janshort4all/peppa-box/plan/buchse_verdrahtung.jpg

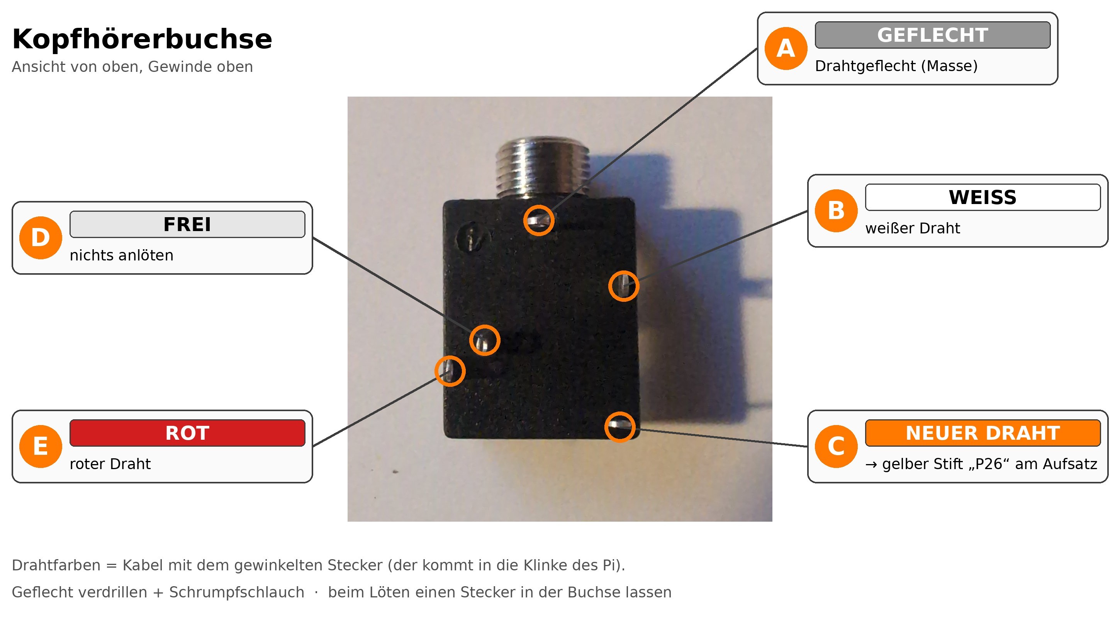
plan/buchse_verdrahtung.jpg
