janshort4all/peppa-box/v4/out/README.md

# Musikbox v4 – Druckpaket (Stand 09.11.2026)

**Noch nicht das Gehäuse drucken.** Einige Maße sind Platzhalter, bis deine Teile gemessen sind
(Liste in `PARAMETER.md`, Abschnitt „Vorläufig“). Jetzt sinnvoll: C7 (Lochbild) und die Probedruck-Coupons.

## Neu in diesem Stand: Boden = Elektronikträger

- Der Korpus ist unten offen. Nur die Lautsprecherkammer hat einen eigenen, festen Boden und bleibt dicht.
- Die Bodenplatte (`05_boden_traeger.stl`) trägt Akku-Stapel, Hebelklemmen GND A und 5 V sowie den Verstärker. Einen DAC gibt es nicht mehr: Die Kopfhörer hängen an der Klinke des Pi, ein kurzes Kabel mit gewinkeltem Stecker führt zur Buchse in der Wand.
- Du verdrahtest alles am Tisch und schiebst die Einheit dann von unten in den Korpus. Gehalten wird sie von 6 Senkschrauben.
- Ein Kragen auf der Platte zentriert sie in der Öffnung. Weil die Kammer vorne gerade ist und die Ecken hinten rund sind, passt sie nur richtig herum.
- Unter dem Deckel sitzt jetzt eine Verteiler-Brücke mit Touch-Modul und den Klemmen für 3,3 V, SCL und GND B. Die Kabel zu Touchfeldern, NFC-Leser und Taste werden dadurch kurz.
- Die Deckelauflage ist ringsum geschlossen, weil nichts mehr von oben eingesetzt werden muss.
- Die USB-C-Buchse (Soldered-Platine 333011) sitzt hinten rechts auf 60 mm Höhe (Buchsenmitte x 112). Platine mit Bauteilseite oben auf zwei Domen an der Rückwand, 2 Schrauben 3,0 mm von oben; die Wand hat eine Öffnung 13 × 7 mm für den Steckerkörper.

**Stapel einsetzen:** Überhang mit der BOOT-Taste nach links, Kante mit den gelben Stiften nach vorne (zum Lautsprecher),
Anschlusskante mit USB-C und Schalter nach hinten. Das Bild `boden_plan.png` zeigt es von oben.

## 1. Zuerst: Probedruck-Coupons

| Datei | Prüft | Was du mir zurückmeldest |
| --- | --- | --- |
| coupon_C16_gummiecke_wulst_0-4 / _0-5 / _0-6 | **Probe vor den Gummiecken (09.11.):** je eine vollständige Ecke (Form C, verschraubt) aus **TPU**, Rastwulst 0,4 / 0,5 / 0,6 mm (1 / 2 / 3 Löcher im Fuß), je ca. 4 g. Dazu eine Hülse `13_eckhuelse_PETG.stl` | Einstellungen wie die Ecken (Abschnitt „Gummiecken“). Box an die Tischkante stellen, Eckschraube vorne links heraus, Hülse von unten in den Fuß, Ecke aufdrücken: Klickt der Wulst unter die Fuge? Liegt der Schuh an der Rundung ringsum an, auch oben (kein Spalt)? Schraube 3,0 × 16 von Hand eindrehen, bis der Kopf in der Hülse anliegt: sitzt die Ecke fest, ohne dass das TPU gequetscht wird? Dasselbe an einer hinteren Ecke (V-Fuge statt Stufe). Passenden Wulst melden (`ECK_WULST`, Standard 0,5) – die passende Probe ist schon eine der vier Ecken |
| coupon_C14_gitter_ecke_beige + coupon_C14_buchstaben_P_e_p_orange | **Probe vor dem Gitter:** Ecke oben links einfarbig (Löcher, Rand, schräge Oberkante, ein Stift) mit den Sacklöchern für „P“, „e“, „p“, dazu diese drei Buchstaben, ca. 12 g | Mit den Gitter- bzw. Buchstaben-Einstellungen (Abschnitt „Gitter“). Fäden in den Löchern weg? Buchstaben-Stifte: leicht hinein, ohne zu wackeln? Buchstaben liegen plan auf? In die obere linke Ecke des Korpus drücken: Stift fest? |
| coupon_C15_karte_rastung_20grad / _30grad / _40grad | **Rastung der Karte (07.11.):** untere 60 mm der Karte mit Rille, Auszugsflanke 20° / 30° / 40° (1 / 2 / 3 Kerben oben), je ca. 8 g. Braucht das **neue** Kartenfach `04` (Nase 0,7 mm über der Karte) | Wie die Karte drucken (Rückseite unten). Einstecken: deutlicher Klick? Box kopfüber halten und schütteln: bleibt das Stück drin? Kann dein Sohn es ohne Mühe herausziehen? Den passenden Winkel Claude melden (`RAST_ALPHA`, Standard 30°), danach die Karten drucken |
| coupon_C12_deckel_oberseite_* (5 Dateien) | **Probe vor dem Deckel:** obere 2,4 mm vorne rechts (Play, Vor, Mond, Kante mit Fase), kopfüber, Symbole vertieft, ca. 15 g | Wie den Deckel einrichten: Variante A mit `_opfer_PLA`, Variante B mit `_MODIFIER_bruecke_richtung`, beide mit `_MODIFIER_haut_1wand`. Beige in den Kreisen so ruhig wie außen? Symbolböden eben bzw. Fäden parallel? |
| coupon_C7_lochbild_stapel | **Lochbild 58 × 49 mm des Akku-Stapels**, ca. 20 min | Stapel mit den vorhandenen Schrauben daraufsetzen: Fallen alle 4 Köpfe in die Mulden? Liegt die Acrylplatte innerhalb der Ecken-Marken? |
| coupon_C8_bodenecke_* (2 Teile) | Schattenfuge Boden/Korpus, Zentrierkragen, Senkschraube 3,0 × 12 in den Dom | Rutscht der Kragen leicht hinein, ohne zu wackeln? Sitzt die Schraube bündig? |
| coupon_C10_fuzzy_ecke (+ _MODIFIER) | Ecke hinten rechts mit Anschlussfeld-Kante und USB-C-Öffnung, ca. 30 min je Stück | Beide Dateien zusammen laden, Objekt Fuzzy „Deaktiviert“, Modifier „Kontur“; 3–4 Kopien mit verschiedenen Fuzzy-Werten: Welche wirkt hochwertig? Bleibt die Kante des Feldes sauber? |
| coupon_C11_korpus_oben (+ _MODIFIER) | **Probeabschnitt vor dem nächsten Korpus:** obere 36 mm mit voller Grundfläche (Riemenloch, Deckelschrauben, Kammerdecke), etwa ein Viertel der Korpus-Druckzeit | Genau wie den Korpus einrichten (Modifier, Naht aufmalen). Innen glatt? Außen keine Querlinie am Riemenloch? Naht eine gerade Linie an der aufgemalten Stelle? |
| coupon_C1_wand_rechts_drehgeber_klinke | Loch und Wandstärke für Drehgeber (M7) und Klinke | Passt das Gewinde, greift die Mutter? |
| coupon_C1_wand_hinten_usbc | Öffnung für den USB-C-Stecker, 2 Dome für die Soldered-Platine | Platine anschrauben: Buchse mittig hinter der Öffnung? Stecker rastet voll ein? |
| coupon_C2_deckelecke_* (3 Teile) | Deckelspalt 0,4 mm, Auflage, hintere Deckelschraube | Spalt gleichmäßig? Klappert es? |
| coupon_C3_taste_* (3 Teile) | Ein-Taste: Kappe, Halter, Kurzhubtaster | Klickt sie sauber, klemmt nichts? |
| coupon_C4_rahmenstifte_* | Gitter-Stift in Loch 4,0 / 4,1 / 4,2 (1–3 Kerben); der Korpus hat 4,1 | Welches Loch hält fest, lässt sich aber lösen? (C14 prüft den Stift direkt am Korpus) |
| coupon_C5_touch_platte | Touch durch 3,3 mm (links, mit Tasche) und 5,3 mm (rechts) | Später mit dem MPR121: reagieren beide? |
| coupon_C6_schraubdome | Kernloch 2,3 / 2,5 / 2,7 mm für 3-mm-Kunststoffschrauben | Welches Loch: Schraube geht fest, Dom reißt nicht? |

## 2. Druckteile (erst nach Messung und Coupons)

| Datei | Farbe | Ausrichtung / Hinweis |
| --- | --- | --- |
| 01_korpus_beige.stl | Beige | aufrecht, Boden auf der Platte; Naht hinten; Kammerdecke als 45°-Satteldach (keine Brücke) |
| 02a_deckel_kern_orange.stl | Orange | kopfüber (Oberseite auf der Platte, hinten bleibt hinten); mit 02b zusammen als ein Objekt mit zwei Teilen laden |
| 02b_deckel_haut_beige.stl | Beige | kopfüber, die 4 untersten Schichten ohne Symbole; Symbole und Ringe 0,8 mm vertieft (ertastbar) |
| 03_deckelrahmen.stl | Schwarz/Grau | Deckelseite auf der Platte |
| 04_kartenfach.stl | Schwarz/Grau | auf der Seite, Kartenschlitz senkrecht; Brim |
| 05_boden_traeger.stl | Beige | flach, Unterseite auf der Platte; trägt die ganze Elektronik; mit 05f (Fuzzy-Rand) als ein Objekt mit zwei Teilen laden |
| 06a_gitter_beige.stl | Beige | einfarbig; Vorderfläche auf der texturierten PEI, Oberkante nach hinten; Sacklöcher für die Buchstaben-Stifte |
| 06b_logo_buchstaben_orange.stl | Orange | alle 11 Logo-Teile auf einer Platte, Sichtseite auf der PEI, Stifte oben; nach dem Druck ins Gitter kleben |
| 07_drehknopf_orange.stl | Orange | Stirnfläche unten |
| 08_ein_taste_orange.stl | Orange | Kopf unten |
| 09_riemen_gegenplatte.stl | Schwarz/Grau | flach |
| 11_niederhalter_stiftleiste.stl | Schwarz/Grau | Dachoberseite mit den Schraubensenkungen auf der Platte, Säulen nach oben; Steg über der gelben Stiftleiste |
| 12_gummiecke_TPU_orange.stl | Orange, TPU 95A | eine Ecke, **4 × drucken** (alle gleich); Fußfläche auf der Platte, wie im Einbau. Einstellungen: Abschnitt „Gummiecken“ |
| 13_eckhuelse_PETG.stl | PETG (beliebig) | eine Hülse, **5 × drucken** (eine Reserve); Bund unten. Sitzt im Fuß der Gummiecke an der Eckschraube |
| 02_deckel_einfarbig.stl | eine Farbe | Prototyp, gleiche Form wie 02a + 02b; Symbole 0,8 mm vertieft |
| 10_karte_orange.stl | Orange | Rückseite unten (NFC-Tasche an der Platte), Einschubtasche oben; Cover auf Papier von oben einschieben. Rille vorne unten + Einführfase für die Rastung (seit 07.11.; ältere Karten ohne Rille neu drucken) |

Die Dateien liegen bereits in Druckausrichtung, auch der Deckel: `02a` und `02b` liegen seit 05.11. **kopfüber**
(Oberseite auf der Platte, hinten bleibt hinten). Das Tastenloch ist offen (keine Mulde, keine Opferschicht mehr).
`02a` und `02b` gemeinsam laden („als ein Objekt mit mehreren Teilen“), 02a Orange und 02b Beige zuweisen – dann macht
CANVAS genau einen Farbwechsel (Variante A: dazu PLA-Einleger `02p`, Variante B: Modifizierer `02r`), immer mit Modifizierer `02m`. Einstellungen: Abschnitt „Deckel“ unten. Die beiden `ansicht_…`-Dateien nur zum Anschauen.

Das Gitter `06a` ist einfarbig beige und liegt mit der Vorderfläche auf der Platte, die Oberkante zeigt nach hinten. Die orangen
Logo-Buchstaben `06b` sind ein eigener Druck (alle 11 Teile auf einer Platte) und werden danach aufgeklebt. Einstellungen: Abschnitt „Gitter“.

Der Boden darf auch orange sein: Dann läuft unten ein schmaler oranger Sockelstreifen um die Box.

## Einstellungen PETG auf der Centauri Carbon 2

Ausgangspunkt: Drucker „Elegoo Centauri Carbon 2 0.4 nozzle“, Filament „Elegoo PETG @ECC2“, Prozess „0.20mm Standard @Elegoo CC2 0.4 nozzle“,
Druckbetttyp „Texturierte PEI-Platte“. Im Prozess-Bereich die erweiterten Einstellungen einschalten. In Klammern: Profilwert vorher.

### Korpus (Stand 04.11.2026, Ziel höchste Außenqualität)

| Reiter → Gruppe | Einstellung | Wert |
| --- | --- | --- |
| Qualität → Schichthöhe | Schichthöhe / Höhe der ersten Schicht | 0,2 / 0,2 (bleibt) |
| Qualität → Naht | Nahtposition | Ausgerichtet (bleibt) + Naht aufmalen |
| | Schrägnaht (Beta) | Keine |
| | Naht Zwischenraum | 10 % (bleibt) |
| | Wischbewegung nach innen | an (aus) |
| Qualität → Präzision | Elefantenfußkompensation | 0,15 (0,1) |
| Qualität → Wandgenerator | Wandgenerator | Klassisch (bleibt) |
| Qualität → Wände und Oberflächen | Anordnung der Wände | Innen/Außen (bleibt) |
| Qualität → Brücken | Dicke externe Brücken | an (aus) – Lautsprecherausschnitt oben 28 mm |
| Struktur → Wände | Wandschleifen | 3 (2) |
| Struktur → Füllung | Fülldichte / Füllmuster | 15 % / Gyroid (Geradlinig) |
| Struktur → Obere/Untere Schichten | Muster der Oberfläche | **Konzentrisch** (Monotonische Linie) – die Deckelauflage innen bestand aus 3,2 m kurzer Linien: eine Schicht 158 s statt 60 s |
| Geschwindigkeit → erste Schicht | Erste Schicht | 30 mm/s (50) – Haftung |
| Geschwindigkeit → restliche Schichten | Außenwand / Innere Wand | 60 (160) / 120 (200) mm/s |
| Geschwindigkeit → Beschleunigung | Außenwand | 2000 (5000) mm/s² |
| Geschwindigkeit → Überhang-Geschwindigkeit | Verlangsamen bei Überhängen | **aus** (an) – sonst springt die Fuzzy-Außenwand zwischen 51 und 60 mm/s |
| Sonstiges → Umrandung | Randtyp / Randbreite / Lücke | Nur Innenrand / 8 mm / 0 |
| Sonstiges → Fuzzy Skin | Fuzzy Skin | Nur lackiert (Werte bleiben sichtbar; ohne Bemalung kein Fuzzy) |
| | Generierungsmodus / Rauschtyp | Verschiebung / Klassisch |
| | Punktabstand / Stärke | 0,30 / 0,20 |
| | Fuzzy Skin auf die erste Schicht anwenden | aus |
| Modifizierer `01f` → Sonstiges | Fuzzy Skin | **Kontur** |
| Filament → Kühlung | Lüftergeschwindigkeit (beide Zeilen) | 20 % / 20 % (10 / 40) – Kühlung unabhängig von der Schichtdauer |
| | Kühlung für Überhänge und Brücken erzwingen | an (bleibt) |
| | Überhänge und externe Brücken Lüftergeschwindigkeit | 50 % (90) |
| | Überhänge Kühlung Aktivierungsschwelle | **95 %** (10 % bei PETG/Rapid PETG) – sonst schaltet jeder nach außen springende Fuzzy-Punkt den Lüfter auf 50 % |
| Filament → Kühlung, Zeile „Minimale Lüftergeschwindigkeit“ | Schichtdauer | **100 s** (30) – muss über der Zeile darunter liegen; Lüfter bleibt bei 20 % |
| Filament → Kühlung, Zeile „Schwellenwert für die maximale Lüftergeschwindigkeit“ | Schichtdauer | **70 s** (12) – jede Schicht dauert mindestens 70 s, gleichmäßige Abkühlung |
| | Verlangsamen Sie den Druck für eine bessere Schichtkühlung | an (bleibt) |
| | Äußere Wände nicht verlangsamen | **an** (aus) – gebremst werden nur Innenwände und Füllung, die sichtbare Wand läuft immer mit 60 mm/s |
| Filament → Druckbett (Texturierte PEI) | Erste Schicht / Andere Schichten | 80 / 75 °C (70 / 70) – gegen Abheben |
| Drucker → Extruder | Z-Hub-Höhe | 0,4 (bleibt) |

Warum die Mindest-Schichtdauer: Sprünge in der Schichtdauer zeichnen sich bei PETG außen als Linie ab. Die harte Linie im ersten Druck
auf etwa 118 mm Druckhöhe kam von der flachen Kammerdecke (40-mm-Brücke, eine Schicht 5½ min statt 1 min). Die Decke ist jetzt ein
45°-Satteldach (innen, unsichtbar, kein Zusammenbau); die 70 s gleichen die restlichen kleinen Sprünge aus. Kostet rund 1 Stunde Druckzeit.
Bilder: `kammerdecke_satteldach.png`, `kammerdecke_schichtzeit.png`.

Naht aufmalen: ganzes Objekt markieren, Werkzeug „Naht aufmalen“, Pinselgröße 0,5 (schmaler Strich = Naht streut weniger), „Vertikal“ an; Menü Ansicht → Hinten;
senkrechten Strich auf der Rundung rechts neben den Lüftungsschlitzen (Mitte zwischen Ende des glatten Feldes und Außenkante)
von ganz unten bis ganz oben ziehen. Bild: `naht_aufmalen.png`.

Deckel, Rahmen, Kartenfach, Knopf: ohne Fuzzy Skin. Boden: Fuzzy nur am Rand, eigener Abschnitt unten. Brim für Kartenfach und die C1-Coupons. Deckel: eigener Abschnitt unten.
Rolle vorher trocknen (Elegoo: 60 °C, 8 h).

### Boden (Stand 06.11.2026, sichtbarer Rand wie der Korpus)

Der Boden steht bündig unter dem Korpus, sein Rand ist von außen sichtbar. Deshalb **alle Einstellungen wie beim Korpus** und dieselbe beige Rolle.
Am einfachsten: das Korpus-Projekt (.3mf) öffnen, „Speichern unter“ als Boden-Projekt, Korpus und `01f` löschen, dann
`05_boden_traeger.stl` und `05f_modifier_boden_FUZZY_rand.stl` zusammen hineinziehen (ein Objekt mit zwei Teilen, `05f` → Typ Modifizierer, Fuzzy Skin **Kontur**).

| Abweichung vom Korpus | Wert | Grund |
| --- | --- | --- |
| Lage | Unterseite auf der Platte, nicht drehen | Standkante (0,8-Fase) unten, V-Fuge oben |
| Sonstiges → Umrandung | **keine** | „Nur Innenrand“ würde nur die Schraublöcher zufüllen; die volle Fläche haftet ohne Rand |
| Naht | aufmalen an derselben Rundung wie am Korpus (Pinselgröße 0,5, Vertikal) | Nähte von Korpus und Boden liegen übereinander |
| Stützen | aus | Überhang nur an den Decken der M2,5-Senkungen (102 mm², kurze Brücken) |

Fuzzy liegt nur auf dem senkrechten Streifen 0,8–3,2 mm; Fase unten und Fase oben (V-Fuge) bleiben glatt, genau wie die Fase unten am Korpus.
Vorschau prüfen: Schichten 5–16 außen körnig, Schicht 1–4 und ab 17 glatt.
Nach dem Druck: Senkungen der 6 Bodenschrauben auf Grat prüfen, Kopf muss bündig liegen.

### Deckel (Stand 05.11.2026 spät, kopfüber, Symbole 0,8 mm vertieft und ertastbar, ohne Fuzzy)

Die Oberseite entsteht auf der texturierten PEI-Platte. Beige sind die 4 untersten Schichten (0,8 mm), ab Schicht 5 Orange.
Befund Druck 05.11. (Bild `deckel_ursache.png`): Fläche außerhalb der Kreise sehr gut. In den Kreisen: Der Slicer hat die
Vertiefungen in Schicht 5 überbrückt und die Brücke auf den ganzen Kreis ausgedehnt (1760 mm² Brücke für 597 mm² Vertiefung).
Hinter 0,8 mm Beige lagen dort runde Brückenfäden mit Lücken statt dichter Füllung → Orange scheint wie Fäden durch; dazu 3 Wandringe
je Loch in Schicht 2–4, Punktreihen (Überlappung 5 %), Nahtpunkte und Härchen an den Lochkanten. Die 0,8 mm Beige selbst sind nicht
zu dünn: Außerhalb der Kreise ist es dieselbe Haut, dort liegt dahinter dichte Füllung.

**Variante A (empfohlen): PLA-Opfer-Einleger.** `02p` füllt die Vertiefungen in Schicht 1–4 mit PLA. Die erste orange Schicht
wird darauf als normale dichte Füllung gedruckt – keine Brücke, keine Fäden, Böden eben und in allen Symbolen in derselben Richtung.
PETG haftet nicht an PLA: Einleger nach dem Druck mit einer Nadel heraushebeln (zusammen ca. 0,6 g). Dafür eine PLA-Rolle in
einen freien CANVAS-Platz (am besten Orange, dann fallen Reste nicht auf).

**Variante B (ohne PLA): Fäden als Stilmittel, alle in eine Richtung.** `02r` ist ein Modifizierer nur für Schicht 5 über den
Vertiefungen (+0,4 mm). Dort „Externe Brücken Füllrichtung“ fest; die Brücke bleibt auf die Symbole begrenzt, dahinter dichte Füllung.

Ausgangspunkt sind die Korpus-Einstellungen (Profil „… - Peppa“); als eigenen Prozess speichern. In Klammern: Wert beim Korpus.

| Reiter → Gruppe | Einstellung | Wert |
| --- | --- | --- |
| Objektliste | Teile laden („ein Objekt mit mehreren Teilen“) | A: `02a`, `02b`, `02p`, `02m` · B: `02a`, `02b`, `02r`, `02m` |
| | Filamente | 02a → Orange, 02b → Beige, 02p → PLA (Rechtsklick → Filament wechseln); 02m und 02r → Typ ändern → **Modifizierer**, danach Rechtsklick → Filament wechseln → **Standard** (sonst färbt der Modifizierer seinen Bereich mit Filament 1 ein – Probe 05.11.: Haut weiß, Wände über den Symbolen) |
| Modifizierer `02m` | Wandschleifen | **1** – in den Haut-Schichten nur eine Wand um jedes Loch (keine Ringe hinter der Sichtfläche) |
| Modifizierer `02r` (nur B) | Struktur → Erweiterte Einstellungen → Externe Brücken Füllrichtung | **45°** (0 = automatisch) – Fäden in allen Symbolen parallel zu den Linien der Oberfläche, längste Brücke 10,8 mm |
| Qualität → Brücken (nur B) | Dicke externe Brücken / Externe Brücken Dichte | **aus** (an) / **110 %** (100) – flache, dicht liegende Fäden |
| Geschwindigkeit → Überhanggeschwindigkeit → Überbrückung (nur B) | Extern | **30 mm/s** (50) – C12 05.11.: ein Faden im Play-Dreieck aus der Reihe |
| Filament Orange → Kühlung (nur B) | Überhänge und externe Brücken Lüftergeschwindigkeit | **100 %** (50) – Fäden erstarren sofort gerade; als eigenes Filamentprofil speichern und nur dem orangen Platz zuweisen |
| Qualität → Schichthöhe | Schichthöhe / erste Schicht | 0,2 / 0,2 (bleibt) |
| Qualität → Naht | Nahtposition | **Rückseite** (Ausgerichtet + aufgemalt) |
| Qualität → Präzision | Elefantenfußkompensation | 0,15 (bleibt) |
| Qualität → Wandgenerator | Wandgenerator | **Arachne** (Klassisch) – Ringe 1,1 mm und schmale Stege ohne Lückenfüllung |
| Qualität → Wände und Oberflächen | Nur eine Wand in der ersten Schicht / Vermeiden von Wandüberquerungen | an / an |
| Struktur → Obere/Untere Schichten | Untere Schalenschichten | **8** (3) |
| | Überlappung des oberen/unteren massiven Füllung/Wand | **25 %** (5 %) – gegen die Punktreihen |
| | Muster der unteren Fläche | Monotonisch (bleibt) |
| Struktur → Füllung | Fülldichte / Füllmuster | **25 %** / Gyroid (15 %) |
| Geschwindigkeit → erste Schicht | Füllung | **50 mm/s** (105) |
| Sonstiges → Umrandung | Randtyp | **Keine Umrandung** (Nur Innenrand) |
| Sonstiges → Fuzzy Skin | Fuzzy Skin | Deaktiviert |
| Multimaterial → Reinigungsturm | Aktivieren | an |
| Reinigungsvolumen | Multiplikator | **1,5** (1) |
| Drucker/Platte (nur A) | Betttemperaturtyp | **Nach der höchsten Temperatur** – Bett bleibt bei den PETG-Werten 80/75 °C |
| Filament PLA (nur A) | Düse | 230 °C; Einstellungen → Steuerung → Slicen: „Entfernen der Einschränkung für gemischte Temperaturen“ an (sonst lässt der Slicer PLA und PETG nicht zusammen zu) |
| Filament Beige/Orange | | wie beim Korpus (250 °C, Bett 80/75 °C, Lüfter 20 %, Schichtdauer 70/100) |

Vorher: Platte mit Spülmittel waschen, nicht mehr anfassen. Variante A: Haube oben offen lassen (PLA mag die warme Kammer nicht,
der flache Deckel verzieht sich nicht). Nach dem Druck auf der Platte abkühlen lassen, PLA-Einleger heraushebeln (bleiben sie auf
der Platte, dort abnehmen). Vorschau: Schicht 1–4 Beige + Einleger (A); Schicht 5 über den Symbolen keine „Überbrückung“ (A)
bzw. nur über den Symbolen, alle Linien parallel (B). Zuerst `coupon_C12_deckel_oberseite_*` mit derselben Variante.
`08_ein_taste_orange.stl` (Kopf unten, keine Umrandung) bekommt dieselbe Oberfläche, wenn der Kopf auf der texturierten PEI liegt –
am besten zusammen mit dem Drehknopf `07` drucken (beide Orange): Auf der Deckel-Platte müsste CANVAS in Schicht 1–4 jedes Mal
zwischen Beige und Orange wechseln. Bild: `deckel_draufsicht.png`.

### Gitter (Stand 06.11.2026: einfarbig, Buchstaben erhaben und aufgeklebt, ohne Fuzzy)

Befund C13 (06.11., eingelegtes Logo, zweifarbig): sehr viele Fäden in den Löchern, Fehler im Orange nach den Farbwechseln,
ein verbrannter dunkler Fleck hinten. Deshalb ohne Farbwechsel: **Gitter einfarbig beige**, die **Buchstaben als eigene orange
Teile**, 1,2 mm dick, aufgeklebt – sie stehen 1,0 mm vor der Korpusfront (3D-Effekt). Beide Sichtflächen entstehen auf der
texturierten PEI-Platte (matt wie der Deckel). Jeder Buchstabe hat hinten 2 Stifte Ø 2,0 (die drei Strahlen je einen Stift in
ihrer Form) und passt nur in seine Sacklöcher im Gitter. Bild: `gitter_ansicht.png` (`v4/gitter/render_gitter.py`).

`06a_gitter_beige.stl`: 115,4 × 115,7 mm, 3,6 mm dick (über dem Lautsprecher 2,4 mm, dahinter 2,5 mm Luft), 6 Stifte Ø 3,9, ca. 36 g.
`06b_logo_buchstaben_orange.stl`: 11 Teile in Logo-Reihenfolge auseinandergezogen (mindestens 4 mm Abstand), Sichtseite unten, ca. 4 g.

**Gegen die Fäden (Befund C13):** Rolle trocknen (Elegoo: 60 °C, 8 h) – wichtigste Maßnahme. Düse heiß reinigen, Silikonwischer
hinten von PETG-Resten befreien (sonst nimmt die Düse sie wieder auf und sie verbrennen). Platte mit Spülmittel waschen, nicht anfassen.
Für das Gitter einen eigenen Prozess und ein eigenes Filamentprofil anlegen und alle Werte aus der Tabelle unten eintragen.

**Gitter `06a` – alle Abweichungen von den Elegoo-Standardprofilen** (Drucker „Elegoo Centauri Carbon 2 0.4 nozzle“, Prozess
„0.20mm Standard @Elegoo CC2 0.4 nozzle“, Filament „Elegoo PETG @ECC2“, Druckbetttyp „Texturierte PEI-Platte“; erweiterte
Einstellungen einschalten). In Klammern der Profilwert, wo er bekannt ist. Prozess und Filament unter eigenem Namen speichern.

| Reiter | Einstellung | Wert |
| --- | --- | --- |
| Prozess → Qualität | Nahtposition | **Rückseite** (Ausgerichtet) |
| | Schrägnaht (Beta) | **Keine** |
| | Wischbewegung nach innen | **an** (aus) |
| Prozess → Qualität → Breite der Linie | Erste Schicht | **0,45** (0,5) – seit 07.11.: sonst sind die Stege in Schicht 1 für „Wandüberquerungen vermeiden“ zu schmal |
| Prozess → Qualität | Elefantenfußkompensation | **0** (0,1) – seit 07.11. (vorher 0,15): die Kompensation weitet die Löcher in Schicht 1, dann fährt der Slicer dort wieder quer durch |
| | Wandgenerator | **Arachne** (Klassisch) |
| | Nur eine Wand in der ersten Schicht | **aus** (Profilwert) – seit 07.11.: bei an füllt der Slicer den Streifen zwischen den Lochringen (Steg 1,4) mit vielen kurzen Bodenlinien, also noch mehr Anfänge und Rückzüge in Schicht 1 |
| | Vermeiden von Wandüberquerungen | **an** |
| | Vermeide das Überqueren der Wand – Maximale Umleitungslänge | **0** (keine Grenze) |
| Prozess → Struktur | Wandschleifen | **3** (2) |
| | Untere Schalenschichten | **8** (3) |
| | Überlappung des oberen/unteren massiven Füllung/Wand | **25 %** (5 %) |
| | Muster der Oberfläche | **Konzentrisch** (Monotonische Linie) |
| | Fülldichte / Füllmuster | **25 % / Gyroid** (15 % / Geradlinig) |
| Prozess → Geschwindigkeit | Erste Schicht / Füllung der ersten Schicht | **30 / 50 mm/s** (50 / 105) |
| | Außenwand / Innere Wand | **40 / 120 mm/s** (160 / 200) |
| | Beschleunigung Außenwand | **2000 mm/s²** (5000) |
| | Verlangsamen bei Überhängen | **aus** (an) |
| Prozess → Sonstiges | Randtyp | **Keine Umrandung** |
| | Fuzzy Skin | **Deaktiviert** |
| Filament | Düsentemperatur erste Schicht / andere Schichten | **235 / 230 °C** (250 / 250) – seit 07.11. (vorher 245 / 240): Rapid PETG ab 230 °C, weniger Nachtropfen in den Löchern |
| | Druckbett Texturierte PEI erste / andere Schichten | **80 / 75 °C** (70 / 70) |
| Filament → Kühlung | Lüftergeschwindigkeit (beide Zeilen) | **35 % / 35 %** (10 / 40) |
| | Zeile „Minimale Lüftergeschwindigkeit“ → Schichtdauer | **100 s** (30) |
| | Zeile „Schwellenwert für die maximale Lüftergeschwindigkeit“ → Schichtdauer | **70 s** (12) |
| | Äußere Wände nicht verlangsamen | **an** (aus) |
| | Keine Kühlung für die erste | **3** Schichten |
| | Überhänge und externe Brücken Lüftergeschwindigkeit | **50 %** (90) |
| | Überhänge Kühlung Aktivierungsschwelle | **95 %** (10 %) |
| Filament → Überschreiben der Einstellungen (Häkchen je Zeile setzen) | Länge (Rückzug) | **1,0 mm** |
| | Rückzugsgeschwindigkeit / Wiedereinzugsgeschwindigkeit | **40 / 30 mm/s** |
| | Zurückziehen beim Schichtwechsel | **an** |
| | Während des Rückzugs wischen / Wischabstand | **an / 2 mm** |
| | Rückzugsmenge vor der Reinigung | **70 %** |
| | Schwellenwert für die Fahrstrecke | **0,5 mm** |
| | Z-Hub-Höhe | **0** (0,4) – seit 07.11. (vorher 0,2 Normal): Anheben zieht bei PETG Fäden; die Fahrten laufen über gedrucktem Material (Wandüberquerungen vermeiden) |

Platte: `06a` allein, mittig, nicht drehen (Vorderfläche unten, Oberkante hinten), nur Filament Beige, keine Modifizierer.

**Buchstaben `06b` – alle Abweichungen von den Elegoo-Standardprofilen** (gleiche Ausgangsprofile wie beim Gitter; Filament: die
orange Rolle). Schichthöhe bleibt 0,2: Die Buchstaben sind genau 6 Schichten dick, die Stifte 5 Schichten, und weniger Schichten
heißen weniger Fahrten zwischen den 11 Teilen (Fäden an den Buchstabenkanten).

| Reiter | Einstellung | Wert |
| --- | --- | --- |
| Prozess → Qualität | Schichthöhe / erste Schicht | 0,2 / 0,2 (Profilwert, bleibt) |
| | Nahtposition | **Rückseite** (Ausgerichtet) – die im Einbau untere Kante jedes Buchstabens liegt hinten |
| | Schrägnaht (Beta) | **Keine** |
| | Wischbewegung nach innen | **an** (aus) |
| | Elefantenfußkompensation | **0,15** (0,1) – scharfe Kante an der Sichtseite |
| | Wandgenerator | **Arachne** (Klassisch) – schmale Stellen (e-Schlitz, Strahlen) sauber |
| | Nur eine Wand in der ersten Schicht | **an** – Sichtseite wie Deckel und Gitter |
| | Vermeiden von Wandüberquerungen / Maximale Umleitungslänge | **an / 0** |
| Prozess → Struktur | Wandschleifen | **3** (2) |
| | Untere Schalenschichten | **8** (3) – Buchstabe durchgehend massiv |
| | Überlappung des oberen/unteren massiven Füllung/Wand | **25 %** (5 %) |
| | Muster der unteren Fläche | Monotonisch (Profilwert, bleibt) – gleiche Linien wie auf dem Gitter |
| | Fülldichte | **100 %** (15 %) – dünne Teile ganz massiv |
| Prozess → Geschwindigkeit | Erste Schicht / Füllung der ersten Schicht | **30 / 50 mm/s** (50 / 105) |
| | Außenwand / Innere Wand | **40 / 120 mm/s** (160 / 200) |
| | Beschleunigung Außenwand | **2000 mm/s²** (5000) |
| | Verlangsamen bei Überhängen | **aus** (an) |
| Prozess → Sonstiges | Randtyp | **Keine Umrandung** – ein Rand säße an der Sichtkante |
| | Fuzzy Skin | **Deaktiviert** |
| Filament | Düsentemperatur erste / andere Schichten | **245 / 240 °C** (250 / 250) |
| | Druckbett Texturierte PEI erste / andere Schichten | **80 / 75 °C** (70 / 70) |
| Filament → Kühlung | Lüftergeschwindigkeit (beide Zeilen) | **35 % / 35 %** (10 / 40) |
| | Zeile „Minimale Lüftergeschwindigkeit“ → Schichtdauer | **100 s** (30) |
| | Zeile „Schwellenwert für die maximale Lüftergeschwindigkeit“ → Schichtdauer | **70 s** (12) |
| | Äußere Wände nicht verlangsamen | **an** (aus) |
| | Keine Kühlung für die erste | **3** Schichten |
| | Überhänge Kühlung Aktivierungsschwelle | **95 %** (10 %) |
| Filament → Überschreiben der Einstellungen (Häkchen je Zeile) | Länge (Rückzug) | **1,0 mm** |
| | Rückzugsgeschwindigkeit / Wiedereinzugsgeschwindigkeit | **40 / 30 mm/s** |
| | Zurückziehen beim Schichtwechsel | **an** |
| | Während des Rückzugs wischen / Wischabstand | **an / 2 mm** |
| | Rückzugsmenge vor der Reinigung | **70 %** |
| | Schwellenwert für die Fahrstrecke | **0,5 mm** |
| | Z-Hub-Höhe / Z-Hub Typ | **0,2 mm / Normal** (0,4) |

Platte: `06b` allein, mittig, nicht drehen (Sichtseite unten, Stifte oben, „BOX“ hinten), nur Orange, keine Modifizierer.
Vorher Düse heiß reinigen, Wischer prüfen, Platte waschen. Die orange Rolle ist neu – frisch aus der Verpackung meist trocken genug;
lag sie offen, auch trocknen.

**Einkleben:** Zuerst trocken probieren: Jeder Buchstabe muss mit leichtem Druck plan aufliegen. Geht ein Stift zu stramm, das
Loch mit einem 2,5-mm-Bohrer von Hand nachdrehen; ist er locker, füllt der Kleber das Spiel. Dann je einen kleinen Tropfen
**nur in die Sacklöcher** (nicht auf die Fläche), Buchstaben eindrücken, Gitter mit der Vorderseite nach oben aushärten lassen.
Am besten 5-Minuten-Epoxid (Zeit zum Ausrichten, kein Schleier); Sekundenkleber hält auch, kann aber um die Fuge einen weißen
Schleier bilden. Reihenfolge: wie auf der Druckplatte, oben „peppa“ und die Strahlen, unten „BOX“.
Einsetzen ins Gehäuse: 6 Stifte in die Löcher, gleichmäßig eindrücken. Herausnehmen: Schraubendreher unten in die Kerbe.

### Drehknopf (Stand 05.11.2026, volle Achse, ohne Fuzzy)

`07_drehknopf_orange.stl`: Ø 34 × 22,8 mm, ca. 24 g. Die Drehgeberachse wird **nicht** gekürzt. Stirnfläche unten auf der
texturierten PEI-Platte → dieselbe matte Oberfläche wie die Tasten im Deckel; dieselbe orange Rolle wie beim Deckel.
Innen: Führung Ø 6,3 im ungeschlitzten Teil der Achse, Klemmsitz Ø 6,1 nur im geschlitzten Teil (federt), Steg 8 mm im Schlitz.
Bild: `drehknopf_schnitt.png`. Die Ein-Taste `08` passt mit auf die Platte (gleiche Einstellungen).

| Reiter | Einstellung | Wert |
| --- | --- | --- |
| Qualität | Schichthöhe | **0,12 mm** (erste Schicht 0,2) – feinere Schichtlinien auf dem Mantel |
| Qualität | Nahtposition | Ausgerichtet + **Naht aufmalen** in eine Rille **links (−X)**, gegenüber der Markierung (liegt beim Laden rechts, +X); Schrägnaht keine |
| Festigkeit | Wandschleifen / Füllung | 3 / 25 % Gyroid |
| Sonstiges | Fuzzy Skin | **Keine** – Griff geben die 24 Rillen; Fuzzy würde ihre Kanten verwischen |
| Sonstiges | Randtyp | Keine Umrandung |
| Filament | | wie beim Deckel; die Mindest-Schichtdauer bremst bei dem kleinen Teil Innenwände und Füllung – gewollt, die Rillenkanten kühlen besser |

Aufstecken: Steg in den Achsschlitz ausrichten, Knopf gerade **bis Anschlag** aufschieben (Achsende liegt am Knopfboden) –
dann bleibt 1 mm Luft zur Wand. Die Markierung ist nur Zierde: Der Drehgeber dreht endlos, sie zeigt keine Lautstärke an.

### Gummiecken mit Füßen (Stand 09.11.2026: vier einzelne Ecken, verschraubt, Form C 20/8 mm)

Vier gleiche Ecken aus orangem TPU (`12_gummiecke_TPU_orange.stl`, 4 ×) und vier Hülsen aus PETG (`13_eckhuelse_PETG.stl`, 5 ×, eine Reserve).
Jede Ecke hängt an der Eckschraube des Bodens: Statt der Senkschraube 3,0 × 12 kommt eine **3,0 × 16** durch die Hülse. Die Schraube drückt
nur auf Hartes (Kopf → Hülse → Boden → Dom), der Boden sitzt so fest wie bisher; das TPU sitzt auf dem 45°-Kegel der Hülse, ist also
gefangen, aber nicht gepresst. Der Rastwulst hakt unter die Fuge Boden/Korpus (vorne Stufe, sonst V-Fuge) und hält die Schenkelenden an
der Box. Hülse und Schraubenkopf enden 0,5 mm über der Standfläche – die Box steht nur auf Gummi. Bilder: `gummiecken_ansicht.png`,
`gummiecken_schnitt.png`, `gummiecken_varianten.png`. Zuerst Coupon C16.

**Drucker (TPU):** nicht über den normalen CANVAS-Weg laden. Elegoo: Adapter für flexibles Filament einsetzen (Datei und Anleitung auf dem
USB-Stick bzw. bei Nexprint „Flexible Filament Printing Adapter for Centauri Carbon 2 Combo“) und vor dem Druck das CANVAS-Kabel abziehen.
Rolle vorher trocknen, TINMORRY: 70 °C, 8 h (TPU zieht Wasser; feuchtes TPU zieht Fäden und blüht auf).

Ausgangspunkt Ecken: Drucker „Elegoo Centauri Carbon 2 0.4 nozzle“, Filament „Elegoo TPU 95A @ECC2“, Prozess „0.20mm Standard @Elegoo CC2 0.4 nozzle“,
Druckbetttyp „Texturierte PEI-Platte“. In Klammern: Profilwert vorher.

| Reiter → Gruppe | Einstellung | Wert |
| --- | --- | --- |
| Platte | Datei laden, nicht drehen, **4 Kopien** (Rechtsklick → Anzahl festlegen) | Fußfläche auf der Platte, Schuh oben offen; keine Stützen nötig (Wulst und Hülsenkegel 45°, Rundungen weichen zurück) |
| Qualität → Schichthöhe | Schichthöhe / Höhe der ersten Schicht | 0,2 / 0,2 (bleibt) |
| Qualität → Naht | Nahtposition | Ausgerichtet (bleibt) + **Naht aufmalen** (Pinselgröße 0,5, Vertikal) auf der **Innenseite** des Schuhs (Fläche zur Box), Mitte der Rundung – dort unsichtbar; gilt für alle Kopien |
| | Schrägnaht | Keine (bleibt) |
| Qualität → Präzision | Elefantenfußkompensation | 0,15 (0,1) – Fase unten bleibt sauber |
| Qualität → Wandgenerator | Wandgenerator | **Arachne** (Klassisch) – die 2,4-mm-Wand wird ganz aus Wandlinien gedruckt, ohne Lücken |
| Qualität → Wände und Oberflächen | Vermeiden von Wandüberquerungen | an (aus) – weniger Fahrten über die Sichtfläche, weniger Fäden |
| Struktur → Wände | Wandschleifen | 3 (2) |
| Struktur → Obere/Untere Schichten | Obere / untere Schalenschichten | 3 (5) / 3 (bleibt) – Füße innen weich |
| Struktur → Füllung | Fülldichte / Füllmuster | 15 % (bleibt) / **Gyroid** (Geradlinig) – die Füße federn in alle Richtungen |
| Geschwindigkeit → erste Schicht | Erste Schicht / Füllung erste Schicht | 15 (50) / 15 (105) mm/s |
| Geschwindigkeit → restliche Schichten | Außenwand / Innere Wand | 25 (160) / 35 (200) mm/s; alles andere begrenzt der maximale Volumenstrom des Filamentprofils (3,2 mm³/s ≈ 38 mm/s) |
| Unterstützung | Stützen | aus (bleibt) |
| Sonstiges → Umrandung | Randtyp | **Keine Umrandung** (Automatisch) – die Füße haften flächig |
| Sonstiges → Fuzzy Skin | Fuzzy Skin | Keine (bleibt) – glattes Orange neben dem körnigen Beige |
| Filament (Elegoo TPU 95A @ECC2) | Düse / Druckbett / Lüfter / Rückzug | 225 °C / 35 °C / 100 % ab Schicht 2 / 0,4 mm (alles Profilwerte, bleiben). Liegt innerhalb der Herstellerangabe deiner Rolle (TINMORRY TPU 95A: Düse 210–240 °C, Druckbett 30–50 °C, unter 60 mm/s) |
| Drucker → Extruder | Z-Hub-Höhe | 0,4 (bleibt) |

Je Ecke ca. 4 g TPU, Druckmaß 28 × 28 × 23 mm. Nach dem Druck abkühlen lassen und die Platte biegen; TPU haftet fest.

**Hülsen (PETG, 5 ×):** Drucker „Elegoo Centauri Carbon 2 0.4 nozzle“, Filament „Elegoo Rapid PETG @ECC2“ (bzw. das Standardprofil deiner Rolle,
**nicht** das „- Peppa“-Profil: dessen Mindest-Schichtdauer 70 s würde die winzigen Teile auf Kriechtempo bremsen), Prozess „0.20mm Standard @Elegoo CC2 0.4 nozzle“,
texturierte PEI-Platte. Abweichungen: **5 Kopien** auf einer Platte (Abstand ≥ 10 mm), Wandschleifen **4** (2), Fülldichte **100 %** (15 %), Elefantenfußkompensation 0,15 (0,1),
Randtyp **Keine Umrandung** (Automatisch), Stützen aus (bleibt). Lage wie geladen: breiter Bund unten (Kopfseite), die Senkung ist dann ein 45°-Überhang.
Farbe egal (man sieht nur die Unterseite im Fuß), am besten Orange. Ca. 0,2 g je Hülse.

**Montage, je Ecke (Box steht, Ecke ragt über die Tischkante):** (1) Eckschraube 3,0 × 12 herausdrehen – die anderen 5 Schrauben halten den
Boden. (2) Hülse von unten in den Fuß der Ecke stecken, Bund nach unten. (3) Ecke von unten auf die Box drücken, bis der Wulst einrastet.
(4) Senkschraube **3,0 × 16** von Hand durch die Hülse eindrehen, bis der Kopf in der Senkung der Hülse anliegt, dann nur noch leicht
anziehen (das alte Gewinde im Dom wird weiterverwendet; 9,5 mm Einschraubtiefe statt 8). Zum Öffnen des Bodens die Schrauben wie bisher
herausdrehen; die Ecken kommen dabei mit ab.

### Fuzzy Skin nur außen (Modifier „Außenhaut“, seit 04.11.2026)

Warum: Jedes Loch durch die Wand (Klinke, Drehgeber, USB-C, Schlitze, Riemen, Deckelschrauben, Lautsprecher) schneidet den
Wandring in diesen Schichten auf. Der Slicer zählt dann die ganze Innenseite zur „Kontur“ und verfuzzt sie mit. Der neue Modifier
ist eine 1 mm dünne Haut nur an den Außenflächen – Fuzzy entsteht ausschließlich dort.

1. `01_korpus_beige.stl` und `01f_modifier_korpus_FUZZY_aussenhaut.stl` **zusammen** markieren und in den Slicer ziehen.
2. Die Frage „als ein Objekt mit mehreren Teilen laden?“ mit **Ja** beantworten – beide Teile behalten dann ihre exakte Lage.
3. In der Objektliste den Teil `01f_…` rechts anklicken → **Typ ändern → Modifizierer**.
4. Prozess (global): Fuzzy Skin = **Nur lackiert**, Stärke 0,20, Punktabstand 0,30, Klassisch. Modifizierer in der Objektliste anklicken → Reiter Sonstiges → Fuzzy Skin = **Kontur**.
5. Vorschau prüfen (Linientyp-Ansicht, Schieberegler durch die Höhe): innen überall glatt, auch auf Höhe der Löcher;
   außen körnig; Anschlussfeld, Gitter-Sitz, Loch-Flächen und die beiden Fasen (unten, oben) glatt.
6. Der alte Modifier `01m_…OHNE_fuzzy` ist entfernt und darf nicht mehr verwendet werden.

## Module befestigen

Alle Module und Klemmen liegen in Mulden mit 2,5 mm Rand. Ein Streifen doppelseitiges Montageband oder ein Tropfen Heißkleber reicht.
Unter dem Deckel hängen sie kopfüber; dort am besten Montageband nehmen.

## Kartenfach und Karte: Rastung (Stand 07.11.2026)

Die Federzunge vorne im Kartenfach hat eine Nase, die 0,7 mm über die Kartenvorderseite ragt. Die Karte hat vorne unten eine passende Rille
(0,9 mm tief) und unten eine Einführfase. Beim Einstecken schiebt die Fase die Nase weg, die Nase gleitet über die Karte und springt in die
Rille (Klick). Steht die Karte auf dem Fachboden, liegt die Nase **entspannt** in der Rille (die Zunge kriecht nicht). Zum Herausziehen muss
die Nase die Auszugsflanke der Rille hinauf; deren Winkel bestimmt die Kraft (Schätzung 30°: ca. 3–4,5 N, ein Vielfaches des Kartengewichts,
für ein Kind leicht). Schnittbild: `rastung_schnitt.png`. Vorher hatte die Nase genau 0 mm Überdeckung, die Karte hielt nur durch Reibung.

Warum das Kartenfach hochkant (88,5 mm hoch, Seitenteil auf der Platte) liegt: Der Kartenschacht wird ein senkrechter Schlitz ohne
Stützen (flach liegend wäre seine Decke 71 × 42 mm frei in der Luft), die Schienen für den RC522 drucken ohne Stütze, und die Federzunge
liegt in der Schichtebene. Sie biegt sich entlang der Bahnen statt quer zu den Schichten und bricht so nicht an einer Schichtgrenze.
Die Nase hat 45°-Enden (kein waagerechter Überhang).

**Ohne Stützen, Brücken nur kurz und beidseitig gehalten:** Schachtende 4,8 mm, Schlitz über der Zunge 20 mm, Zungen-Unterseite ca. 17 mm.
Die Zungen-Unterseite hing bis 07.11. frei (nur an der Wurzel gehalten; ElegooSlicer meldete „schwebende Überhänge“). Jetzt trägt ein
**Steg unter der Zungenspitze** (1,4 mm, im unteren Schlitz). **Nach dem Druck den Steg mit dem Cutter durchtrennen** (Klinge von außen in
den 0,8-mm-Schlitz unter der Zungenspitze), dann muss die Zunge frei federn. Die Bögen der waagerecht liegenden Schraubenbohrungen
drucken wie normale Löcher.

**Schrauben (07.11.):** Die beiden Bohrungen Ø 6,8 gehen jetzt bis ganz unten durch (vorher blieb unten ein Stück des Seitenteils
im Weg). Der Schraubendreher kommt gerade von unten an den Kopf, der Weg ist etwa 43 mm lang: Schaft mindestens ca. 5 cm frei und
dünner als 6 mm, die meisten Bithalter sind zu dick. Erst Kartenfach verschrauben, dann den RC522 einschieben.

### Kartenfach + C15 auf einer Platte (Stand 07.11.2026)

Alles aus **derselben Rolle** (die Farbe der Teststücke ist egal). Unterschiedliche Rollen auf einer Platte bedeuten einen Filamentwechsel
in jeder Schicht der unteren 4 mm (20 Wechsel mit Spülmenge). Kartenfach in die Mitte, die drei C15-Stücke daneben, mindestens 10 mm Abstand.

Ausgangspunkt: Drucker „Elegoo Centauri Carbon 2 0.4 nozzle“, Prozess „0.20mm Standard @Elegoo CC2 0.4 nozzle“, Druckbetttyp
„Texturierte PEI-Platte“, Filament: das **System**profil der eingelegten Rolle (bei Jan „Elegoo Rapid PETG …“), nicht die für den Korpus
geänderte Kopie. In Klammern: Profilwert vorher. Alles andere bleibt auf dem Profilwert.

| Reiter → Gruppe | Einstellung | Wert |
| --- | --- | --- |
| Qualität → Schichthöhe | Schichthöhe / erste Schicht | 0,2 / 0,2 (bleibt) – die Karten später ebenfalls mit 0,2 drucken, sonst ist die Rille anders gestuft als im Test |
| Qualität → Präzision | Elefantenfußkompensation | 0,15 (0,1) |
| Struktur → Wände | Wandschleifen | 3 (2) – die Zunge (1,4 mm) besteht dann ganz aus Wandbahnen |
| Struktur → Füllung | Fülldichte / Füllmuster | 15 % / Gyroid (Geradlinig) |
| Geschwindigkeit → erste Schicht | Erste Schicht | 30 mm/s (50) – Haftung des hohen, schmalen Kartenfachs |
| Stützen | Stützen aktivieren | aus (bleibt) |
| Sonstiges → Fuzzy Skin | Fuzzy Skin | Keine (bleibt) |
| Sonstiges → Bügeln | Bügeln | aus (bleibt) – die Teststücke brauchen keine glatte Vorderseite |
| Sonstiges → Umrandung (Prozess) | Randtyp / Randbreite / Lücke | Nur Außenrand / 5 mm / 0,1 mm – gilt für das Kartenfach |
| je C15-Stück (Rechtsklick in der Objektliste → Einstellungen hinzufügen → Sonstiges) | Randtyp | Keine Umrandung – ein Rand an der Kartenkante würde die Breite im Schacht verfälschen |
| Filament → Druckbett (Texturierte PEI) | Erste Schicht / Andere Schichten | 80 / 75 °C (70 / 70) – gegen Abheben |
| Filament → Kühlung | alle Werte | Profilwerte. **Nicht** die Korpus-Kühlung (Schichtdauer 100 s / 70 s): Dann dauert jede der 442 Schichten mindestens 70 s, der Slicer bremst die Wände auf unter 1 mm/s – 07.11.: 5 h 57 min, davon 4 h Wände. Die 70 s waren nur gegen Querlinien auf der sichtbaren Fuzzy-Außenhaut des Korpus |

Rolle vorher trocknen (Elegoo: 60 °C, 8 h), feuchtes PETG macht Fäden in den Schlitzen um die Zunge.
Nach dem Druck: Steg unter der Zungenspitze durchtrennen; die Zunge muss frei federn (Schlitze rundum offen, Fäden mit dem Cutter heraus),
die beiden Bohrungen sind von unten durchgängig. Danach C15 testen (Tabelle oben). Für die endgültigen Karten Bügeln nur „Oberste Oberfläche“, damit die Rille wie im Test bleibt.

### Niederhalter für die Steckkabel (`11_niederhalter_stiftleiste.stl`, Stand 07.11.2026)

Steg über der gelben 40er-Stiftleiste des Klemmen-Aufsatzes: Dach 65 × 20 × 4 mm, zwei Säulen Ø 6 auf den beiden freien Löchern
(Abstand 58), M2,5 von oben (Jans vorhandene Pi-Schraube, ca. 19,2 inkl. Kopf), Kopf tief versenkt: Senkungsboden 12,9 über der Platine,
Säule dort als Kragen Ø 7,2. Das Dach liegt 2 mm über den Steckern (12 mm) und drückt über die zur Seite geknickten Kabel
auf die Stecker. Bild: `niederhalter.png`. **Vor dem Druck:** Höhe des geknickten Kabels messen (`NH_KABEL`, vorläufig 2,0).

Inneres Teil, nicht sichtbar. Ausgangspunkt: Drucker „Elegoo Centauri Carbon 2 0.4 nozzle“, Filament „Elegoo PETG @ECC2“,
Prozess „0.20mm Standard @Elegoo CC2 0.4 nozzle“, Druckbetttyp „Texturierte PEI-Platte“. In Klammern: Profilwert vorher.
Alles andere bleibt auf dem Profilwert.

| Reiter → Gruppe | Einstellung | Wert |
| --- | --- | --- |
| Lage | – | wie in der STL: Dachoberseite mit den beiden Senkungen auf der Platte, Säulen nach oben. Nicht drehen, keine Stützen nötig |
| Qualität → Präzision | Elefantenfußkompensation | 0,15 (0,1) – sonst werden die Senkungen unten enger |
| Struktur → Wände | Wandschleifen | 4 (2) – die Säulen (Ø 6, Loch 2,9) werden ganz aus Wandbahnen gedruckt, das Dach wird steifer |
| Struktur → Füllung | Fülldichte / Füllmuster | 40 % / Gyroid (15 % / Geradlinig) – steifes Dach |
| Stützen | Stützen aktivieren | aus (bleibt) |
| Sonstiges → Fuzzy Skin | Fuzzy Skin | Keine (bleibt) |
| Sonstiges → Umrandung | Randtyp | Keine Umrandung – 1300 mm² Auflage haften ohne Rand |
| Filament → Druckbett (Texturierte PEI) | Erste Schicht / Andere Schichten | 80 / 75 °C (70 / 70) – gegen Abheben, wie bei allen Teilen |
| Filament → Kühlung | alle Werte | Profilwerte |

Einzige Überhänge: die Böden der beiden Senkungen (Ring Ø 5,6 um das Loch, 5,1 mm über der Platte) – kurze Brücken, unkritisch, der
Schraubenkopf liegt darauf. Rolle vorher trocknen (Elegoo: 60 °C, 8 h). Nach dem Druck: M2,5 muss durch die Säulen gehen; klemmt sie,
mit einem 2,9-mm-Bohrer von Hand nachdrehen.

**Montage:** Alle Steckkabel ganz auf die Stifte drücken. Kabel direkt über dem Stecker zur Seite knicken: äußere Reihe (Platinenkante)
nach vorne, innere Reihe nach hinten. Steg aufsetzen, Säulen auf die beiden freien Löcher, vorhandene Pi-Schraube (Flachkopf, ca. 19,2 inkl. Kopf) von oben
(Schraubendreher durch die 5,6-mm-Senkung), unter der Platine Mutter aus demselben Set oder, falls dort ein Abstandsbolzen zum Pi sitzt,
in den Bolzen schrauben. Die Schraube reicht ca. 2,7–3,2 mm unter die Platine. Nur so fest anziehen, bis der Steg aufliegt.

## Schrauben (Stand 06.11.2026)

Alle Dome, Kernlöcher und Senkungen sind auf die vorhandenen Kunststoffschrauben **3,0 × 12** ausgelegt (`SCREW_L`).

| Teil | Menge | Wofür |
| --- | --- | --- |
| Kunststoffschraube 3,0 × 12, Senkkopf | 14 (mit Gummiecken 10) | Boden in den Korpus (6, mit Gummiecken nur die 2 an der Kammerwand), Deckel hinten durch die Rückwand (2), Deckelrahmen an den Deckel (6, Kopf versenkt im Dom) |
| Kunststoffschraube 3,0 × 16, Senkkopf | 4 | Gummiecken: durch die PETG-Hülse in die 4 Eckdome des Bodens (statt 3,0 × 12) – **noch kaufen** |
| Kunststoffschraube 3,0 × 12, Flachkopf | 8 | Lautsprecher (4, mit M3-Scheiben), Kartenfach (2), USB-C-Buchse (2) |
| Schraube M2,5, ca. 5 mm länger als die jetzigen unter der Acrylplatte | 4 | Stapel von unten durch den Boden (Länge folgt nach deiner Messung) |
| vorhandene Pi-Schraube M2,5, Flachkopf, ca. 19,2 inkl. Kopf (Kopf Ø ≤ 5,2) + Mutter M2,5 aus demselben Set | je 2 | Niederhalter auf der gelben Stiftleiste (Länge unabhängig vom Kabelknick) |

## Was für die Montage noch fehlt (nicht bestellt)

| Teil | Menge | Wofür |
| --- | --- | --- |
| Doppelseitiges Montageband | 1 Rolle | Module in den Mulden |
| Buchschraube (Schaft Ø 7,5) + Lederriemen | 1 | Riemen links |
| Polyesterwatte, eine Handvoll | – | Lautsprecherkammer |

## Dateien

- `model.py` – das parametrische Modell, alle Maße oben als benannte Werte
- `check.py` – Kollisionen, Einbau (Deckel von oben, Boden von unten mit Hubweg), Druckbarkeit
- `PARAMETER.md`, `PRUEFBERICHT.md` – Werte mit Status und Prüfergebnis
- `boden_plan.png` – Boden von oben und Höhen von der Seite
- `gitter_ansicht.png` – Frontgitter: Ansichten, Schnitt durch Buchstabe, Stift und Luftraum, Lage auf den Druckplatten
- `gummiecken_ansicht.png`, `gummiecken_schnitt.png`, `gummiecken_varianten.png` – Gummiecken mit Füßen, verschraubt (`ecken_bild.py`)
