janshort4all/peppa-box/v4/out/PRUEFBERICHT.md

# Prüfbericht Musikbox v4 (Stand 09.11.2026)

Automatisch gerechnet mit den Werten aus `model.py`. Bauteile, deren Maße noch fehlen, stecken als Platzhalter (Hüllquader) im Modell.

## Kollisionen

Keine Überschneidung zwischen Druckteilen und Bauteilen.

## Einbau

**Deckel von oben:** Deckelrahmen mit Verteiler-Brücke, Kartenfach, Taster und die Module unter der Brücke passen an der ringsum geschlossenen Deckelauflage vorbei.

**Boden von unten:** Der Boden mit Stapel, Klemmen, Verstärker und allen Kabel-Freiräumen lässt sich senkrecht hochschieben, ohne an Drehgeber, Klinke, USB-Buchse, Lautsprecher, Domen oder Deckelteilen hängen zu bleiben (Hubweg geprüft, nicht nur die Endlage).

## Wichtige Abstände

| Prüfung | Wert (mm) |
| --- | --- |
| Oberkante Klemmen (z) | 77,5 |
| Unterkante Kartenfach (z) | 81,8 |
| Unterkante Klemmen im Deckel (z) | 117,4 |
| Abstand Pi + Klemmen-Aufsatz ↔ Kartenfach | 4,8 |
| Abstand Pi + Klemmen-Aufsatz ↔ RC522 | 7,8 |
| Abstand Klinkenstecker am Pi (Zone) ↔ Korpus | 5,5 |
| Abstand Pi + Klemmen-Aufsatz ↔ WAGO GND B | 39,9 |
| Abstand Pi + Klemmen-Aufsatz ↔ Touch-Modul MPR121 | 40,0 |
| Abstand Akku-Board mit Zellen ↔ Korpus | 4,1 |
| Abstand Kabel Klemmreihe links (Zone) ↔ Korpus | 4,5 |
| Abstand Kabel Klemmreihe rechts (Zone) ↔ Drehgeber | 12,0 |
| Abstand Kabel Klemmreihe hinten (Zone) ↔ USB-C-Platine mit Buchse und Kabeln | 7,0 |
| Abstand USB-C-Stecker am Akku-Board (Zone) ↔ Korpus | 4,5 |
| Abstand WAGO GND A ↔ Korpus | 2,4 |
| Abstand Verstärker ↔ Korpus | 5,0 |
| Abstand Boden ↔ Korpus | 0,0 |
| Abstand Lautsprecher ↔ Korpus | 0,0 |
| Abstand Lautsprecher ↔ gitter_beige | 1,3 |
| Abstand Kurzhubtaster ↔ Kartenfach | 4,2 |
| Abstand niederhalter ↔ Kartenfach | 35,2 |
| Abstand niederhalter ↔ Deckelrahmen | 40,0 |
| Abstand niederhalter ↔ Korpus | 3,0 |
| Abstand niederhalter ↔ RC522-Stecker (Zone) | 40,0 |
| Abstand niederhalter ↔ Touch-Modul MPR121 | 40,0 |
| Abstand niederhalter ↔ WAGO GND B | 38,0 |
| Abstand RC522 ↔ Deckelrahmen | 2,0 |
| Abstand RC522-Stecker (Zone) ↔ Korpus | 5,0 |
| Abstand RC522-Stecker (Zone) ↔ Deckelrahmen | 0,8 |
| Abstand RC522-Stecker (Zone) ↔ Kartenfach | 1,7 |
| Abstand Touch-Modul MPR121 ↔ Kartenfach | 13,5 |
| Abstand RC522-Stecker (Zone) ↔ Schraubblock Deckelrahmen hinten | 3,7 |

0,0 heißt: Teile liegen bewusst aneinander an (Lautsprecher auf der Mulde, Korpus auf dem Boden).
„Zone“ = Freiraum, den Kabel oder Stecker brauchen, kein Bauteil.

## Druckbarkeit (Centauri Carbon 2, Bauraum 256 × 256 × 256 mm)

| Datei | Größe in Druckausrichtung (mm) | Bewusste Brücken |
| --- | --- | --- |
| 01_korpus_beige.stl | 140 × 140 × 136 | Lautsprecherausschnitt oben 28 mm, Kernlöcher der Dome, Schlitze 2 mm (Kammerdecke seit 04.11. als 45°-Satteldach, keine Brücke mehr) |
| 02a_deckel_kern_orange.stl | 133 × 133 × 5 | Böden der Symbol-Vertiefungen (bis 10,8 mm; Variante A: auf PLA-Einleger statt Brücke) |
| 02b_deckel_haut_beige.stl | 133 × 133 × 1 | – |
| 03_deckelrahmen.stl | 128 × 128 × 17 | Boden Tasterhalter 12 mm |
| 04_kartenfach.stl | 14 × 52 × 88 | Seitenwand über dem Kartenschlitz 5 mm |
| 05_boden_traeger.stl | 140 × 140 × 8 | Decke der Senkbohrungen M2,5 (Ring 1,8 mm) |
| 06a_gitter_beige.stl | 115 × 116 × 6 | Böden der Sacklöcher für die Buchstaben-Stifte (Ø 2,4, unsichtbar) |
| 06b_logo_buchstaben_orange.stl | 100 × 57 × 2 | keine |
| 07_drehknopf_orange.stl | 34 × 34 × 23 | – |
| 08_ein_taste_orange.stl | 17 × 17 × 13 | – |
| 09_riemen_gegenplatte.stl | 18 × 24 × 4 | – |
| 11_niederhalter_stiftleiste.stl | 65 × 20 × 18 | – |
| 12_gummiecke_TPU_orange.stl | 145 × 145 × 23 | – |
| 13_eckhuelse_PETG.stl | 133 × 133 × 2 | – |

Alle anderen Flächen sind steiler als 45° oder liegen auf der Platte. Kein Teil braucht Stützmaterial.

## Gitter und Logo-Buchstaben (Schichtanalyse in Druckausrichtung)

- Gitter einfarbig: 297 Löcher Ø 3,3 im Wabenraster 4,7 (Steg 1,4 mm: breit genug, dass der Slicer jedes Loch umfährt).
- Offen direkt vor der Lautsprecheröffnung: 9 %; über den Luftraum (2,5 mm) erreichbar: 29 % der Öffnung.
- Gitter Schicht 1 (Sichtfläche): 10548 mm², schmaler als 1 Linie (0,4 mm): 0,00 mm².
- Gitter hinten (Luftraum): Rand läuft durch die Lochmitten, schmaler als 0,4 mm höchstens 1,01 mm² je Schicht (Ecken am Lochrand).
- Buchstaben: 11 Teile auf einer Platte (119 × 66 mm), mindestens 4,2 mm Abstand; Schicht 1 (Sichtseite) 2529 mm², schmaler als 0,4 mm: 0,63 mm² (Spitze im e-Schlitz, Ecken).
- 19 Stifte in Sacklöchern (Spiel 0,2 je Seite, Loch 0,3 tiefer), Überschneidung mit dem Gitter 0,000 mm³.
- STL geschlossen, keine doppelten Ecken (Löcher als gedrehte 32-Ecke, Versätze vereinfacht).
