janshort4all/peppa-box/STECKBRIEF.md

# Peppa Box – Projekt-Steckbrief (Stand 09.11.2026)

Eigenbau einer Toniebox-Alternative für Kinder. Eine NFC-Karte mit aufgeklebtem Cover-Bild startet eine Spotify-Playlist.
Gehäuse: gedruckter Würfel 140 × 140 × 140 mm in Beige mit orangen Akzenten, Elegoo Centauri Carbon 2 mit CANVAS (4 Rollen), PETG.

Diese Datei fasst alle Entscheidungen bis hierher zusammen. Sie gehört in das Projektwissen und ist die Grundlage für jeden neuen Chat.

## Regeln für die Zusammenarbeit

- Nur in der EU bestellen, am liebsten bei Shops in Deutschland oder den Niederlanden.
- Von sich aus auf Sparmöglichkeiten hinweisen.
- Möglichst wenig löten (erste Lötarbeiten).
- Keine Gewindeeinsätze. Schrauben gehen direkt in den Kunststoff, Dome 9 mm, damit Einsätze später möglich bleiben.
- Listen mit anklickbaren Links.
- **Anschlüsse am Klemmen-Aufsatz immer mit dessen Aufdruck benennen** (gelbe Stifte: P26, P18, GND, 3V3 …; Federklemmen: Buchstabe A–P bzw. Zahl 1–8 und Aufdruck), nie mit Pi-Pinnummern wie „Pin 37“. Ausdrücklicher Wunsch Jan (05.11.).
- Vor jedem Kauf prüfen, ob das Teil exakt passt.
- Kein Maß einfach annehmen. Ist etwas nicht belegt, das sagen oder nachfragen.
- Vor jeder Anschlussanleitung die Produktseite bzw. das Datenblatt des Bauteils prüfen (Jumper, Lötbrücken, Spannung, Pinbelegung) und die Quelle nennen. Nicht geprüfte Aussagen ausdrücklich als Vermutung kennzeichnen.
- Bei der Fehlersuche zuerst den Aufbau der beteiligten Platinen prüfen, dann Kabel und Lötstellen.
- Slicer ist ElegooSlicer (nicht SatelLite, das ist für Harz).
- **Kein Umbau mehr an der Box, egal an welchem Teil** (Grundbedingung Jan, 09.11.). Änderungen nur noch an Teilen, die nicht zur Box gehören (Karten); deren Steckteil bleibt maßgleich.

## Aktueller Stand

| Bereich | Stand |
| --- | --- |
| Bestellungen | BerryBase, Amazon (RC522, MAX98357A) geliefert. Reichelt: mehrere Artikel nicht lieferbar, wird gerade geklärt |
| Pi | Raspberry Pi OS Lite 64-bit (Debian 13 Trixie, 06.10.2026) auf SanDisk Ultra 128 GB A1; Ton über die Pi-Klinke getestet, gut |
| Stapel | Akku-Board + Pi + Klemmen-Aufsatz verschraubt, auf dem gedruckten Boden (Version mit DAC-Stiften) montiert, passt |
| Druck | **Korpus 04./05.11. gedruckt – perfekt, abgenommen.** Deckel 05.11. (Symbole vertieft) nicht abgenommen; Symbole bleiben vertieft (ertastbar), Variante B (gerichtete Brücken) mit C12 bestätigt; als Nächstes ganzer Deckel, G-Code vorher prüfen (Nachtrag 05.11. (5)) |
| Verdrahtung | **Komplett verdrahtet, exakt nach Verdrahtungsplan 08.11.** (Jan, 08.11. abends) |
| Software | **09.11. (6): Stabilität** – Kopfhörer wechseln ohne Raspotify-Neustart (Tonausgabe `ausgabe.py`), Phantom-Berührungen gefiltert, Selbstreparatur mit wachsendem Abstand, Protokoll übersteht Neustarts, Diagnose auf der Eltern-Seite. **Am Pi: Update über die Seite, dann einmal `dienst_einrichten.sh` + Neustart** (Nachtrag 09.11. (6)) |
| Gummiecken | **09.11.:** vier einzelne Gummiecken aus orangem TPU, **verschraubt** über die Eckschrauben des Bodens (3,0 × 16 durch PETG-Hülse), Form **C** (20/8 mm), ohne Änderung am Gehäuse (Nachträge 09.11.). Im Modell, geprüft. TPU gekauft (TINMORRY 95A Orange, 09.11.). Als Nächstes: Schrauben 3,0 × 16 kaufen, C16 + Hülsen drucken |

## Hardware (endgültig)

- Raspberry Pi 3A+
- Waveshare UPS HAT (D) mit 2 × BAK N21700CG50; Acrylplatte 85 × 55 mm, Messingbolzen, Lochbild 58 × 49 mm
- BerryBase GPIO-Breakout-HAT mit Federklemmen (Reihen 1–8, A–H, I–P); gelbe Stifte gehen durch
- MAX98357A-Klon (Lautsprecher, I2S an den gelben Stiften P18 BCLK, P19 LRC, P21 DIN; SD/stumm an P16)
- Visaton FRS 8, 4 Ω, in eigener geschlossener Kammer vorne
- Kopfhörer: **direkt aus der Klinke des Pi** (DAC entfällt, 25.10.). Kabel Goobay 67782 (ein Stecker 90°) halbiert zur Lumberg 1503-09 in der rechten Wand. Steckererkennung: Öffner L (Fahne C) an gelbem Stift P26. Beim Ein-/Ausstecken stellt das Programm den Spotify-Ausgang um (3–5 s Pause), Lautsprecher stumm, Lautstärke begrenzt
- RC522 (SPI, Klemmen B–E, RST an I = 3,3 V), MPR121 (I2C 0x5A, SDA Klemme 2, SCL über WAGO an Klemme 3, INT an P05, 4 Kupfer-Touchfelder im Deckel), STEC11B03 Drehgeber (A P17, B P27, C GND A), Kurzhubtaster 12 × 12 × 7,3 (BerryBase KHT1212PV73) hinter gedruckter Ein-Taste (an SCL zum Wecken)
- WAGO: auf dem Boden 5 V (3-fach) und GND A (5-fach); unter dem Deckel 3,3 V, SCL (je 3-fach) und GND B (5-fach)
- Elko 1000 µF / 10 V an 5 V / GND A

`config.txt`: `dtparam=spi=on`, `dtparam=i2c_arm=on`, `dtparam=audio=on`, `dtoverlay=hifiberry-dac` (I2S für den MAX98357A).

## Gehäuse (Modell v4, parametrisch in `v4/model.py`)

- **Korpus** unten offen, Lautsprecherkammer mit eigenem Boden (2,4 mm), Kammerdecke als 45°-Satteldach (seit 04.11., vorher 40-mm-Brücke). Deckelauflage ringsum geschlossen.
- **Boden = Elektronikträger**, 4 mm, außen 0,4 mm kleiner (Schattenfuge), Zentrierkragen hinten. Wird von unten eingesetzt, 6 Senkschrauben 3,0 × 14 in Dome (4 Ecken, 2 an der Kammerwand). Einbau inkl. Hubweg geprüft.
- **Stapel auf dem Boden:** Überhang mit BOOT-Taste links, gelbe Stifte vorne, Anschlusskante (USB-C, Schalter, Pi-Klinke) hinten. 4 Auflagen mit Mulde; Befestigung später mit M2,5-Schrauben von unten (alte Länge + ca. 5 mm, Linsen-/Flachkopf). **Offen:** Länge der vorhandenen Schrauben.
- **Hinten auf dem Boden:** Mulden für WAGO GND A, WAGO 5 V, Verstärker. Rechter Teil frei (Kabelreserve, Elko).
- **Deckel:** zweifarbig (oranger Kern, beige Haut 0,7 mm), 4 Touchfelder mit Symbolen, Kartenschlitz, Ein-Taste hinten rechts in Mulde. **Deckelrahmen** mit Verteiler-Brücke (MPR121 + 3 WAGO hängend), Tasterhalter, Zungen vorne, 2 Schrauben hinten durch die Rückwand.
- **Kartenfach:** Karte 70 × 112 × 4 mm, 42 mm tief, 8° geneigt, Federzunge mit Rastnase (Karte hat vorne eine Rille, seit 07.11.), RC522 in Schienen dahinter.
- **Rechts:** Drehknopf (y 84, z 60) und Klinke (y 84, z 24). **Links:** Riemen (z 118). **Hinten:** USB-C-Einbaubuchse x 114, z 60, innen höchstens 20 mm tief (Produkt offen; Stecker am Akku-Board gewinkelt oder ≤ 20 mm), Lüftungsschlitze.
- **Front:** gedrucktes Gitter statt Stoff, **einfarbig beige**; Logo groß in der Mitte als **eigene orange Buchstaben, 1,2 mm erhaben, aufgeklebt** (Stifte in Sacklöchern), beiges Feld um das Logo ohne lose Löcher (`GR_HALO`): `06a` Gitter, `06b` alle Buchstaben, Bilder `out/gitter_ansicht.png`, `out/gitter_vorne_nah.png` (Nachträge 05.11. (6), 06.11. (1), (2), (4)).
- Höhen: Klemmen 77,5 mm, Kartenfach ab 86,8 mm, Deckel-Module ab 117,4 mm.
- **Gummiecken (TPU, seit 09.11.):** 4 × `12_gummiecke_TPU_orange.stl` + 4 × `13_eckhuelse_PETG.stl`, Füße 3 mm, Form C (20/8). Jede Ecke an der Eckschraube des Bodens (Senkschraube **3,0 × 16** durch die Hülse; die 2 Schrauben an der Kammerwand bleiben 3,0 × 12), dazu Rastwulst unter der Fuge Boden/Korpus. Parameter `ECK_*` in `v4/model.py`.

Druck (Stand 04.11.): Düse 0,4, 0,2 mm, 3 Wandschleifen, 15 % Gyroid, keine Stützen. Fuzzy Skin 0,20 / 0,30 Classic **nur über den Modifier `01f_…FUZZY_aussenhaut`** (Prozess „Nur lackiert“, Modifier „Kontur“; alle Korpus-Einstellungen in `v4/out/README.md`); der alte Modifier `01m_…` ist ungültig (siehe Nachtrag 04.11.).

## Software (Stand 08.11.2026, Einzelheiten in den Nachträgen)

- Raspotify/librespot als Spotify-Lautsprecher, Player `software/peppa_player.py` (Dienst `peppa-player`): Karte (Link steht auf der Karte), Touchfelder, Drehknopf, Ein-Taste, Kopfhörer-Umschaltung, Akku-Wache, Ansagen, Automatik (Timer, Ruhezeit, Auto-Aus), Spotify-Steuerung mit Selbstreparatur.
- Eltern-Seite `software/peppa_web.py` (Dienst `peppa-web`, `http://peppabox.local`): Zustand, Lautstärke, Zeiten, Bedienung live prüfen und einstellen, Ansagen anhören, Update/Rückweg.
- Lautstärke lokal (softvol bzw. Regler der Klinke), Spotify fest auf 100 %.
- Watchdogs: systemd-Watchdog für den Player, Hardware-Wächter des Pi (15 s), alle Fäden überwacht.
- Noch offen: Schreibschutz-Overlay (ganz zum Schluss), WLAN wechseln unterwegs (Konzept 02.11., später), Tailscale, Android-Apps.

## Offene Punkte

0. **Software am Pi einrichten und alle Bedienelemente testen** (Nachtrag 08.11.2026 (3)).
1. Reichelt-Bestellung klären; DAC und Cinch-Kabel stornieren, ebenso die 32-GB-SD-Karte.
2. Bestellen (gesammelt): Klinkenkabel Goobay 67782, Kunststoffschrauben 3,0 mm (Sortiment), 4 × M2,5 (Länge folgt), USB-C-Verlängerung (Produkt offen), Montageband.
3. Länge der M2,5-Schrauben unter der Acrylplatte messen → Auflagenhöhe anpassen.
4. Nach Lieferung von Reichelt messen: Lautsprecher-Lochabstand, Gewindelängen Drehgeber und Klinke, Tasterhöhe; RC522- und MAX-Maße; NFC-Aufkleber-Dicke.
5. Coupons drucken und auswerten: C2, C4, C6, C7, C8.
6. Korpus-Prototyp: Boden einsetzen, Schrauben. Kammerdecke ist seit 04.11. ein Satteldach im Korpus (einteilig, Entscheidung Jan) – nach dem Druck außen auf ca. 95–125 mm Druckhöhe auf Linien ansehen.
7. Gitter mit Logo: im Modell (Stand 06.11.: Variante A, Logo groß in der Mitte, aufgeklebte Buchstaben, geglättetes Feld). Offen: G-Code C13 auswerten (Fäden), Einstellungen festlegen, C14 drucken, dann Gitter und Buchstaben (G-Code vorher prüfen lassen); vor dem Kleben Probe hören.
8. Optional: Lichtleiter für die Lade-LED, Ideen zur optischen Individualisierung (Seitenteile, Deckeleinlage, Magnete).
9. **Sprachausgaben überarbeiten (Wunsch Jan 08.11.):** Alle Ansagen außer „bereit“ (Sprachausgabe pico2wave) klingen schrecklich. Ziel: alle Ansagen als eigene Aufnahmen in einheitlicher Stimme (wie „bereit“: ElevenLabs, Stimme „Helmut“), gleiche Lautheit. Texte in `software/ansagen/TEXTE.md`. Details folgen von Jan.
10. Spotify-Anmeldung über die Eltern-Seite statt im Terminal (für künftiges Neuaufsetzen).
11. **Gummiecken:** TPU gekauft (TINMORRY 95A Orange, Nachtrag 09.11. (4)); 4 × Senkschraube 3,0 × 16 kaufen; TPU trocknen (70 °C, 8 h); Coupon C16 (Wulst 0,4 / 0,5 / 0,6, je eine vollständige Ecke) und 5 Hülsen drucken, an einer vorderen und einer hinteren Ecke probieren, `ECK_WULST` festlegen, dann die restlichen Ecken drucken (Nachtrag 09.11. (2)).

## Links (Artefakte, bleiben dauerhaft erhalten)

- Konzeptprüfung (Dokument mit Kapitel 1–13): https://claude.ai/artifact/6e3WZJZKozFgtdKq3825og
- Einkaufsliste: https://claude.ai/artifact/YbnQM68dkUknMvpfWoy1yh
- Verdrahtungsplan: https://claude.ai/artifact/SBLr57seH7cgAwgjYAD57C

## Quellcode (Datei `peppabox_quellcode.zip`)

In einem neuen Chat die Zip anhängen und sagen: „Entpacke nach /home/claude/musikbox“. Dann laufen die Skripte wie bisher.

| Datei | Zweck |
| --- | --- |
| `v4/model.py` | parametrisches Modell, alle Maße oben mit Status (belegt / gemessen / festgelegt / vorläufig / Probedruck) |
| `v4/check.py` | Kollisionen, Einbau (Deckel von oben, Boden von unten mit Hubweg), Überhänge |
| `v4/build_all.py` | STL-Export in Druckausrichtung, Ansichten (braucht `v3/concept3.py`) |
| `v4/coupons.py` | Probedruck-Coupons C1–C8 |
| `v4/docs.py` | README, PARAMETER, PRÜFBERICHT, Druckpaket-Zip |
| `v4/boden_plan.py` | Draufsicht und Höhen des Bodens |
| `v4/usbc_schnitt.py` | Schnitte durch den Halter der USB-C-Platine, Ansicht der Öffnung (`out/usbc_schnitt.png`) |
| `v4/modifier.py` | Modifier-Körper „ohne Fuzzy Skin“ |
| `v4/ecken_bild.py` | Bilder Gummiecken: Ansicht, Schnitt durch Fuge und Wulst, Formvarianten (`out/gummiecken_*.png`) |
| `v4/gitter/` | Logo-Vorlage (`peppa_box_logo.png`), Vektorisierung (`logo.py`), Bild zum Gitter (`render_gitter.py` → `out/gitter_ansicht.png`) |
| `plan/gen_plan5.py` | erzeugt `verdrahtungsplan.html` (nach Baugruppen, Aufdrucke des Aufsatzes) |
| `plan/einkaufsliste.html` | Einkaufsliste (Daten stehen im Skriptteil) |
| `software/` | Player, Eltern-Seite, Einrichtung, Tests (`cd software && python3 -m unittest`) |
| `v4/out/` | aktuelle STL-Dateien, Bilder, PARAMETER.md, PRUEFBERICHT.md |

Python-Pakete: manifold3d, trimesh, numpy, pillow, matplotlib, opencv-python.

## Nachtrag 25.10.2026 – Prototyp-Korpus ausgewertet, Fuge Boden/Korpus

- Prototyp (0,28 mm, 2 Wände, 10 %) gedruckt: Maße und Einbau des Bodens mit Stapel passen. Sichtbar: Schichtlinien, Naht hinten, raue 45°-Schrägen oben an Rahmen-Vertiefung und Lautsprecher-Mulde, „X“-Kratzspur auf der Kammerdecke (fehlender Z-Hop), Reste der Umrandung an der Unterkante.
- Entscheidung: Boden bleibt unter dem Korpus (kein eingelassener Boden).
- Boden jetzt **exakt bündig** mit dem Korpus (vorher 0,4 mm kleiner). Fuge außen als **V-Fuge**: je 0,8 mm Fase an Korpus-Unterkante und Boden-Oberkante; Standkante des Bodens 0,8 mm gefast. Zentrierkragen mit 0,2 mm Spiel (vorher 0,3), per Coupon C8 prüfen. Eckdome dafür 0,4 mm nach innen gerückt.
- Für den endgültigen Druck: keine Umrandung am Korpus, Elefantenfuß-Kompensation ca. 0,15 mm, Z-Hop 0,4 mm, Scarf Seam.
- Skripte nutzen jetzt relative Pfade; das Repository läuft an beliebigem Ort.

## Nachtrag 25.10.2026 – RC522 gemessen, Stiftleiste gewinkelt

- RC522 gemessen: 60 × 40 mm, Antennenmitte 20 mm vom Antennenende (40 mm bis zum Lötlochende), Quarz 5 mm hoch (Modell vorher 3 mm). Prüfung ok, Abstand zum Deckelrahmen 2,0 mm.
- Stiftleiste **gewinkelt (90°)**, Kunststoffleiste auf der Bauteilseite, Stifte flach in Platinenebene zur rechten Seitenwand, Überstand 6 mm. Neue Zone „RC522-Stecker“ im Modell (Stiftleiste + Steckkabel-Buchsen + Kabelbogen).
- Platz von der Platinenkante bis zur Innenwand: ca. 27 mm. Gesteckte Kabel enden 14 mm hinter der Platinenkante (gemessen), es bleiben ca. 13 mm für den Kabelbogen. Prüfung ok.
- MAX98357A: SD an Pin 36 (GPIO 16) hat beim Start den internen Pull-down des Pi → Verstärker stumm. Programm muss GPIO 16 als Eingang **ohne** Pull setzen (`pinctrl set 16 ip pn`). Noch nicht im Verdrahtungsplan.
- Klemmen-Aufsatz (BerryBase) hat GPIO 25 nicht auf einer Klemme. Entscheidung: **RC522 RST an 3,3 V** (Klemme I), Reset per Software (Soft-Reset). GPIO 25 / Pin 22 wird frei. Belegung RC522 am Aufsatz: SDA→E (CE0), SCK→D (SCLK), MOSI→B, MISO→C, GND→G, RST→I (3,3 V), 3.3V→A, IRQ frei. Verdrahtungsplan noch nachziehen.
- **Korrektur `config.txt`:** Auf dem Pi waren `dtparam=spi=on` und `dtparam=i2c_arm=on` noch auskommentiert, `dtoverlay=hifiberry-dac` fehlt. SPI und I2C am 25.10. eingeschaltet. hifiberry-dac wird ergänzt, wenn der Lautsprecher getestet wird.
- Pi holt das Repository jetzt selbst: Klon unter `~/peppa-box`, Lesezugang per Deploy Key (nur lesen). Aktualisieren mit `cd ~/peppa-box && git pull`. Testprogramm RC522: `software/rc522_test.py`.
- **Klemmen-Aufsatz verstanden:** Je Zeile zwei gelbe Stifte. Die Reihe zur Pi-Seite ist mit dem Pi verbunden, die andere mit der Federklemme. Verbindung erst durch einen **Jumper** (24 Stück im Lieferumfang). Ohne Jumper sind die Klemmen tot – das war die Ursache der Fehlersuche am 25.10. Für RC522 Jumper in A, B, C, D, E, G.
- Pi am 25.10. neu aufgesetzt (SD-Karte nach Absturz beim Umstecken unter Spannung und hartem Ausschalten defekt). Regel: Kabel nur bei ausgeschaltetem Pi umstecken, vorher `sudo poweroff`.
- RC522-Test am 25.10. erfolgreich über die Federklemmen (Jumper A, B, C, D, E, G, I; RST an Klemme I = 3,3 V).
- Offen: Verdrahtungsplan um Jumper-Belegung des Aufsatzes ergänzen; übrige Module (MAX98357A, MPR121, UPS HAT D) gegen Produktseiten/Datenblätter prüfen.
- RC522-Diagnose 25.10.: SPI ok (Version 0x92 stabil), Antenne an (TxControl 0x83), Befehle werden gesendet. Ohne RxNoErr meldete der Empfänger nach jeder Abfrage Störempfang (0 Byte); mit RxNoErr sauberes Timeout. Karten aus dem Set werden nicht erkannt. Programm entspricht der Init-/Befehlsfolge der gängigen Bibliotheken. Verdacht: Hardware (bekanntes Problem billiger RC522: verstimmte Antenne / schwache Spulen L1, L2). Nächste Schritte: Karte mit Handy-NFC prüfen, zweites RC522-Modul testen.
- Gegenprobe mit unveränderter Bibliothek pimylifeup/MFRC522-python (`software/rc522_ref_test.py`): ebenfalls keine Karte. Karte per Handy-NFC geprüft: MIFARE Classic 1K, UID 19:81:15:20, in Ordnung. **Ergebnis: RC522-Modul defekt (Empfangsteil).** Offen: Modul reklamieren, Ersatz bestellen (3er-Pack, 60 × 40 mm, gewinkelte Stiftleiste wieder selbst einlöten).
- Zweites RC522-Modul eingebaut: liest Karten (`software/rc522_test.py`, z. B. UID 7B:6E:CD:55). Noch prüfen: Lesen durch ca. 5 mm Kunststoff/Pappe, stabile Erkennung bei ruhig liegender Karte.
- **Korrektur RC522:** Mit sicher steckenden Kabeln liest das zweite Modul fehlerfrei (z. B. 47:82:C6:2E bei ruhiger Karte jede Abfrage). Die Aussetzer kamen von einem Draht, der halb aus einer Federklemme gerutscht war. Das erste Modul ist daher vermutlich **nicht** defekt; vor einer Reklamation mit sicherer Verkabelung erneut testen (`--stat`). Regel: Drähte verzinnen, bis Anschlag einstecken, Zugtest; beim Einbau Zugentlastung.
- **RC522 abgeschlossen:** Karte 19:81:15:20 (per Handy-NFC geprüft) bei 3 cm Abstand durch 2–3 mm Plexiglas bei jeder Abfrage fehlerfrei gelesen. Reichweite für das Kartenfach ausreichend.

## Nachtrag 25.10.2026 – Spotify-Grundfunktion (Test)

- Recherche: Raspotify 0.48.4 (22.10.2026) unterstützt Debian 13 Trixie/arm64; Anmeldung nur noch über Zeroconf (Spotify-App im selben WLAN) oder OAuth, kein Passwort. Spotify-Entwickler-App: Inhaber braucht seit Feb. 2026 Premium; Redirect-URI `http://127.0.0.1:8888/callback` (localhost verboten); Entwicklungsmodus max. 5 Testnutzer.
- Raspotify-Einstellungen: `LIBRESPOT_NAME="Peppa Box"`, Zugangsdaten-Cache **an** (Zeile `LIBRESPOT_DISABLE_CREDENTIAL_CACHE=` auskommentieren), damit die Box nach Neustart ohne App in der Geräteliste der Web API erscheint. Ausgabe vorerst Pi-Klinke.
- Neue Programme in `software/`: `rc522.py` (Lesemodul), `spotify.py` (PKCE-Anmeldung, Web API, nur Standardbibliothek), `spotify_login.py`, `karte_zuordnen.py`, `peppa_player.py` (Karte auf = spielen, weg = Pause, gleiche Karte = weiter).
- Zugangsdaten und Kartenliste liegen nur auf dem Pi unter `~/.config/peppa-box/` (config.json, spotify_token.json, karten.json), nicht im Repository.
- Raspotify eingerichtet und geprüft: Gerät „Peppa Box“, Ausgabe `LIBRESPOT_DEVICE="plughw:CARD=Headphones,DEV=0"` (Pi-Klinke, Karte per Name statt Nummer). Zugangsdaten-Cache aktiv (`/var/lib/raspotify/credentials.json`), Box erscheint nach Neustart von Raspotify ohne App in der Web-API-Geräteliste. Spotify-Anmeldung (PKCE) erfolgreich. Hinweis: `/etc/raspotify/conf` nur mit sudo lesbar.
- **Meilenstein 25.10.2026: Grundfunktion läuft.** Karte auflegen startet die zugeordnete Playlist auf der Peppa Box (Pi-Klinke), Karte weg = Pause, gleiche Karte = weiter. Offen: Player als Dienst beim Start, Lautsprecher/MAX98357A, MPR121, Drehgeber, Ein-Taste, Kopfhörer-Umschaltung, Karten bequemer anlernen.
- Player als Dienst `peppa-player` (systemd, Neustart nach Fehlern, wartet auf das Spotify-Gerät). Einrichten: `sh ~/peppa-box/software/dienst_einrichten.sh` (Benutzername wird beim Einrichten eingesetzt, steht nicht im Repository). Protokoll: `journalctl -u peppa-player -f`.
- Einstellungsseite fürs Handy im Player (`software/webui.py`, Port 8080, nur Standardbibliothek): aufgelegte Karte live, Spotify-Link + Name speichern, umbenennen, löschen. Nach dem Speichern startet die aufgelegte Karte sofort. Kein Passwort (jeder im Heim-WLAN kann Karten ändern) – später ggf. PIN.
- **Umstellung 25.10.: Link steht auf der Karte** (keine Zuordnungsliste mehr). Bespielen mit dem Handy, z. B. NFC Tools: Schreiben → URL → Spotify-Link. Box liest NDEF-URI von NTAG/Ultralight (Typ 2) und MIFARE Classic (NDEF-Sektoren mit öffentlichem Schlüssel D3F7D3F7D3F7). `karten.py`/`karte_zuordnen.py` entfernt, Webseite zeigt nur noch Status (Karte, Link) und die Anleitung. Test: `python3 ~/peppa-box/software/rc522.py`. Noch am Gerät zu prüfen; Typ der endgültigen NFC-Aufkleber offen (NTAG213/215 empfohlen).
- Rauschen an der Pi-Klinke (Kopfhörer): DAC bleibt draußen (Entscheidung Jan). Maßnahmen: Leser fragt nur noch 1× pro Sekunde ab, Funkfeld zwischen den Abfragen aus, „Karte weg“ erst nach zwei verpassten Abfragen. Raspotify: `LIBRESPOT_VOLUME_CTRL=fixed`, `LIBRESPOT_INITIAL_VOLUME=100` (Spotify fest 100 %), Lautstärke über ALSA-Regler `PCM` der Karte `Headphones`, gespeichert mit `alsactl store`.
- **Spotify-Konto der Box:** Eigenes Mitgliedskonto im Familien-Abo angelegt, Raspotify damit aber „error audio key 0 1“ (Titel springen im Sekundentakt, kein Ton). Bekanntes offenes librespot-Problem bei manchen (v. a. neuen) Premium-Konten: librespot-org/librespot #1735, #1649. Vorerst wieder Jans Konto. **Offen:** nach Raspotify-Updates (`sudo apt update && sudo apt upgrade`) erneut mit dem Box-Konto testen; dann Konto in der Entwickler-App unter User Management eintragen und `spotify_login.py` mit dem Box-Konto wiederholen.
- Einfarbiger Deckel für den Prototyp: `v4/out/02_deckel_einfarbig.stl` (Vereinigung von 02a + 02b, volumengleich geprüft). Wird nicht von `build_all.py` erzeugt; nach Deckeländerungen neu vereinigen.

## Nachtrag 26.10.2026 – Eltern-Seite (Stufe 1)

- Neuer Dienst **`peppa-web`** (`software/peppa_web.py`, Seite in `software/web/`), getrennt vom Player, damit Updates und Neustarts die Seite nicht mitreißen. Adresse: `http://<rechnername>.local` (Port 80) oder `:8080`. Nur Standardbibliothek. **Kein Passwort** (Entscheidung Jan); Schutz nur gegen untergeschobene Klicks fremder Webseiten (eigener Kopfeintrag `X-Peppa-Box`).
- Funktionen: Karte und Link live; Zustand (Akku, Musik bereit, WLAN, Temperatur, Speicher, Unterspannung über `vcgencmd get_throttled`, Laufzeit); **Nach Updates suchen / Jetzt aktualisieren / Zurück zur vorherigen Version** (git fetch, `merge --ff-only`, Rückweg per `reset --hard` auf die gespeicherte Version in `~/.config/peppa-box/vorherige_version.txt`; Update bricht ab, wenn auf dem Pi Dateien im Repository geändert wurden); Musik neu starten (Raspotify + Player); Box neu starten; Ausschalten; letzte Meldungen aus dem Protokoll.
- Player hat keine eigene Webseite mehr (`webui.py` entfernt). Er schreibt seinen Zustand jede Sekunde nach `/dev/shm/peppa-box-status.json` (Arbeitsspeicher, schont die SD-Karte).
- `dienst_einrichten.sh` richtet jetzt beide Dienste ein, dazu `/etc/sudoers.d/peppa-box` (nur `systemctl poweroff`, `reboot`, `restart peppa-player`, `restart raspotify`, geprüft mit `visudo`) und die Gruppen `i2c`, `adm`, `video`. **Einmal am Pi ausführen:** `cd ~/peppa-box && git pull && sh software/dienst_einrichten.sh`. Danach kommen Updates über die Seite.
- Akku: `software/akku.py` liest den INA219 des UPS HAT (D) an I2C 0x43 (laut Waveshare-Wiki), nur lesend. Spannung aus Register 0x02, Laderichtung aus dem Vorzeichen der Shunt-Spannung. **Offen:** Vorzeichen am Gerät prüfen (mit Netzteil = „wird geladen“?), Prozent ist eine grobe Kennlinie (Waveshare nennt nur 4,2 V = voll). Test: `python3 ~/peppa-box/software/akku.py`.
- Ausprobiert im Probelauf (`PEPPA_WEB_TROCKEN=1`, sudo-Befehle werden nur angezeigt): Update, Abbruch bei geänderten Dateien, Rückweg, alle Box-Aktionen, Seite hell/dunkel auf Handygröße. **Am Pi noch zu prüfen:** sudo-Freigabe, Port 80, Akkuanzeige, WLAN-Name (nmcli).
- Handy: Seite ist als Web-App vorbereitet (Manifest, Symbol). Über `http://` im Heimnetz legt Chrome nur eine Verknüpfung an (öffnet mit Adressleiste); als echte App ohne Adressleiste erst mit HTTPS.
- Plan unterwegs/Urlaub: **Tailscale** (Personal-Tarif kostenlos, privates Netz zwischen Box und Handys, ohne Portfreigabe im Router). `tailscale serve` liefert dabei HTTPS mit gültigem Zertifikat → echte Web-App. Noch nicht eingerichtet. Ebenfalls später: WLAN der Box umschalten (z. B. Urlaubs-WLAN, Handy-Hotspot); Systempakete (apt) über die Seite aktualisieren; Stufe 2 (Lautstärkegrenzen, Schlummer-Timer, Abendmodus, Auto-Aus).

## Nachtrag 26.10.2026 – Deckelrahmen war seitenverkehrt (Fehler behoben)

- Befund am Druck: Unter der Ein-Taste liegt der Rahmen statt des Tasterhalters, die vier Schrauben vorne/hinten passen nicht, nur die beiden seitlichen in der Rahmenmitte.
- Ursache: Fehler in der Druckausrichtung, nicht im Modell. `check.py/orient()` hat den Deckelrahmen für den Druck mit `mirror([0, 0, 1])` umgedreht. Eine Spiegelung ist keine Drehung → das STL `03_deckelrahmen.stl` war spiegelbildlich. Die seitlichen Schrauben (y 68 / 70) liegen fast auf der Mitte und passten deshalb trotzdem.
- Behoben: Deckelrahmen, Ein-Taste und die Coupons C2 (Rahmenecke) und C3 (Halter, Kappe) werden jetzt mit `rotate([180, 0, 0])` gedreht. Neue Prüfung in `check.py`: „Druckausrichtung ohne Spiegelung“ für alle Teile (Prüfkörper, Gegenprobe mit Spiegelung schlägt an). Neues STL gegen die Einbaulage geprüft: deckungsgleich.
- Deckel, Boden, Korpus, Kartenfach waren nicht betroffen. Ein-Taste ist rund und war nur formal betroffen; der alte Druck ist brauchbar.
- **Zu tun:** `03_deckelrahmen.stl` neu drucken. Coupons C2/C3, falls schon gedruckt, ebenfalls neu.

## Nachtrag 27.10.2026 – Eltern-Seite Stufe 2 (Lautstärke, Timer, Ruhezeit, Auto-Aus)

- **Aufteilung:** Die Seite (`peppa-web`) ändert nur Einstellungen und Dateien, ausgeführt wird im **Player** (`software/automatik.py`, ein Aufruf pro Sekunde). Dadurch überstehen Timer ein Update der Seite. Neue Module: `einstellungen.py` (Einstellungen prüfen/speichern, Ruhezeit-Logik), `lautstaerke.py` (amixer), `automatik.py`. `spotify.spielt()` fragt per Web API, ob die Box gerade spielt (alle 10 s).
- **Speicherorte:** Einstellungen in `~/.config/peppa-box/einstellungen.json` (nur auf dem Pi, bleibt bei Updates erhalten). Timer, „Ruhezeit ausgesetzt“, Status in `/dev/shm/peppa-box-*.json` (Arbeitsspeicher, nach Neustart der Box weg).
- **Lautstärke:** Regler auf der Seite, Höchst- und Startlautstärke je Ausgang (Kopfhörer/Klinke, Lautsprecher). Die Grenze gilt für den Regler, wird aber auch vom Player durchgesetzt (zu laut wird in höchstens 10 s heruntergesetzt, eine neue Grenze wirkt sofort). Startlautstärke einmal je Einschalten (Markierung in /dev/shm), ein Neustart des Players ändert die laufende Lautstärke nicht. Prozent = Regler wie `alsamixer` (`amixer -M`). **Lautsprecher ist noch „nicht eingerichtet“:** Der MAX98357A hat keinen Regler, dafür braucht es eine Software-Lautstärke (ALSA softvol); danach Karte und Reglername in `lautstaerke.py` (`AUSGABEN["lautsprecher"]`) eintragen. Bis dahin sind die Lautsprecher-Werte nur vorgemerkt. Die Kopfhörer-Erkennung (Öffner an Pin 37) fehlt noch; `aktive_ausgabe()` nimmt den Lautsprecher, sobald er eingerichtet ist.
- **Schlummer-Timer:** 15/30/45/60 Min. Die letzten 20 s wird leiser, dann Pause, dann ist die Lautstärke wieder wie vorher (auch wenn der Player mitten im Ausblenden neu startet). Abbrechen stellt die Lautstärke wieder her.
- **Ruhezeit (Abendmodus):** Von/Bis (darf über Mitternacht gehen), Modus „leiser“ (höchstens X %) oder „keine Musik“ (laufende Musik wird pausiert, Karten starten nicht). „Für heute aussetzen“ gilt bis zum Ende der Ruhezeit. Nach der Ruhezeit wird die Lautstärke nie von selbst lauter. Standard aus. **Die Ruhezeit richtet sich nach der Uhr der Box**, die Seite zeigt sie an; Zeitzone am Pi prüfen: `timedatectl`, ggf. `sudo timedatectl set-timezone Europe/Berlin`.
- **Auto-Aus:** Box fährt herunter (`systemctl poweroff`, dieselbe sudo-Freigabe), wenn die eingestellte Zeit nichts gespielt wurde. Als Aktivität zählt: Musik spielt auf der Box, **die Eltern-Seite ist geöffnet** (sonst würde sie mitten in einem Update ausgehen). Nach dem Einschalten bleibt die Box mindestens so lange an. Standard **aus**, 30 Min.
- **Geprüft ohne Hardware:** `software/test_automatik.py` (31 Tests, simulierte Uhr: Ausblenden, Ruhezeit über Mitternacht, Aussetzen, Auto-Aus, Neustart mitten im Timer, ungültige Eingaben; 13 eingebaute Fehler werden alle erkannt). Aufruf: `cd software && python3 -m unittest -v test_automatik`. Player mit simuliertem Leser (Karte in Ruhezeit startet nicht), Seite im Browser mit simuliertem `amixer` bedient (Regler, Timer, Schalter, Ruhezeit, Fehlermeldungen, hell/dunkel).
- **Am Pi noch zu prüfen:** (1) `amixer -M -c Headphones sget PCM` liefert Prozent, und der Regler klingt sinnvoll (Zuordnung Prozent zu Lautstärke am Gerät hören; Standardwerte 60 % max, 30 % Start sind Schätzwerte). (2) Gruppe `audio` für den Benutzer (setzt `dienst_einrichten.sh`, danach Dienste neu gestartet). (3) Zeitzone der Box. (4) Auto-Aus einmal mit kurzer Frist ausprobieren (10 Min, Seite schließen, nichts spielen).
- **Einrichtung:** Einmal `cd ~/peppa-box && git pull && sh software/dienst_einrichten.sh` (neue Gruppe `audio`); alternativ Update über die Seite, danach die Hinweiszeile beachten, die auf `dienst_einrichten.sh` verweist.
- **Offen / später:** Tailscale (HTTPS, unterwegs, echte Web-App), WLAN umschalten, apt-Update über die Seite, Touchfelder/Drehgeber/Ein-Taste (setzen dieselbe Lautstärke und denselben Timer, die Logik liegt jetzt in `lautstaerke.py`/`automatik.py`), Schreibschutz-Overlay (Einstellungen und Laufzeitdateien liegen dann außerhalb bzw. im RAM; `~/.config/peppa-box` muss beschreibbar bleiben).

## Nachtrag 27.10.2026 – Fehlerbehebung Eltern-Seite: Höchstlautstärke 100 % wurde nicht übernommen

- **Fehler:** Beim Öffnen von „Grenzen und Startlautstärke“ (und von „Ruhezeit einstellen“) lud die Seite die gespeicherten Werte nach und überschrieb das Formular. War die Box langsam (Pi unter Last), kam die Antwort, nachdem der Regler schon auf 100 % gezogen war; gespeichert wurden dann wieder die alten Werte, die Lautstärke blieb begrenzt. Auf einem schnellen Rechner kaum zu sehen, deshalb war es im Probelauf am 27.10. nicht aufgefallen.
- **Behebung (`software/web/index.html`):** Das Formular wird nur noch gefüllt, solange nichts darin verändert wurde (`geaendert`); es wird nicht mehr neu aufgebaut. Antworten, die vor einem Speichern angefragt wurden, werden verworfen (`stand`). Bei einem Fehler beim Speichern bleiben die Eingaben stehen. Dieselbe Absicherung für Lautstärke-Regler und Schalter: Hat jemand seit der Anfrage etwas bedient, werden die veralteten Werte nicht angezeigt.
- **Nachgestellt und geprüft** mit künstlich verzögerter Antwort (0,1 / 0,6 / 2 s): Ziehen während des Nachladens, anderes Formular öffnen bei ungespeicherten Änderungen, verspätete Antwort nach dem Speichern, echtes Ziehen mit der Maus bis 100 % mit Neuladen. Gesamte Bedienung (Regler, Timer, Schalter, Ruhezeit, Fehlermeldungen) ohne Konsolenfehler.
- **Regel für die Seite:** Werte, die der Benutzer gerade bearbeitet, nie durch nachladende Daten ersetzen; langsame Antworten sind am Pi der Normalfall.
- Hinweis zur Anzeige: Ist die Ruhezeit mit „leiser“ gerade aktiv, begrenzt sie den Regler unabhängig von der Höchstlautstärke; die Seite zeigt dann „höchstens X % (Ruhezeit)“.

## Nachtrag 27.10.2026 – Reichelt-Ersatz
- Reichelt liefert nicht. Touch-Modul jetzt **Adafruit 1982 (MPR121) bei Conrad, Bestell-Nr. 1516630**, 11,99 €. Produktbild zeigt die ältere Ausführung ohne STEMMA QT; welche geliefert wird, ist offen. Nach Lieferung Maße messen (Adafruit nennt 30 × 22 × 3 mm für die STEMMA-Ausführung) und Verteiler-Brücke (24 mm breit) anpassen.
- Klinke: Ersatz für Lumberg 1503-09 noch offen (Conrad: Einbaubuchse 3,5 mm stereo, Tafelmontage, mit Schaltkontakt). SpeaKa SP-1300376 (2 m, gerader Stecker) passt nicht: nur 20 mm hinter der Pi-Klinke. Kabel bleibt Goobay 67782 (90°) oder gleichwertig.
- Elko-Ersatz: BerryBase 1000 µF / 16 V, Ø 10 × 16 mm, RM 5 mm, 0,29 € (Conrad 445386 nicht lieferbar; Alternative Conrad 792067). 16 V statt 10 V gleichwertig. Beinlänge auf der Produktseite nicht eindeutig; für die Hebelklemmen werden ca. 11 mm gebraucht.
- Warenkörbe 27.10. (Stand Jan, noch nicht bestellt): **Conrad** STEC11B03 (700697), Adafruit 1982 (1516630), Lumberg 1503 09 (738813), Visaton FRS 8 4 Ω (300293). **BerryBase** Goobay 67782, 3 × Elko 1000 µF/16 V, 3 × WAGO 221-413, 2 × WAGO 221-415, Soldered USB-C Breakout (SOL-333011), 4 × 5,1 kΩ (CC1/CC2 nach GND). Fehlen noch: 2 × Kurzhubtaster 12 × 12 × 7,3 (BerryBase KHT1212PV73), Schrumpfschlauch, Kunststoffschrauben 3,0 mm, Montageband.
- **USB-C (Entscheidung 27.10.):** Statt Einbau-Verlängerung Jans vorhandenes USB-C-Kabel mit 90°-Stecker (passt hinter dem Akku-Board) halbieren, rote/schwarze Ader an Soldered-Breakout (22 × 22 mm, 2 Befestigungslöcher) in der Rückwand, 2 × 5,1 kΩ an CC. Akku-Board lädt nur mit 5 V (Waveshare-Wiki), daher reichen VBUS/GND. Modell: rundes Einbauloch durch Schlitz + Halter mit 2 Domen ersetzen, Maße nach Lieferung.
- **WAGO 221-413/-415** statt 221-423/-425: andere Bauform, Mulden nach Messen anpassen.

## Nachtrag 27.10.2026 – Deckel-Probedruck ausgewertet (Symbole, RC522-Halter)

- **Befund Deckel (einfarbig, 0,28 mm Extra Draft):** Bei vor/zurück lagen die Dreiecke auf der Ringnut (Ecken 0,06 mm von der Nut entfernt) und wurden angeschnitten. Mond unscharf, unruhige Oberfläche, Pickel an den Ringen, eine Kratzspur vom Kartenschlitz nach vorne (Fahrweg ohne Z-Hop).
- **Symbole neu (`pad_symbols`):** Jedes Symbol wird auf mindestens `SYM_GAP` = 1,8 mm Abstand zur Nut verkleinert (`_fit`), vor/zurück als zwei um 30 % überlappende Dreiecke (eine Fläche, kein dünner Steg), alles schmaler als `SYM_MIN` = 0,9 mm wird abgerundet (Mondspitzen, Ecken). Abstände jetzt: vor/zurück 2,2 mm, Play 3,2 mm, Mond 2,1 mm. Neue Prüfung in `check.py`.
- **`SKIN` 0,7 → 0,8 mm:** liegt jetzt auf dem Schichtraster (4 × 0,2 oder 5 × 0,16); Symbole sind 0,8 mm tief. Kunststoff über dem Kupfer: 4 mm, unter den Symbolen 3,2 mm.
- **Einfarbiger Deckel** `02_deckel_einfarbig.stl` wird jetzt von `build_all.py` erzeugt (`deckel(einfarbig=True)`, ein Körper statt Vereinigung). Dabei gefunden: `offset` erzeugte doppelte Punkte im Mond → nicht dichtes STL; behoben mit `simplify`. Alle STL geprüft: dicht.
- **RC522-Halter, Befund:** Die Steckkabel stießen an den hinteren Schraubblock des Deckelrahmens (x 116, Modell: 0,9 mm). Der Quarz liegt an der deckelseitigen Platinenkante nahe der Stiftleiste und lief gegen die Lippe der Schiene.
- **Behebung:** RC522 sitzt `RC_DROP` = 5 mm tiefer (weg vom Deckel). Nicht seitlich verschoben: Der Block liegt über den Steckern, seitlich bräuchte es über 20 mm und die Antenne käme weit vom NFC-Aufkleber weg. Antennenmitte liegt jetzt ca. 5 mm unter der Aufklebermitte → **Lesetest nach dem Druck**. Schraubblöcke hinten am Deckelrahmen enden 2 mm höher (`LS_BLOCK_Z0` 119, 3,2 mm Wand unter dem Kernloch). Deckelseitige Schiene: Lippe auf den letzten `RC_XTAL_FREE` = 18 mm vor dem Stiftleisten-Ende entfernt (Quarz laut Foto ca. 12 mm lang).
- Abstand Stecker ↔ Schraubblock: 3,7 mm (nur neues Kartenfach mit altem Rahmen: 2,1 mm). Kartenfach-Unterkante 81,8 mm, 4,8 mm über den Klemmen (vorher 9,8). Zum Tasterhalter bleiben seitlich 0,8 mm wie bisher (oberster Stecker).
- Die rechte Kartenfach-Schraube liegt direkt am Platinenende: erst Kartenfach verschrauben, dann RC522 einschieben.
- **Offen (messen):** Lage der Stiftleiste auf der RC522-Platine (deckelseitige Kante bis Mitte SDA-Stift; Modell nimmt mittig an, `RC_HDR_OFF`) und Länge des Quarzes ab Stiftleisten-Kante.
- **Druck Deckel (Empfehlung):** 0,2 mm (oder 0,16), mindestens 5 obere Schichten, „Nur eine Wand auf oberen Flächen“, Bügeln nur oberste Fläche, Z-Hop 0,4 mm, „Wände nicht kreuzen“, Oberflächen langsamer. Deckel mit 100 % Füllung (massiv ca. 125 g PETG): kein Durchzeichnen über den Taschen, gleichmäßigere Touchfelder. Für den endgültigen zweifarbigen Deckel als Option: kopfüber drucken mit bündig eingelegten Symbolen (glatteste Oberfläche) – noch nicht entschieden.
- **Touchfelder (Foto Unterseite):** Lage passt zum Modell. Die Taschendecken sind gebrückt und etwas rau; Kupferband trotzdem fest andrücken. Kupferband (BerryBase, 5 mm) steht in der Einkaufsliste, fehlt aber im BerryBase-Warenkorb vom 27.10. MPR121-Mulde (25,6 × 20,6 mm innen) passt nicht, falls die STEMMA-Ausführung (30 × 22 mm) kommt → nach Lieferung messen.
- **Zu drucken:** `04_kartenfach.stl` (zuerst, mit vorhandenem Rahmen testen), `02_deckel_einfarbig.stl` mit den Einstellungen oben; `03_deckelrahmen.stl` erst beim endgültigen Druck nötig.

## Nachtrag 27.10.2026 – Deckel kopfüber, Karte mit Einschub-Cover

- **Entscheidung:** Symbole bleiben ertastbar (0,8 mm vertieft). Für eine glatte Oberseite wird der Deckel **kopfüber** gedruckt (Oberseite auf dem texturierten PEI der Wendeplatte, nicht auf der glatten PLA-Seite). Die Böden der Symbolvertiefungen werden dabei als kurze Brücken gedruckt. Vorher Probe mit Coupon C9.
- **Modell Deckel:** 0,5-mm-Fase an der Oberkante (`LID_EDGE_CH`, gegen Elefantenfuß), Einführfase 0,6 mm am Kartenschlitz (`SLOT_CH`), Mulde der Ein-Taste mit 45°-Wand (Boden Ø 17 statt 20), Tastenloch endet unter einer **Opferschicht 0,2 mm** am Muldenboden (`BTN_MEMBRANE`) → nach dem Druck mit dem Cutter ausschneiden. Taschen für das Kupferband sind kopfüber oben offen (flacher Boden statt Brücke). Hilfsfunktion `deckel_kopfueber()` (Drehung, keine Spiegelung).
- **Coupon C9** (einfarbig, schon kopfüber ausgerichtet): `coupon_C9_deckel_kopfueber_felder.stl` (Ecke vorne rechts: Play, Vor, Kante, Kupfertaschen) und `coupon_C9_deckel_kopfueber_taste_schlitz.stl` (Ein-Taste mit Opferschicht, Ende des Kartenschlitzes, Kante). Slicer: Elefantenfuß-Kompensation ca. 0,15 mm, erste Schicht sauber, Platte vorher mit Spülmittel waschen. Die Deckel-STL liegen weiter mit der Oberseite nach oben; nach erfolgreichem C9 auf kopfüber umstellen.
- **Karte mit Einschubtasche** (`10_karte_orange.stl`, `karte_print()`): Cover auf Papier statt Aufkleber, wird von oben eingeschoben. Rahmen links, rechts, unten mit Lippen, deren Unterseite 45° geneigt ist (Schwalbenschwanz) → Druck **Rückseite unten** ohne Stützen, Vorderseite oben (bügeln). Einleger **67 × 68 mm**, sichtbares Fenster 64,6 × 67 mm. Spalt an der Außenwand `INS_GAP` 0,6 mm (Probedruck), Taschenboden 1,3 mm dick. Griffmulde R 7 oben Mitte in der Rückwand (Cover von vorn und hinten greifbar). NFC-Tasche jetzt an der Plattenseite (Decke Ø 25,6 als Brücke). Obere Ecken R 1,5 (Tasche muss gerade bis zur Kante laufen); die schräge Ecke oben rechts entfällt, die Richtung zeigt jetzt das Cover. Kartenstärke und Steckteil unverändert, Kollisionsprüfung jetzt mit der echten Karte.
- Empfehlung Cover: Farbdruck auf normalem Papier, laminieren (stabiler, abwischbar, ca. 0,25–0,35 mm), danach auf 67 × 68 mm schneiden.
- **Am Probedruck prüfen:** Spiel des Covers (fällt es heraus, wenn die Karte kopfüber gehalten wird?), Steifigkeit der Karte oben (1,3 mm hinter dem Cover), Lesen durch die neue Kartenrückseite.
- **Idee für später:** Druckvorlage für Cover auf der Eltern-Seite (Cover-Bild per Spotify Web API zur Karte holen, A4 mit Schnittmarken in Einlegergröße).

## Nachtrag 31.10.2026 – Lautsprecher (MAX98357A) eingerichtet

- Verstärker angeschlossen, `dtoverlay=hifiberry-dac` von Jan in `config.txt` ergänzt, `speaker-test` über die hifiberry-Karte erfolgreich.
- **Neu `software/lautsprecher_einrichten.sh`** (wird von `dienst_einrichten.sh` aufgerufen, wiederholbar): ergänzt in `config.txt` `dtoverlay=hifiberry-dac` und `gpio=16=ip,pn` (SD/stumm als Eingang ohne Pull, sonst zieht der Pi den Pin nach unten), nur wenn `config.txt` mit `[all]` endet; sucht die Karte in `/proc/asound/cards` (Name mit „hifiberry“, nicht angenommen); legt in `/etc/asound.conf` einen eigenen Block (Markierungen `# >>> / <<< peppa-box lautsprecher`) mit softvol `lautsprecher`, Regler `Lautsprecher` an; stellt Raspotify auf `LIBRESPOT_DEVICE="lautsprecher"` um; legt den Regler beim ersten Mal an (1 s Stille) und stellt ihn auf 30 %, `alsactl store`.
- **`lautstaerke.py`:** Ausgang `lautsprecher` = gesuchte hifiberry-Karte + Regler `Lautsprecher`. Gilt als eingerichtet, sobald Karte und Regler da sind (sonst alle 30 s neu geprüft). Damit gelten Eltern-Seite, Höchst-/Startlautstärke (Standard 70/40 %), Timer und Ruhezeit für den Lautsprecher.
- **Folge bis zur Kopfhörer-Erkennung (Pin 37):** Die Pi-Klinke ist stumm, alles läuft über den Lautsprecher. Zurück auf die Klinke: in `/etc/raspotify/conf` `LIBRESPOT_DEVICE="plughw:CARD=Headphones,DEV=0"`.
- Update-Hinweis der Eltern-Seite erscheint jetzt auch bei Änderungen an `lautsprecher_einrichten.sh`.
- Geprüft ohne Hardware: `software/test_lautsprecher.py` (11 Tests: Kartensuche, Regler fehlt, spätere Einrichtung, Skript mit nachgebauten Systemdateien, zweiter Lauf ändert nichts, Abbruch ohne `[all]`, Raspotify ohne Device-Zeile); `test_automatik` weiter grün.
- **Am Pi einmal ausführen:** Update über die Eltern-Seite, dann per SSH `sh ~/peppa-box/software/dienst_einrichten.sh`. Root-Änderungen (config.txt, asound.conf, Raspotify) gehen bewusst nicht über die Seite, weil sie ohne Passwort erreichbar ist.
- **Am Pi noch zu prüfen:** Karte auflegen → Ton aus dem Lautsprecher; Regler der Eltern-Seite wirkt; nach Neustart nicht stumm (GPIO 16); Prozentwerte klingen sinnvoll.
- **Erster Lauf am Pi (31.10.):** Karte `sndrpihifiberry` gefunden, softvol und Regler angelegt, `gpio=16=ip,pn` ergänzt. Raspotify wurde **nicht** umgestellt: Das Skript prüfte `/etc/raspotify/conf` ohne sudo (Datei nur mit sudo lesbar) und hielt sie für nicht vorhanden. Behoben mit `sudo test -f`. Regel: Dateien unter `/etc/raspotify/` immer mit sudo prüfen und lesen.

## Nachtrag 02.11.2026 – Lautsprecher läuft sauber (Fehlersuche Kratzen)

- **Befund:** Mit Verstärker an 5 V/GND direkt auf den gelben Stiften (Pin 2/6, Steckkabel 35 cm), ohne Elko: kein Ton oder starkes Kratzen, Ton nur beim Berühren eines Kontakts (Daumen, Messspitze) oder Zusammendrücken des Kabelbündels. Zweiter, neu gelöteter MAX98357A zeigte dasselbe → Verstärker und Lötstellen nicht die Ursache. Gemessen in Ordnung: 5,2 V am Aufsatz und am Verstärker, BCLK/LRC ≈ 1,6 V, SD > 0,2 V, Lautsprecher 4 Ω.
- **Behebung:** **Elko 1000 µF / 16 V** wie geplant in die WAGO 5 V / GND A, Rot (VIN) und Braun (GND) dafür ca. 10 cm vor dem Verstärker getrennt und über die WAGO geführt. Danach Musik sauber. Signalleitungen BCLK/LRC/DIN/SD unverändert (35 cm, direkt auf den gelben Stiften P18/P19/P21/P16) – Länge ist also kein Hindernis; für den Einbau trotzdem kürzer (≤ 15 cm).
- **Zwischenfehler:** Dünne, unverzinnte Steckkabel-Litze hatte in der WAGO keinen Kontakt (Litze an der Feder vorbei). **Regel:** Steckkabel-Litze für WAGO (min. 0,14–0,2 mm² laut Hersteller) 11 mm abisolieren, doppelt falten, verdrillen, verzinnen, bei offenem Hebel bis Anschlag, Zugtest, Durchgang prüfen.
- **Hinweise:** Die 5,1-kΩ-Widerstände aus der BerryBase-Bestellung sind für USB-C (CC), nicht für Signalleitungen. Lautsprecheranschlüsse des MAX98357A nie mit GND verbinden (Brückenausgang). Mehrzeilige Befehle per SSH einzeln einfügen (sonst werden Zeilen von der sudo-Passwortabfrage verschluckt).
- **Noch offen:** Lautsprecher-Regler der Eltern-Seite und Höchstlautstärke (70 %) am Gerät hören; Raspotify startet nach dem Einschalten vor dem WLAN (Fehlstart ca. 20 s, Neustart durch systemd) → auf `network-online` warten lassen.
- **Lauter (02.11.):** MAX98357A **GAIN an GND** (WAGO GND A bzw. freier GND-Stift) → 12 dB statt 9 dB (+3 dB), Jan gefällt es so. 15 dB (100 kΩ nach GND) bewusst nicht: bei 5 V übersteuert der Verstärker schon mit 12 dB an lauten Stellen; bei Verzerrung Höchstlautstärke auf der Eltern-Seite auf ca. 85–90 % senken. Belastbarkeit des Visaton FRS 8 noch prüfen (MAX liefert an 4 Ω/5 V max. ca. 3 W). Verdrahtungsplan nachgeführt (GAIN-Verbindung, WAGO GND A).
- **Raspotify wartet auf das Netz (02.11.):** `dienst_einrichten.sh` legt `/etc/systemd/system/raspotify.service.d/peppa-netz.conf` an (`Wants=`/`After=network-online.target`, `RestartSec=3`) und aktiviert `NetworkManager-wait-online`, falls vorhanden. Grund: Raspotify startete vor dem WLAN („could not initialize spirc: Service unavailable“), Neustart erst ca. 23 s später. Wirkt ab dem nächsten Einschalten. **Am Pi prüfen:** nach `sudo reboot` `journalctl -b -u raspotify --no-pager | head` (kein Fehler mehr) und `systemd-analyze blame | head` (wie lange `NetworkManager-wait-online` braucht).

## Nachtrag 02.11.2026 – Signaltöne
- **Startton** (zwei aufsteigende Töne E5–A5): neuer Dienst `peppa-startton` (oneshot, nach `sound.target`/`alsa-restore`, vor dem WLAN). Setzt vorher die Startlautstärke (gleiche Logik wie der Player, einmal je Einschalten), wenn der Lautsprecher-Regler schon da ist; sonst macht es später der Player.
- **Bereit-Ton** (drei helle Töne C6–E6–G6): spielt der Player, sobald Spotify die Box kennt – nicht schon beim WLAN, weil erst dann eine Karte Musik starten kann. Einmal je Einschalten (Markierung in `/dev/shm`), also nicht nach Updates oder „Musik neu starten“.
- Beide Töne: `software/toene.py`, nur Standardbibliothek, WAV im Arbeitsspeicher erzeugt, Pegel 35 % der Vollaussteuerung, über den aktiven Ausgang. In der Ruhezeit mit Modus „keine Musik“ still. Fehler beim Abspielen werden protokolliert und halten nichts auf. Von Hand: `python3 ~/peppa-box/software/toene.py start` bzw. `bereit`.
- Geprüft ohne Hardware: `test_toene.py` (8 Tests). **Am Pi prüfen:** beide Töne nach dem Einschalten hörbar; Zeitpunkte mit `journalctl -b -u peppa-startton -u peppa-player --no-pager -o short-monotonic | head -30`.
- Offen/Idee: Fehlerton, wenn nach ca. 60 s kein WLAN/Spotify.
- **Änderung (02.11., ersetzt die Signaltöne oben):** Keine Pieptöne mehr. Stattdessen die Ansage **„Peppa Box bereit – viel Spaß“** (Stimme „Helmut“, von Jan mit ElevenLabs erzeugt), sobald eine Karte Musik starten kann – also wenn Spotify die Box kennt, einmal je Einschalten, über den aktiven Ausgang in der Startlautstärke. Datei `software/ansagen/peppa_box_bereit.wav` (aus Jans MP3: Ende ab 2,62 s abgeschnitten, 80 ms ausgeblendet, Spitze −3 dBFS, 150 ms Stille vorne gegen Verschlucken beim Aufwachen des Verstärkers, 44,1 kHz mono). Startton-Dienst entfernt; `dienst_einrichten.sh` räumt einen schon eingerichteten `peppa-startton` wieder ab. Test von Hand: `python3 ~/peppa-box/software/toene.py bereit`. Tests: `test_toene.py` (6).

## Nachtrag 02.11.2026 – Kurzhubtaster KHT1212PV73 geprüft

- Geliefert: BerryBase KHT1212PV73, 12 × 12 mm, H 7,30 mm (Etikett), Stößel 3,8 × 3,8 mm (Shopangabe). Hub steht nirgends, bei 12 × 12 üblich 0,25–0,3 mm (nicht belegt).
- Modell v4 ist schon seit 25.10. auf genau diesen Taster ausgelegt (`SW` 12, `SW_H` 7,3; jetzt Status „belegt“ statt „vorläufig“). Die alte Angabe „DTS-24R“ in der Hardwareliste ist ersetzt.
- Kette in Ruhe: Kragen der Kappe liegt unter dem Deckel an, Stößel Ø 5 endet 0,05 mm über dem Taster. Beim Drücken bleiben bis zum Anschlag am Trichter 0,52 mm, also ca. 0,2 mm Reserve über dem Schaltweg. Die Taschenwand fängt kräftiges Drücken nicht ab, der 3-mm-Halterboden trägt.
- Einbau: Beinchen nach links/rechts (Schlitz 14 × 7 mm läuft in x). Um 90° gedreht passen die Beinchen nicht durch. Anschluss diagonal (zwei gegenüberliegende Ecken), dann ist die Belegung egal.
- Toleranz: Ist der Taster 0,2 mm niedriger als 7,3, schaltet er knapp oder gar nicht. Ausgleich nur über die Kappe (`PLUNGER_L`), Rahmen bleibt. Höhe mit dem Messschieber nachmessen; Coupon C3 (Halter, Kappe, Deckelstück) zeigt es am Druck.

- **Nachtrag 02.11. (2):** Jan misst über die Beinchen ca. 13 mm (`SW_LEGS`, gemessen). Die Tasche war nur 12,4 mm breit, der Taster ging mit Beinchen nicht von oben hinein. Neu: Beinchen-Kanal 14 × 7 mm (`SW_LEG_CLR` 0,5 je Seite) über die ganze Taschenhöhe bis unten durch den Halterboden. Die Tasche bleibt sonst 12,4 × 12,4 und führt den Taster an den Ecken. Seitenwand des Halters jetzt 2,3 mm. Lage und Höhe des Tasters unverändert → Kappe (`08_ein_taste_orange.stl`) bleibt gleich. Neu gebaut: `03_deckelrahmen.stl`, `coupon_C3_taste_halter.stl`; Prüfungen ohne Kollision.

## Nachtrag 02.11.2026 – Box nach einer Weile nicht mehr erreichbar
- Befund Jan: Musik läuft, aber `peppabox.local` (Eltern-Seite, SSH) nach einiger Zeit nicht mehr erreichbar. Vermutete Ursache: Stromsparmodus des WLAN-Chips (brcmfmac) – eingehende Anfragen bleiben liegen, ausgehende Verbindungen (Spotify) laufen weiter. Noch am Pi bestätigen: `iw dev wlan0 get power_save` (vorher „on“).
- `dienst_einrichten.sh` legt `/etc/NetworkManager/conf.d/peppa-wlan-stromsparen-aus.conf` an (`wifi.powersave = 2`, dauerhaft ab dem nächsten Einschalten) und schaltet es sofort mit `iw dev wlan0 set power_save off` ab (ohne die Verbindung neu aufzubauen). Etwas mehr Stromverbrauch im Leerlauf; Akkulaufzeit beobachten.

## Nachtrag 02.11.2026 – Knacken beim Abspielbeginn
- Befund: Lautes Knacken bei jedem Abspielbeginn (Karte, Ansage). Ursache: In Pausen stoppt der Pi den I2S-Takt, der MAX98357A schaltet ab und springt beim nächsten Ton hart wieder an.
- **Lösung (in `lautsprecher_einrichten.sh`):** Mischer `peppa_dmix` (44,1 kHz, S16_LE, `ipc_perm 0666`) → `peppa_plug` → softvol `lautsprecher` (Regler wie bisher). Neuer Dienst **`peppa-stille`** spielt dauerhaft Stille in den Mischer; Spotify und Ansage werden dazugemischt, der Takt reißt nie ab.
- **Gegen das Knacken beim Ein-/Ausschalten:** `config.txt` jetzt `gpio=16=op,dl` (SD beim Start low = stumm; ersetzt `ip,pn`). `peppa-stille`: vor dem Start SD low, Stille starten, 0,5 s später SD frei (Eingang ohne Pull); beim Stoppen erst SD low, dann Stille aus. Raspotify bekommt `PrivateIPC=no` (Zusatzdatei `peppa-ipc.conf`), damit es den Mischer mitbenutzen kann. Skript macht am Ende eine Probe (zweites Programm spielt neben der Stille).
- Nebenwirkung: Verstärker dauerhaft an (laut Hersteller wenige mA Ruhestrom), etwas CPU für die Stille. Akkulaufzeit beobachten.
- Geprüft ohne Hardware: ALSA liest die Konfiguration fehlerfrei (`aplay -L`), `test_lautsprecher.py` angepasst (12 Tests). **Am Pi prüfen:** kein Knacken bei Karte/Ansage, beim Einschalten, beim Ausschalten; `systemctl status peppa-stille`.

## Nachtrag 02.11.2026 – Startzeit
- Messung (`systemd-analyze`, Neustart 21:50): Kernel 4,2 s + Userspace 47,0 s; Ansage „bereit“ bei ca. 57 s. Kritischer Pfad: cloud-init (main 3,55 s + local 0,76 s + network 0,27 s) → NetworkManager 14,8 s → NetworkManager-wait-online 19,1 s → network-online bei ca. 50 s → Raspotify → Player (fragte nur alle 5 s).
- Umgesetzt: `dienst_einrichten.sh` schaltet **cloud-init** ab (`/etc/cloud/cloud-init.disabled`, nur für den ersten Start mit dem Imager nötig; rückgängig durch Löschen der Datei). Player fragt Spotify in der ersten Minute **jede Sekunde** statt alle 5 s.
- **Offen, größter Posten:** WLAN-Aufbau (NetworkManager + wait-online ≈ 34 s). Nächster Schritt: `journalctl -b -u NetworkManager -o short-monotonic` ansehen (Suche, Anmeldung, DHCP, IPv6?).
- **Fehler durch cloud-init-Abschalten (02.11., 22:00):** Nach dem Neustart kam die Ansage (WLAN/Spotify ok), aber weder `peppabox.local` noch `raspberrypi.local` waren erreichbar. Vermutete Ursache: cloud-init setzte den Rechnernamen bei jedem Start; ohne cloud-init fehlt er (Bestätigung mit `hostnamectl` am Pi steht aus). Zugang über IP aus dem Router (Pi-MAC beginnt mit B8:27:EB), dann `sudo hostnamectl set-hostname peppabox`, `127.0.1.1 peppabox` in `/etc/hosts`, `avahi-daemon` neu starten.
- `dienst_einrichten.sh` schreibt den Namen jetzt **vor** dem Abschalten fest (`hostnamectl`, `/etc/hosts`; „localhost“/„raspberrypi“/leer → „peppabox“) und läuft auch bei schon abgeschaltetem cloud-init. **Regel:** Systemdienste, die beim Start etwas setzen, erst abschalten, wenn geprüft ist, was sie setzen.
- **Korrektur, eigentliche Ursache (02.11., 22:06):** Name war nie weg (`hostnamectl`: peppabox; Speedport zeigt „peppabox“, 192.168.2.223). Avahi-Protokoll: „Host name conflict, retrying with peppabox-2“ nach Neuaufbau der WLAN-Adressen (v. a. IPv6) → Box hieß **peppabox-2.local**. Bekannter Avahi-Selbstkonflikt auf dem Pi; vermutlich auch die Ursache der früheren „nach einer Weile nicht erreichbar“-Fälle (WLAN-Stromsparen-aus bleibt trotzdem drin).
- `dienst_einrichten.sh` setzt in `/etc/avahi/avahi-daemon.conf` `use-ipv6=no` und `allow-interfaces=wlan0` und startet Avahi neu. Sofortmaßnahme bei Auftreten: `sudo systemctl restart avahi-daemon`. Notzugang immer über IP (Speedport → Heimnetz). Tipp: im Speedport feste IP für die Box einstellen.
- **WLAN-Aufbau analysiert (02.11., 22:16):** Anmeldung am Speedport dauert 0,4 s, DHCP 3 s – das WLAN ist nicht das Problem. Die Zeit geht **vorher** verloren: NetworkManager ruft beim Start viermal `netplan generate` auf (je ca. 3,4 s, 13,5 → 27,5 s). Netplan stammt vom Imager/cloud-init (`/etc/netplan/90-NM-*.yaml`, Verbindung `netplan-wlan0-…`; außerdem eine überflüssige `netplan-eth0`, der Pi 3A+ hat kein LAN).
- **Neu `software/wlan_beschleunigen.sh`** (bewusst von Hand, nicht über `dienst_einrichten.sh`): übernimmt SSID und Passwort der laufenden Netplan-Verbindung auf dem Pi in `/etc/NetworkManager/system-connections/peppa-wlan.nmconnection` (0600, Passwort wird nie angezeigt, nicht im Repository), verschiebt `/etc/netplan/*.yaml` nach `/etc/netplan.peppa-sicherung`, richtet `peppa-wlan-rueckfall` ein (`wlan_rueckfall.sh`: ohne WLAN nach 120 s → Netplan-Zustand zurück, NetworkManager neu starten). Rückweg: `sh wlan_beschleunigen.sh --zurueck` + Neustart. Tests: `test_wlan.py` (5). **Am Pi:** ausführen, `sudo reboot`, Startzeit erneut messen.

## Nachtrag 02.11.2026 – USB-C-Breakout
- Soldered-Breakout geliefert (mit beiliegender 8er-Stiftleiste). **Stiftleiste wird nicht eingelötet:** Kabeladern direkt in die Lötaugen (weniger Lötstellen, kein Steckkontakt im Ladestrom, flacher in der Rückwand).
- Messung Jan (Multimeter Ω, CC1–GND): **O.L** → keine CC-Widerstände auf der Platine. Die 2 × 5,1 kΩ (CC1 → GND, CC2 → GND) werden eingelötet. Belegung: VBUS = rote Ader, GND = schwarze Ader, D+/D−/SBU1/SBU2 frei.
- **Offen:** CC2–GND ebenfalls messen; nach dem Löten Lochabstand der 2 Befestigungslöcher und Buchsenhöhe über der Platine messen → Halter in der Rückwand.
- **Ergebnis am Pi (02.11., 22:30):** `wlan_beschleunigen.sh` läuft, Box im WLAN. NetworkManager 4,9 s (vorher 14,8 s), Ansage „bereit“ bei **40,6 s** (vorher ca. 57 s). `peppa-wlan-rueckfall` 20,6 s ist nur seine Warteschleife bis zur WLAN-Verbindung (läuft parallel, bremst den Player nicht). Verbleibend: NetworkManager-wait-online 19,3 s – noch unklar, ob WLAN-Chip/Treiber oder Suche; nächster Blick: NetworkManager-Protokoll dieses Starts.
- **Eltern-Seite nicht erreichbar, SSH schon (02.11., 22:55):** Avahi in Ordnung (`use-ipv6=no`, `allow-interfaces=wlan0`, kein Umbenennen), WLAN-Stromsparen aus. Vermutete Ursache: Die Seite lauschte nur auf IPv4 (`0.0.0.0`), der Windows-PC spricht die Box per IPv6 an (Anmeldung „from 2003:…“), und mit der neuen WLAN-Verbindung hat sich die IPv6-Adresse geändert. **`peppa_web.py` lauscht jetzt auf IPv6 und IPv4** (`::`, `IPV6_V6ONLY=0`; ohne IPv6 Rückfall auf IPv4). In der Arbeitsumgebung nur der IPv4-Rückfall testbar (dort kein IPv6). Notzugang zur Seite: `http://<IP>` (z. B. 192.168.2.223). **Am Pi bestätigt (22:57): Seite wieder erreichbar.**

## Offener Punkt (02.11.2026): WLAN wechseln unterwegs – Konzept, Umsetzung später (Entscheidung Jan)
- **Problem:** Am Urlaubsort kennt die Box kein WLAN → offline → Eltern-Seite nicht erreichbar.
- **Baustein 1 – WLAN-Verwaltung auf der Eltern-Seite:** gespeicherte WLANs anzeigen/hinzufügen/löschen, „WLANs in der Nähe suchen“, Passwort eingeben; sicherer Wechsel (klappt das neue WLAN nicht in ca. 60 s → zurück ins alte). Neue WLANs als NetworkManager-Keyfile schreiben (nicht über `nmcli connection add`, das legt wieder Netplan-Dateien an → langsamer Start). Rechte: kleines Hilfsprogramm über die bestehende sudo-Freigabe.
- **Baustein 2 – Handy-Hotspots von Jan und seiner Frau** zu Hause vorab eintragen: unterwegs Hotspot an → Box verbindet sich → Eltern-Seite übers Handy → Hotel-/Ferien-WLAN eintragen → Hotspot aus.
- **Baustein 3 – Notfall-WLAN der Box** („Peppa Box Einrichtung“, mit Passwort), wenn nach ca. 90 s kein bekanntes WLAN: Handy verbinden, Einrichtungsseite, WLAN wählen. WLAN-Chip kann AP-Modus (NetworkManager-Protokoll).
- Grenzen: WLANs mit Anmeldeseite (Hotels) gehen nur über den Handy-Hotspot.
- **Vorher reparieren:** `peppa-wlan-rueckfall` würde ohne bekanntes WLAN (Urlaub) nach 120 s die Netplan-Sicherung zurückholen und `peppa-wlan` löschen (nicht gefährlich, Heim-WLAN bleibt, aber Start wieder langsam). Soll sich nach dem ersten erfolgreichen Start abschalten.
- Empfehlung: erst Baustein 1+2, danach 3.

## Nachtrag 02.11.2026 – USB-C-Buchse und Ladeanzeige
- USB-C-Breakout (Soldered) eingebaut: an der Platine 4,95 V, GND-Durchgang zum Stecker ok, **blaue LED am Akku-Board leuchtet** (laut Waveshare-Wiki UPS HAT (D): blau an = lädt, aus = voll, blinkt = Fehler). Buchse damit sehr wahrscheinlich in Ordnung. Netzteil: Notebook-USB-C-Netzteil (5-V-Angabe noch ablesen).
- `akku.py` zeigt mit Netzteil trotzdem „akku“ (shunt −6,48 mV über die Buchse, −4,47 mV direkt; Akku 4,14–4,15 V ≈ 95 %). Waveshare: negativ = Akku gibt Strom ab (Laststrom), positiv = Ladestrom. Vermutung (nicht belegt): Bei fast vollem Akku lädt das Board nur noch wenig nach, Pi + Verstärker ziehen mehr → unterm Strich negativ. **Die Ladeanzeige der Eltern-Seite ist also bei fast vollem Akku irreführend.**
- **Offen:** Test bei ca. 60 % Akku mit Netzteil in der Buchse (`shunt_mv` positiv erwartet). Danach Anzeige überarbeiten; möglich: prüfen, ob das zweite I2C-Gerät des Boards (0x2D) einen Ladezustand liefert (nicht belegt, erst nachsehen).

## Nachtrag 02.11.2026 (3) – Ein-Taste bündig, Mulde entfällt

- Befund am Druck: Kappe und Taster passen genau, Ringspalt gut. Die Mulde um die Taste wirkt billig.
- Neu: **keine Mulde mehr**. Die Kappe endet **bündig** mit der Deckeloberfläche (`BTN_FLUSH` 0), sichtbar bleibt nur der Ringspalt 0,25 mm je Seite (`BTN_GAP`, wie gedruckt). Oberkante der Kappe mit Fase 0,3 mm (`BTN_TOP_CH`).
- Bohrung geht glatt bis zur Oberfläche. Beim Druck kopfüber liegt die Öffnung auf der Platte → keine Brücke, **Opferschicht entfällt** (`DISH_D`, `DISH_DEPTH`, `DISH_WALL`, `BTN_MEMBRANE` gelöscht). Elefantenfuß-Kompensation (ca. 0,15 mm) bleibt wichtig, sonst wird das Loch an der Oberfläche enger.
- Unter dem Deckel unverändert: Kragen, Stößel, Tasterhalter, Schaltweg. Die Kappe ist oben 1,5 mm länger. Neu gebaut: `02_deckel_einfarbig`, `02a`, `02b`, `08_ein_taste_orange`, Coupons C2 (Deckel), C3 (Deckelstück, Kappe), C9; Schnitt `ein_taste_schnitt.png`. Prüfungen ohne Kollision.
- Folge: Die Mulde schützte gegen versehentliches Drücken. Ausgleich in der Software: Ausschalten erst nach ca. 2 s Halten, kurzes Drücken nur Wecken/Anzeige.

## Nachtrag 03.11.2026 – Kein Ton trotz erkannter Karte (Fehlersuche läuft)
- Befund Jan (19:00): Karte wird erkannt, Player schickt den Startbefehl, Spotify antwortet **502 „Bad gateway“** (Spotify erreicht die Box nicht). Vorher mehrere Karten schnell hintereinander gewechselt. Auch nach „Musik neu starten“ und Neustart kein Ton. In der Spotify-App ist „Peppa Box“ auswählbar, springt aber sofort auf Pause → Raspotify/librespot spielt nicht (Verdacht: Audio-Key-Fehler, Anmeldung oder Ausgang `lautsprecher` nicht zu öffnen). Raspotify-Protokoll steht noch aus.
- Eltern-Seite: „Letzte Meldungen“ zeigt jetzt auch `raspotify` und `peppa-stille` (100 Zeilen) und springt automatisch ans Ende (neueste Meldung unten). Update über die Seite, kein SSH nötig.
- Geplant: Player fasst schnelle Kartenwechsel zusammen (nur letzter Befehl) und startet Raspotify bei 502 selbst neu.

## Nachtrag 03.11.2026 – Selbstreparatur Spotify (Player-Umbau)
- **Ziel (Jan):** Das Kind darf nie Fehler beheben müssen; alles abfangen, ohne Komforteinbußen.
- **Neu `software/steuerung.py`** (eigener Faden im Player): Kartenleser meldet nur noch den Wunsch (spielen/Pause) und wartet nie auf das Netz. Die Steuerung setzt immer nur den neuesten Wunsch um und **prüft nach jedem Start** über `GET /me/player`, ob auf dieser Box ein Titel läuft und die Position vorrückt (zwei Proben, 2 s Abstand, höchstens 4).
- **Reparatur-Leiter:** 1. kurz wiederholen bzw. sofort frisch abspielen (statt Fortsetzen), 2. Raspotify neu starten (vorher `peppa-stille` neu, falls der Mischer nicht läuft), 3. mit wachsendem Abstand weiter (2 s … 5 min), solange die Karte liegt. Raspotify-Neustart höchstens alle 120 s. 401 → Token erneuern, 429 → Retry-After, Netz weg → warten (kein Neustart). Gerät fehlt bei liegender Karte 45 s bzw. im Leerlauf 180 s → Raspotify neu.
- **Absturz-Wache:** Startzeit von Raspotify (systemd, lokal, alle 5 s). Neustart während Musik und liegender Karte → Wiedergabe an derselben Stelle übertragen, sonst frisch abspielen.
- **Schnelle Kartenwechsel:** Startbefehle mindestens 2,5 s auseinander, dazwischen nur der zuletzt gewünschte Link. Normalfall unverändert schnell (Start sofort).
- **Karte vor „bereit“ aufgelegt:** startet automatisch, sobald Spotify die Box kennt.
- **Automatik** pausiert über eine Hülle (`SpotifyFuerAutomatik`): Timer-/Ruhezeit-Pause gilt als gewollt und wird nicht „repariert“; ohne bekanntes Gerät wird nichts pausiert (traf sonst evtl. das Handy).
- **Player:** Lesefehler 5× in Folge → RC522 neu einrichten. Steuerungsfaden wird überwacht und neu gestartet. systemd-Watchdog (`WatchdogSec=30`, sd_notify ohne Zusatzpaket). `spotify.py`: `AnmeldungFehlt` statt `SystemExit` (Player läuft weiter, Klartext auf der Seite), Token-Sperre zwischen Fäden, Zeitlimit 8 s, Retry-After bei 429, neu `zustand()`, `uebertragen()`, `token_verwerfen()`.
- **Eltern-Seite:** Musik zeigt „kümmert sich“ mit Klartext, solange die Steuerung repariert.
- **Gemessen in der Simulation (Zeit bis Musik):** normal sofort; 502 ca. 14 s; „angenommen, spielt nicht“ / springende Titel / hängende Position ca. 23 s. Langsamer Start (Ton nach 5 s) löst keinen Neustart aus.
- **Geprüft ohne Hardware:** `test_steuerung.py` (24 Tests, simulierte Uhr), 13 eingebaute Fehler werden alle erkannt; Probelauf des ganzen Players mit simuliertem Leser/Spotify (502 → Neustart → spielt, READY/WATCHDOG kommen an); Seite im Browser mit Problemanzeige. Alle 78 Tests grün.
- **Am Pi einmal per SSH:** `cd ~/peppa-box && git pull && sh software/dienst_einrichten.sh` (Watchdog, „nie aufgeben“ für Player und Raspotify, sudo-Freigabe `restart peppa-stille`). Ohne diesen Schritt läuft alles andere schon nach dem Update über die Seite.
- **Am Pi prüfen:** Karte auflegen (Start wie bisher sofort), mehrere Karten schnell wechseln (am Ende spielt die letzte), `sudo systemctl restart raspotify` während Musik (geht nach einigen Sekunden an derselben Stelle weiter), Karte während des Hochfahrens auflegen.
- **Idee:** kurze Ansage „Einen Moment …“ (ElevenLabs, Stimme Helmut), wenn eine Reparatur länger als ca. 5 s dauert, damit das Kind weiß, dass die Box arbeitet.

## Nachtrag 03.11.2026 (2) – Touch-Modul geliefert, Mulde angepasst

- Geliefert: **Adafruit 1982 in der STEMMA-QT-Ausführung** (zwei 4-polige JST-SH-Buchsen, Beschriftung VIN, 3Vo, GND, SCL, SDA, INT, ADDR unten; 11 … 0 und GND oben). Gemessen: **34 × 20 mm** (L × B).
- Modell: `MPRB` 25 × 20 → 34 × 20 mm (gemessen), Mulde jetzt innen 34,6 × 20,6 mm, liegt weiter ganz rechts unter der Verteiler-Brücke (x 98,4–133,0, y 75,7–96,3). `check.py`: keine Kollision, Deckelteile von oben einsetzbar, Abstand zum Kartenfach 13,6 mm. Neu exportiert: `03_deckelrahmen.stl`, Coupons C2/C3, Ansichten.
- Höhe des Moduls (Platine + Buchsen + Lötstellen): 5 mm vorgesehen (Jan, 03.11.). Prüfung ohne Kollision, Abstand zum Kartenfach 13,5 mm.
- Die zwei weißen Buchsen sind STEMMA QT (JST SH, 4-polig, 1 mm Raster: GND, 3,3 V, SDA, SCL) zum lötfreien Anschluss von I2C. Werden nicht genutzt (Kabel gehen in die Lötaugen); Option: STEMMA-QT-Kabel statt 4 Lötstellen, dafür dünne Adern an den Klemmen.
- Beiliegende Stiftleiste ist länger als die Lötreihe und wird nicht gebraucht (Kabel direkt in die Lötaugen). Belegung Vorschlag: E0 zurück, E1 Play, E2 vor, E3 Schlaf (in der Software änderbar).
- Kupferfelder: Streifen nebeneinander in die Tasche, blanke Litze quer über alle Streifen, zweiter Streifen darüber (Kleber kann nichtleitend sein).

## Nachtrag 03.11.2026 (3) – Korpus: Löcher rechts, USB-C-Halter hinten

- **Befund Jan:** Loch für Drehgeber und Klinke sind tropfenförmig, im ausgebauten Zustand sichtbare Spitze oben. Ursache: **so im Modell** (`tear()`, Spitze nach oben, damit die Lochoberseite in der senkrechten Wand ohne Stütze druckt), kein Druckfehler.
- **Neu:** Drehgeber-, Klinken- und Riemenloch als **Tropfen mit flacher Oberseite** (`cap` = Radius): Lochhöhe = Durchmesser, oben eine kurze Brücke (2,6–3 mm), nur zwei kleine Ecken stehen 0,25–0,3 mm über den Kreis hinaus und liegen unter Mutter/Scheibe. Druckt weiterhin ohne Stütze.
- **USB-C hinten (ersetzt das runde 16,4-mm-Loch der früher geplanten Einbaubuchse):** Soldered 333011 liegt **mit der Bauteilseite oben waagerecht** an der Rückwand, Buchsenmund an der Wand (0,3 mm Spalt). In der Wand eine **Öffnung 13 × 7 mm** (Eckradius 3, Fase 0,6 außen) für den Steckerkörper; der Stecker taucht 3 mm in die Wand ein und rastet voll in der Buchse ein. Buchsenmitte x 112 (vorher 114, 2 mm mehr Abstand zur Innenecke), z 60.
- **Halter:** 2 Dome Ø 9 an die Rückwand angesetzt, unten 45°-Kegel (ohne Stütze), Kernloch 2,5 für Kunststoffschrauben 3,0 von oben durch die Platine (Länge ca. 8–10 mm, Dome 10 mm hoch, Kernloch 9 tief). Aussparung 1,5 mm oben in den Domen für die Lötfahnen der Buchse. Montage bei leerem Korpus von oben (Deckel, Boden draußen), Schraubendreher leicht schräg an der Deckelauflage vorbei.
- **Maße belegt** aus der KiCad-Datei V1.2.0 (github.com/SolderedElectronics/USB-C-female-connector-breakout-hardware-design): Platine 22 × 22 × 1,6, Löcher Ø 3,2 mit 16,0 Abstand, 3,0 von der Buchsenkante, Buchsenmund bündig mit der Platinenkante, Lötfahnen ±4,31 seitlich, 2,5 und 6,7 von der Kante. **Vorläufig:** Buchsenhöhe über der Platine 3,3 (nachmessen), Öffnung 13 × 7 (USB-C-Spezifikation: Steckerkörper höchstens 12,35 × 6,5; Stecker des Netzteilkabels nachmessen). Version der gelieferten Platine (V1.2.0?) auf der Rückseite ablesen.
- Platzhalter „USB-C-Platine mit Buchse und Kabeln" (Platine, Buchse, 12 mm Zone über der Lötreihe, Lötfahnen, Schraubenköpfe): keine Kollision, Abstand zur Kabelzone hinten am Stapel 7,0 mm. Die CC-Widerstände flach umbiegen (Zone 12 mm hoch).
- **Drehknopf noch nicht probiert.** Knopf erwartet: Achse 14 mm über der Wand-Außenseite (`ENC_OUT`, vorläufig), Schlitz 1,0 mm (`ENC_SLOT`, vorläufig; Steg im Knopf 0,8 mm), Mutter + Scheibe in einer Aussparung Ø 14 × 3 (`NUT_REC`, vorläufig). Messen: Achslänge ab Wand außen bei angezogener Mutter, Schlitzbreite und -tiefe, Mutter Schlüsselweite/Höhe.
- Neu gebaut: `01_korpus_beige.stl`, Modifier, Coupons C1 (hinten jetzt mit Domen und Fuß unten), C2/C8 (Korpus-Ausschnitte), Ansichten, Bodenplan, `usbc_schnitt.png`. Prüfungen ohne Kollision.
- **Zu tun:** Coupon `coupon_C1_wand_hinten_usbc` drucken, Platine anschrauben, Netzteilstecker einstecken (rastet voll ein? Spiel ringsum?). Danach Korpus neu drucken.

## Nachtrag 03.11.2026 (4) – Messwerte USB-C und Drehgeber, Vorbereitung finaler Korpus

- **USB-C gemessen (Jan):** Buchsenhöhe ca. 3,4 mm (Modell vorher 3,3), Lochabstand 16 mm (= KiCad). Netzteilstecker normgerecht (≤ 12,35 × 6,5) → Öffnung 13 × 7 bleibt, Status festgelegt.
- **Drehgeber gemessen (Jan, Prototyp mit 2 mm Wand):** Achse endet 23 mm über der Wand außen, Mutter 2,5 mm hoch, ca. 10 mm breit, darüber noch ca. 2 mm Gewinde frei, Schlitz ca. 1,6 mm breit und 11 mm tief, Achse Ø 6. Datenblatt STEC11B: Gewinde M7 × 0,75, 7 mm; STEC11B03 mit 25-mm-Schlitzachse und Drucktaster (0,5 mm Hub), Mutter und Scheiben liegen bei.
- **Korpus:** Wand am Drehgeber jetzt **volle 3 mm** (`ENC_WALL` 2 → 3, Senkung innen entfällt): stabiler gegen Ziehen am Knopf, Mutter weiter voll im Gewinde (ca. 1 mm Gewinde frei), Achse ragt 1 mm weniger heraus (22 mm). Prüfungen ohne Kollision.
- **Drehknopf `07_drehknopf_orange.stl` passt so nicht (NICHT drucken):** Bohrung 12 mm tief, Achse ragt 22 mm heraus; Mutterraum muss ca. 4 mm (Scheibe + Mutter + Restgewinde) statt 3 aufnehmen; Steg für den 1,6-mm-Schlitz. Entscheidung offen: (A) Knopf ca. 24 mm lang über die volle Achse, (B) Achse mit der Metallsäge auf ca. 16 mm über der Wand kürzen (Schlitz bleibt ca. 5 mm), Knopf ca. 18 mm. Drucktaster der Achse könnte eine Funktion bekommen (z. B. Pause). *(Überholt 05.11.: Achse wird nicht gekürzt, Knopf über die volle Achse – Nachtrag 05.11.2026 (5).)*
- Abgleich mit dem Prototyp-Korpus (Stand 25.10. 02:28): Gleich geblieben sind Lautsprecher-Mulde und -Dome, Stoffsitz und Rahmenstift-Löcher, Deckelauflage, Zungenschlitze, Deckelschrauben hinten, Lüftungsschlitze, Klinkenloch (Ø 6,2), Trennwand. Neu seither: V-Fuge unten, Eckdome 0,4 mm nach innen (passend zum bündigen Boden), flache Lochoberseiten, USB-C-Halter, volle Wand am Drehgeber. → Der Prototyp taugt als Probe für alles, was gleich geblieben ist. Der alte Boden (erste Version, 0,4 mm kleiner) passt nicht mehr genau zu den Eckdomen; Boden in der aktuellen Version neu drucken.

## Nachtrag 03.11.2026 (5) – Finaler Korpus: Fuzzy-Skin-Flächen, Schrauben 3,0 × 12, Knopf für gekürzte Achse

- **Rückmeldungen Jan:** Lautsprecher passt perfekt in die Mulde des Prototyps (`SPK_PITCH`, `SPK_FRAME_R` damit bestätigt). Klinke sitzt fest, Mutter Ø 8 mm (`JK_NUT`). Deckelrahmen passt. Lüftungsschlitze ok. Riemen bleibt (Buchschraube Ø 7,5, 15 mm mit Kopf; Maße noch zu klären). Schrauben: **nur 3,0 × 12** vorhanden, Senk- und Flachkopf. Kernloch 2,5 passt.
- **Entscheidungen Jan:** Rückseite **Variante B** (ein glattes Anschlussfeld); **Deckel zweifarbig**, Akzente als eigene orange Teile, Korpus einfarbig beige; **Drehgeberachse um 6 mm kürzen** (überholt 05.11.: wird nicht gekürzt); **keine Lade-LED** im Korpus – stattdessen Software: Mond-Feld ca. 5 s halten → Box sagt einmal den Akkustand an (später umsetzen).
- **Fuzzy Skin:** Alles mit Passung bekommt eine **glatte, 0,4 mm vertiefte Fläche** (`FUZZ_REC`), der Modifier „ohne Fuzzy" deckt genau diese Flächen + 0,3 mm (`FUZZ_RIM`): Anschlussfeld hinten (x 17–123, z 46,5–69,5, R 5, mittig) mit USB-C rechts und Schlitzen links (gleicher Rand), Deckelschrauben hinten Ø 10, Klinke Ø 10 (Mutter Ø 8 + 1 mm Rand), Drehgeber Ø 18 (unter dem Knopf). Gitter-Sitz vorne mit 0,6-mm-Fase, Wände und Fase glatt. Grund: Löcher in senkrechten Wänden gehören im Slicer zur Außenkontur und würden sonst mit „verfuzzt"; Muttern liegen eben.
- **Wand unter den Muttern:** Klinke weiter 2,0 mm (wie Prototyp, Gewinde knapp), innen entsprechend ausgespart; Drehgeber 2,6 mm (3,0 − 0,4), ca. 1,4 mm Gewinde über der Mutter.
- **Schrauben 3,0 × 12:** Lautsprecher-Dome 10 statt 7 mm lang, Kernloch 12,4 tief ab Muldenboden. USB-C-Dome 12 mm, Kernloch 11 tief. Deckelschrauben hinten: Senkung so, dass der Senkkopf bündig mit der glatten Fläche liegt. Boden: 4 mm Platte + 8 mm im Dom (Kernloch 12) passt. **Deckelrahmen:** Ringschrauben gingen bisher 3 mm Ring + 4,5 mm Deckel (= 7,5 mm) – mit 12 mm stießen sie oben durch den Deckel. Neu: 6 Dome Ø 9 unter dem Ring (4,7 mm), Senkkopf versenkt im Dom, Spitze endet 0,2 mm vor dem Kernlochende. Dafür in der Kammerdecke des Korpus 2 Mulden Ø 11, 1,2 tief unter den vorderen Domen (Decke bleibt 1,8 mm, Kammer dicht).
- **Drehknopf neu** (`knob_geo()`): Achse nach dem Kürzen 16 mm über der Wand, Schlitz bleibt 5 mm; Knopf 17,4 mm lang, Ø 34, 1 mm Luft zur Wand, Aussparung Ø 15 für Mutter + Scheibe mit 0,9 mm Luft für den Drucktaster (0,5 mm Hub), Bohrung Ø 6,1 (Probedruck, Klemmsitz) mit Steg 1,4 mm im 1,6-mm-Schlitz über 4,5 mm. *(Überholt 05.11.: Achse wird nicht gekürzt, Knopf über die volle Achse – Nachtrag 05.11.2026 (5).)*
- **Noch offen für den finalen Korpus:** (1) Nase am Drehgeber (Lage, Größe, Höhe) → Loch innen als Verdrehschutz. (2) Buchschraube: Schaft-Ø, Kopf-Ø, Klemmlänge; Riemen Breite/Dicke. (3) Kopfmaße der 3 × 12 (Senkkopf Ø, Flachkopf Ø/Höhe), M3-Scheiben für die Lautsprecher-Langlöcher 4,5 × 5,5. (4) optional Form des Klinkenkörpers → Tasche gegen Mitdrehen.
- Prüfungen ohne Kollision, alle Teile neu gebaut.

## Nachtrag 03.11.2026 (6) – Korpus FINAL zum Druck freigegeben

- **Maße Jan:** Drehgeber-Nase 2,5 mm neben der Gewinde-Außenkante, 2,0 breit, steht 1,5 vor. Buchschraube Schaft Ø 7,5 (Kopf liegt auf dem Riemen). Schrauben 3 × 12: Flachkopf Ø 6 / 3 hoch, Senkkopf Ø 6 / 3 hoch; M3-Scheiben vorhanden. Klinkenbuchse: Körper 11,5 breit, 6,2 hoch, mit Lötfahne 9.
- **Korpus:** Tasche innen für die Drehgeber-Nase oben über der Achse (2,6 × 1,9, 1,9 tief, Restwand 0,7 unter dem Knopf) → **Drehgeber mit der Nase nach oben (zum Deckel) einbauen**. Klinke: rechteckige Tasche innen 12,2 × 12,8 × 0,6 statt runder Senkung (Wand unter der Mutter weiter 2,0), begrenzt das Mitdrehen auf wenige Grad, egal wie die Lötfahne liegt. Riemenloch Ø 7,9 (flache Oberseite). Senkungen für Kopf Ø 6 (+0,2).
- **Modifier `01m_…` jetzt deckungsgleich mit `01_korpus_beige.stl`** (vorher 4 mm in z versetzt, weil nur der Korpus auf z = 0 geschoben wurde). Riemen: nur die Bohrung + 0,6 mm glatt (Rand liegt unter dem Riemen).
- **Klinkenbuchse Lumberg 1503 09** (Datenblatt): 3-polig, 2 Öffner, 5 Lötanschlüsse. Gebraucht: L, R, Masse und der Öffner von L (Steckererkennung Pin 37); der Öffner von R bleibt frei. Welcher Anschluss vorne liegt, steht nicht im Text des Datenblatts – vermutlich Masse; mit Durchgangsprüfer gegen den Schaft eines eingesteckten Steckers prüfen. Nichts abschneiden.
- **Achse kürzen:** ab Gehäusefläche des Drehgebers (Gewindeanfang) 25 → 19 mm (6 mm ab), dann ragt sie 16 mm über die Wand. Achse beim Sägen festhalten (nicht das Gehäuse), entgraten. *(Überholt 05.11.: Achse wird nicht gekürzt, Knopf über die volle Achse – Nachtrag 05.11.2026 (5).)*
- **Druck Korpus:** PETG beige, Düse 0,4, 0,2 mm, 3 Wandschleifen, 15 % Gyroid, keine Stützen, keine Umrandung, Elefantenfuß 0,15, Z-Hop 0,4, Scarf Seam hinten. Fuzzy Skin nur Außenkontur, Dicke 0,2–0,25, Punktabstand 0,6–0,7, erste Schicht ohne. Beide STL gleichzeitig laden → „ein Objekt mit mehreren Teilen" → `01m_…` als Modifier, Fuzzy Skin dort aus. In der Vorschau prüfen: Anschlussfeld, Gitter-Sitz und Löcher glatt.
- **Als Nächstes (nach dem Korpus):** Gitter mit Logo (noch nicht im Modell), Boden (Rand mit Fuzzy, Gummifüße), Deckel zweifarbig kopfüber (ein Farbwechsel; Deckelrand ohne Fuzzy), Gegenplatte Riemen (Klemmlänge der Buchschraube), Knopf-Probedruck, Software: Akku-Ansage über Mond 5 s.

## Nachtrag 03.11.2026 (7) – Fuzzy-Stärke per Probe festlegen

- Jan will eine hochwertige, nicht „aufgeplusterte" Oberfläche. Die bisherigen Werte (Dicke 0,2–0,25, Punktabstand 0,6–0,7) ergeben eher grobe Beulen. **Empfehlung neu: Dicke 0,15, Punktabstand 0,3, Rauschen „Classic"** (fein, wie sandgestrahlt), Modus nur Außenkontur, erste Schicht ohne.
- **Neuer Coupon C10** (`coupon_C10_fuzzy_ecke.stl` + `coupon_C10_fuzzy_ecke_MODIFIER_ohne_fuzzy.stl`, gleich verschoben): Ecke hinten rechts mit Ende des Anschlussfelds, USB-C-Öffnung, Eckradius R 16 und rechter Wand, 42 × 30 × 32 mm, ca. 9 g. Beide zusammen laden, Modifier ohne Fuzzy, 4 Kopien mit Einstellungen pro Objekt: A 0,10/0,25 · B 0,15/0,30 · C 0,20/0,40 · D 0,25/0,65 (alter Wert zum Vergleich); optional E wie B mit Rauschen „Perlin". Bewerten bei Tageslicht und im Streiflicht: Schichtlinien verdeckt? Kante des glatten Feldes sauber? Fühlt es sich gut an?
- Korpus erst nach dieser Probe drucken; gewählte Werte hier eintragen.
- **Ergänzung (22:30):** Jan will **Grip** beim Anfassen, aber hochwertig. Empfehlung daher **Dicke 0,20, Punktabstand 0,30** (Classic): Grip kommt über die Dicke, das feine Korn über den kleinen Punktabstand; aufgeplustert wirkt es erst bei großem Punktabstand. C10-Reihe neu: A 0,15/0,30 · **B 0,20/0,30** · C 0,20/0,40 · D 0,25/0,35.
- **Entscheidung Jan (22:35):** keine Probe, Korpus direkt drucken mit **Fuzzy 0,20 / 0,30, Classic, nur Kontur**. Ablauf im ElegooSlicer: beide STL laden (als ein Objekt mit mehreren Teilen, sonst über „Modifikator hinzufügen → Laden"), `01m_…` als Modifikator mit Fuzzy „Keine", Lage prüfen (Rahmen vorne deckungsgleich mit dem Gitter-Sitz).

## Nachtrag 04.11.2026 – Korpus-Druck ausgewertet: Fuzzy innen, Querlinien, Naht, Kippeln

- **Befund Jan (7 Fotos):** Fuzzy Skin innen in waagerechten Bändern (Trennwand, Seiten- und Rückwand innen); außen Querlinien, die genau auf Höhe dieser Bänder liegen; Naht sieht aus wie eine Bruchkante; Korpus kippelt, eine Ecke unten hat sichtbar weniger Material. Druck nicht abgenommen.
- **Ursache Fuzzy innen (geklärt, Quellcode ElegooSlicer v1.5.2.2 und v1.5.3.5 gelesen):** Der Slicer entscheidet je Schicht nur nach der Form, was „Kontur“ und was „Loch“ ist. Ein Loch durch die Wand schneidet den Wandring auf; die Schicht ist dann ein „C“ mit einer einzigen Kontur, die außen herum, durch das Loch und innen an der Wand zurück läuft. „Kontur“ verfuzzt dann die ganze Innenseite. Der Modifier `01m` schützte nur die kleinen glatten Flächen. Regionen mit verschiedenem Fuzzy werden für die Wände nicht getrennt (`fuzzy_skin` fehlt in `Layer::is_perimeter_compatible`); die Außenwand-Schleife wird an den Modifier-Grenzen nur zerteilt. **Planungsfehler:** Im Nachtrag 03.11. (5) waren nur die Lochwände bedacht, nicht die ganze Innenseite.
- **Nachgerechnet** (`v4/fuzzy_check.py`, Bild `out/fuzzy_analyse.png`): Fuzzy innen im Elektronikraum bei Druckhöhe 16,8–23,2 (Klinke), 46–62 (Lüftung, USB-C, Drehgeber), 110–122,4 (Riemen, Deckelschrauben; bei 118,1 eine Schicht ohne); in der Lautsprecherkammer 29,6–103,4 (Lautsprecher-Ausschnitt) und 121–125. Bis zu ca. 560 mm zusätzliche Fuzzy-Linie je Schicht (außen ca. 400 mm). Passt zu den Fotos innen (drei Bänder an der Trennwand).
- **Querlinien außen (Vermutung, per G-Code zu prüfen):** An jeder Bandkante springt die Schichtzeit. Im Profil „Elegoo PETG @ECC2“ hängt der Bauteillüfter an der Schichtzeit (10–40 %, Rampe zwischen 30 s und 12 s), Überhänge/Brücken 90 % → Kühlung springt mit. Die stärkste Linie (Foto 7, ca. 118 mm Druckhöhe, zwischen Riemenloch-Oberkante und Deckelschraube) fällt zusammen mit dem Wechsel Riemen-/Deckelschrauben-Band **und** dem Beginn der Kammerdecke (ca. 40 mm Brücke, eine Schicht von mehreren Minuten).
- **Naht:** Nahtposition „Rückseite“ nimmt je Schicht den hintersten Punkt. Mit Fuzzy ist das auf der flachen Rückwand ein zufälliger Punkt der Zitterbewegung → die Naht springt von Schicht zu Schicht. Schrägnaht ist für glatte Wände gedacht.
- **Kippeln (Vermutung):** Erste Schicht 7719 mm², davon 6937 mm² vorne (Kammerboden), hinten nur 783 mm² (2,2-mm-Wandstreifen und Dome), ohne Umrandung → vermutlich hat sich eine hintere Ecke beim Druck abgehoben. Das Modell ist unten exakt plan (geprüft). **Offen (Jan):** welche Ecke, wie viel Spalt, Unterkante dort über eine Länge hochgebogen oder nur an der Ecke?
- **Umgesetzt:** Neuer Modifier `01f_modifier_korpus_FUZZY_aussenhaut.stl` = 1 mm dünne Haut nur an den Außenflächen (`FUZZ_SHELL`), ohne die glatten Flächen, Fasen unten (V-Fuge) und oben bleiben glatt (`FUZZ_Z`). Objekt Fuzzy „Deaktiviert“, Modifier „Kontur“ → Fuzzy nur dort, egal ob die Schicht ein Ring oder ein „C“ ist. Nachrechnung: innen 0 mm, außen wie vorher (Unterschied nur an den Fasen). `01m` gelöscht. Korpus-STL unverändert. C10 auf den neuen Modifier umgestellt; neu **C11** (`coupon_C11_korpus_oben` + Modifier): obere 36 mm des Korpus mit voller Grundfläche – Riemenloch, Deckelschrauben, Kammerdecke. `check.py` prüft jetzt je Schicht, dass innen kein Fuzzy entsteht.
- **Einstellungen Korpus neu:** Nahtposition „Ausgerichtet“ + **Naht aufmalen** (senkrechter Streifen mittig auf der hinteren linken Rundung, von unten bis oben), Schrägnaht aus. Lüfter konstant: minimale = maximale Lüftergeschwindigkeit (Vorschlag 20 %). Randtyp „Nur Innenrand“ 5 mm (unsichtbar innen; füllt die 6 Schraublöcher Ø 2,5 unten in der ersten Schicht → danach mit Nadel/Bohrer frei machen). Elefantenfuß 0,15 und Z-Hop 0,4 wie bisher.
- **Ablauf (überholt, siehe Nachtrag (2)):** (1) Jan schickt den G-Code des Drucks vom 04.11. und das Projekt (.3mf) → Schichtzeit und Lüfter je Schicht auswerten, Linienhöhen zuordnen. (2) Korpus neu einrichten, G-Code vor dem Druck prüfen lassen. (3) C11 drucken und bewerten. (4) Korpus. Bleibt an der Kammerdecke eine Linie: Kammerdecke als eigenes Teil (offener Punkt 6).

## Nachtrag 04.11.2026 (2) – USB-C-Öffnung kleiner, Kippeln bestätigt, Ablauf vor dem Druck

- **Kippeln (Jan):** von vorne gesehen die **hintere linke Ecke** (Modell x ≈ 0, y ≈ 140), steht ca. 1 mm, an der höchsten Stelle ca. 2 mm hoch. Passt zur Vermutung (hinten nur 2,2-mm-Wandstreifen auf der Platte). Maßnahme: Randtyp „Nur Innenrand“, Breite **8 mm** (statt 5), Lücke zum Objekt 0; Druckplatte vorher mit Spülmittel reinigen, Haube während des Drucks zu. Bodenschraublöcher Ø 2,5 danach frei machen. Zusatzlüfter ist im Profil „Elegoo PETG @ECC2“ nicht gesetzt (geprüft), scheidet als Ursache aus.
- **USB-C (Befund Jan, Foto):** Öffnung wirkt viel zu groß, durch die Öffnung sieht man die Platine. Steckergehäuse seines Kabels gemessen: **10 × 6 mm**.
- **Erklärung:** Die Buchse sitzt hinter der Wand (Buchsenmund an der Innenseite). Das Steckergehäuse muss ca. 2,9 mm in die Wand eintauchen und dabei mittig auf der Buchse sitzen. Die Öffnung muss deshalb gehäusegroß sein, und unter der 3,4 mm hohen Buchse liegt in der 6 mm hohen Gehäusezone zwangsläufig die Platinenkante (1,6 mm). „Dome tiefer, Öffnung höher“ ändert daran nichts, weil Öffnung und Buchse mittig zueinander bleiben müssen. Bild `out/usbc_ansicht.png` (`v4/usbc_ansicht.py`).
- **Geändert:** `USBC_PLUG` 13 × 7, R 3 → **10,8 × 7,0, R 2** (Breite +0,4 je Seite; Höhe bleibt, weil oben eine Brücke durchhängt und bisher nur 0,5 je Seite Luft waren). Lüftungsschlitze rücken dadurch 1,1 mm nach rechts (gleicher Rand links/rechts im Feld). Prüfungen ohne Kollision, Fuzzy innen 0. Korpus-STL und Coupon C1 hinten neu gebaut.
- **Offen USB-C:** (1) Jan prüft, ob sein Stecker beim jetzigen Druck ganz und gerade hineingeht (Platine auf den Domen) – auf dem Foto sitzt die Buchse eher im oberen Teil der Öffnung; liegt die Platine auf den Lötfahnen statt auf den Domen, muss die Höhe nachgezogen werden. (2) Platinenkante innen mit schwarzem Stift färben → in der geschlossenen Box nur dunkler Schlitz mit Metallbuchse. (3) Alternative für später: Buchse bis ca. 0,4 mm hinter die Außenfläche nach vorn in eine Tasche der Wand setzen, Öffnung nur noch um die Metallbuchse (ca. 9,5 × 4); Gehäuse bleibt außen. Knapp: Norm-Stecker 6,65 mm Hülse vs. 6,20 mm Buchse lässt ca. 0,45 mm. Nur mit Messung der Hülsenlänge seines Steckers und Probedruck.
- **Vor dem Korpus-Druck (Jan druckt direkt den ganzen Korpus, ohne C11):** Projekt einrichten (01_korpus + 01f als Modifizierer, Naht aufmalen, Einstellungen laut README), slicen, dann **Datei → Projekt speichern als** (.3mf) und **Exportiere G-Code** (.gcode) – beides an Claude schicken. Prüfung: Fuzzy je Schicht, Nahtlage, Lüfter und Schichtzeit je Schicht (besonders Kammerdecke bei ca. 118 mm), Innenrand.

## Nachtrag 04.11.2026 (3) – Slicer-Einstellungen Korpus festgelegt

- Jan richtet den Korpus neu ein (Modell + Modifier geladen) und will Schritt für Schritt geführt werden, Ziel höchste Qualität. Die Bildschirmfotos der Einstellungen aus einem früheren Chat liegen hier nicht vor; Namen und Profilwerte stammen aus dem ElegooSlicer-Quellcode (v1.5.3.5, deutsche Übersetzung, Profile „0.20mm Standard @Elegoo CC2 0.4 nozzle“, „Elegoo PETG @ECC2“, „Elegoo Centauri Carbon 2 0.4 nozzle“).
- **Prozess global Fuzzy „Nur lackiert“ statt „Deaktiviert“:** Bei „Deaktiviert“ blendet ElegooSlicer Stärke, Punktabstand usw. aus (`ConfigManipulation.cpp`). „Nur lackiert“ ohne Bemalung erzeugt kein Fuzzy, die Werte bleiben einstellbar und gelten für den Modifier mit.
- Vollständige Tabelle in `v4/out/README.md` (Korpus). Abweichungen vom Profil: Wandschleifen 3, Gyroid, Elefantenfuß 0,15, Wischbewegung nach innen, Dicke externe Brücken, erste Schicht 30 mm/s, Außenwand 60 / Innenwand 120 mm/s, Beschleunigung Außenwand 2000, Innenrand 8 mm/Lücke 0, Lüfter fest 20 %, Überhang-/Brückenlüfter 50 %, Druckbett 80/75 °C (texturierte PEI). Schrägnaht Keine, Nahtposition Ausgerichtet + aufgemalt („Vertikal“ im Werkzeug). Z-Hub 0,4 ist schon Profilwert.
- Danach: Vorschau prüfen, Projekt (.3mf) und G-Code an Claude.

## Nachtrag 04.11.2026 (4) – G-Code des neuen Korpus geprüft (vor dem Druck)

- Jan hat Projekt (.3mf) und G-Code geschickt: ElegooSlicer 1.5.3.5, Filament-Profil „Elegoo Rapid PETG @ECC2 - Peppa“, 680 Schichten, 13 h 33 min, 339 g. Prüfwerkzeug neu: `v4/gcode_pruefung.py` (eigener Bahnplaner für die Schichtdauer, Lage auf dem Bett wird selbst bestimmt). Schichtdauer-Bild `out/gcode_schichtzeit.png`.
- **In Ordnung:** Fuzzy nur außen (innen keine Fuzzy-Wand mehr, nur Einzelpunkte an kleinen Rundungen); Anschlussfeld, Lochflächen, Fase unten und oben glatt; Modifizierer `01f` „Kontur“, Prozess „Nur lackiert“; 3 Wände, Gyroid 15 %, Außenwand 60 mm/s bei 2000 mm/s², erste Schicht 30 mm/s, Elefantenfuß 0,15, Schrägnaht keine, Wischen nach innen, dicke Brücken, Innenrand 8 mm / Lücke 0 (liegt innen), Lüfter 20 %, erste 3 Schichten ohne Lüfter, Z-Hub 0,4, kein Reinigungsturm.
- **Fehler 1 – Lüfter flattert:** 125.440 Wechsel zwischen 20 % und 50 % (Median 378 je Schicht). Ursache: Schwelle „Überhänge Kühlung Aktivierungsschwelle“ 10 % (Basis-PETG-Profil); jeder nach außen springende Fuzzy-Punkt gilt als Überhang. → Schwelle **95 %** (nur Brücken).
- **Fehler 2 – Außenwand-Geschwindigkeit springt:** 274.554 Wechsel zwischen 51 und 60 mm/s, gleiche Ursache („Verlangsamen bei Überhängen“). → **aus**. Echte Überhänge am Korpus sind 45° und liegen innen.
- **Naht:** 640 von 680 Schichten auf der aufgemalten Rundung, aber in einem 4 mm breiten Band (Sprung von Schicht zu Schicht im Mittel 1,1 mm). Ursache im Quellcode: Bei Fuzzy wählt der Slicer im bemalten Streifen den mittleren „spitzen“ Punkt – Fuzzy macht fast jeden Punkt spitz, also streut die Naht über die Streifenbreite. → Streifen neu mit **Pinselgröße 0,5**. Jan hat die Ecke **hinten rechts** bemalt (von vorne gesehen; in der Rückansicht links). In 38 Schichten (Höhe der USB-C-Öffnung) ist die Wand in zwei Stücke geteilt; das große Stück beginnt dann vorne in der Lautsprecher-Mulde (unter dem Gitter, unsichtbar).
- **Nicht übernommen:** Druckbett 70/70 °C statt 80/75 (gegen das Abheben hinten links). Düse 235/240 °C statt Profil 250 °C – nachfragen, ob bewusst.
- **Offenes Risiko Kammerdecke:** Schichten 118,2–121,0 mm dauern 85–334 s statt ca. 66 s (Brücke 12,9 m bei 50 mm/s, innere Brücke 13 m). Genau dort lag die stärkste Linie im ersten Druck. Per Einstellung nicht zu beheben. Möglichkeiten: Kammerdecke als eigenes Teil (Entscheidung Jan) oder drucken und ansehen. Kleinere Spitzen: 1,6–2,4 mm (Kammerboden, nah an der Unterkante) und 128,8 mm (158 s).

## Nachtrag 04.11.2026 (5) – Harte Linie oben: Kammerdecke als Satteldach, Mindest-Schichtdauer

- **Frage Jan:** Lösung für die harte Linie oben (im ersten Druck ca. 118 mm Druckhöhe), weiter **einteilig, nichts zusammenbauen**; an dieser Stelle war bisher nichts geändert.
- **Ursache (G-Code geprüft, Nachtrag (4)):** Die flache Kammerdecke war eine 40-mm-Brücke. Diese Schichten dauern 85–334 s statt ca. 66 s; die Außenwand darunter kühlt in der langen Schicht ganz aus → Linie. Bei PETG zeichnet sich jeder Sprung der Schichtdauer außen ab.
- **Geändert im Modell (`ROOF`, `roof()`, `roof_unter()`):** Kammerdecke als **45°-Satteldach** innen, Wand 1,6 mm (senkrecht zur Fläche), First bei y = 25 mm. Der First **steigt von links nach rechts um ca. 5,4 mm** (0,04 mm je mm), damit sich das Dach nicht in einer Schicht schließt, sondern über ca. 27 Schichten. Beide Dachflächen wachsen von der Front- bzw. Trennwand aus, ohne Brücke und ohne Stützen. Die Zungenblöcke für den Deckelrahmen sitzen auf dem Dach. `CH_Z` bleibt Bezug für Zungenschlitze und Deckelrahmen.
- **Geprüft:** Kammer weiter dicht (Schnitte alle 0,05 mm, kein Luftweg); Lautsprecher frei (ca. 3,5 mm unter dem Dach), Einbau von vorn frei; Deckelrahmen 0,25–0,5 mm Luft wie vorher; keine Kollision; Fuzzy innen 0; Überhang des Korpus 5792 → 403 mm² (Rest wie vorher: Lautsprecherausschnitt, Dome). Volumen 312,5 → 301,2 cm³. Geschätzte Schichtdauer (Bild `out/kammerdecke_schichtzeit.png`): sanfter Anstieg auf ca. 83 s statt Spitzen bis 334 s. Schnittbild `out/kammerdecke_satteldach.png` (`v4/dach_bild.py`).
- **Zweite Spitze 128,8 mm (158 s):** Oberseite der Deckelauflage innen, 3,2 m kurze Linien (Muster „Monotonische Linie“ quer über einen 2,3-mm-Ring, jede Linie bremst bei 2000 mm/s²). → **Muster der Oberfläche: Konzentrisch** (wenige lange Runden, ca. 1 min schneller in dieser Schicht; auch die sichtbare Oberkante des Rands wird umlaufend gezogen).
- **Mindest-Schichtdauer 70 s:** Filament → Kühlung, Zeile „Schwellenwert für die maximale Lüftergeschwindigkeit“ Schichtdauer **70 s** (12), Zeile „Minimale Lüftergeschwindigkeit“ Schichtdauer **100 s** (30), „Äußere Wände nicht verlangsamen“ **an**. Lüfter bleibt bei 20 %. Gebremst werden nur Innenwände und Füllung (im Quellcode geprüft: Außenwand wird dann nicht als anpassbar markiert). Damit dauert ab ca. 40 mm jede Schicht mindestens 70 s (bisher 57–66 s, mit kleinen Sprüngen bei 125,4 und oben am Rand). Kostet rund 1 h (nachgerechnet auf dem G-Code vom 04.11.: 70 s → +0,95 h, 80 s → +2,6 h).
- `v4/gcode_pruefung.py` meldet jetzt zusätzlich Sprünge der Schichtdauer > 25 % gegenüber dem gleitenden Median (auf dem G-Code vom 04.11.: 15 Schichten, alle an Kammerdecke, 125,4, 128,8 und Oberkante).
- **Für Jan:** neues `01_korpus_beige.stl` laden (Modifier `01f` unverändert), Naht neu aufmalen (Pinselgröße 0,5), restliche Einstellungen laut README (Druckbett 80/75, Verlangsamen bei Überhängen aus, Muster der Oberfläche Konzentrisch, Schichtdauer 70/100, Äußere Wände nicht verlangsamen), slicen, G-Code und Projekt vor dem Druck an Claude.

## Nachtrag 05.11.2026 – Korpus perfekt; Deckel zweifarbig kopfüber vorbereitet

- **Jan:** Korpus-Druck (G-Code 16 h 51 min, Satteldach, Schichtdauer 70/100) **perfekt, sehr zufrieden – diese Qualität beibehalten.** Damit gelten die Korpus-Einstellungen in `v4/out/README.md` als Bezug für alle Sichtteile.
- **Wunsch Jan:** als Nächstes den Deckel wie geplant (beige mit orangen Tasten), **ohne Fuzzy**, Oberfläche so, dass man den 3D-Druck möglichst nicht sieht. Schlummertaste: ist schon im Modell – Touchfeld „schlaf“ mit Mond (Ø 18, hinter Play, MPR121 E3); Software: kurz = Schlummer-Timer, 5 s halten = Akku-Ansage (geplant). Bild `out/deckel_draufsicht.png` (`v4/deckel_bild.py`).
- **Druckaufbau:** kopfüber auf der texturierten PEI-Platte (Entscheidung 27.10.). Sichtfläche = Plattenseite: matt, ohne Schicht- und Deckschichtlinien. 4 Schichten beige (0,8 mm, `SKIN`), ab Schicht 5 orange; Symbole und Ringnuten sind Aussparungen in der Haut, ihre Böden die erste orange Schicht (Brücken, größter Innenkreis 6,5 mm bei Play-Dreieck). CANVAS, ein Farbwechsel, Reinigungsturm an (erste orange Schicht ist in den Symbolen sichtbar).
- **Geändert:** `deckel_kopfueber()` dreht jetzt um y statt um x (keine Spiegelung): hinten bleibt hinten, Nahtposition „Rückseite“ landet an der Hinterkante im Deckelspalt (vorher wäre sie vorne gelandet). Optionaler Bezugskörper hält mehrere Teile deckungsgleich. `02a_deckel_kern_orange.stl` und `02b_deckel_haut_beige.stl` werden jetzt **kopfüber** exportiert (02b z 0–0,8, 02a z 0,8–6,0, deckungsgleich, dicht). `check.py` richtet die Deckelteile ebenso aus. C9 dadurch ebenfalls um y gedreht. `02_deckel_einfarbig.stl` bleibt Oberseite oben (Prototyp).
- **Neu Coupon C12** (`coupon_C12_deckel_oberseite_kern_orange` + `_haut_beige`): obere 2,4 mm vorne rechts (Play, Vor, Mond, Vorder- und Seitenkante mit Fase), kopfüber und zweifarbig, ca. 15 g. Prüft Oberfläche, Farbwechsel, Symbolböden; Empfehlung 2 Kopien „Dicke externe Brücken“ an/aus.
- **Einstellungen Deckel (README, eigener Prozess speichern):** Randtyp **Keine Umrandung** (Innenrand vom Korpus würde Symbole und Löcher füllen), Fuzzy aus, untere Schalenschichten 8, Füllung 25 % Gyroid (kopfüber kein Durchzeichnen; massiv nur mehr Spannung/Verzug – ersetzt die Empfehlung 100 % vom 27.10., die für den Druck mit Oberseite oben galt), „Nur eine Wand in der ersten Schicht“ an, „Vermeiden von Wandüberquerungen“ an, erste Schicht Füllung 50 mm/s, Nahtposition Rückseite, Elefantenfuß 0,15, Schicht 0,2/0,2. Platte waschen und nicht anfassen (Fingerabdrücke bilden sich ab).
- `08_ein_taste_orange.stl` (Kopf unten) auf derselben Platte drucken → gleiche Oberfläche. Für den Einbau braucht der Deckel den aktuellen Deckelrahmen `03` und das Kartenfach `04`.

## Nachtrag 05.11.2026 (2) – G-Code Deckel geprüft

- Jan hat Projekt und G-Code des Deckels geschickt (ohne C12): 30 Schichten, 2 h 28 min, 77 g (16,8 g beige, 60,6 g orange), ein Filamentwechsel. Neues Prüfwerkzeug `v4/gcode_deckel_pruefung.py` (Lage auf dem Bett aus der Mitte der Außenwand; G-Code-Y liegt beim CC2 1,5 mm neben der Plattenansicht).
- **In Ordnung:** 02b Filament 2 (beige), 02a Filament 3 (orange), Teile deckungsgleich (z 0–0,8 / 0,8–6,0, keine Drehung im Slicer). Wechsel genau vor Schicht 5; in Schicht 5 zuerst Reinigungsturm in Orange (Spülen 111,8 mm Filament ≈ 269 mm³ in den Abwurf), dann der Deckel. Keine Umrandung, Schicht 1 nur eine Wand, Unterseite monotonisch 50 mm/s, Außenwand 30 mm/s. Fuzzy aus. 8 untere Schichten, Gyroid 25 %, Rückseite-Naht an der Hinterkante (x 16, y 136, alle Schichten gleich). Fahrwege über den Vertiefungen in Schicht 2–4 nur 8 je Schicht (0,8–1,1 mm über die Ringnuten), alle mit Rückzug. Symbolböden zu 98 % als Brücke (Lüfter 50 %), Rest sind Ecken unter 0,12 mm².
- **Hinweis Brücken:** Richtung wählt der Slicer selbst. Play (Dreieck und beide Balken) wird in y-Richtung überbrückt, also die Balken der Länge nach (11,5 mm statt quer 2,6 mm); „zurück“ schräg mit bis 11,7 mm (quer wären 8,8). Für PETG unkritisch, die Böden können aber leicht durchhängen. Möglich, falls C12 oder der Deckel das zeigt: dünner Modifier nur für Schicht 5 (z 0,82–0,98) mit „Brückenwinkel“ je Feld (Play/Mond 180°, zurück/vor 90°).
- Farbe beim Prüfen: Filament 2 hat im Projekt die Anzeigefarbe #F3D59A, beim Korpus war Beige #F4E2C1 – gleiche Rolle wie beim Korpus nehmen.

## Nachtrag 05.11.2026 – Klinkenbuchse 1503 09: Lötfahnen gemessen

- Bezeichnung nach Foto von oben (Gewinde oben): A oben mittig am Gewinde, B rechts Mitte, C rechts unten, D links innen, E links am Rand.
- Gemessen (Jan, Durchgang): ohne Stecker B–C und D–E verbunden, A allein. Mit Kabel: Steckerspitze → B, Ring → E.
- **Belegung:** A = Masse (Hülse), B = L (Spitze), C = Öffner L → Pin 37 (GPIO 26), E = R (Ring), D = Öffner R (frei, nicht abschneiden).
- Kabel Goobay (gewinkelter Stecker, gemessen): Spitze = weiß → B, Ring = rot → E, Hülse = Geflecht → A. Neuer Draht C → gelber Stift **P26** (GPIO 26; P26 hat keine Federklemme). Bild: `plan/buchse_verdrahtung.jpg`.
- P26 liegt nur auf den gelben Stiften (Aufdruck untere Stiftleiste, obere Beschriftungsreihe, 2. von links). Anschluss: Steckkabel mit Buchse halbieren, abgeschnittenes Ende an Fahne C löten, Buchse auf den Stift P26.

## Nachtrag 05.11.2026 – Ladeanzeige: Vorzeichen am Gerät umgekehrt

- Beobachtung Jan (Eltern-Seite): **Netzteil gesteckt** → 4,16 V, „Akkubetrieb“; **Netzteil gezogen** → 4,04 V, „wird geladen“. Zusammen mit 02.11. (mit Netzteil −6,48 / −4,47 mV) belegt: Beim UPS HAT (D) dieser Box ist das Vorzeichen **umgekehrt** zur Waveshare-Angabe. Mit Netzteil negativ = Ladestrom. Der Akku lädt also; die 0,12 V höhere Spannung mit Netzteil ist die Ladespannung.
- Die Prozentwerte springen deshalb (83 → 96 %): die Kennlinie gilt nur für die Ruhespannung.
- `akku.py`: `VORZEICHEN = -1`, Auswertung in `auswerten()` (ohne Hardware testbar, `software/test_akku.py`). Während des Ladens `prozent = None`. Neue Richtung **„voll“**: kaum Strom bei ≥ 4,10 V (ohne Netzteil zieht der Pi immer Strom, kaum Strom geht also nur mit Netzteil). Schwelle 4,10 V festgelegt, nicht gemessen.
- Eltern-Seite: beim Laden groß „lädt“, Text „Netzteil steckt, Akku wird geladen · Prozent erst ohne Netzteil“; bei „voll“: „Netzteil steckt, Akku voll“.
- **Am Pi prüfen:** Update über die Seite; Netzteil stecken → „lädt“; ziehen → „Akkubetrieb“ mit %; geladen lassen bis die blaue LED ausgeht → Anzeige „voll“? `shunt_mv` dann notieren.
- Offen: Prozent während des Ladens (z. B. letzten Wert vor dem Einstecken merken) – erst wenn die Anzeige so passt.
- 21:21: Nach dem Update zeigte die Seite „null %“, weil im Handy noch die alte Seite lief (neuer Server, alter Code). Behoben: Nach einem Update lädt die Seite sich selbst neu (`warteBisZurueck(true)` → `location.reload()`). Dieses eine Mal noch von Hand neu laden.

## Nachtrag 05.11.2026 (3) – Deckel-Druck ausgewertet, Symbole jetzt bündig eingelegt

- **Befund Jan (3 Fotos):** Fläche außerhalb der Kreise sehr gut. Innerhalb der Kreise unschön: man sieht die Bahnen (Ringe um die Symbole, Lückenfüllung), Orange scheint durch die helle Schicht wie Fäden, Symbolböden sehen wie Fäden aus, kleine Fehlstellen (Punktreihen, weiße Härchen an Lochkanten und in den Vertiefungen). Nicht abgenommen – Anspruch absolut perfekt.
- **Ursache (G-Code geprüft, Bild `v4/out/deckel_ursache.png`):** (1) Schicht 5, die erste orange Schicht, überbrückt die Vertiefungen; der Slicer dehnt die Brücke auf den ganzen Kreis aus (1760 mm² Brücke, 597 mm² Vertiefung, Felder 1722 mm²). Hinter 0,8 mm durchscheinendem Beige liegen dort runde, mit Abstand gelegte Brückenfäden statt dichter Füllung → „Orange guckt durch wie Fäden“, nur in den Kreisen. Die Symbolböden sind selbst Brückenfäden (dicke Brücken). (2) In Schicht 2–4 je Loch 3 Wände → Ringe hinter der ersten Schicht. (3) Überlappung Füllung/Wand an Ober-/Unterseite nur 5 % → Punktreihen neben Kanten. (4) Jedes Loch hat Nahtpunkte; einzelne Fäden in den Vertiefungen.
- **Gegenmaßnahme Modell:** `SYM_INLAY` = 1: Symbole und Ringe sind **bündig in Orange eingelegt** (gehören zu `02a`, ein Körper mit dem Kern); `02b` ist die Haut ohne Symbole. Die ganze Oberseite liegt auf der Platte, keine Löcher in der Haut, keine Brücke (Überhang Deckel 6 mm², nur Schlitzfase). CANVAS wechselt in Schicht 1–4 je einmal die Farbe. **Nicht mehr ertastbar** – Entscheidung 27.10. dafür aufgegeben. Neu `02m_modifier_deckel_haut_1wand.stl` (`deckel_haut_modifier()`, z 0–0,85 kopfüber): Wandschleifen 1 in den Haut-Schichten. C12 neu mit 3 Teilen (Kern+Einleger, Haut, Modifier).
- **Gegenmaßnahme Einstellungen (README Deckel):** Wandgenerator Arachne (schmale Ringe 1,1 mm und Stege ohne Lückenfüllung), Überlappung des oberen/unteren massiven Füllung/Wand 25 % (5), Reinigungsvolumen Multiplikator 1,5, Modifier 02m Wandschleifen 1; Rest wie bisher.
- `v4/gcode_deckel_pruefung.py` neu: Farbe je Schicht innerhalb/außerhalb der Symbole, Innenwände und Brücken in den Haut-Schichten, Brückenfläche über den Feldern, Fahrwege, Naht, Zahl der Farbwechsel.
- **Ablauf:** zuerst C12 (ca. 15 g) mit genau den Deckel-Einstellungen, Foto an Claude; dann Deckel, G-Code vorher prüfen lassen. Der Deckel vom 05.11. bleibt als Passprobe für Rahmen, Kartenfach, Taste und Touchfelder (kein Ausschuss).
- Möglich, falls Ertastbarkeit wichtiger wird: nur die Ringe als Rille lassen, Symbole eingelegt – bringt aber wieder Löcher in die Haut (Nahtpunkte, Wandringe an den Rillen); nicht empfohlen.

## Nachtrag 05.11.2026 (4) – Deckel: Tasten bleiben ertastbar; PLA-Opfer-Einleger oder gerichtete Brücken; Deckelspalt

- **Entscheidung Jan:** bündig eingelegte Symbole (Nachtrag (3)) **abgelehnt** – Tasten müssen ertastbar bleiben (Vertiefung). Optik des Deckels gefällt sehr gut, Qualität in den Kreisen nicht. Orange Fäden wären als Stilmittel denkbar, dann aber alle in derselben Richtung. Wunsch: trotzdem perfekte beige Fläche in den Kreisen, möglichst auch Orange ohne Fäden. `SYM_INLAY` = 0 (Code bleibt).
- **Einordnung „Beige zu dünn“:** Außerhalb der Kreise ist es dieselbe 0,8-mm-Haut und sieht sehr gut aus, weil dahinter dichte orange Füllung liegt. In den Kreisen lag dahinter die ausgedehnte Brücke (Fäden mit Lücken). Ursache ist also, was hinter der Haut liegt, nicht die Dicke. `SKIN` bleibt 0,8; falls C12 trotzdem Durchscheinen zeigt: 1,2 (ein Parameter).
- **Brainstorming (verworfen):** Druck mit Oberseite oben (Böden perfekt, aber Sichtfläche gebügelt statt Plattenstruktur); Stützen aus PETG (raue Böden, aus 0,8-mm-Vertiefungen kaum zu entfernen); dickere Haut allein (behebt die Ursache nicht, tiefere Rillen, mehr Wechsel); getrennte orange Einsätze zum Einkleben (Zusammenbau).
- **Variante A (empfohlen) – PLA-Opfer-Einleger** `02p_opfer_einleger_PLA.stl` (`deckel_opfer()`): füllt die Vertiefungen in Schicht 1–4 mit PLA (0,48 cm³, ca. 0,6 g). Schicht 5 wird auf PLA als normale dichte Füllung gedruckt: keine Brücke, Böden eben, in allen Symbolen gleiche Richtung, hinter dem Beige überall dichte Füllung, keine offenen Löcher (keine Härchen). PETG haftet nicht an PLA → nach dem Druck heraushebeln. Slicer: PLA in einen CANVAS-Platz, PLA 230 °C, Einstellungen → Steuerung → Slicen „Entfernen der Einschränkung für gemischte Temperaturen“ (Elegoo-Profile: PLA 190–240 °C, PETG 230–270 °C → sonst gesperrt), Betttemperaturtyp „Nach der höchsten Temperatur“, Haube oben offen.
- **Variante B – gerichtete Brücken** `02r_modifier_deckel_bruecke_richtung.stl` (`deckel_bruecken_modifier()`): Modifier nur Schicht 5 (z 0,82–0,98) über den Vertiefungen + 0,4 mm. Grund im Quellcode (`LayerRegion::process_external_surfaces`): Brücken werden nur innerhalb des eigenen Bereichs um Wandbreite × √2 (bei 3 Wänden ca. 2 mm) in die massive Füllung ausgedehnt → eigener Bereich begrenzt die Brücke auf die Symbole. Dort Externe Brücken Füllrichtung 45° (Bett), längste Brücke 10,8 mm (berechnet für 0–150°, 45° = parallel zu den Linien der ersten Schicht; 60° Deckel ≙ 120° Bett wäre mit 9,5 mm am kürzesten). Dicke externe Brücken aus, Externe Brücken Dichte 110 %.
- **Für beide:** Modifier `02m` (Wandschleifen 1 in Schicht 1–4), Arachne, Überlappung des oberen/unteren massiven Füllung/Wand 25 %, Reinigungsvolumen ×1,5. C12 jetzt mit 5 Dateien (Kern, Haut, 02m-, 02p-, 02r-Gegenstück). `gcode_deckel_pruefung.py` meldet zusätzlich die Brückenrichtung.
- **Deckelspalt (Jan: zu viel Spiel, „1 mm breiter und höher“):** Modell: Öffnung 134,0 mm (Innenwand senkrecht vom Rand bis zur Auflage), Deckel 133,2 mm → 0,4 mm je Seite (`GAP_LID`, Probedruck). Sichtbar wirkt es breiter: oben 0,5-mm-Fase (`LID_EDGE_CH`) und Elefantenfuß 0,15 → an der Oberkante ca. 1 mm je Seite. 1 mm größer ginge nach Modell nicht hinein (134,2 > 134,0). **Offen (Jan messen):** Deckel außen x und y, Öffnung innen x und y unter dem Rand; was mit „höher“ gemeint ist (Tiefe von vorne nach hinten oder Deckel weniger tief eingesetzt, `LID_SINK` 1,2). Vorschlag nach Messung: Spalt 0,15–0,2 je Seite, Fase 0,3. `RING_OFF` hängt an `GAP_LID` → Deckelrahmen beim Ändern prüfen.
- **Ergänzung 22:10:** Jan hat kein PLA → **Variante B** (02r, Brücken 45°, Fäden bleiben als Stilmittel). Erklärbild `v4/out/deckel_vorher_nachher.png` (`v4/deckel_vorher_nachher_bild.py <gcode>`): Schicht 3 und 5 am Play-Knopf, echter G-Code gegen erwartetes Ergebnis. Rest-Unterschied zur Fläche außen: 0,4-mm-Saum um jedes Symbol (Brückenauflage) und eine Wand um jedes Loch.
- **Ergänzung 22:30 – G-Code C12 geprüft:** Einstellungen richtig (Arachne, dicke Brücken aus, Dichte 110 %, Überlappung 25 %, 02m Wandschleifen 1, 02r Füllrichtung 45°; Brücke tatsächlich nur noch über den Symbolen, 105 mm² statt Kreis, alle 45°). **Fehler:** beide Modifizierer hatten Filament 1 (weiß) behalten → Haut-Schichten mit Filament 1 statt Beige, und in Schicht 5 ein eigener weißer Bereich über den Symbolen mit „Overhang wall“. Behebung: Modifizierer → Rechtsklick → Filament wechseln → **Standard**. README ergänzt, `gcode_deckel_pruefung.py` warnt jetzt davor (Aufruf mit `c12` für die Probe).
- **Ergänzung 22:32 – Deckelspalt:** Jan: Maße bleiben wie sie sind (`GAP_LID` 0,4, `LID_EDGE_CH` 0,5). Offener Punkt Deckelspalt erledigt, nicht weiter verfolgen. C12 wird gedruckt (Modifizierer auf Filament „Standard“).

## Nachtrag 05.11.2026 (5) – Drehknopf über die volle Achse; Fuzzy beim Knopf

- **Entscheidung Jan:** Die Drehgeberachse wird **nicht** gekürzt (ersetzt 03.11. (5)). Der Knopf geht über die volle Achse.
- **Gemessen (Jan, finaler Korpus):** Achsende bis Mutter 20,2 mm, bis Mutterauflage 22,2 mm; Schlitz 11,3 tief. Gelesen als: 22,2 ab der glatten Fläche (0,4 unter der Wand) → `ENC_OUT` 21,8 über der Wand (Modell vorher 22,0). Liegt unter der Mutter eine Scheibe, ist die Achse 0,5 länger; dann sitzt der Knopf nur weiter außen. Mutter über der Auflage 2,0 (03.11.: 2,5) – für den Knopf ohne Einfluss, die Aussparung reicht bis zum Gewindeende.
- **Knopf neu (`drehknopf()`, `knob_geo()`):** Form unverändert (Ø 34, 24 Griffrillen, 2-mm-Fase vorn, Markierungsrille), jetzt **22,8 mm lang**, steht 23,8 mm über der Wand, ca. 24 g. Innen: **Führung Ø 6,3** im ungeschlitzten Teil (`KNOB_GUIDE`, federt dort nicht), **Klemmsitz Ø 6,1** nur im geschlitzten Teil (11,2 mm), **Steg 8 mm** im Schlitz (`KNOB_RIB`, vorher 4,5). Achsende liegt am Knopfboden an (`KNOB_TIP` 0, vorher 0,4 Luft) → bis Anschlag aufschieben, dann 1 mm Luft zur Wand. Geprüft mit Drucktaster (0,5 mm): kein Kontakt zu Gewinde, Mutter, Wand (auch mit 0,2 Fuzzy-Ausschlag). Bild `v4/out/drehknopf_schnitt.png` (`v4/drehknopf_bild.py`).
- Die Markierungsrille ist nur Zierde: Der STEC11B dreht endlos, sie zeigt keine Lautstärke an.
- **Fuzzy beim Knopf (Empfehlung): nein.** Griff kommt von den Rillen; Fuzzy (0,2) würde ihre Kanten verwischen. Alle orangen Bedienteile (Tasten, Ein-Taste) bleiben glatt, der beige Korpus ist körnig – bewusster Kontrast. Glatt lässt sich der oft angefasste Knopf besser sauber halten. Druck: Stirnfläche auf der texturierten PEI-Platte (gleiche Oberfläche wie die Tasten), Schichthöhe 0,12, Naht in eine Rille gegenüber der Markierung aufmalen, 3 Wände, 25 % Gyroid, keine Umrandung, Filament wie Deckel. Details: `v4/out/README.md`, Abschnitt Drehknopf.
- **Als Nächstes:** Knopf drucken (G-Code vorher prüfen lassen), Sitz auf der Achse bewerten (zu fest → `KNOB_BORE` 6,2; zu lose → 6,0).
- **Ein-Taste geprüft (Frage Jan):** passt zum aktuellen Deckel. Bohrung, Deckelstärke und Tasten-Maße seit 02.11. (3) unverändert; Kappe ∩ Deckel 0 mm³, Kappe oben bündig (z 138,8), Ringspalt 0,25, Stößel 0,05 über dem Taster. `08` ist seit 02.11. abends unverändert (ältere Drucke mit Mulde sind 1,5 mm kürzer). Empfehlung: `08` zusammen mit dem Knopf `07` drucken statt auf der Deckel-Platte (spart die Farbwechsel in Schicht 1–4).

## Nachtrag 05.11.2026 (5) – Probe C12 (Variante B) ausgewertet: freigegeben

- **Befund Jan (2 Fotos):** „deutlich besser, eigentlich wirklich perfekt“. Beige in den Kreisen wie die übrige Fläche, Fäden in allen Symbolen parallel (45°), Ringe sauber. Einziger Punkt: im Play-Dreieck tanzt ein oranger Faden aus der Reihe (wirkt gebrochen). Jan will diese Version für den großen Druck.
- **Einordnung:** Spannweite im Dreieck nicht auffällig (G-Code der ersten C12-Fassung: Bahnen über Luft bis 7,2 mm; „vor“ mit bis 10,8 mm sauber). Typisch für PETG: ein dünner Brückenfaden, der von der Düse mitgezogen wird oder durchhängt, solange er noch weich ist. Den zuletzt gedruckten G-Code (nach „Standard“) hat Claude nicht gesehen.
- **Maßnahme für den Deckel:** Brücke extern 30 mm/s (50), Lüfter für Überhänge und externe Brücken im orangen Filament 100 % (50; eigenes Filamentprofil nur für den orangen Platz, damit das Korpus-Profil bleibt). Dichte 110 % und 45° bleiben. README ergänzt.
- **Ablauf:** ganzer Deckel mit `02a`, `02b`, `02m`, `02r` (Modifizierer auf Filament „Standard“), G-Code und Projekt vor dem Druck an Claude.
- **Ergänzung 23:25 – G-Code Deckel geprüft (2 h 35 min):** Teile, Filamente, Brücke 30 mm/s, Brückenlüfter 100 % (Profil „… Peppa Deckel Orange“), Arachne, Dichte 110 %, Überlappung 25 % stimmen; Modifizierer auf „Standard“. **Aber:** in beiden Modifizierern fehlen die Einstellungen (02m ohne Wandschleifen, 02r ohne Füllrichtung) → wieder 3 Wände in der Haut, Brücke über 1403 mm² (ganzer Kreis), Richtungen gemischt. Nicht drucken; Einstellungen nachtragen, neu slicen. Prüfskript warnt jetzt bei genau diesen Fällen.
- **Ergänzung 23:32 – G-Code Deckel freigegeben (2 h 33 min, 76,9 g):** 02m Wandschleifen 1 und 02r Füllrichtung 45° jetzt drin. Haut Schicht 1–4 nur Beige, keine Innenwände; Schicht 5 Brücke nur über den Symbolen (755 mm² statt Kreis), alle 45°, 30 mm/s, Lüfter 100 %; keine Wände über den Vertiefungen; keine Umrandung, Naht hinten, ein Farbwechsel. Prüfskript ohne Warnung.

## Nachtrag 05.11.2026 (6) – Frontgitter mit neuem Logo im Modell (Druckdateien)

- **Neues Logo (Jan, 23:13):** `v4/gitter/peppa_box_logo.png` ersetzt die alte Vorlage; „exakt dieses Logo in Orange“. Vektorisierung `logo.py`: Rot minus Blau, Schwelle 113, 4-fach hochgerechnet; Übereinstimmung mit dem Bild 99,7 % (Abweichung < 0,1 mm), 11 Teile mit allen Innenformen. Bei 100 mm Breite sind die Lücken zwischen den Buchstaben an der engsten Stelle 0,6–0,9 mm („P|e“, „p|p“, „p|a“), die Innenformen zu klein für Löcher.
- **Entscheidungen Jan:** Gitter **beige**, Logo **orange** (wie das Bild; ein oranges Gitter hätte die Buchstaben verschmelzen lassen). Löcher außerhalb des Lautsprechers bleiben, Hell-dunkel-Unterschied wird **nicht** angemalt („So lassen“). Gitter darf nach vorn überstehen – derzeit nicht nötig, Reserve für den Klang (2 mm vor → 4,5 statt 2,5 mm Luft).
- **Gemessen (Jan):** Lautsprecherrahmen ca. 1,3 mm hinter der Gitterauflage (= Modell), Schraubenköpfe liegen dahinter. Sicke nicht gemessen.
- **Klang:** Das Logo deckt ⅔ der Lautsprecheröffnung; direkt davor nur 13 % offen (ohne Logo 57 %; Faustregel: unter ca. 30 % hörbar dumpfer). Lösung ohne sichtbare Änderung: Gitter über der Mulde hinten 1,2 mm dünner (`GR_PLENUM`) → **2,5 mm Luftraum**, der Schall erreicht alle Löcher vor der Mulde = 40 % der Öffnung. Ob das reicht, zeigt nur ein Hörtest.
- **Modell (`gitter()`, ersetzt `stoffrahmen()` in `build()`):** 3,6 mm dick, Vorderfläche 0,2 hinter der Front, liegt auf der Sitzfläche; Umriss folgt dem Sitz (schräge Oberkante, 0,3 Spiel, oben senkrecht zur Schräge), Fase 0,4 vorn. 400 Löcher Ø 3,3 im Wabenraster 4,2 (Steg 0,9 = 2 Linien), mittig, ganze Löcher entfallen am Rand (4,5), an der schrägen Oberkante hinten (1,2), um das Logo (1,2 beiger Rand) und an den Stiften. Logo 100 mm breit, Mitte (70, 76), **0,8 mm bündig eingelegt** (`06b`, nur Schicht 1–4, keine Vertiefung → keine Brücke, keine Fäden wie beim ersten Deckel), dahinter dichtes Beige. 6 Stifte Ø 3,9 × 2,4 mit Fase (Löcher im Korpus 4,1; Probedruck). Gewicht ca. 34 g beige + 2,6 g orange.
- **Druckbarkeit geprüft (`check.py`, `gitter_pruefung()`):** keine Kollision mit dem gedruckten Korpus, Überhang 0 mm², keine Stützen, Ausrichtung ohne Spiegelung (Vorderfläche auf der texturierten PEI, Oberkante nach hinten → Naht „Rückseite“ oben in jedem Loch). Schichtanalyse: Orange in genau 4 Schichten; schmaler als 1 Linie nur Spitzen/Ecken (< 1 mm² je Schicht). Der erste Luftraum-Rand ließ hinten Sicheln zwischen Rand und Löchern stehen → Rand läuft jetzt durch die Lochmitten (Dreiecke des Lochrasters), Löcher als um eine halbe Teilung gedrehte 32-Ecke → STL geschlossen, keine doppelten Ecken.
- **Neu bzw. geändert:** `06a_gitter_beige.stl`, `06b_gitter_logo_orange.stl`, `06_gitter_einfarbig_HOERPROBE.stl`, Coupon **C13** (`coupon_C13_gitter_ecke_beige` + `_logo_orange`, Ecke oben links mit P/e/p, engsten Lücken, Stift, ca. 10 g), Bild `out/gitter_ansicht.png`. `06_stoffrahmen.stl` und Stoff in der Einkaufsliste entfallen. Einstellungen „Gitter“ in `v4/out/README.md` (Basis Deckel: Arachne, eine Wand in Schicht 1, Wandüberquerungen vermeiden, 8 untere Schichten, Überlappung 25 %, keine Umrandung, Fuzzy aus, Reinigungsturm, Spülen ×1,5).
- **Neu gegenüber dem Deckel und noch nicht erprobt:** zwei Farben **in** den sichtbaren Schichten 1–4 (CANVAS wechselt in jeder davon). Darum zuerst C13.
- **Ablauf:** (1) C13 mit den Gitter-Einstellungen, Foto an Claude (Grenze Orange/Beige, Lücken, Härchen, Stift in der Korpus-Ecke). (2) Optional Hörprobe: `06_gitter_einfarbig_HOERPROBE` schnell einfarbig, einsetzen, Klang mit/ohne Gitter vergleichen. (3) Gitter `06a` + `06b`, G-Code vorher prüfen lassen.

## Nachtrag 06.11.2026 – Deckelrahmen geprüft, Schraubentabelle korrigiert

- **Frage Jan:** Ist der Deckelrahmen auf die Schrauben 3,0 × 12 angepasst? Ja, seit 03.11. (5) (Ring-Dome mit versenktem Senkkopf, Blöcke hinten). `03_deckelrahmen.stl` neu gebaut = identisch mit dem Repository; `check.py` ohne Kollision mit aktuellem Deckel und Satteldach-Korpus. Druck als Entwurf (0.28mm Extra Draft, 3 Wände, 15 % Gyroid, ohne Stützen/Fuzzy/Rand, Reste-PETG).
- **README:** Schraubentabelle war veraltet (3,0 × 14 / 3,0 × 8). Jetzt: 14 × 3,0 × 12 Senkkopf (Boden 6, Deckel hinten 2, Deckelrahmen 6), 8 × 3,0 × 12 Flachkopf (Lautsprecher 4 mit M3-Scheiben, Kartenfach 2, USB-C 2); Buchschraube Schaft Ø 7,5. Text C8 auf 3,0 × 12.

## Nachtrag 06.11.2026 (2) – Boden: Fuzzy-Rand wie am Korpus, Druck vorbereitet

- **Wunsch Jan:** Boden als Nächstes drucken, perfekt wie der Korpus und bündig zum Korpus (sichtbarer Rand).
- **Entscheidungen Jan:** Rand **mit Fuzzy** wie der Korpus; **keine Gummifüße**; **keine Ring-Probe** vorab, direkt den Boden drucken (Risiko bewusst: Kragen-Spiel `LIP_CLR` 0,2 ist ungeprüft, C8 nie ausgewertet).
- **Neu:** `05f_modifier_boden_FUZZY_rand.stl` (`modifier.py/boden_aussenhaut()`): 1 mm Haut nur auf dem senkrechten Streifen z 0,8–3,2 (zwischen Standkante-Fase und V-Fuge), beide Fasen glatt. Boden-STL unverändert (Volumen 80,2 cm³, ca. 100 g).
- **Geprüft:** Boden ↔ Korpus ohne Überschneidung, Einbau von unten mit Hubweg frei, Druckausrichtung ohne Spiegelung, Überhang 102 mm² (Decken der M2,5-Senkungen).
- **Einstellungen:** wie Korpus (README), dieselbe beige Rolle; Abweichungen: keine Umrandung, Naht an derselben Rundung wie der Korpus, keine Stützen. README-Abschnitt „Boden“.

## Nachtrag 06.11.2026 (3) – G-Code Boden geprüft

- Jan hat Projekt und G-Code geschickt: 37 Schichten, 1 h 46 min, 54,3 g, Profil „Elegoo Rapid PETG @ECC2 - Peppa“, Prozess „… - Peppa“. Prüfwerkzeug neu: `v4/gcode_boden_pruefung.py`.
- **In Ordnung:** Modifier 05f deckungsgleich (z 0,8–3,2), Fuzzy „Kontur“ nur in Schicht 5–16 (±0,2 um die Linienmitte, 0,2/0,3 klassisch wie Korpus), Fasen unten (Schicht 1–4) und oben (17–20) glatt und maßhaltig; Elefantenfuß 0,15; 3 Wände, Gyroid 15 %, oben konzentrisch; Lüfter an der Außenkontur durchgehend 20 %, erste 3 Schichten aus; Bett 80/75 °C; keine Umrandung, keine Stützen, kein Reinigungsturm; Schichtdauer im Fuzzy-Streifen gleichmäßig ca. 69 s.
- **Naht:** aufgemalt, liegt an der Rundung **hinten links** (von vorn gesehen; Modell x ≈ 8, y ≈ 137,5), alle Schichten gleich. Laut Nachtrag 04.11. (4) hatte Jan beim Korpus **hinten rechts** bemalt; welche Ecke der finale Korpus hat, ist hier nicht belegt → Jan fragen.
- **Düse 250 °C** (Profil). Beim Korpus 04.11. waren 235/240 °C eingestellt (Nachtrag 04.11. (4), Rückfrage offen) → gleiche Temperatur wie der finale Korpus nehmen (Glanz/Farbton an der Fuge).
- Hinweis: Schicht 16 (erste massive Schicht über der Füllung, interne Brücke) dauert ca. 9,5 min; die Außenwand danach ist schon die glatte obere Fase (Kante der V-Fuge) → unkritisch.

## Nachtrag 06.11.2026 – C13 ausgewertet: Logo als eigene, erhabene Buchstaben, Gitter einfarbig

- **Befund Jan (3 Fotos, 17:55):** sehr viele Fäden in den Löchern (wie Spinnweben, von vorn sichtbar), Fehler im Orange (unten am „p“), hinten ein dunkler Fleck (kein schwarzes Filament vorhanden) → nicht hochwertig, nicht abgenommen. Gut: Stege zwischen den Löchern, scharfe Buchstabenkanten, schmale beige Lücken zwischen den Buchstaben.
- **Einordnung:** (1) Fäden = Fahrten über die 400 Löcher in 18 Schichten, unabhängig von der Druckrichtung (Ursache offen: Feuchte, 250 °C, Rückzug/Z-Hub; G-Code folgt). PETG nicht getrocknet, seit 3 Tagen offen. (2) Orange-Fehler = Start nach dem Farbwechsel mitten in der Sichtfläche (das Risiko, für das C13 da war). (3) Fleck = sehr wahrscheinlich verbranntes PETG von der Düse, gesammelt bei den Wechseln.
- **Vorschlag Jan:** andersherum drucken, Fuzzy auf der Fläche, Schriftzug erhaben (3D-Effekt). Bewertet: Fuzzy wirkt nur auf Wände, nicht auf eine Deckfläche; mit der Rückseite auf der Platte stehen die 6 Stifte nach unten und der Luftraum (80 mm breit) wäre nur mit Stützen druckbar; Fäden blieben. Der 3D-Effekt selbst ist gut.
- **Entscheidung Jan (18:09):** Buchstaben kleben. Gitter als ein Modell (einfarbig beige), alle Buchstaben als ein Modell (gleichzeitig drucken).
- **Modell (`gitter()`, `gitter_buchstaben_cs()`, `gitter_stifte()`, `buchstaben_druck()`):** Einleger `GR_INLAY` entfällt. Buchstaben 1,2 mm dick (`GR_LETTER_T`), liegen plan auf der glatten Gitterfläche, stehen 1,0 mm vor der Korpusfront. Je Buchstabe 2 runde Stifte Ø 2,0 × 1,0 mit Fase, möglichst weit auseinander (verdrehsicher), dort, wo der Buchstabe am breitesten ist; die 3 Strahlen je 1 Stift in ihrer eigenen Form (0,7 kleiner). Sacklöcher im Gitter: Spiel 0,2 je Seite, 0,3 tiefer, mindestens 0,4 unter dem Buchstabenrand verdeckt (`GR_PEG`, Probedruck). Jedes Teil passt nur in seine Löcher (auch die beiden „p“ unterscheiden sich). Buchstaben-Druck: alle 11 Teile in Logo-Reihenfolge auseinandergezogen (mindestens 4 mm Abstand), Sichtseite auf der PEI, Unterkante hinten (Naht „Rückseite“ unten am Buchstaben).
- **Geprüft:** keine Kollision, Stifte ∩ Gitter 0, Ausrichtung ohne Spiegelung, alle STL geschlossen (Versätze mit `simplify`, sonst doppelte Ecken). Gitter Schicht 1 ohne Stege unter 0,4 mm; Buchstaben Schicht 1 nur Spitzen/Ecken (0,63 mm²). Überhang Gitter 114 mm² = Böden der Sacklöcher (Ø 2,4, unsichtbar). Klang unverändert (13 % direkt, 40 % über den Luftraum).
- **Dateien:** `06a_gitter_beige.stl` (ca. 36 g), `06b_logo_buchstaben_orange.stl` (ca. 4 g), Coupon **C14** (`coupon_C14_gitter_ecke_beige` + `coupon_C14_buchstaben_P_e_p_orange`, ca. 12 g) ersetzt C13; `06_gitter_einfarbig_HOERPROBE` entfällt (das Gitter ist jetzt selbst einfarbig; Hörtest mit dem Gitter vor dem Kleben). README Abschnitt „Gitter“ neu (Einkleben: trocken probieren, Kleber nur in die Sacklöcher, am besten 5-Minuten-Epoxid).
- **Sparen:** kein Reinigungsturm, kein Spülmaterial, keine Farbwechsel-Zeit mehr.
- **Als Nächstes:** G-Code und Projekt von C13 auswerten (Rückzug, Fahrwege über Löchern, Z-Hub, Temperatur) → Einstellungen gegen Fäden; Rollen trocknen; dann C14.

## Nachtrag 06.11.2026 (2) – Variante A bleibt, keine losen Löcher im Logo-Feld

- **Frage Jan:** Löcher überall und die Buchstaben darauf kleben? Verglichen (Bild nur im Chat): B = 680 Löcher, direkt offen 29 % statt 13 %, aber 70 % mehr Fahrten über Löcher (Fäden), Buchstaben auf dunklem Lochfeld, angeschnittene Löcher an den Kanten. **Entscheidung Jan: A** (beiges Feld um die Buchstaben).
- **Wunsch Jan:** die losen Einzellöcher im beigen Feld weg (über dem P, zwischen e|p und p|a oben, zwischen a und X, im Dreieck des O, unter B|O).
- **Geändert (`GR_HALO` 16):** Das beige Feld ist die Logo-Kontur, mit R 16 geglättet (füllt Kerben, Lücken und Innenformen), plus 1,2 mm Rand; danach entfallen am Feldrand alle Löcher mit höchstens 2 Nachbarn (wiederholt). 400 → 377 Löcher; offen direkt 11 % (vorher 13 %), über den Luftraum 37 % (vorher 40 %). Bild `out/gitter_vorne_nah.png`.
- Neu gebaut: `06a_gitter_beige.stl`, `coupon_C14_gitter_ecke_beige.stl`; Buchstaben unverändert. Prüfungen ohne Kollision, STL geschlossen.

## Nachtrag 06.11.2026 (3) – Klangoptimiertes Gitter, Logo über und unter dem Lochfeld

- **Auftrag Jan (18:44):** zum Schluss ein Gitter, das optimal für den Klang ist, optisch ansprechend und mit seinem Drucker perfekt druckbar; Größe und Anordnung des Logos bewusst frei.
- **Grundsatz:** Schall kommt nur dort heraus, wo hinter dem Gitter der Lautsprecher sitzt; außerhalb liegt die Sitzfläche (Löcher dort sind wirkungslos und wirkten heller als die vor dem Lautsprecher). Darum: **Lochfeld nur und ganz vor dem Lautsprecher, Logo außerhalb.**
- **Lochfeld (`gitter_holes()`, `GR_FIELD_R` 37,5, `GR_RINGS` 4,2):** rund, deckt den Ausschnitt Ø 73 ab (Membran-Ø nicht gemessen → nicht kleiner). Verglichen: Waben 253 Löcher/52 % offen (eckiger Umriss), Sonnenblumen-Spirale 40 %, Waben mit Außenring (unruhiger Übergang), **konzentrische Ringe 222 Löcher/46 %** mit Mittelloch, jeder Ring zum inneren versetzt – runder, ruhiger Umriss, Unterschied zu Waben < 1 dB. Gewählt: Ringe. Steg überall ≥ 0,9 mm. Lochgröße 3,3 bleibt (Kinderfinger/Stifte).
- **Logo (`gitter_layout()`, `GR_LAYOUT`):** „peppa“ über, „BOX“ unter dem Lochfeld, gleicher Maßstab, so groß wie möglich (Abstand 2,5 zum Feld, 3,5 zum Gitterrand): **Maßstab 0,644** (peppa ca. 57 × 17 mm, BOX ca. 41 × 16 mm). Strahlen in Größe und Richtung wie im Logo, nur so wenig wie nötig verschoben (7,0 mm rechts, 6,4 mm tiefer), damit sie neben dem „a“ im Feld bleiben. Buchstaben je 2 Stifte Ø 2,0; die Strahlen (Breite ca. 2 mm) ohne Stift in einer flachen Tasche (1 Schicht, `GR_POCKET`), 0,2 dicker, gleiche Sichthöhe.
- **Klang (Abschätzung, Lochplatte als Luftmasse, `daempfung()` in check.py):** offen direkt vor dem Lautsprecher 45 % (vorher 11 %); Dämpfung 2 kHz 0,3 dB, 5 kHz 1,5 dB, 10 kHz 4,3 dB (vorher 2,4 / 7,6 / 13,0 dB). Kein Luftraum mehr nötig: Gitter überall 3,6 mm, dadurch steif; 1,3 mm Luft bis zum Lautsprecherrahmen (gemessen).
- **Druck:** weniger Löcher (222 statt 377) = weniger Fahrten über Löcher (Fäden), keine Farbwechsel. Gitter ca. 51 g, Buchstaben ca. 2 g (Platte 94 × 46 mm, „BOX“ dicht unter „peppa“). Prüfungen: keine Kollision, Überhang Gitter 72 mm² (nur Böden der Sacklöcher), Sichtfläche ohne Stege unter 0,4 mm, alle STL geschlossen. Kleinste Details der Buchstaben: e-Schlitz an der engsten Stelle unter 0,9 mm (in C15 enthalten).
- **Coupon C15** (`coupon_C15_gitter_oben_beige` + `coupon_C15_buchstaben_peppa_orange`, ca. 26 g): obere Gitterhälfte mit halbem Lochfeld, „peppa“ und Strahlen, 2 Stifte. Ersetzt C14. Bilder `out/gitter_ansicht.png`, `out/gitter_vorne_nah.png`.
- **Als Nächstes:** G-Code C13 auswerten → Einstellungen gegen Fäden; Rollen trocknen; C15; dann Gitter und Buchstaben (G-Code vorher prüfen lassen); vor dem Kleben Probe hören.

## Nachtrag 06.11.2026 (4) – Entscheidung: Variante A bleibt (klangoptimierter Entwurf zurückgenommen)

- Das klangoptimierte Gitter aus Nachtrag (3) gefiel Jan optisch nicht. Vier weitere Entwürfe nur als Bild (nicht im Modell): 1 „Bildschirm“ (großes Logo schwebt 2,5 mm vor dunklem Lochfeld), 2 „Scheibe“ (Logo quer über runder Lautsprecherscheibe, schwebend), 3 „Radio“ (runder Lautsprecher mit orangem Ring, Schriftzug einzeilig darunter), 4 „Emblem“ (Schrift im Bogen). Skript `scratch` nicht im Repository.
- **Entscheidung Jan (19:11): keiner davon – es bleibt Variante A mit geglättetem Logo-Feld** (Stand Nachtrag (2), Commit 8a9efd7): Logo groß in der Mitte, beiges Feld (`GR_HALO` 16), 377 Löcher, Luftraum 2,5 mm, Buchstaben 1,2 mm erhaben mit Stiften aufgeklebt.
- Modell, Prüfungen, STL-Dateien und Bilder per `git revert` auf diesen Stand zurückgesetzt (C15 entfällt, C14 gilt wieder). Klang nach Abschätzung: direkt 11 % offen, über den Luftraum ca. 37 %; Hörtest mit dem Gitter vor dem Kleben bleibt wichtig. Reserve, falls es dumpf klingt: Gitter 2 mm vorstehen lassen (Luftraum 4,5 statt 2,5 mm).

## Nachtrag 06.11.2026 (5) – Druckeinstellungen Gitter gegen Fäden (ohne G-Code C13)

- **Jan (19:34/19:40):** an der Düse hängen Fäden; Frage nach Reinigungsfunktion; will jetzt die optimalen Einstellungen für `06a`, ohne auf die G-Code-Auswertung zu warten. PETG nicht getrocknet (3 Tage offen).
- **Reinigung:** CC2 hat hinten einen Silikon-Düsenwischer (Startablauf), Ersatzwischer und Reinigungsnadeln im Werkzeugset; eigene Menüfunktion nicht belegt. Vorgehen: auf 250 °C heizen, Fäden mit Pinzette/Messingbürste ab, PETG-Reste am Wischer und an der Silikonhülle entfernen (vermutete Quelle des verbrannten Flecks auf C13), Wischer bei platten Borsten tauschen.
- **Einstellungen (README Abschnitt „Gitter“, Namen aus ElegooSlicer de.po):** Basis Deckel-Prozess; Vermeiden von Wandüberquerungen an, Maximale Umleitungslänge 0; Außenwand 40 mm/s; eigenes Filamentprofil „… Peppa Gitter“: Düse 245/240 °C, Lüfter 35 % fest, erste 3 Schichten ohne; Überschreiben: Rückzug 1,0 mm, 40/30 mm/s, beim Schichtwechsel an, Wischen an 2 mm / 70 %, Schwellenwert Fahrstrecke 0,5 mm, Z-Hub 0,2 Normal. Rolle trocknen ist die wichtigste Maßnahme. Werte sind begründete Startwerte, nicht am C13-G-Code geprüft → G-Code vor dem Druck an Claude, ideal zuerst C14.

## Nachtrag 07.11.2026 – Gitter gedruckt: Härchen überall; Buchstaben-Test mit neuer oranger Rolle

- **Befund Jan (11:56):** Gitter `06a` mit den Einstellungen aus Nachtrag 06.11. (5) gedruckt: sehr viele feine Härchen überall, Druck unsauber, trotz gereinigter Düse. Jan vermutet zu feuchtes beiges Filament (nicht getrocknet). Passt zum Bild (Härchen überall, nicht nur an einzelnen Stellen). Nicht abgenommen.
- **Als Nächstes Gitter:** beige Rolle trocknen, dann erneut (Fotos und G-Code an Claude; C13- und Gitter-G-Code auswerten, falls es bleibt).
- **Buchstaben-Test** mit neuer oranger Rolle: vollständige Einstellungsliste in `v4/out/README.md` (Abschnitt „Gitter“ → Buchstaben). Schichthöhe 0,2 (Buchstaben = 6 Schichten, Stifte 5; weniger Fahrten zwischen den 11 Teilen), Fülldichte 100 %, sonst wie Gitter (245/240 °C, Lüfter 35 %, Rückzug 1,0 mm 40/30, Wischen 2 mm/70 %, Z-Hub 0,2).

## Nachtrag 07.11.2026 (2) – Kartenfach: Schrauben geprüft, Rastung der Karte neu

- **Frage Jan:** Ist das Kartenfach auf die Schrauben 3,0 × 12 ausgelegt? Ja (seit Anfang so modelliert): Flachkopf von unten, 8 mm Flansch (`POCKET_GRIP`), 4 mm im Deckel, Spitze 0,5 mm vor dem Ende des Kernlochs (4,5 tief), darüber 2 mm Deckel. Senkung Ø 6,8 für Kopf Ø 6.
- **Befund Jan:** Die Karte hält kaum, lässt sich sehr leicht herausziehen; vermutlich fehlt ein Gegenstück in der Karte. Bestätigt im Modell: Die Nase der Federzunge stand genau 0,8 mm hoch = Luft zwischen Kartenfläche und Vorderwand → **0 mm Überdeckung**, die Zunge berührte die Karte nur, und die Karte hatte keine Vertiefung.
- **Neu (Modell, Parameter `RAST_*`, `RILLE_*`, `KARTE_FASE`):**
  - Nase 1,5 mm hoch, also **0,7 mm über der Kartenfläche** (`RAST_UEB`). Flanke zur Öffnung 30° (leichtes Einstecken), flache Spitze 0,8, Flanke zum Boden 45°. Endet 0,2 mm vor dem freien Zungenende.
  - Karte: **Rille vorne** quer, 20 mm lang, 0,9 mm tief (`RILLE_T`), mittig über der Nase; Auszugsflanke `RAST_ALPHA` (Standard 30°, Probedruck). Steht die Karte auf dem Fachboden, liegt die Nase entspannt in der Rille (0,3 mm Spiel zur Flanke, 0,2 mm zum Rillengrund) → kein Kriechen der Zunge. Steht die Karte etwas hoch, drückt die Flanke sie auf den Boden.
  - Karte: **Einführfase 30°** vorne an der Unterkante (0,8 mm), schiebt die Nase beim Einstecken weg.
  - Rechnung (Zunge 1,4 × 20,4 mm, Hebel ca. 17 mm, E 1500–2200 MPa geschätzt, Reibung 0,3): Auszug ca. 2–3 N (20°), 3–4,5 N (30°), 4,5–6,5 N (40°); Einstecken ca. 3–4,5 N; Biegespannung ca. 11 MPa nur beim Durchrasten. Karte wiegt ca. 0,2 N.
  - Restwand der Karte zwischen Rille und NFC-Tasche 2,3 mm.
  - Gesteckte Karte im Modell steht jetzt auf dem Fachboden (`CARD_FLOOR` = 42,5) statt 0,5 mm darüber; Fenster der Covertasche beginnt damit 1,0 mm über dem Deckel.
- **Geprüft:** `check.py` ohne Kollision (auch Karte ↔ Kartenfach), Abstände unverändert; Profil Nase/Rille nachgerechnet (Federweg 0,7 mm, Steigung = tan α). Neu gebaut: `04_kartenfach.stl`, `10_karte_orange.stl`; alle anderen STL unverändert. Schnittbild `v4/out/rastung_schnitt.png` (`v4/rastung_schnitt.py`).
- **Neu Coupon C15** (`coupon_C15_karte_rastung_20grad/_30grad/_40grad`): untere 60 mm der Karte, 1/2/3 Kerben oben, je ca. 8 g. Mit dem neuen Kartenfach testen: Klick, kopfüber schütteln, Herausziehen durch das Kind. Ergebnis → `RAST_ALPHA`, dann Karten drucken.
- **Folge:** Bereits gedruckte Karten haben keine Rille. Im neuen Kartenfach drückt die Nase dauerhaft 0,7 mm auf sie (hält durch Reibung, Zunge bleibt gespannt) → neu drucken, sobald der Winkel feststeht.
- **Ablauf:** 1. `04_kartenfach.stl` drucken (Einstellungen wie bisher, auf der Seite, Brim). 2. C15 (drei Stücke) drucken und testen. 3. Winkel melden, Karten drucken.

## Nachtrag 07.11.2026 (3) – Gitter: Schlitze der drei Strahlen enger

- **Befund Jan (Druck Gitter + Buchstaben):** Runde Stifte der Buchstaben sitzen sehr gut in ihren Sacklöchern; die drei Strahlen über dem „a“ sitzen in ihren Schlitzen spürbar locker.
- **Modell geprüft:** Die Schlitze liegen vollständig unter den Strahlen (Abstand zum Rand 0,5 mm, nichts ragt heraus). Ursache ist das Spiel: Strahl ca. 3,0 mm breit, geformter Stift bis 1,6 mm breit (Strahl 0,7 kleiner), Schlitz bis 2,0 mm → 0,2 mm je Seite wie bei den runden Stiften. Bei einem dünnen, spitz zulaufenden Stift ist das relativ viel; runde Löcher drucken zudem eher etwas enger als gerade Schlitzwände.
- **Neu:** Parameter `GR_FORM_SPIEL` = 0,1 (Probedruck) nur für die geformten Stifte; Schlitz = Strahl 0,6 kleiner (Fläche je Schlitz ca. 11,4 / 13,0 / 12,6 statt 13,0 / 14,8 / 14,3 mm²). Runde Stifte bleiben bei 0,2.
- **Unverändert:** `06b_logo_buchstaben_orange.stl` (die gedruckten orangen Teile passen). Neu gebaut: `06a_gitter_beige.stl`. `check.py` ohne Befund, STL dicht.
- **Vor dem Neudruck:** beiges PETG trocknen (Härchen/Lücken im letzten Druck). Sitzen die Strahlen dann zu stramm: Stift kurz mit Schleifpapier anfasen, nicht den Schlitz aufbohren.

## Nachtrag 07.11.2026 (4) – Kartenfach: Schrauben von unten frei, Nase mit 45°-Enden, Druck zusammen mit C15

- **Befund Jan (Slicer-Ansicht):** Die Schrauböffnung unten ist mit dem Schraubendreher kaum erreichbar. Ursache: Die Senkung Ø 6,8 ging nur 40 mm nach unten und endete ca. 8 mm über der Unterkante des Kartenfachs (z 89,8, Unterkante 81,8). Das untere Stück des Seitenteils (Verlängerung des Fachbodens) lag in der Säule unter dem Kopf.
- **Behebung:** Senkung bis ganz unten durch (`kartentasche()`, beide Schrauben). Säule Ø 6 von unten bis zum Kopf frei (geprüft: 0 mm³ im Weg). Weg ca. 43 mm: Schraubendreher mit mind. ca. 5 cm freiem Schaft, dünner als 6 mm (Bithalter meist zu dick). Kein großer Eckausschnitt: Das Seitenteil liegt beim Druck auf der Platte, ohne es hinge die Kartenschacht-Wand ca. 7 mm in der Luft. Am Austritt bleiben kleine dünne Reste (Schichtanalyse: +43 mm² schmaler als 2 Linien, über alle Schichten zusammen).
- **Rastnase:** Enden 45° angeschrägt (im Druck steht u senkrecht, vorher 1,5 mm waagerechter Überhang am unteren Ende). Kraftrechnung unverändert.
- **Frage Jan: Warum liegt die STL „nicht richtig gedreht“?** Absicht: hochkant auf dem Seitenteil (88,5 mm hoch). Schacht als senkrechter Schlitz ohne Stützen, RC522-Schienen ohne Stütze, Federzunge in der Schichtebene (biegt entlang der Bahnen).
- **Druck zusammen mit C15:** ja, alle vier Teile auf einer Platte aus derselben Rolle (sonst Filamentwechsel in jeder Schicht der unteren 4 mm). Vollständige Einstellungen in `v4/out/README.md` (Abschnitt „Kartenfach + C15 auf einer Platte“): Profil 0.20mm Standard, Elefantenfuß 0,15, 3 Wände, 15 % Gyroid, erste Schicht 30 mm/s, Rand nur Außenrand 5 mm / 0,1 (C15 je Objekt ohne Rand), Bett 80/75 °C, Kühlung Profilwerte (nicht die 70-s-Korpus-Kühlung), Rolle trocknen. Karten später auch mit 0,2 mm und Bügeln nur „Oberste Oberfläche“.
- **Geprüft:** `check.py` ohne Kollision; neu gebaut nur `04_kartenfach.stl` (+ Ansichten).

## Nachtrag 07.11.2026 (5) – Niederhalter für die Steckkabel auf der gelben Stiftleiste

- **Wunsch Jan:** Steckkabel auf den gelben Stiften (P26 usw.) gegen Abrutschen sichern. Sekundenkleber verworfen (kriecht in die Buchse). Entscheidung Jan: gedruckter Steg (Niederhalter), Vorgaben Jan: Säulen ca. Ø 6 auf den beiden freien Löchern, Dach ca. 20 mm breit über die ganze Platinenlänge 65 mm, Dach kräftig.
- **Maße Jan:** Lochabstand **58** (Lochmitte zu Lochmitte; zuerst 53 genannt), Loch ca. 2,7–2,9, Platine bis Oberkante Steckergehäuse **12** (ohne Kabel), Gehäuse 2,5 × 2,5, Lochmitte bis erster Stift ca. 4,5 (längs), Lochlinie bis Leiste ca. 5,3 (quer), symmetrisch. Die beiden freien Löcher sind die HAT-Löcher an der Vorderkante (Pi-Leiste liegt auf der Lochlinie); Lage im Modell aus `stack_holes()`.
- **Modell (`niederhalter()`, Parameter `NH_*`):** Dach 65 × 20 × 4 (1,5 mm über die Platinenvorderkante, damit vor der Senkung 2 mm Wand bleiben), Unterseite 12 + 2,0 über der Platine. Kabel direkt über dem Stecker zur Seite knicken (äußere Reihe nach vorne, innere nach hinten); das Dach drückt über den Knick. Säulen Ø 6, Loch 2,9, Senkung oben Ø 5,6 × 2 für M2,5 Linsen-/Flachkopf. Hintere Dachecken auf 17 mm Länge nur 15 mm tief (Klemmblöcke der Schmalseiten, Lage aus Foto geschätzt). Druck: Dachoberseite auf der Platte, keine Stützen, 6,5 g.
- **Geprüft:** keine Kollision (Platinenhöhe im ungünstigsten Fall), Boden-Einbau von unten frei, Abstand zum Korpus 3,0, zum Kartenfach 35. Bild `out/niederhalter.png` (`v4/niederhalter_bild.py`). Druckeinstellungen vollständig in `v4/out/README.md`. STL `11_niederhalter_stiftleiste.stl`.
- **Offen (Jan):** (1) Höhe Platine bis Oberkante des zur Seite geknickten Kabels messen → `NH_KABEL` (vorläufig 2,0). (2) Unter den freien Löchern Abstandsbolzen oder Platz für eine Mutter? (3) Schrauben: 2 × M2,5 × 20 Linsen-/Flachkopf + 2 Muttern, mit den 4 × M2,5 für den Stapel zusammen bestellen.

## Nachtrag 07.11.2026 (6) – Kartenfach: Slicer-Warnung „schwebende Überhänge“, Druckzeit 6 h

- **Befund Jan (Screenshot ElegooSlicer, Platte Kartenfach + 3 × C15, Filament „Elegoo Rapid PETG“):** Warnung „schwebende Überhänge“ bei `04_kartenfach.stl`; Druckzeit 5 h 57 min, davon innere Wand 2 h 58 min und Außenwand 1 h 1 min bei nur 4,6 m bzw. 3,2 m Filament. Frage: Ist der Druck ohne Brücken/Stützen richtig, ist das nicht unnötig lang?
- **Schwebend war die Unterseite der Federzunge:** Im Druck liegt die Zunge waagerecht (u senkrecht), 1,4 × 19 mm, nur an der Wurzel gehalten, 0,8 mm über dem Schlitzboden. Schichtanalyse (je 0,2-mm-Schicht, nicht gestützte Fläche): sonst nur kurze, beidseitig gehaltene Brücken (Schachtende 4,8 mm, Schlitz über der Zunge 20 mm), Bögen der waagerechten Schraubenbohrungen und ein 1-mm-Absatz am RC522-Anschlag.
- **Behebung:** Steg unter der Zungenspitze (`ZUNGE_STEG` 1,4 mm lang, 1,4 dick, im unteren Schlitz). Die Unterseite ist jetzt eine Brücke von ca. 17 mm mit Auflage an beiden Enden (geprüft). **Nach dem Druck Steg mit dem Cutter durchtrennen.** Stützen bleiben aus.
- **Druckzeit:** Ursache ist die Korpus-Kühlung im Filamentprofil (Schichtdauer 100 s / 70 s → jede der 442 Schichten mind. 70 s, Wände unter 1 mm/s). Für das Kartenfach das Systemprofil der Rolle mit Werkswerten nehmen. 0,2 mm bleibt (Schlitze 0,8 mm = 4 Schichten; C15 muss wie die späteren Karten gestuft sein).
- **Geprüft:** `check.py` ohne Kollision; neu gebaut nur `04_kartenfach.stl` (+ Ansichten). README-Abschnitt „Kartenfach + C15“ ergänzt.

## Nachtrag 07.11.2026 (7) – Niederhalter: passt für die vorhandene Pi-Schraube

- Jan hat vom Pi noch M2,5-Schrauben, Flachkopf, ca. 19,2 inkl. Kopf (→ ca. 17,2–17,7 unter dem Kopf). Mit der Senkung 2 mm hätten sie nicht einmal die Platinenunterseite erreicht (nötig 17,6 bis dort). Geändert: Senkungsboden tief auf **12,9 über der Platine** (`NH_SENK` = Ø 5,6 / 12,9), Säule ab dort als Kragen **Ø 7,2** (`NH_KRAGEN`, Wand 0,8; darunter Ø 6). Schraube reicht 2,7–3,2 unter die Platine → Mutter (2,0) oder Abstandsbolzen. Länge jetzt unabhängig von `NH_KABEL`. Kein Schraubenkauf nötig. Kragen 0,9 über der Steckeroberkante, Abstand zum Kabel des ersten Steckers ca. 0,1–0,5. Prüfungen ohne Kollision. **Offen:** Kopf-Ø ≤ 5,2? Passende Muttern im Pi-Set?

## Nachtrag 07.11.2026 (4) – Gitter: Fäden trotz getrocknetem Filament

- **Befund Jan:** Mit getrocknetem beigem Rapid PETG etwas besser, aber weiter Fäden an den Löchern.
- **Schichtanalyse `06a` (Druckausrichtung):** Schichten 1–12 je ca. 380–400 Lochkonturen, Schichten 13–18 je 172, zusammen ca. 5.700 Konturen = so viele Rückzüge/Fahrten. Danach 12 Schichten (2,4 mm) nur die 6 Stifte Ø 3,9 → lange Fahrten quer über die Rückseite, Fäden liegen über den Lochöffnungen.
- **Slicer (README Gitter angepasst):** Düse 235 / 230 °C statt 245 / 240, Z-Hub 0 statt 0,2. Beim Abgleich der Screenshots außerdem noch falsch eingestellt: Nahtposition (Ausgerichtet → Rückseite), Füllung erste Schicht (105 → 50 mm/s), Verlangsamen bei Überhängen (an → aus).
- **Offen (Vorschlag, nicht umgesetzt):** Stifte vom Gitter trennen, separat mitdrucken und in 1,2 mm tiefe Löcher der Gitterrückseite kleben → keine reinen Fahrschichten mehr, Gitter nur 3,6 mm hoch. Entscheidung Jan nach dem nächsten Druck.
- **Düse prüfen:** Strang bei 240 °C von Hand fördern (gerade = gut, seitlich/stockend = teilverstopft, würde auch Lücken erklären); PETG-Kruste außen entfernen. Härchen am fertigen Teil: kurz mit Heißluft darüber.

## Nachtrag 07.11.2026 (5) – Gitter-G-Code ausgewertet: Stege 1,4 statt 0,9 (Variante B)

- **G-Code Jan** (`06a`, ElegooSlicer 1.5.3.5, 2 h 53 min) ausgewertet: Einstellungen wie README (235/230 °C, Z-Hub 0, Naht hinten usw.), nur „Nur eine Wand in der ersten Schicht“ stand aus.
- **Ursache der Fäden:** Jede Leerfahrt gegen den Schichtquerschnitt geprüft → ca. **62.000 Fahrten quer durch Löcher** (ca. 4.000 je Schicht), dazu 41 gerade Fahrten durch ganze Lochreihen (bis 100 mm, v. a. oberste Reihe). Quellcode OrcaSlicer (`AvoidCrossingPerimeters.cpp`, `get_boundary`): Die Sperrfläche ist jedes Loch + 1,5 × Linienabstand (ca. 0,61 mm je Seite, Schicht 1 mit Linienbreite 0,5 ca. 0,69 + Elefantenfuß). Bei Steg 0,9 verschmelzen die Löcher → nur 19 von 393 Löchern wurden umfahren, im Lochfeld fährt der Slicer geradeaus.
- **Entscheidung (Empfehlung, Jan „Variante egal“):** Variante **B**: Löcher Ø 3,3 wie bisher, Teilung **4,7** statt 4,2 → Steg 1,4, **297 Löcher** (vorher 377). Variante A (Ø 2,8 / 4,2) verworfen: kleinere Löcher, mehr Rückzüge, loses Lochgrüppchen am „p“. Offene Fläche vor dem Lautsprecher 9 % (vorher 11 %), über die ganze Mulde 29 % (vorher 37 %).
- **Slicer neu (README):** Linienbreite erste Schicht 0,45 (0,5), Elefantenfußkompensation 0 (0,15) – sonst sind die Stege in Schicht 1 wieder zu schmal.
- **Geprüft:** Nachbildung der Slicer-Sperrfläche auf der neuen STL: Schicht 1–18 alle Löcher einzeln umfahrbar (Schicht 1 nur mit 0,45 / EF 0). `check.py` ohne Befund, STL dicht. Neu: `06a_gitter_beige.stl`, `coupon_C14_gitter_ecke_beige.stl`, `gitter_ansicht.png`. Buchstaben `06b` unverändert (Sacklöcher unverändert).
- **Offen:** Stifte abtrennen und einkleben (12 Schichten nur Fahrten zwischen 6 Stiften, ca. 4 m quer über die Rückseite) – Entscheidung Jan.

## Nachtrag 07.11.2026 (6) – Erste Schicht des Gitters: Lücken in den Stegen

- **Befund Jan:** In bisherigen Drucken in der ersten Schicht große Fehler, Lücken in den Stegen, Fehler im Lochmuster.
- **G-Code Schicht 1 ausgewertet:** Der Slicer hat die Fläche vollständig geplant (nur 0,7 % unbelegt, winzige Zwickel an den Stegkreuzungen). Jeder Steg (0,9) bestand aber aus genau **zwei Linien à 0,5 mm, je eine vom Ring des Nachbarlochs** (Mitten ±0,22 mm), dazu 1.092 einzelne Pfade (Mittel 19 mm) mit je Rückzug, Wischen und Wiederanfahren. Setzt ein Ring am Anfang nicht sauber ein oder haftet nicht, bleibt im Steg eine Linie oder eine Lücke. Dazu fuhr der Slicer ca. 4.500-mal quer durch Löcher.
- **Neues Gitter (Steg 1,4, 297 Löcher):** drei Linien je Steg, ein Fünftel weniger Ringe, Fahrten bleiben auf Material.
- **Korrektur Einstellung:** „Nur eine Wand in der ersten Schicht“ für das Gitter **aus** lassen (Empfehlung von vorhin zurückgenommen), sonst viele kurze Bodenlinien zwischen den Ringen.
- **Ohne Modellbezug:** Haftung auf der texturierten PEI (Platte mit Spülmittel, nicht anfassen), Z-Versatz der ersten Schicht, trockenes Filament. Test: C14 drucken und nach 2 Schichten abbrechen.

## Nachtrag 07.11.2026 (7) – G-Code des neuen Gitters (Steg 1,4) geprüft: druckfertig

- **Einstellungen** (Datei Jan, 3 h 18 min): alle wie README, auch erste Schicht 0,45, Elefantenfuß 0, „Nur eine Wand in der ersten Schicht“ aus, Z-Hub 0, 235/230 °C.
- **Fahrten durch Löcher:** 203 statt ca. 62.000, alle mit Rückzug. Schichten 1–11 und 13–17: keine. Rest nur dort, wo der Slicer obere Flächen nicht überfährt: Schicht 12 (letzte Schicht vor dem Luftraum, 85 kurze) und Schicht 18 (hinterste Schicht, 9 lange Diagonalen quer über den Luftraum); dazu wie bisher 12 Schichten nur Stifte. Diese Fäden liegen hinten im offenen Luftraum und lassen sich vor dem Einbau abziehen oder kurz mit Heißluft entfernen.
- **Schicht 1:** Fläche zu 99,8 % belegt (vorher 99,3 %), Stege mit breiteren Linien.
- **Nebeneffekt:** ca. 2.100 statt 1.150 Rückzüge je Schicht. Ursache: Arachne setzt in jeden Zwickel zwischen drei Löchern einen kurzen Mittelstrich (Median 0,3 mm). Die liegen auf Material, nicht über Löchern; Druckzeit +25 min. Nicht geändert (ungeprüft wäre „Minimale Wandlänge“ höher; gilt nicht für Schicht 1).

## Nachtrag 08.11.2026 – Montagereihenfolge (Endmontage)

- **Grundsatz:** drei Baugruppen (Korpus mit Wandteilen, Boden mit Stapel, Deckel-Einheit). Alle Trennstellen liegen am Boden: Federklemmen und gelbe Stifte am Aufsatz, WAGO auf dem Boden, Lautsprecherklemme am MAX, Stecker (Pi-Klinke, USB-C am Akku-Board). Kein Kabel wird zwischen zwei Baugruppen gelötet.
- **Geprüft im Modell:** Stapel beginnt bei y 55,5, Trennwand der Kammer bei y 48 → der ganze Aufsatz liegt hinter der Kammer und ist bei abgenommenem Deckel von oben erreichbar. Die Säulen der beiden Kartenfach-Schrauben sind vom Deckelrahmen frei (0 mm³) → Rahmen kann vor dem Kartenfach montiert werden.
- **Reihenfolge:** (1) Korpus leer: USB-C-Platine, Drehgeber und Klinke (vorher löten, auch die beiden Drucktaster-Beinchen des Drehgebers als Reserve), Riemen-Gegenplatte, Watte + Lautsprecher von vorn, Lautsprecherkabel durch die Trennwand. (2) Deckel-Einheit auf dem Tisch: Kupferband, Kappe Ein-Taste (vor dem Rahmen, Kragen liegt unter dem Deckel), Deckelrahmen (6), Kartenfach (2 von unten), RC522 einschieben, MPR121, Taster, 3 WAGO; Kabelstrang zum Boden gebündelt, Enden beschriftet. (3) Boden auf dem Tisch: Stapel, Jumper, WAGO + Elko, MAX, Steckkabel, Niederhalter; Test. (4) Korpus kopfüber, USB-C und Klinke einstecken, Boden einsetzen, 6 Schrauben. (5) Von oben: Lautsprecher, Drehgeber, Klinken-Öffner anklemmen; Deckel-Strang anklemmen, Zugentlastung; Test mit danebenliegendem Deckel. (6) Deckel einsetzen, 2 Schrauben hinten. (7) Hörprobe, dann Gitter, Buchstaben, Knopf.
- **Wartung:** Deckel ab (2 Schrauben) reicht für alles außer Akku, SD-Karte und Stapel. Kabel der Deckel-Einheit so lang, dass der Deckel umgedreht neben der Box liegen kann (vorher mit Schnur abmessen); Reserve rechts hinten auf dem Boden ablegen, nicht über der Mitte (zwischen Klemmen und Kartenfach nur 4,8 mm).
- **Noch offen vor dem Schließen:** 4 × M2,5 für den Stapel (Länge), Muttern Niederhalter, Montageband, Watte. Verdrahtungsplan erledigt (Nachtrag 08.11. (2)).

## Nachtrag 08.11.2026 (2) – Verdrahtungsplan neu (Baugruppen, Aufdrucke)

- **Aufdrucke des Aufsatzes** (BerryBase RPI-BKFHAT, abgelesen am Produktfoto): Gruppe 1–8: 1 3.3V, 2 SDA1, 3 SCL1, 4 GND, 5 GND, 6 RX0, 7 TX0, 8 +5V. Gruppe A–H: A 3.3V, B MOSI, C MISO, D SCLK, E CE0, F CE1, G GND, H +5V. Gruppe I–P: I 3.3V, J PWM0, K PWM1, L PCMfs, M PCMi, N PCMo, O GND, P +5V. 40er-Leiste: Aufdruck wie Pi-Header mit P-Nummern (P04 … P27, SDA1, SCL1, TX0, RX0, MOSI …). Allgemeine GPIOs (P05, P17, P26, P27 …) gibt es nur auf der gelben Leiste.
- Im Boden ist der Aufsatz gegenüber dem Produktfoto um 180° gedreht (Leiste vorne); passt zur Angabe „P26: obere Beschriftungsreihe, 2. von links“.
- **Belegung (verbindlich):** Deckel-Strang D1 WAGO 3,3 V ← A · D2 WAGO GND B ← G · D3 WAGO SCL ← 3 · D4 RC522 SDA → E · D5 SCK → D · D6 MOSI → B · D7 MISO → C · D8 RST → I · D9 MPR121 SDA → 2 · D10 MPR121 INT → P05. Boden: B1 WAGO 5 V ← 8 · B2 WAGO GND A ← 4 · B3–B6 MAX BCLK/LRC/DIN/SD → P18/P19/P21/P16. Korpus: K1/K2 Drehgeber A/B → P17/P27 · K3 Drehgeber C → WAGO GND A · K4 Lautsprecher → MAX · K5 Klinke C → P26 · K6 Goobay → Pi-Klinke · K7 USB-C → Akku-Board. Jumper: 2, 3, 4, 8, A, B, C, D, E, G, I.
- Ein-Taste: Beinchen unten rechts + unten links (Jan gemessen 08.11.: Durchgang nur gedrückt). Drehgeber-Taster als Reserve angelötet; später z. B. Klemme 5 (GND) + P06.
- Plan: `plan/gen_plan5.py` → `plan/verdrahtungsplan.html`, veröffentlicht unter dem bisherigen Link (Artefakt Verdrahtungsplan). `gen_plan4.py` entfernt.

## Nachtrag 08.11.2026 (3) – Software für alle Bedienelemente

**Stand Jan:** Box komplett verdrahtet, exakt nach Verdrahtungsplan 08.11. (2). Auftrag: alle noch offene Software, quer geprüft, komfortabel, fehlerfrei, Box fängt sich bei Fehlern selbst; bestehende Funktionen bleiben.

**Geprüft vor dem Schreiben (Quellen):**
- STEC11B03: 15 Impulse / 30 Rasten (Alps-Tabelle, Bürklin, Rapid) → Raste = halber Takt → Kernel-Overlay `rotary-encoder` mit `steps-per-period=2`; Overlay schaltet die Pull-ups ein (softsolder.com, Overlay-README). Richtung des Kernel-Treibers aus dem Quellcode `rotary_encoder.c` (`rotary_encoder_half_period_irq`); die Rückfall-Abtastung zählt gleich.
- Adafruit 1982: INT mit Pull-up auf 3,3 V auf der Platine, ADDR 100 kΩ nach GND → 0x5A (Adafruit-Tutorial). MPR121-Einstellungen nach Adafruit-Bibliothek/AN3944 (Auto-Konfiguration 3,3 V: USL 200, TL 180, LSL 130), Prüfwert CDT 0x24 nach Reset.
- Pi-Klinke: hinter dem Trennkondensator Widerstand nach Masse (Raspberry-Pi-Audioschaltung, Hackaday „Behind the pin“) → P26 mit Pull-up liest ohne Stecker **tief** (Öffner verbindet mit L), mit Stecker **hoch**. Für den Pi 3A+ nicht am Gerät belegt → Seite zeigt den Pegel live, Richtung umstellbar.
- GPIO 3 nach Masse weckt den angehaltenen Pi (mehrere Quellen); I2C bleibt nutzbar. bcm2835-Watchdog: höchstens 15 s. librespot schließt das Audiogerät bei Pause und beendet sich bei Gerätefehlern. pico2wave (libttspico-utils) in Debian 13 non-free, arm64.

**Bedienung (Felder E0–E3 wie Verdrahtungsplan, in der Seite änderbar):**

| Element | Funktion |
| --- | --- |
| E0 zurück | antippen: vorheriger Titel; halten (ab 0,7 s): 15 s zurückspulen alle 0,8 s |
| E1 Play | antippen: Pause / weiter, die Karte bleibt liegen (Karte weg nach Tasten-Pause ändert nichts; wieder auflegen = weiter) |
| E2 vor | antippen: nächster Titel; halten: vorspulen |
| E3 Mond | antippen: Schlummer-Timer 15 → 30 → 45 → 60 Min → aus, je mit Ansage; 5 s halten: Akkustand ansagen |
| Klick | zurück, Play, vor: leiser Klick (Jans Klickton), sobald die Berührung zählt (70 ms), einmal je Berührung; **nicht** Mond, **nicht** Ein-Taste (Nachtrag 09.11. (13)) |
| Drehknopf | Lautstärke 2 % je Raste (einstellbar), nie über die Höchstlautstärke, nie unter 5 % |
| Ein-Taste | aus: einschalten (Pi selbst); kurz: Akkustand ansagen; 2 s halten: Musik pausiert, **beim Loslassen** „Tschüss“ und **Sparzustand** (seit 10.11., sonst weckte die noch gedrückte Taste sofort wieder; „Tschüss“ erst beim Loslassen seit 10.11. (5)); 10 s halten: „ganz aus“, beim Loslassen ganz aus |
| Kopfhörer | einstecken: Lautsprecher sofort stumm (SD), Spotify auf Kopfhörer, Startlautstärke Kopfhörer (30 %, jedes Mal); ausstecken: Kopfhörer sofort still, zurück auf Lautsprecher in der alten Lautstärke. Musik läuft an derselben Stelle weiter (Pause ca. 3–5 s) |

Schutz gegen Fehlbedienung: mehrere Felder gleichzeitig (Hand auf dem Deckel) lösen nichts aus; Feld meldet über 60 s Berührung → neu kalibriert; Ein-Taste beim Start gedrückt → erst nach Loslassen beachtet; über 15 s gedrückt (klemmt) → nie ausschalten; Kopfhörer entprellt (0,4 s), höchstens alle 3 s umschalten.

**Ansagen** (`toene.py`, Texte in `software/ansagen/TEXTE.md`): bereit, Tschüss, Akku 10–100 %, lädt, voll, schwach, leer, unbekannt, Timer 15/30/45/60/aus, Karte leer, Karte auflegen, Ruhezeit, „Einen Moment, die Musik kommt gleich“ (Karte wartet 8 s), kein Internet / Spotify-Anmeldung (25 s). Quelle: eigene WAV in `software/ansagen/` → sonst Sprachausgabe pico2wave (einmal erzeugt, auf −3 dBFS angehoben, gespeichert) → sonst Töne. **Bisher nur „bereit“ als Aufnahme**; die übrigen spricht vorerst der Pi. Eigene Aufnahmen (ElevenLabs, Helmut) einfach als MP3 an Claude schicken.

**Akku-Wache:** alle 15 s; ≤ 15 % einmal „fast leer“; ≤ 3,30 V bei 3 Messungen in Folge: Ansage und sauber ausschalten (schützt die SD-Karte vor hartem Abschalten). Schwellen festgelegt, nicht gemessen. Eltern-Seite zeigt beim Laden den letzten Prozentwert ohne Netzteil (offener Punkt 05.11. erledigt).

**Selbstheilung:** Kartenleser fehlt beim Start → Rest läuft, neuer Versuch alle 10 s (vorher stoppte der ganze Player). Touch-Chip fällt aus / Überstrom / misst nicht mehr → neu einrichten mit wachsendem Abstand, hängender I2C-Bus wird freigetaktet (9 Takte + STOP, SCL nie aktiv hoch). INT hängt → nur noch Abfrage alle 0,25 s. Ein-Taste an SCL: Pegel direkt aus dem GPIO-Register, nur gelesen wenn gerade keine eigene I2C-Übertragung läuft, 3 gleiche Proben; Akku wird nicht gelesen, solange die Taste gedrückt ist. Drehknopf ohne Kernel-Gerät → selbst abtasten. Kopfhörer-Helfer fehlt → Lautsprecher bleibt, neuer Versuch jede Minute. Jeder Faden überwacht und neu gestartet; hängt einer über 30 s → Player beendet sich, systemd startet neu; Hardware-Wächter des Pi bei Systemhänger. Beim Ausschalten Touch-Chip (Stopp) und RC522 (Power-Down) schlafen gelegt.

**Neue/geänderte Dateien:** `gpio.py`, `i2c.py`, `mpr121.py`, `drehgeber.py`, `bedienung.py`, `ausgang.py`, `peppa_ausgang.sh` (Root-Helfer → `/usr/local/sbin/peppa-ausgang`), `bedienung_einrichten.sh` (config.txt), `bedienung_test.py` (Konsole), `ansagen/TEXTE.md`; erweitert: `peppa_player.py`, `steuerung.py` (Pause/Weiter, vor/zurück, spulen, Ausgangswechsel), `spotify.py`, `toene.py`, `akku.py`, `automatik.py`, `lautstaerke.py`, `einstellungen.py` (Bereich `bedienung`), `rc522.py`, `peppa_web.py`, `web/index.html` (Bereich „Bedienung“), `lautsprecher_einrichten.sh` (Mischer `kopfhoerer`), `dienst_einrichten.sh` (Gruppen gpio/spi/input, sudo-Freigabe Helfer, Watchdog, pico2wave, TimeoutStopSec), `wlan_rueckfall.sh` (schaltet sich nach dem ersten erfolgreichen Start ab – offener Punkt 02.11. erledigt).

**Geprüft ohne Hardware:** 210 Tests (vorher 82), simulierte Uhr; 38 von 38 eingebauten Fehlern erkannt (2 weitere als gleichwertig erkannt: ändern kein Verhalten). ALSA-Konfiguration mit echtem `aplay -L` gelesen (alle 5 Geräte). Eltern-Seite in Chrome auf Handygröße hell/dunkel bedient (Live-Anzeige, Speichern, Ablehnung doppelter Elektrode, Ansagen), keine Konsolenfehler.

**Einrichten am Pi (einmal, per SSH):**
1. `cd ~/peppa-box && git pull && sh software/dienst_einrichten.sh` (fragt nach dem sudo-Passwort; installiert pico2wave, braucht Internet).
2. `sudo reboot` (config.txt: Drehgeber-Overlay, Pull-ups P05/P26; Gruppen, Watchdog).

**Testen (Eltern-Seite → Bedienung → „Prüfen und einstellen“, oder `python3 ~/peppa-box/software/bedienung_test.py`):**
1. Drehknopf: Zähler ändert sich, „Kernel-Treiber“ (grün). Rechts herum muss lauter werden, sonst „Drehrichtung umkehren“.
2. Touch: jedes Feld leuchtet beim Berühren, nur das richtige. Balken: ohne Berührung deutlich unter dem roten Strich, mit Berührung deutlich darüber; sonst Touch-Schwelle anpassen. Vertauscht → Felder-Zuordnung.
3. Ein-Taste: „gedrückt“ beim Drücken; kurz drücken → Akkustand wird angesagt.
4. Kopfhörer: „P26 gerade“ ohne Stecker **tief**, mit Stecker **hoch** (sonst Pegel-Richtung umstellen). Mit Musik einstecken → Lautsprecher still, nach ca. 3–5 s weiter im Kopfhörer, leise; ausstecken → zurück.
5. Mit Karte: Play (Pause/weiter), vor/zurück, vor halten (spulen), Mond 1× (Ansage 15 Min), 5 s Mond (Akku).
6. Ein-Taste 2 s halten → „Tschüss“, loslassen → Box geht aus; kurz drücken → startet wieder.
7. Ansagen anhören (Seite) – Klang der Sprachausgabe beurteilen.
8. Protokoll bei Auffälligkeiten: Seite → „Letzte Meldungen“ oder `journalctl -u peppa-player -n 100`.

**Noch offen / am Gerät zu bestätigen:** Polung P26; Touch-Schwelle durch 4 mm PETG (Standard 8/4 ist Startwert); Drehrichtung; Klang/Lautstärke der Sprachausgabe; Akku-Schwellen; ob der L-Kanal beim Ausstecken während Kopfhörer-Musik den Eingang P26 stört (Kopfhörer werden deshalb sofort auf 0 gestellt).
## Nachtrag 08.11.2026 (4) – Kein Ton nach der Montage: Masse des Verstärkers, danach kein WLAN
- **Befund Jan (21:40):** Karte wird erkannt, aber kein Ton und keine Ansage, nur leises Rauschen. Gemessen bei laufender Box: VIN–GND am MAX 4,7 V, VIN–Klemme 4 5,2 V, **GND am MAX gegen Klemme 4 0,5 V**; WAGO GND A gegen Klemme 4 ebenfalls 0,5 V → Übergangswiderstand im Kabel B2 (Klemme 4 → WAGO GND A). Ohm-Messung bei ausgeschalteter Box unbrauchbar (Wert läuft hoch, weil Elko und Platinenkondensatoren geladen werden) → bei Masseproblemen **Spannung bei eingeschalteter Box messen** (soll: GND am MAX gegen Klemme 4 0,00 V).
- Nach Neuklemmen von B2: 0,00 V bzw. 5,2 V, Ansage und Musik kommen, aber stark knisternd („Lagerfeuer“) wie am 02.11. ohne Elko. Verdacht: Elko-Verlängerung (Kontakt/Länge) oder Signalkabel P18/P19/P21; noch nicht geklärt. Nächster Schritt: Elko ohne Verlängerung direkt in die WAGO, Wackeltest mit `speaker-test -D lautsprecher -c 2 -t sine -f 440`.
- **Danach (22:43): Box nicht mehr im WLAN** (auch nicht in der Geräteliste des Routers), Pi startet normal (rote LED dauerhaft, grüne flackert und geht aus). Ursache offen. Nächste Schritte: Box offen nah am Router neu starten, 3 min warten (Rückfall-Dienst); sonst HDMI (normale große Buchse) + USB-Tastatur.
- Zeitlich nach dem Software-Stand 08.11. (3) (22:29). Noch zu klären: ob Jan `dienst_einrichten.sh` + Neustart schon ausgeführt hat; ob der Pi nach dem Start gar nicht hängt, sondern **ausgeschaltet** ist (rote LED an, grüne aus sieht genauso aus) – z. B. durch Akku-Wache oder Ein-Taste an SCL. Test: Ein-Taste kurz drücken; flackert die grüne LED wieder wie beim Start, war der Pi aus.

## Nachtrag 08.11.2026 (5) – SD-Karte neu: Komplett-Einrichtung mit einem Befehl
- Jan hat die SD-Karte neu bespielt (Update 08.11. (3) war noch nicht eingespielt, scheidet als Ursache für den WLAN-Ausfall aus). Wunsch Jan: nichts mehr von Hand einrichten.
- **Neu `software/einrichten.sh`:** Pakete (git, curl, alsa-utils, python3-spidev), Repository aus `peppa-box.bundle` (Boot-Partition) oder GitHub, optional GitHub-Lese-Token (`github-token.txt`, wird nach dem Einlesen von der Boot-Partition gelöscht, liegt dann nur in `~/.git-credentials`), Raspotify installieren und einstellen (Name, `fixed`, 100 %, Zugangsdaten-Cache an), `wlan_beschleunigen.sh`, `dienst_einrichten.sh` (Lautsprecher, Bedienung, Dienste), Spotify-Anmeldung (`spotify_login.py`, Client-ID optional aus `spotify-client-id.txt`), wartet bis zu 5 min auf die Auswahl „Peppa Box“ in der Spotify-App, dann Neustart. Wiederholbar.
- Ablauf: Ordner `peppa` (Skript + Bundle) aufs Laufwerk `bootfs` kopieren → Pi starten → `sh /boot/firmware/peppa/einrichten.sh`.
- Karten müssen nicht neu angelernt werden (Link steht auf der Karte). Offen: Spotify-Anmeldung über die Eltern-Seite statt im Terminal; Sicherung/Wiederherstellung der Einstellungen über die Seite.
- **Korrektur 23:20:** Beim ersten Lauf erkannte Schritt 7 die Auswahl in Spotify nicht – Raspotify lief nach dem Ändern von `/etc/raspotify/conf` noch mit der alten Einstellung (Zugangsdaten-Cache aus). `einrichten.sh` startet Raspotify jetzt nach dem Einstellen und vor Schritt 7 neu.
- **Korrektur 23:30 (Befund nach dem ersten Lauf):** Eltern-Seite zeigte „Touch-Chip: /dev/i2c-1 fehlt“ und „Kopfhörer: Umschalten nicht eingerichtet“, kein Ton. Ursachen: (1) Auf einem frischen System ohne raspi-config wird das Kernel-Modul `i2c-dev` nicht geladen → `bedienung_einrichten.sh` legt jetzt `/etc/modules-load.d/peppa-i2c.conf` an (Test ergänzt). (2) Die hifiberry-Karte erscheint erst nach dem Neustart; `lautsprecher_einrichten.sh` bricht beim ersten Lauf ohne Karte ab (Mischer, Regler, Raspotify-Ausgang fehlen). `einrichten.sh` legt dafür einen Einmal-Dienst `peppa-einrichten-2` an: nach dem Neustart `dienst_einrichten.sh` (Protokoll `~/einrichtung-2.log`), Dienst entfernt sich, noch ein Neustart. Am Pi heute von Hand: `i2c-dev` eintragen, `dienst_einrichten.sh`, `sudo reboot`.
- **Ansage „Leg eine Karte auf“ abgeschaltet (23:30, Wunsch Jan: kam ständig, nervt).** Play-Feld ohne Karte → nur Protokollzeile. Dass sie ständig kam, heißt: Das **Play-Feld (E1) meldet Fehlberührungen** (Deckel offen, Kabel/Kupfer in der Nähe oder Schwelle zu niedrig). Prüfen unter Eltern-Seite → Bedienung → „Prüfen und einstellen“ (Balken ohne Berührung deutlich unter dem roten Strich), sonst Touch-Schwelle erhöhen. Sonst pausiert eine Fehlberührung laufende Musik.

## Nachtrag 08.11.2026 (6) – Knistern gelöst: SD des Verstärkers fest auf 3,3 V
- **Eingrenzung (Jan, 23:30–23:43):** Sinuston (`speaker-test -D lautsprecher`) sauber; Knistern bei Spotify und Ansage, **unabhängig von der Lautstärke** (bei 10 % kaum Musik, Knistern gleich laut); kein Knistern durch WLAN-Last (Download) oder Kartenleser (Karte bei gestopptem Raspotify). Ansage direkt auf `plughw:CARD=sndrpihifiberry` (ohne Mischer/softvol) knisterte auch → nicht die Software-Kette. **SD am MAX gegen GND: 0 V** bei „Eingang ohne Pull“ (02.11.: > 0,2 V) – das liegt an der Abschaltschwelle des MAX98357A (ca. 0,16 V, aus dem Gedächtnis, Datenblatt nicht nachgelesen). Mit `pinctrl set 16 op dh` (SD 3,3 V): **Ton sauber.** Passt auch zu „Musik geht irgendwann ganz aus“.
- **Änderung:** SD im Betrieb **Ausgang hoch** statt offen (`ausgang.verstaerker()`, `peppa-stille` ExecStartPost `op dh`); beim Start (`config.txt gpio=16=op,dl`) und beim Stoppen weiter tief = stumm. SD hoch = Verstärker spielt nur den **linken** Kanal → neu in `/etc/asound.conf`: `peppa_mono` (route, L+R je 0,5 auf beide Kanäle) + `peppa_mono_plug` zwischen softvol `lautsprecher` und `peppa_plug`. Geprüft mit echtem `aplay` (alsa-utils 1.2.9): Konfiguration wird gelesen, Mono-44,1-kHz-WAV und Stereo-48-kHz laufen durch die Kette (Ende auf `null` umgelenkt). 211 Tests grün.
- **Am Pi:** `cd ~/peppa-box && git pull && sh software/dienst_einrichten.sh`, dann `sudo reboot`.

## Nachtrag 08.11.2026 (7) – Album startet immer wieder von vorn: Prüfung mit lokalem Beleg
- **Befund Jan (23:50):** Karte aufgelegt, Musik hörbar, aber alle 30–60 s „Prüfung: Box spielt nicht (Befehl angenommen, aber keine Musik)“ → neuer Startbefehl → Album von vorn. Abfrage `spotify.zustand()` bei **hörbarer** Musik: viermal `spielt: False`, Position fest 17994 ms, richtiges Gerät und Titel → **die Web-API meldet den Zustand falsch**. Kein CPU-Engpass (top: 89 % frei; librespot 7,7 % beim Spielen), `get_throttled=0x0`. Einmal „underrun“ von librespot beim Start (Begleiterscheinung). Jan hatte am Anfang mehrfach am Drehknopf gedreht – Zusammenhang nicht belegt.
- **Änderung:** Neu `steuerung.LibrespotLast`: misst die Rechenzeit des Prozesses `librespot` aus `/proc/<pid>/stat` (utime+stime); ≥ 2 % eines Kerns zwischen zwei Messungen = dekodiert Musik. Die Prüfung nach dem Start gilt als bestanden, wenn zwei Proben in Folge denselben Titel auf dem richtigen Gerät zeigen und **entweder** Spotify „spielt“ mit vorrückender Position meldet (wie bisher) **oder** librespot lokal nachweislich arbeitet. Zombie (librespot tut nichts) und springende Titel (Audio-Key-Fehler) werden weiter erkannt. Protokollzeile, wenn nur der lokale Beleg zählte. Tests `test_lokal.py` (8), gesamt 219 grün; Messfühler am echten `/proc` geprüft (rechnend True, schlafend False).
- **Am Pi prüfen:** Update über die Eltern-Seite (nur Python, kein Einrichtungsskript nötig). Karte auflegen: Album läuft durch; im Protokoll höchstens „Spotify meldet keine Wiedergabe, Raspotify spielt aber nachweislich – läuft.“ Schwelle 2 % ist aus einer Messung abgeleitet; bei Fehlalarm Wert in `LOKAL_MIN_PROZENT` anpassen.
- **Offen (Jan, 23:59):** Musik wird unterbrochen; die Box „kommt durcheinander“ bei Akku-Ansage während der Musik und bei mehrmals „vor“ hintereinander. Noch kein Protokoll dazu. Unklar, ob das Update (7) schon eingespielt war. Nächster Schritt: nach jedem Vorfall „Letzte Meldungen“ als Screenshot.
- **00:00:** Protokoll nach Update (7): lokaler Beleg greift („Raspotify spielt aber nachweislich – läuft“), „Nächster Titel“ ok. Danach „Play-Feld: Pause“ ohne Berührung (Karte lag die ganze Zeit) = **Phantom-Berührung am Play-Feld**. Die Folgezeile „Karte weg, Pause“ war nur irreführend formuliert (allgemeine Pause-Meldung, auch bei Tasten-Pause) → jetzt „Pause (Spotify …)“. Offen: Touch-Schwelle mit den Balken der Eltern-Seite einstellen (Standard 8/4), Deckel-Kabel weg von Verstärker/Lautsprecherkabel.
- **00:05:** Stopp über Play-Feld → Pause ok; Play → Weiter ok, nach einigen Sekunden Abbruch, dann Ansage „Einen Moment, die Musik kommt gleich“ (kommt, wenn ein Spielen-Wunsch 8 s unbestätigt ist). Tasten haben richtig reagiert; vermutlich scheiterte die **Prüfung nach dem Weiter** → Fehlschlag → frischer Start. Verdacht (unbelegt): librespot braucht im gleichmäßigen Spielen weniger als die Schwelle 2 % (7,7 % war evtl. die Startlast). Protokoll fehlt (Box aus). **Nächster Schritt:** librespot-CPU beim gleichmäßigen Spielen und in Pause messen (`top -bn3 -d2 -p $(pgrep -x librespot)`), dann Schwelle festlegen; Alternative robuster: Ereignis-Hook von librespot (`LIBRESPOT_ONEVENT`, meldet playing/paused direkt) statt Web-API/CPU.

## Nachtrag 09.11.2026 – Gummiecken mit Füßen (TPU orange), ohne Neudruck des Gehäuses

- **Wunsch Jan:** Die Box soll doch Füße bzw. einen Gummischutz bekommen (ersetzt „keine Gummifüße“ vom 06.11.): orange Gummiecken, die die Ecken schützen, stylisch aussehen und beim Stehen Vibrationen dämpfen. Anklipsen, **Gehäuse nicht neu drucken**.
- **Befestigung (Lösung):** Am fertigen Gehäuse gibt es außen genau einen Hinterschnitt: die Fuge Boden/Korpus 4 mm über der Standfläche. Einzelne Ecken halten trotzdem nicht: Eine 90°-Ecke lässt sich nicht umklammern, sie fiele schräg nach außen ab. Deshalb **ein Teil**: vier Eckschuhe, unter dem Boden durch einen Ring verbunden. Halt: (1) Rastwulst im Schuh hakt unter die Fuge (nicht nach unten abziehbar), (2) Fuß unter dem Boden (nicht nach oben), (3) Ring zieht die Ecken nach innen (`ECK_VOR` 0,25 je Seite kleiner gebaut, dazu drücken die Fuzzy-Spitzen ±0,2 ins TPU). Ohne Werkzeug, ohne Kleber, ohne Schrauben.
- **Befund gedruckter Korpus (STL 04.11. ausgewertet, `01_korpus_beige.stl`):** Die V-Fuge ist nur an den Seiten, hinten und an den hinteren Teilen der vorderen Rundungen vollständig. **Vorne (x ≈ 9–131) hat der Korpus unten keine Fase**: die Frontplatte (`plate_front`) füllt sie, dort ist die Fuge eine Stufe (Fase nur am Boden, Korpus-Unterkante waagerecht). Der Wulst ist deshalb ein **Sägezahn**: untere Flanke 45° parallel zur Bodenfase (0,14 Luft), Oberseite waagerecht 0,1 unter der Korpus-Unterkante. Passt in beide Formen, hakt vorne sogar fester. Mit den gedruckten STL von Korpus und Boden geprüft: 0,000 mm³ Überschneidung.
- **Modell (`gummiecken()`, Parameter `ECK_*`):** Wand 2,4, oben außen gerundet R 1,2, Fuß 3 mm (Box steht nur auf den Ecken), Fuß reicht 20 mm unter den Boden (deckt die Eckschrauben), Schenkel 10 mm über die Rundung R 16 hinaus, Enden gerundet. Höhe an der Ecke 16, an den Schenkelenden 8 mm (cos²-Übergang, Variante B); vorne begrenzt die Fase des Gittersitzes (Abstand 2,8 mm, Prüfung ≥ 1). Ring 7,5 × 1,2 mm, 12 mm hinter der Kante, liegt auf der Platte (druckt ohne Stütze), 1,8 mm Luft zum Boden, trägt nicht; von der Seite erst unter ca. 9° zu sehen. Rahmen ringsum gleich (Richtung beim Aufsetzen egal). Ca. 20 g, Druckmaß 144 × 144 × 19 mm, Überhang 0.
- **Prüfungen (`check.py`, neuer Abschnitt):** 1 Teil, keine Überschneidung mit Korpus/Boden, Abstand Gittersitz 2,8 mm, Wulst vorhanden, keine Kollision mit anderen Teilen; alle übrigen Prüfungen unverändert, alle anderen STL bytegleich.
- **Netz:** Die Wand jedes Eckschuhs wird als Querschnitt (außen Fase/Rundung, innen genau die Box mit Wulst) entlang der Kontur direkt als Netz gezogen, die vier Ecken gespiegelt statt gedreht, die Stationen der Rundung um eine halbe Teilung gegen die 5°-Teilung der Kontur versetzt, Innenseite 0,02 nach außen (Sehnenfehler). Ergebnis: Rahmen und C16 dicht (trimesh), keine entarteten Dreiecke. Eine Vereinigung vieler Hüllen hatte Splitter erzeugt.
- **Dateien:** `12_gummiecken_TPU_orange.stl` (mit Vorspannung, Druckausrichtung), Coupons `coupon_C16_gummiecke_wulst_0-4/0-5/0-6.stl` (eine Ecke ohne Ring, ohne Vorspannung, 1/2/3 Löcher im Fuß), Bilder `gummiecken_ansicht.png`, `gummiecken_schnitt.png`, `gummiecken_varianten.png` (A flach 10/10, B 16/8, C 20/8). README-Abschnitt „Gummiecken“ mit allen Einstellungen (Elegoo TPU 95A @ECC2; Arachne, 3 Wände, Gyroid 15 %, oben 3 Schichten, Außenwand 25 mm/s, keine Umrandung, Naht innen aufmalen).
- **Drucker:** TPU laut Elegoo nicht über den normalen CANVAS-Weg: Adapter für flexibles Filament (Datei auf dem USB-Stick / Nexprint) und CANVAS-Kabel abziehen. TPU vorher trocknen.
- **Filament (orange TPU 95A, Elegoo hat kein Orange):** Kingroon TPU95A Orange 1 kg (3DJake, günstig) oder colorFabb TPU 95A Orange 700 g (niederländischer Hersteller, ca. doppelter Preis). Farbton gegen das vorhandene Orange nicht geprüft. Bedarf ca. 20 g + Coupons ca. 12 g.
- **Dämpfung (ehrlich):** TPU 95A ist recht hart. Die Füße verhindern Klappern und Rutschen und dämpfen etwas; die Gyroid-Füllung in den Füßen macht sie weicher. Echte Entkopplung wie bei Lautsprecher-Absorbern ist das nicht.
- **Offen:** C16 drucken und an einer vorderen und einer hinteren Ecke prüfen (Klick, Sitz, kein Spalt oben), `ECK_WULST` festlegen; Form wählen; **Außenmaß der Box messen** (Messschieber links–rechts und vorne–hinten, ca. 8 mm über der Standfläche; Modell 140,0 + Fuzzy-Spitzen), danach `ECK_VOR` bestätigen; Rahmen drucken.

## Nachtrag 09.11.2026 (2) – Gummiecken verschraubt, vier einzelne Ecken, Form C

- **Frage Jan:** Die Ecken über die bestehenden Eckschrauben am Boden anschrauben – stabiler? **Antwort:** Ja, aber nicht direkt durch das TPU: Unter dem Schraubenkopf würde das TPU dauerhaft nachgeben, die Schraube verlöre Spannung, und sie hält den Boden mit der ganzen Elektronik (lockerer Boden, Klappern). Lösung: **PETG-Hülse im Fuß**. Die Schraube drückt nur auf Hartes (Kopf → Hülse → Boden → Dom), das TPU sitzt auf dem 45°-Kegel der Hülse (gefangen, nicht gepresst). **Entscheidung Jan:** verschraubt, **Form C** (`ECK_H` 20/8).
- **Folge:** Ring unter dem Boden und Vorspannung entfallen (`ECK_RING`, `ECK_VOR` gelöscht). Vier gleiche, einzeln druck- und ersetzbare Ecken; ohne Werkzeug nicht abziehbar. Rastwulst bleibt (hält die Schenkelenden an der Box).
- **Hülse (`eckhuelse()`, `ECK_HUELSE`):** Bund Ø 9,8 bis z −1,5, Kegel 45° bis Ø 8,2 bei z −0,7, Hals Ø 8,2 bis z 0 (liegt am Boden an), Unterseite z −2,5 = 0,5 über der Standfläche (Kopf und Hülse berühren den Tisch nicht). Senkung für den Kopf wie im Boden (`CSK` 6,2 / 3,4), Kopf bündig. Ø begrenzt, weil die Eckschraube nur 5,53 mm hinter der Außenrundung liegt: unten bleiben 1,58 mm TPU, Hülsenwand am Kopf 1,8 mm. Aussparung im TPU radial 0,25 größer (0,18 mm Luft). Druck: Bund unten, Senkung = 45°-Überhang, ohne Stützen.
- **Schraube (`ECK_SCHRAUBE`):** Senkschraube **3,0 × 16** statt 3,0 × 12: Hülse 2,5 + Boden 4 + **9,5 mm im Dom** (bisher 8), Kernloch noch 2,5 mm tiefer. Vorschlag: SPAX Universalschraube 3,0 × 16, Senkkopf T10 (Kopf Ø 6,0, passt zur Senkung 6,2) als 25er-Packung im Baumarkt (toom 1630650) – kein Versand. Gewinde im Dom wird weiterverwendet; von Hand eindrehen, bis der Kopf anliegt.
- **Montage je Ecke** (Ecke ragt über die Tischkante): Eckschraube heraus (die anderen 5 halten den Boden), Hülse von unten in den Fuß, Ecke aufdrücken bis der Wulst einrastet, Schraube 3,0 × 16 eindrehen.
- **Prüfungen:** keine Überschneidung Ecken ↔ gedruckter Korpus/Boden, Hülse liegt am Boden an (0,00) und berührt das TPU nicht, Abstand Gittersitz 1,59 mm (Form C, Grenze 1), Überhang 0, keine Kollision; Ecke, Hülse und C16 dicht, ohne entartete Dreiecke. Je Ecke 3,9 g TPU, Druckmaß 28,4 × 28,4 × 23 mm; Hülse 0,15 g PETG.
- **Dateien:** `12_gummiecke_TPU_orange.stl` (eine Ecke, 4 × drucken; ersetzt `12_gummiecken_TPU_orange.stl`), `13_eckhuelse_PETG.stl` (5 ×, eine Reserve), C16 neu als drei vollständige Ecken (Form C, verschraubt; die passende ist schon eine der vier), Bilder neu (Schnitt jetzt auch durch die Schraube), README-Abschnitt „Gummiecken“ mit Einstellungen für TPU-Ecken und PETG-Hülsen und Montage; Schraubentabelle ergänzt.

## Nachtrag 09.11.2026 (3) – TPU-Empfehlung für die Gummiecken

- **Empfehlung:** colorFabb TPU 95A Orange, 1,75 mm / 700 g, direkt beim Hersteller (NL, colorfabb.com): deckendes Orange (eSUN und GEEETECH gibt es nur transluzent), 95A wie im Modell und im Profil „Elegoo TPU 95A @ECC2“ (Hersteller: 220–230 °C, Trocknen 70 °C 6–9 h). Regulär 37,68 €, am 09.11. mit 30 % Rabatt 26,38 € angezeigt; Versandkosten nach DE nicht geprüft. Bei 3DJake.de derselbe Artikel 37,99 € (Versand frei ab 52,90 €).
- **Alternative (Sparen, wenn der Versand bei colorFabb teuer ist):** 3DJAKE TPU A95 Orange 750 g (Made in EU, RAL 2008, sehr gut bewertet; laut einer Bewertung etwas härter als Polymaker PolyFlex). Kingroon (vorher in der Einkaufsliste) nicht mehr empfohlen: kein Hersteller in der EU, Qualität unbekannt.
- Nicht geeignet: Extrudr TPU medium Neon Orange (98A, Neonfarbe), Recreus Filaflex (82A, zu weich für Wulst und Hülse).
- Farbton gegen das vorhandene orange PETG nicht geprüft. Einkaufsliste angepasst.

## Nachtrag 09.11.2026 (4) – Farbton und gekauftes TPU

- **Frage Jan:** Welcher RAL-Ton ist das Elegoo-Orange? **Antwort:** Elegoo nennt keinen RAL-Ton. Hex-Wert laut einer Farbliste der Elegoo-Töne auf MakerWorld #fd7c18 (gilt für PLA, PLA+ und Rapid PETG). Farbabstand ΔE2000 (eigene Rechnung, Näherung über Bildschirmwerte): RAL 2003 Pastellorange 2,0 (praktisch gleich), RAL 2011 Tieforange 3,0, RAL 2000 Gelborange 3,2, RAL 2008 Hellrotorange 10,0 (sichtbar röter), RAL 2004 Reinorange 13,8. Kein TPU 95A in RAL 2003/2011/2000 bei Shops in DE/NL gefunden; 3DJAKE TPU A95 (RAL 2008) ist röter, Extrudr Neon (RAL 2005, 98A) scheidet aus.
- **Gekauft (Jan, 09.11.):** TINMORRY TPU 95A Orange („Brandschutz Orange“), 1,75 mm / 1 kg, Amazon.de, 15,98 €. Kein RAL-/Hex-Wert angegeben; der Name lässt eher ein rötliches Sicherheitsorange erwarten (nicht geprüft).
- **Herstellerangaben (Amazon-Angebot):** Düse 210–240 °C, Druckbett 30–50 °C, unter 60 mm/s, trocknen 70 °C / 8 h, Spule zufällig aus Karton oder Kunststoff. Das Profil „Elegoo TPU 95A @ECC2“ (225 °C / 35 °C) und die Geschwindigkeiten aus dem README (Volumenstrom 3,2 mm³/s ≈ 38 mm/s) liegen darin, also keine Änderung an den Einstellungen.
- **Vorgehen:** zuerst C16 drucken und bei Tageslicht an die Box halten, dann erst die restlichen Ecken. Einkaufsliste (TPU als bestellt) und README angepasst.

## Nachtrag 09.11.2026 (5) – Etiketten für die Karten (Konzept, noch nicht entschieden)

- **Wunsch Jan:** möglichst wenig Aufwand. Beim Bespielen einer Karte holt die Box das Cover und druckt das Etikett lokal, im selben Schritt. Etikett aus Papier, möglichst ohne Zuschneiden, in die Karte **einklicken** wie in einen Bilderrahmen. Standardformat erwünscht. **Abgelehnt:** Karte oben breiter (Querformat).
- **Befund Papier:** Den jetzigen Einleger 67 × 68 mm gibt es nirgends fertig getrennt. Das einzige verbreitete Standardformat, das in 70 mm Kartenbreite passt, ist Visitenkarte/Kreditkarte hochkant: Avery Zweckform C32010-25 (85 × 54, mikroperforiert, A4) und Canon Selphy KC-36IP (54 × 86, braucht Kassette PCC-CP400). Folge: Die Karte ragt ca. 89 statt 70 mm über den Deckel, Steckteil unverändert. Sigel 85 × 55 ist 1 mm breiter (nicht vorgesehen). Selphy Square QX10 (68 × 68) bei Canon nicht mehr erhältlich, Papier 72 × 85 breiter als die Karte. A8 nur als lose Karten.
- **Einklicken (Prinzip Preisschiene):** Lippen links und rechts mit 45°-Unterseite wie bisher, unten Lippe, oben geschlossene Kante mit Griffkerbe. Etikett leicht wölben, einlegen, loslassen → liegt flach unter den Lippen, fällt kopfüber nicht heraus. Druck Rückseite unten ohne Stützen. Mit Coupon und echtem Papier prüfen (Papierdicke messen, `INS_GAP` 0,6 ist Probedruck).
- **Software (Plan):** Link auf der Eltern-Seite einfügen → Box schreibt den Link selbst auf die Karte (nur NTAG21x) und liest zurück → Cover über Web API (`GET /albums/{id}`, `/shows/{id}`, `/audiobooks/{id}`; fremde Playlists nur Metadaten, seit Feb. 2026), Rückfall oEmbed (300 px), dann eigenes Foto/nur Titel → Druck über CUPS (IPP/AirPrint) ohne weiteren Klick, PDF als Rückfall. Auslöser „Link zum ersten Mal gesehen“ (auch für mit NFC Tools beschriebene Karten). A4-Bögen: Sammeldruck, wenn mehrere Karten nacheinander bespielt werden. CUPS vor dem Schreibschutz einrichten.
- **Hinweis Jan (16:47):** Günstiger ist ein Klebeetikett ohne Rahmen (spart Druckkosten). **Neuer Vorschlag:** HERMA 10109, 60 × 60 mm, quadratisch mit runden Ecken, ablösbar (Movables), 12 je A4-Bogen, 300 Stück, Inkjet und Laser. Karte bleibt 70 × 112 × 4 mm, Steckteil unverändert; statt Tasche und Lippen nur eine flache Vertiefung als Anschlag und Kantenschutz (Tiefe nach Messung der Etikettendicke). Neu bespielen: Etikett abziehen, neues aufkleben. Angebrochene Bögen werden weiter benutzt (Jan, 16:53): Die Box merkt sich die belegten Plätze und druckt jedes Etikett sofort auf den nächsten freien Platz, vom hinteren Bogenende her (die Einzugskante bleibt geschlossen); „Neuer Bogen“ per Tipp, Plätze von Hand als belegt markierbar. Einzug möglichst gerade (hinterer/manueller Einzug). Bei Laserdrucker vorher mit einem Bogen testen (Wärme, Etiketten können sich lösen). Damit entfallen Einklick-Rahmen und längere Karte (89 mm).
- **Entscheidung Jan (17:03): Etiketten über dm** (CEWE-Fotostation, Freiform-Sticker), keine zusätzliche Hardware. Belegt: Freiform-Bogen 9 × 14 cm, glänzendes Fotopapier, Motive freigestellt (weißer/transparenter Hintergrund), Station erkennt die Motive und schneidet entlang der Kontur; 2,95 € pro Bogen (normaler Fotosticker-Bogen ca. 10 × 15 cm mit Vorlagen 1,95 €, Stickergrößen nicht angegeben). Übertragung: CEWE Fotowelt App (Projekt, QR an der Station), CEWE Online Direct (QR scannen), Kabel, USB-Stick/SD, Bluetooth, AirPrint; JPEG/PNG/HEIC.
- **Rechnerisch (5 mm Rand/Abstand angenommen):** 60 mm → 2 Sticker pro Bogen (ca. 1,48 € je Karte), 37,5 mm → 6 (ca. 0,49 €).
- **Neu `software/stickerbogen.py`:** legt quadratische Cover (mittig beschnitten) auf einen transparenten Bogen 90 : 140 bei 300 dpi; `--test` erzeugt einen Testbogen mit Millimeterskala und 50-mm-Messlinie. Erst Testbogen (60 mm) an der Station drucken und messen: tatsächliche Stickergröße (skaliert die Station?), Schnittkante/Ecken, weißer Rand, Dicke. Danach Vertiefung in der flachen Karte festlegen.
- **Offen:** Ergebnis Testbogen; Typ der NFC-Aufkleber (Box beschreibt nur NTAG21x). Druckermodell nicht mehr nötig.

## Nachtrag 09.11.2026 (6) – Box läuft nicht stabil: Kopfhörer, 502, Phantom-Berührungen

- **Befund Jan (abends, Screenshots):** Musik lief nach dem Start. Kopfhörer eingesteckt → Lautsprecher aus, in den Kopfhörern nichts. Danach keine Musik mehr, auch nicht nach dem Ausstecken, nicht nach „Musik neu starten“ und (laut Jan) nicht nach dem Neustart. Protokoll 18:51:48 „Ausgang: lautsprecher.“, danach jeder Startbefehl **Spotify 502 „Bad gateway“**, auch mit neuem Player-Prozess. Das Protokoll vom Lauf davor war nach dem Neustart weg (Journal nur im Arbeitsspeicher).
- **Eigene Messung über die Eltern-Seite (Browser in Jans Claude-App, 19:43–19:47):** alle Dienste aktiv, Ausgang Lautsprecher, keine Fehler. **Play-Feld meldete ohne Karte über 20 Berührungen in 8 min** („Play-Feld ohne Karte“). Rohwerte 40 s ohne Berührung: Abstand zur Grundlinie schwankt bei E0–E2 zwischen −14 und +6, bei E3 −5 … +1; Schwelle 8. Liegt eine Karte, pausiert eine Phantom-Berührung die Musik bzw. springt einen Titel.
- **Ursache Kopfhörer/502 (Vermutung, nicht belegt, Protokoll fehlt):** Für jedes Ein-/Ausstecken wurde Raspotify neu gestartet, dazu kamen Neustarts der Selbstreparatur und des Knopfs „Musik neu starten“. Nach mehreren Neustarts kurz hintereinander antwortet Spotify minutenlang mit 502 (Befehle gehen vermutlich an eine Verbindung, die es nicht mehr gibt). Nachgelesen: Raspotify 0.48.4 (librespot-Stand 22.10.2026) läuft als root ohne Rechte in einem eigenen Benutzer-Namensraum (`DynamicUser=no`, `PrivateUsers=true`, `ProtectHome=true`, `ProtectSystem=strict`); librespot 0.8 pausiert bei Fehlern der Ausgabe statt abzustürzen.
- **Neu: Tonausgabe `software/ausgabe.py`** (installiert als `/usr/local/lib/peppa-box/ausgabe`): Raspotify spielt über `LIBRESPOT_BACKEND="subprocess"`, das Programm reicht den Ton an `aplay` weiter, auf den Ausgang aus `/dev/shm/peppa-box-ausgang.json`. Wechselt der Player die Vorgabe, wechselt es binnen 0,25 s, **ohne Raspotify-Neustart** (Spotify merkt nichts). Kopfhörer-Ausgang kaputt → sofort zurück auf den Lautsprecher und Meldung; aplay hängt 3 s → neu öffnen; Lautsprecher 3 × in 10 s kaputt → Ende mit Fehler. Meldet per UDP (127.0.0.1:47150) jede Sekunde den **Tonfluss**: sicherster Beleg, dass wirklich Musik läuft.
- Geprüft im Quelltext von librespot 0.8.0: Bei Pause wird die Ausgabe geschlossen (Programm beendet), beim Weiterspielen neu gestartet; Schreibfehler → einmal neu starten, dann Pause. Geprüft hier: alsa-lib liest eine geänderte `/etc/asound.conf` in einem laufenden Programm **nicht** neu (nur `alsa.conf`) – darum der Weg über ein eigenes Programm statt über ALSA.
- **Neu: Ereignis-Programm `software/ereignis.py`** (`LIBRESPOT_ONEVENT`, `/usr/local/lib/peppa-box/ereignis`): playing/paused/track_changed/unavailable/session_* an den Player (ohne Benutzername). **Neu `software/rueckmeldung.py`:** Empfang im Player (eigener Faden, überwacht).
- **`ausgang.py` neu:** eingesteckt → Verstärker stumm, Kopfhörer auf Startlautstärke **und eingeschaltet** (`amixer … unmute`; vorher blieb ein ausgeschalteter Regler stumm), Vorgabe kopfhoerer; ausgesteckt → Kopfhörer 0, Vorgabe lautsprecher, Verstärker an. Prüft, ob die Tonausgabe binnen 3 s folgt; sonst zurück auf den Lautsprecher und **Kopfhörer gesperrt** (10, 20, 40, 60 min), bzw. Raspotify-Neustart, wenn sie auf den Kopfhörern hängen bleibt. Verstärker wird alle 2 s nach dem echten Pegel von SD (P16) gehalten. **Ohne neue Einrichtung wird nie umgeschaltet** (Lautsprecher bleibt, Hinweis auf der Seite).
- **Touch:** MPR121 stärker gemittelt (erster Filter 18 statt 6 Proben, zweiter 10 statt 4 alle 2 ms, Entprellen 2 Proben; Bitfelder nach Datenblatt, FFI in CDC und AUTO0 gleich). Zusätzlich **Berührungen unter 70 ms lösen nichts aus**; das Protokoll fasst sie höchstens einmal je Minute zusammen, die Seite zeigt die Zahl („× Rauschen ignoriert“).
- **Selbstreparatur:** Raspotify-Neustart = **Ton-Neustart** über den Helfer (`peppa-ausgang neustart`: Raspotify anhalten, peppa-stille neu, Raspotify starten). Abstand zwischen Neustarts wächst ohne Erfolg: 120, 120, 300, 600, dann 900 s; zurück auf 0, sobald Musik nachweislich läuft. Prüfung nach dem Start: fließt Ton (Tonausgabe), gilt das auch, wenn die Web-API nicht antwortet. „Musik neu starten“ auf der Seite macht ebenfalls den Ton-Neustart.
- **Protokoll dauerhaft** (`/etc/systemd/journald.conf.d/peppa-box.conf`, höchstens 100 MB). **Eltern-Seite → „Diagnose“:** Dienste mit Neustartzahl, Tonweg, Player-/Raspotify-Zustand, welche Soundkarte gerade spielt, Kopfhörer-Regler, SD-Pegel, Protokoll dieses und des vorigen Laufs. Nur lesen.
- **Einrichtung:** `dienst_einrichten.sh` installiert Tonausgabe und Ereignis-Programm, erlaubt `peppa-ausgang neustart` (sudo), Protokoll dauerhaft. `lautsprecher_einrichten.sh` **probt die Tonausgabe vorher** (1 s Stille mit denselben Schutzregeln wie Raspotify über `systemd-run`); scheitert die Probe, bleibt Raspotify direkt auf ALSA (ohne Kopfhörer-Umschaltung). Notfall-Rückweg: `PEPPA_ALSA_DIREKT=1 sh ~/peppa-box/software/dienst_einrichten.sh`.
- **Tests:** 259 grün, darunter die Tonausgabe als echtes Programm (Wechsel, kaputter Kopfhörer, kaputter Lautsprecher, echtes `aplay` mit ALSA-Dateiausgabe), Ereignis-Programm per UDP, Helfer, Einrichtung. **Nicht prüfbar hier:** Raspotify-Schutzregeln (darum die Probe bei der Einrichtung), echtes Verhalten von Spotify bei 502.
- **Am Pi (in dieser Reihenfolge):** 1. Eltern-Seite → „Nach Updates suchen“ → Update. 2. Per SSH `sh ~/peppa-box/software/dienst_einrichten.sh` (fragt nach dem Passwort), auf die Zeile „Raspotify: Ton ueber die Tonausgabe der Box“ achten. 3. `sudo reboot`. 4. „Kopfhörer erkennen“ wieder an. 5. Test: Karte auflegen, Kopfhörer ein/aus, je 30 s; danach „Diagnose“ öffnen (Tonweg „relais“, Abschnitt Player → raspotify `fliesst: true`).
- **Offen:** Touch-Rauschen nach der neuen Filterung messen (Prüfansicht, Balken ohne Berührung) und Abstand bei echter Berührung durch den Deckel; danach Schwelle festlegen. Ursache der Rausch-Unterschiede E0–E2 gegenüber E3 (Lage der Kupferfelder/Kabel, ohne Umbau nicht änderbar).

## Nachtrag 09.11.2026 (7) – Kopfhörer: Mischer (dmix) an der Pi-Klinke hängt

- **Befund (nach Update (6), Jan 20:24):** Eingesteckt → Meldung „Kopfhörer-Ausgang geht nicht (aplay auf 'kopfhoerer' beendet (Code -9))“, Musik lief weiter über den Lautsprecher (Rückfall hat gegriffen). Code -9 = von der Tonausgabe nach 3 s ohne Annahme beendet.
- **Tests Jan per SSH (20:31–20:38):** `speaker-test -D kopfhoerer` (alter Mischer, 44,1 kHz, period 1024, buffer 8192) → „unable to open slave, -22 Invalid argument“, auch unter Raspotify-Schutzregeln gleich → nicht die Schutzregeln. `speaker-test -D plughw:CARD=Headphones,DEV=0` **mit Regler 70 % + unmute: Ton hörbar** (Klinke und Kopfhörer in Ordnung; vorher stand der Regler auf 0, weil die Software die Kopfhörer bei Nichtbenutzung auf 0 stellt). dmix ohne feste Puffer (48 kHz bzw. 44,1 kHz): öffnet, aber kein Ton, hängt bis zum Abbruch nach 15 s.
- **Änderung:** `pcm.kopfhoerer` geht jetzt **direkt** auf `hw:CARD=Headphones,DEV=0` (plug, ohne dmix). Folge: Spotify und eine Ansage können nicht gleichzeitig über die Kopfhörer spielen; eine Ansage während Kopfhörer-Musik kann ausfallen. `ausgabe.py`: endet aplay auf den Kopfhörern sofort (z. B. belegt), zwei neue Versuche nach je 0,5 s, erst dann Rückfall auf den Lautsprecher (nicht nach einem Hänger). `peppa-stille`: `SuccessExitStatus=1` (aplay endet beim gewollten Stopp mit 1, war nur eine Schein-Fehlermeldung).
- **Am Pi:** Update über die Eltern-Seite, dann `sh ~/peppa-box/software/dienst_einrichten.sh`, dann `sudo reboot`. Test: Karte, Kopfhörer ein/aus.

## Nachtrag 09.11.2026 (8) – Klang: Equalizer auf der Eltern-Seite

- **Jan:** Gehäuse war komplett mit Watte ausgestopft, auch hinter dem Magneten; einiges wieder herausgenommen. Wunsch: Equalizer auf der Eltern-Seite, selbst abmischen.
- **Umsetzung:** alsaequal (Paket `libasound2-plugin-equal`, zieht `caps` mit dem LADSPA-Modul Eq10) im Weg zum Lautsprecher: softvol „Lautsprecher“ → Mono-Mischung → **Equalizer `peppa_klang`** → Mischer (dmix). 10 Bänder 31 Hz … 16 kHz, je **−24 … +6 dB**. Werte in `/dev/shm/peppa-box-klang.bin` (peppa-stille legt sie beim Start an, 0666, damit Player, Eltern-Seite und Raspotify sie nutzen können), gespeichert in den Einstellungen (`klang.baender`), der Player setzt sie beim Start. Neu `software/klang.py`, `/api/klang` (GET/POST), Eltern-Seite → Lautstärke → „Klang (Equalizer)“ mit Vorlagen **Neutral, Kleiner Lautsprecher, Hörspiel, Weicher**. Kopfhörer ohne Equalizer.
- **Geprüft hier mit echtem alsaequal/caps (Ubuntu-Pakete, amd64):** Änderungen wirken in laufender Wiedergabe sofort; Mittelstellung hebt alles um ca. 3 dB; Bänder überlappen (ein Band allein ganz unten = nur ca. −4 dB). Vorlage „Kleiner Lautsprecher“: 40 Hz −8 dB, 1,2 kHz +3,4 dB (absolut). Die erzeugte Kette aus `lautsprecher_einrichten.sh` gegen alsa-lib abgespielt: Pegel −3,1 dB gegenüber vorher (Mischung 0,25 statt 0,5 = 6 dB Reserve gegen Übersteuern) – am Drehknopf etwas weiter aufdrehen.
- **Sicherheit:** Der Equalizer wird nur eingebaut, wenn eine Probe unter den Schutzregeln von Raspotify (`systemd-run`) klappt; sonst Kette wie bisher, Hinweis auf der Seite. Paketinstallation braucht Internet.
- **Am Pi:** Update über die Seite, `sh ~/peppa-box/software/dienst_einrichten.sh` (achten auf „Equalizer“-Warnungen), `sudo reboot`. Dann Seite → Lautstärke → Klang, Musik laufen lassen, erst Vorlage „Kleiner Lautsprecher“, dann nach Gehör.
- **Hinweis Dämmung:** Etwas Watte im geschlossenen Gehäuse ist gut (weniger Dröhnen/Hall); zu dicht gestopft oder direkt an der Membranrückseite klingt es dumpf und leiser.
- **Korrektur 21:20:** Bei Jan meldete die Einrichtung „Equalizer laeuft unter den Schutzregeln von Raspotify nicht“ – Ursache war die **Probe selbst**: Raspotify (und die nachgebaute Umgebung) darf `/dev/zero` nicht öffnen (`DevicePolicy=strict`, nur Soundgeräte und `/dev/null`). Die Probe der Tonausgabe lief dadurch ohne Ton durch (zählte trotzdem als bestanden). Beide Proben spielen jetzt 1 s Stille aus einer Datei (`/run/peppa-box-stille.raw`). Am Pi: Update, Einrichtung erneut ausführen.

## Nachtrag 09.11.2026 (9) – Eigene Ansagen, Musik weich absenken bei Ansagen

- **Ansagen in Jans Stimme:** 22 eigene Aufnahmen (alle außer `timer_15/45/60`, `timer_aus`, `akku_unbekannt`; „bereit“ noch ElevenLabs) am Pi mit ffmpeg umgewandelt nach `software/ansagen/*.wav` (Stille vorn/hinten weg, 80 ms Ausblenden, Lautheit −16 LUFS, Spitze ≤ −3 dB, 150 ms Stille vorn, 44,1 kHz mono). **Nicht im Repository** (eigene Stimme), liegen nur auf dem Pi. Texte weichen zum Teil ab („Schlafenzeit, gute Nacht“, „Leg bitte eine Karte auf“) – egal, maßgeblich ist der Dateiname. Befehl für weitere Aufnahmen: siehe Chat 09.11. bzw. `ansagen/TEXTE.md`.
- **Wunsch Jan:** Musik bei jeder Ansage kurz leiser, auf Lautsprecher und Kopfhörer, „smooth, nicht billig“.
- **Umsetzung:** Läuft Musik, mischt die Tonausgabe (`ausgabe.py`, Klasse `Mischer`) die Ansage selbst in den Musikstrom: Musik sinkt in 0,35 s auf **−12 dB** (S-Kurve in dB), Ansage beginnt nach 0,3 s, nach der Ansage 0,4 s halten, dann in 1,2 s zurück. Übergabe über `/dev/shm/peppa-box-ansage.raw` + `.json` (Auftrag mit Ablaufzeit 0,7 s), Quittung/Lebenszeichen der Tonausgabe in `/dev/shm/peppa-box-ausgabe.json`. `toene.py` (`mischen()`, `Gemischt`) nutzt das automatisch für Player und Eltern-Seite; ohne Musik oder ohne Quittung spielt es wie bisher selbst über aplay. Nebeneffekt: Ansagen bei Kopfhörer-Musik fallen nicht mehr aus (Pi-Klinke ohne Mischer war belegt).
- **Geprüft hier:** 9 neue Tests (`test_ducking.py`: unverändert ohne Ansage, Absenken/Ansage/Halten/Zurück, keine Sprünge im Musikteil, Stopp, abgelaufene Aufträge, Übersteuern begrenzt, Umrechnung 16 kHz → 44,1 kHz Stereo, Quittung, Rückfall), alle 280 Tests grün. Rechenzeit Mischen: 13 ms je Sekunde Ton auf dem Rechner hier; auf dem Pi 3A+ geschätzt 10–20× mehr, also unter Echtzeit – **am Pi prüfen**, dass die Musik während einer Ansage nicht stockt.
- **Am Pi:** `cd ~/peppa-box && git pull && sh software/dienst_einrichten.sh` (installiert die neue Tonausgabe), dann Musik per Karte starten und Mond antippen (Timer-Ansage) – Lautsprecher und Kopfhörer. Werte (−12 dB, Zeiten) oben in `ausgabe.py` änderbar.
- **Befund am Pi (21:34):** Musik wurde nicht abgesenkt, Stimme leise. Ursache: Die Tonausgabe läuft unter Raspotify als **root** mit umask 077 → `/dev/shm/peppa-box-ausgabe.json` war `-rw-------`, der Player (hinkel) konnte sie nicht lesen und spielte auf dem alten Weg. **Korrektur:** Status mit 0644 schreiben (Test dazu). Raspotify stürzt seit dem Update um 21:31 nicht mehr ab (vorher ALSA-Assertion, Neustart-Zähler 21).
- **Befund am Pi (21:37): gar keine Musik.** Ursache nicht die Ansagen, sondern der Equalizer (Nachtrag 8): `aplay -D lautsprecher` bricht in der Kette softvol → Mono → equal → Mischer ab (`snd_pcm_hw_param_get_min: Assertion !snd_interval_empty`). Dadurch scheiterte die Probe der Tonausgabe, Raspotify wurde auf direktes ALSA umgestellt (auch kaputt, Absturzschleife) und peppa-stille lief nicht. Die Equalizer-Probe prüft ihn nur allein gegen „null“, nicht in der echten Kette. **Korrektur:** `lautsprecher_einrichten.sh` spielt nach dem Schreiben von asound.conf 1 s Stille durch `lautsprecher`; scheitert das mit Equalizer, läuft die Einrichtung ohne Equalizer neu (`PEPPA_EQ=0`). Klang-Einstellung fehlt dann, bis der Equalizer in der Kette repariert ist (offen).

## Nachtrag 09.11.2026 (10) – Equalizer schaltete die Musik ab: Ursache und neuer Aufbau

- **Ablauf bei Jan (21:20–21:28):** Einrichtung mit Equalizer → Probe der Tonausgabe scheiterte → Einrichtung stellte Raspotify auf ALSA direkt (Kopfhörer-Umschaltung aus) → **keine Musik**. Wiederhergestellt mit `PEPPA_EQ=0 PEPPA_RELAIS_PRUEFUNG=true sh software/dienst_einrichten.sh`; danach lief alles (auch die Ansagen-Mischung aus Nachtrag (9)).
- **Ursache (hier nachgestellt und belegt):** alsaequal öffnet seine Wertedatei (`/dev/shm/peppa-box-klang.bin`) **zum Schreiben**. Gehört sie einem anderen Benutzer und ist nicht für alle beschreibbar, scheitert das Öffnen des Equalizers („audio open error: Operation not permitted“) – und damit der ganze Lautsprecher-Weg, weil der Equalizer mitten in `lautsprecher` saß. Raspotify läuft als root **ohne Rechte** in eigenem Benutzer-Namensraum, darf fremde 0644-Dateien also nicht schreiben. Die Datei entstand vermutlich durch die Eltern-Seite (amixer als Benutzer → 0644), bevor peppa-stille sie für alle beschreibbar anlegen konnte. Zweiter Fehler: Die Einrichtung schaltete nach gescheiterter Probe eine **laufende** Tonausgabe ab.
- **Neuer Aufbau:** `lautsprecher` bleibt **ohne** Equalizer (wie vor dem Equalizer). Zusätzlicher Weg **`lautsprecher_klang`** (Mischung 0,25 → Equalizer → Mischer, gleicher Regler „Lautsprecher“). Nur die Tonausgabe nutzt ihn, wenn der Player ihn freigibt (`"klang": true` in `/dev/shm/peppa-box-ausgang.json`, nur wenn der Equalizer beim Start eingerichtet ist). **Lässt er sich nicht öffnen, spielt die Tonausgabe sofort über `lautsprecher` weiter** und meldet es (Eltern-Seite → Klang zeigt den Hinweis); beim nächsten Musikstart neuer Versuch. Ansagen ohne Musik und der Notfall-Weg (Raspotify direkt) laufen nie über den Equalizer.
- **Wertedatei:** legt nur root an (peppa-stille beim Start, Einrichtung), immer `chmod 0666`. `klang.py` ruft amixer nur, wenn die Datei existiert und für alle beschreibbar ist (amixer würde sie sonst als Benutzer anlegen). Die Probe des Equalizers in der Einrichtung entfällt (die Rückfall-Logik ersetzt sie).
- **Einrichtung:** schaltet eine schon laufende Tonausgabe **nie** ab, auch wenn ihre Probe scheitert (nur Warnung mit Notfall-Befehl).
- Tests: 285 grün (neu: Equalizer-Weg, Rückfall bei kaputtem Equalizer, Equalizer an/aus während Musik, Datei-Rechte, Probe scheitert bei laufender Tonausgabe).
- **Am Pi:** `cd ~/peppa-box && git pull && sh software/dienst_einrichten.sh` (ohne Zusätze), dann Karte, Eltern-Seite → Lautstärke → Klang.
- **Test am Pi (Jan, 21:48–21:50, `~/.asoundrc`, `speaker-test`):** Equalizer → `plug:peppa_dmix` läuft (nur linker Ton hörbar, ohne Mono-Mischung erwartet). Equalizer mit `route` dahinter (über `peppa_mono_plug`) oder davor: **Assertion `!snd_interval_empty`**, Ende-Code 1. Mono-Mischung als `ttable` **im plug** hinter dem Equalizer (eqd) bzw. davor (eqe): läuft, **beide Töne hörbar**. **Gewählt:** `lautsprecher_klang` (softvol „Lautsprecher“) → plug → `peppa_klang` (equal) → `peppa_klang_mix` (plug, ttable L+R je 0,25) → `peppa_dmix`. Hier gegen alsa-lib geprüft: nur links eingespeist kommt links und rechts gleich an. Mit softvol davor am Pi noch nicht probiert – die Einrichtung probt `lautsprecher_klang` und lässt den Equalizer sonst weg; die Tonausgabe fällt ohnehin zurück.

## Nachtrag 09.11.2026 (11) – Weiterspielen an der unterbrochenen Stelle

- **Wunsch Jan:** Nach einer Unterbrechung (Störung, Neustart) darf es nie wieder von vorn losgehen.
- **Umsetzung:** Neu `software/fortschritt.py`: je Karte (Spotify-Link) Titel und Stelle, in `~/.config/peppa-box/fortschritt.json` (höchstens alle 15 s, sofort bei Titelwechsel, Pause, Karte weg und beim Beenden; höchstens 200 Karten, älter als 30 Tage gilt nicht mehr). Quelle: Ereignisse von librespot (`rueckmeldung.py` rechnet die Stelle aus playing/paused/seeked mit), sonst die Web-API während der Prüfung. **Jeder Neustart einer Karte** (Reparatur nach Störung, Raspotify- oder Player-Neustart, Box aus und an, Karte nach anderer Karte wieder aufgelegt) startet über `PUT /me/player/play` mit `offset` (Titel) und `position_ms`, **3 s vor der gemerkten Stelle**. Lässt sich die Stelle nicht anspielen (400/403/404, z. B. Titel aus der Playlist entfernt): sofort von vorn, ohne Raspotify-Neustart. Pause/Weiter mit der Karte bleibt wie bisher „Fortsetzen“.
- **Von vorn:** Play-Feld **2 s halten**, oder die Karte wurde zu Ende gehört (letzter Titel lief aus).
- Tests: 300 grün (Stelle merken/sparsam speichern/vergessen/veraltet, Position aus Ereignissen, Start an der Stelle, nach Reparatur an der Stelle, unbrauchbare Stelle → von vorn, Von-vorn-Geste).
- **Am Pi:** nur Update über die Eltern-Seite (keine Einrichtung nötig).
- **Korrektur 22:05 (Befund Jan):** „Einen Moment, die Musik kommt gleich“ kam manchmal, obwohl die Musik schon 2–3 s lief. Ursache: Die Ansage kommt 8 s nach dem Auflegen, wenn die Prüfung den Start noch nicht bestätigt hat; die Prüfung braucht zwei Proben im Abstand von 2 s (ab 2 s nach dem Befehl), bei verzögertem Start also über 8 s. **Jetzt:** Meldet die Tonausgabe Tonfluss, entfällt die Ansage für diesen Start. Test dazu; nur Update über die Seite.

## Nachtrag 09.11.2026 (12) – Handy-Hotspots unterwegs (Baustein 2 umgesetzt)

- **Entscheidung Jan:** Unterwegs verbindet sich die Box mit dem Handy-Hotspot. Beide Handys sind Android. Baustein 2 aus dem Konzept vom 02.11. wird jetzt umgesetzt, Baustein 1 (WLAN-Verwaltung auf der Eltern-Seite) und 3 (Notfall-WLAN) später.
- **Welches WLAN gewinnt:** Der NetworkManager nimmt unter den sichtbaren gespeicherten WLANs das mit der höchsten `autoconnect-priority`, bei Gleichstand das zuletzt benutzte. Ist die Box verbunden, wechselt sie nicht von selbst. **Festgelegt:** Heim-WLAN `peppa-wlan` = 10, Hotspots = 5. Zu Hause also immer das Heim-WLAN (kein mobiles Datenvolumen), unterwegs der Hotspot. Wieder zu Hause bleibt die Box am Hotspot, bis er ausgeschaltet wird.
- **Neu `software/wlan_hinzufuegen.sh`:** fragt Name und Passwort ab (Passwort ohne Anzeige, 8–63 Zeichen) und schreibt `/etc/NetworkManager/system-connections/peppa-wlan-<Name>.nmconnection` (0600, Priorität 5, `autoconnect-retries=0`, WLAN-Stromsparen aus). Bewusst kein `nmcli connection add` (legt Netplan-Dateien an → langsamer Start). Gleicher Name: Datei wird ersetzt, Kennung bleibt. Heim-WLAN wird nicht angefasst. Dazu `--liste`, `--entfernen NAME`, `--prioritaet 1-9`. Danach `nmcli connection reload`, laufende Verbindung (SSH) bleibt. Hinweis bei Sonderzeichen im Namen.
- **Nie aufgeben:** Alle WLANs der Box bekommen `autoconnect-retries=0` (Standard: nach 4 Fehlversuchen 5 Minuten Sperre). Neu in `wlan_beschleunigen.sh`; `dienst_einrichten.sh` und `wlan_hinzufuegen.sh` ergänzen die Zeile in schon vorhandenen Dateien (wirkt beim Heim-WLAN ab dem nächsten Start).
- **Neu `software/wlan_suche.sh` als Dienst `peppa-wlan-suche`** (root, root-eigene Kopie `/usr/local/lib/peppa-box/wlan_suche`, eingerichtet von `dienst_einrichten.sh`): Ohne Verbindung sucht der NetworkManager immer seltener; der Dienst stößt alle 10 s `nmcli device wifi rescan` an, **nur im Zustand „disconnected“** (nicht während einer Anmeldung, nicht bei Verbindung; dann Prüfung alle 30 s). Schreibt „WLAN verbunden: …“ / „WLAN getrennt“ ins Protokoll.
- **Bitrate einstellbar:** `PEPPA_BITRATE=96|160|320` beim Aufruf von `dienst_einrichten.sh` setzt `LIBRESPOT_BITRATE` (ohne Angabe bleibt die Raspotify-Einstellung, Standard 160 kbit/s ≈ 70 MB/h; 96 ≈ 45 MB/h). Noch nicht entschieden.
- **Einstellung der Android-Hotspots:** fester Name ohne Sonderzeichen, WPA2-Personal (nicht nur WPA3), Band 2,4 GHz, Passwort danach nicht mehr ändern.
- Tests: 310 grün (Hotspot eintragen/ersetzen/entfernen/Liste, falsche Eingaben ändern nichts, Passwort nie in der Ausgabe, Heim-WLAN geschützt, nie aufgeben, Suche nur bei getrennt, Bitrate nur auf Wunsch).
- **Am Pi:** `cd ~/peppa-box && git pull && sh software/dienst_einrichten.sh`, dann je Handy `sh software/wlan_hinzufuegen.sh`, Kontrolle `sh software/wlan_hinzufuegen.sh --liste`, `sudo reboot`. **Test:** Heim-WLAN im Speedport aus, Hotspot an → Zeit bis „bereit“; Heim-WLAN an, Hotspot aus → Box zurück im Heim-WLAN. Protokoll: `journalctl -u peppa-wlan-suche -b`.
- **Offen:** Fehlerton/Ansage nach ca. 60 s ohne WLAN; Start ohne bekanntes WLAN wartet bis zur Höchstzeit von `NetworkManager-wait-online` (Raspotify startet danach alle 3 s neu, bis das Netz da ist) – am Pi messen.
- **Test am Pi (Jan, 22:26–22:34):** Hotspot „Jan“ (Pixel, WPA2, „2,4 und 5 GHz“) wird von der Box auf 2,4 GHz, Kanal 11, gesehen. Erster Versuch (Speedport-WLAN aus): keine Verbindung zum Hotspot, Rückkehr ins Heim-WLAN dauerte ca. 2–3 min, Ursache noch offen (Protokoll steht aus). Zweiter Versuch 22:34: **Wechsel zum Hotspot während laufender Musik ohne hörbare Unterbrechung.** Noch zu prüfen: Hotspot aus → zurück ins Heim-WLAN (Dauer).

## Nachtrag 09.11.2026 (13) – Klick beim Antippen

- **Wunsch Jan:** Jedes Antippen von **zurück, Play und vor** klickt – mit dem von Claude erstellten Klickton (`Click_Tone.wav`), sehr weich und dezent. **Nicht** beim Mond (Schlummer), **nicht** bei der Ein-Taste.
- **Ton:** `software/klaenge/klick.wav` = Jans Datei unverändert im Klang; nur die 54 ms Stille vorne entfernt (sonst klickt es spürbar zu spät), Ausklang ab −60 dBFS mit 20 ms abgeschnitten (0,33 s statt 0,49 s), von 48 auf 44,1 kHz umgerechnet (Takt der Box), Stereo bleibt.
- **Lautstärke:** Einstellung `bedienung.klick` in Prozent der Aufnahme, **Standard 15 %** (≈ −16 dB, Spitze ≈ −18 dBFS; Ansagen −3 dBFS), 0 = aus. Eltern-Seite → Bedienung → Prüfen und einstellen → Klick (0–60 %). Der Klick folgt außerdem dem Lautstärkeregler (Drehknopf). Wert festgelegt, nicht am Gerät gehört → nach Gehör anpassen.
- **Wann:** sobald die Berührung als Finger zählt (70 ms, gleiche Grenze wie gegen Phantom-Berührungen), also schon beim Berühren, nicht erst beim Loslassen; einmal je Berührung, auch beim Halten (spulen, 2 s Play = von vorn). Kein Klick bei Rauschen unter 70 ms und bei mehreren Feldern gleichzeitig.
- **Wie:** `toene.Klicker` (eigener Faden, der Bedienungs-Faden wartet nie). Lautsprecher: `aplay` in den Mischer (dmix) neben der Musik, Musik wird **nicht** abgesenkt. Kopfhörer ohne Musik: `aplay` direkt auf die Pi-Klinke; eine Ansage beendet einen noch laufenden Klick vorher (Klinke ohne Mischer). Kopfhörer mit Musik: die Tonausgabe (`ausgabe.py`) mischt den Klick in den Musikstrom (Auftrag `/dev/shm/peppa-box-klick.json`, bei jedem Musikstück geprüft).
- **Bekannte Grenze (nicht gemessen):** Mit Kopfhörern **während Musik** kommt der Klick um den Puffer von aplay verzögert (vermutlich einige Zehntel Sekunden). Am Lautsprecher und ohne Musik sollte er praktisch sofort kommen. Am Pi hören; ist es störend, Puffer der Kopfhörer-Ausgabe verkleinern (Risiko Aussetzer am Pi 3A+).
- Tests: 332 grün (neu `test_klick.py`, 22: welche Felder klicken, Mond/Ein-Taste nie, einmal je Berührung, Rauschen/mehrere Felder, Pegel 15 %, aus bei 0, Wege Lautsprecher/Kopfhörer/gemischt, Mischen ohne Absenken, Begrenzung, Einstellung).
- **Am Pi:** Update über die Eltern-Seite, dann einmal `sh ~/peppa-box/software/dienst_einrichten.sh` (neue Tonausgabe für den Klick auf Kopfhörern während Musik; Lautsprecher klickt auch ohne). Probe von Hand: `python3 ~/peppa-box/software/toene.py klick`.
- **Test am Pi (Jan, 22:41–22:45):** Erst kein Klick hörbar, obwohl der Player schon klicken wollte (`/dev/shm/peppa-box-klick-15.wav` vorhanden). `aplay` mit 15 % von Hand: hörbar, „laut genug“. Kurz danach klickt die Box beim Antippen hörbar; Ursache für den ersten Fehlschlag unbekannt (vermutlich von Musik überdeckt oder Player noch nicht neu gestartet). **Offen:** mit laufender Musik anhören, ggf. Pegel erhöhen; tritt es wieder auf, aplay-Fehler ins Protokoll schreiben.

## Nachtrag 09.11.2026 (14) – Meldung „Keine Verbindung zu Spotify“ blieb nach WLAN-Wechsel stehen

- **Befund Jan (22:38):** Nach erfolgreichem Wechsel ins neue WLAN zeigte die Eltern-Seite weiter „kümmert sich – Keine Verbindung zu Spotify (Temporary failure in name resolution), neuer Versuch in 2 s“. Der Fehler selbst ist beim Wechsel normal (Netz/DNS kurz weg).
- **Ursache (Code):** Im Leerlauf (Box bereit, Gerät bekannt) hat eine erfolgreiche Abfrage danach die Netz-Meldung nicht gelöscht; sie blieb bis zur nächsten Taste/Karte stehen.
- **Korrektur:** `steuerung.py`: antwortet Spotify wieder, verschwindet eine Netz-Meldung sofort, Protokoll „Spotify wieder erreichbar.“ Test `test_netz_kurz_weg_im_leerlauf_meldung_verschwindet` (schlägt ohne Korrektur fehl). Alle Tests grün. **Am Pi:** nur Update über die Eltern-Seite.
- **Danach (22:39):** „Spotify kennt die Box gerade nicht (Gerät 'Peppa Box' fehlt)“. Erwartbar, solange librespot nach dem IP-Wechsel noch nicht neu bei Spotify angemeldet ist. Vorhandene Selbstheilung: Raspotify-Neustart nach 45 s (Karte wartet) bzw. 180 s (Leerlauf). **22:40: Box hat sich von selbst erholt** (Meldung um 22:39, ca. 1 min). Ob librespot sich selbst neu angemeldet hat oder die Selbstheilung Raspotify neu gestartet hat, ist ohne Protokoll offen (`journalctl -u raspotify -u peppa-player --since 22:35`). Kein Handlungsbedarf, solange es so schnell geht.
- **Änderung 22:45 (Wunsch Jan: mindestens doppelt so laut):** Standard `bedienung.klick` **30 %** statt 15 % (+6 dB, Spitze ≈ −12 dBFS). Der Klick läuft über denselben Lautstärkeregler wie die Musik (softvol „Lautsprecher“), folgt also dem Drehknopf. Steht in `einstellungen.json` schon ein gespeicherter Wert, gilt dieser – dann auf der Eltern-Seite hochstellen.
- **Abgenommen (Jan, 22:48):** Klick mit 30 % passt. Erledigt.

## Nachtrag 09.11.2026 (15) – Equalizer grafisch

- **Wunsch Jan:** Equalizer auf der Eltern-Seite grafisch, wie man ihn heute kennt.
- **Umgesetzt (`web/index.html`, nur Seite, Schnittstelle `/api/klang` unverändert):** 10 Bänder als Punkte auf senkrechten Schienen, weiche Kurve durch alle Punkte (Fläche zur 0-dB-Linie getönt), dB-Raster −24 … +6 in 6-dB-Schritten, Frequenzen und Werte darunter. Bedienung: Punkt mit Finger/Maus ziehen (ganze Spalte greift, Seite scrollt dabei nicht), Wert-Blase beim Ziehen, **doppelt tippen = 0 dB**, Tastatur (Pfeile ±1, Bild ±3, Pos1/Ende, 0). Änderungen gehen nach 150 ms Ruhe an die Box (wie bisher). Vorlagen-Knöpfe unter der Grafik, die passende Vorlage ist orange markiert. Hell und dunkel geprüft (Chrome, 390 px, Ziehen und Tasten).
- **Am Pi:** nur Update über die Eltern-Seite, Seite neu laden.

## Nachtrag 09.11.2026 (16) – Eltern-Seite: Was die Tasten können

- **Wunsch Jan:** Auf der Eltern-Seite sehen, welche Funktionen jede Taste hat, auch die Doppelbelegungen durch Halten.
- **Umgesetzt:** Eltern-Seite → Bedienung → **„Was die Tasten können“** (aufklappbar). Je Bedienelement (zurück, Play, vor, Mond, Drehknopf, Ein-Taste, Karte, Kopfhörer): Ort, ob es klickt, und jede Geste mit Wirkung. Halte-Funktionen orange, Elemente mit Doppelbelegung tragen das Zeichen „2 Funktionen“ bzw. „3 Funktionen“ (Ein-Taste). Darunter die Regeln gegen Fehlbedienung (70 ms, mehrere Felder, klemmende Ein-Taste, Ruhezeit „keine Musik“).
- **Quelle:** Neu `bedienung.belegung(cfg)`, abrufbar unter `GET /api/belegung`. Gebaut aus denselben Konstanten, die die Gesten auslösen (`LANG_SPRUNG_S`, `VON_VORN_S`, `AKKU_HALTEN_S`, `AUS_HALTEN_S`, `TIMER_STUFEN`, `KNOPF_MIN` …) und aus den Einstellungen (Touchfeld-Zuordnung, Schritt je Raste, Klick). Ändert sich eine Zeit im Code, stimmt die Anzeige automatisch.
- Tests: 335 grün (neu: Belegung mit Doppelbelegungen, Einstellungen wirken, Zeiten folgen den Konstanten). Hell und dunkel in Chrome bei 390 px angesehen.
- **Am Pi:** nur Update über die Eltern-Seite, Seite neu laden.

## Nachtrag 10.11.2026 (17) – 40×40-Etiketten, Karten bespielen, neue Eltern-App (Alltag / Entwickler)

- **Entscheidung Jan:** Etikett **40 × 40 mm** (dm-Fotostation, Freiform-Sticker). Die App baut nur die Etiketten und bietet sie zum Download an; Drucken und Schneiden macht Jan am dm-Automaten. Kein Umbau an der Box. Die Vertiefung in der Karte für 40 × 40 ist ein eigener Punkt (Kartendesign), nicht Teil dieses Nachtrags.
- **Eltern-App neu (`software/web/`):** modern, Handy und Browser, hell und dunkel, mit Peppa-Box-Logo, installierbar (Manifest, Icons). Der bisherige Funktionsumfang ist vollständig erhalten, aufgeteilt in zwei Bereiche (Umschalter oben): **Alltag** (Start, Karten, Zeiten, Hilfe) für die Familie und **Entwickler** (Ton, Bedienung, Etiketten, System) mit Warnhinweis. Dateien: `index.html`, `app.css`, `kern.js`, `app.js`, `alltag.js`, `karten.js`, `entwickler.js`, `klang.js` (flach, der Server liefert nur Namen ohne „/“).
- **Karte bespielen (Alltag → Karten → Neue Karte):** Spotify-Link einfügen → Titel und Cover werden **automatisch gesucht** (oEmbed, Rückfall og:image, Rückfall Web API) und als Etikett-Vorschau gezeigt → „Weiter“ → Karte auf das Fach legen → Box schreibt den Link (nur NTAG21x, Erfolg erst nach Zurücklesen) → „Fertig“ + Etikett-Download. Ist die Karte schon belegt, kommt vorher eine Rückfrage (Überschreiben nur nach Bestätigung). Mehrere Karten hintereinander möglich. Kartenablauf: Web stellt einen Auftrag (`karten.auftrag_stellen`), der Player führt ihn aus (`_auftrag_ausfuehren`), Ergebnis fertig / belegt / fehler, 120 s Frist. MIFARE-Classic-Karten sind nicht beschreibbar: nur Zuordnung UID → Link in `karten.json` auf der Box.
- **Cover automatisch:** `cover.py` (Suche, 640-px-Variante von i.scdn.co, Zwischenspeicher in `~/.config/peppa-box/cover/`), unbekannte Karten mit Link werden von allein aufgenommen, Suche im Hintergrund mit Drosselung. Eigenes Bild je Karte möglich (wird im Browser verkleinert). **Das Cover der aufliegenden Karte steht in der Kopfzeile und auf der Startseite.**
- **Etikett (`etikett.py`, Pillow):** 40 mm bei 300 dpi (472 px), weißer Rand 0,5 mm, Ecken 3 mm, Titel bei fehlendem Cover. Downloads: einzelnes Etikett (PNG), **Bogen 90 × 140 mm mit 2 × 3 = 6 Etiketten**, Testbogen mit Messlinien. Einstellungen unter Entwickler → Etiketten (`etikett` in `einstellungen.json`).
- **Sparhinweis:** Bei 40 mm passen 6 Etiketten auf einen Freiform-Bogen (2,95 €, ca. 0,49 € je Karte) statt 3 bei früher geplanten 60 mm: erst drucken, wenn der Bogen voll ist (die Kartenliste markiert „noch nicht gedruckt“, „Alle gedruckt“ setzt zurück).
- **Dienst:** `dienst_einrichten.sh` installiert zusätzlich `python3-pil` und `fonts-dejavu-core` (Pillow fehlt → die Seite sagt es verständlich, der Rest läuft).
- **Tests:** 439 grün (1 übersprungen). Neu: `test_karten.py`, `test_kartenschreiber.py`, Karten-/Cover-/Etikett-Schnittstelle in `test_web.py` (44), Auftragsabläufe in `test_player.py` (26), **`test_browser.py`** (8, echter Chrome mit simuliertem Kartenleser: alle Seiten ohne Konsolenfehler, Bereiche, Bespielen bis Download, Überschreiben-Rückfrage, ungültiger Link, Kartenliste und Bogen, Start mit Karte im Fach, Verbindungsabbruch; wird ohne Playwright/Chrome übersprungen). Zusätzlich von Hand in Chrome geprüft: Handy-Breite, Desktop, dunkel.
- **Nicht geprüft (ehrlich):** (1) Spotify-Abfragen (oEmbed/og:image/Web API) aus der Entwicklungsumgebung nicht erreichbar, im Test nachgebildet → am Pi mit echten Links prüfen. (2) Schreiben auf echte NTAG-Karten mit dem RC522 nur simuliert. (3) **Bogenmaße (Rand 3 mm, Abstand 4 mm) und das Verhalten der dm-Station (skaliert sie? Schnittkante?) sind Annahmen** → Testbogen drucken und messen. (4) Hörbuch-Links werden nicht unterstützt (nur Playlist, Album, Titel, Podcast/Show). (5) MIFARE Classic: nur Zuordnung auf der Box.
- **Am Pi:** Update über die Eltern-Seite, dann `sh ~/peppa-box/software/dienst_einrichten.sh` (installiert Pillow), Seite neu laden. Danach: eine NTAG-Karte über „Neue Karte“ bespielen, Etikett laden; **Entwickler → Etiketten → Testbogen** am dm-Automaten drucken und die Maße messen (40-mm-Quadrat, Rand, Ecken), Ergebnis hier eintragen.

## Nachtrag 10.11.2026 (18) – Private Playlists: kein Cover von Spotify

- **Befund Jan (20:59):** Link `…/playlist/2Lj…?si=…&pt=…` (Folge 103 der drei ??? Kids, in Spotify als „Private Playlist“ von einem anderen Nutzer) → „Ohne Titel“, „kein Cover gefunden (oEmbed 404)“. **Ursache:** Spotify gibt zu nicht öffentlichen Playlists weder oEmbed noch Vorschau-Bild heraus; das ist kein Fehler der Box.
- **Umgesetzt:** (1) Der eingefügte Link wird **samt Zusatz (`si`, `pt` = Zugangsschlüssel)** zusätzlich bei oEmbed und Seite versucht (`cover.original_link`). **Ob Spotify damit etwas herausgibt, ist nicht geprüft** (aus der Entwicklungsumgebung kein Zugriff auf Spotify). (2) Verständliche Meldung („bei privaten Playlists normal“). (3) **Titel selbst eingeben** (`POST /api/cover/titel`, `cover.titel_setzen`). (4) **Eigenes Bild: Screenshot mit Strg + V einfügen oder Datei wählen, danach Ausschnitt-Dialog** (Quadrat verschieben, Größe per Regler; bei fast quadratischen Bildern ohne Dialog). Gilt im Assistenten und in der Kartenansicht.
- **Tests:** 444 grün (neu: Meldung bei privater Playlist, Link mit Zugangsschlüssel, Titel von Hand, Browser-Test Screenshot → Ausschnitt → Cover + Titel).
- **Offen / Risiko:** Ob die **Box ihr Spotify-Konto diese private Playlist abspielen kann**, ist ungeklärt (fremde, nicht öffentliche Playlist). Am Pi mit der Karte ausprobieren; geht es nicht, Playlist in eine **eigene, öffentliche Playlist kopieren** (alle Titel markieren → zu neuer Playlist hinzufügen); deren Cover findet die App dann von allein.
- **Am Pi:** nur Update über die Eltern-Seite, Seite neu laden.

## Nachtrag 10.11.2026 – Startton sofort nach dem Einschalten
- **Wunsch Jan (21:14):** Nach dem Druck auf die Ein-Taste passiert ca. eine Minute nichts, für ein Kind schlimm. Er will so früh wie möglich einen Ton.
- **Messung am Pi (21:16):** `systemd-analyze`: Kernel 4,3 s + Userspace 20,0 s = 24,3 s. Kritischer Pfad bis `basic.target` bei 7,8 s, NetworkManager 5,0 s (bei 8,3 s), ssh bei 13,3 s. Größte Posten in `blame`: `NetworkManager-wait-online` 6,7 s, `apt-daily-upgrade` 6,1 s, `apt-daily` 2,9 s, `rpi-resize-swap-file` 2,2 s, `man-db` 1,6 s. Die Firmware-Zeit vor dem Kernel (ca. 3–5 s, Schätzung) steht nicht darin. Die Ansage „bereit“ kommt erst, wenn Raspotify am Netz hängt und Spotify die Box kennt, also nach dem Start des Players (der wartet auf `network-online`). Die Lücke bis dahin hörte Jan als „eine Minute“.
- **Neu: Dienst `peppa-startton`** (`dienst_einrichten.sh`): läuft nach `peppa-stille` (Mischer, Verstärker entstummt), wartet **nicht** auf WLAN, Spotify oder Player. Ruft `toene.py start`: setzt die Startlautstärke (gleiche Logik wie der Player, einmal je Einschalten), legt den Softvol-Regler „Lautsprecher“ an, falls er nach dem Start noch fehlt (1 s Stille), und spielt dann `ansagen/start.wav`. Ist der Regler nicht da und nicht anlegbar, bleibt es still (lieber kein Ton als in unbekannter Lautstärke). Ruhezeit mit „keine Musik“: still.
- **Ton:** `software/ansagen/start.wav`, Aufnahme von Jan (ElevenLabs, Stimme „Helmut“, Datei vom 10.11.), im Haus-Format umgewandelt (liegt im Repository wie „bereit“, weil es die ElevenLabs-Stimme ist und nicht Jans eigene): Stille vorn/hinten weg, 80 ms Ausblenden, −16 LUFS, Spitze −3 dBFS, 150 ms Stille vorn, 44,1 kHz mono, 1,93 s. Den gesprochenen Text hat Claude nicht gehört; vorgesehen war „Hallo! Ich werde gerade wach.“ (Jan prüft, ob die Datei das sagt, sonst `TEXTE.md` anpassen). Ohne Aufnahme spielt die Box zwei kurze Töne, nie die Sprachausgabe.
- **Zeitfresser aus:** `dienst_einrichten.sh` schaltet die Zeitgeber `apt-daily`, `apt-daily-upgrade`, `man-db`, `dpkg-db-backup` ab (liefen bei jedem Einschalten nach, ca. 11 s Rechenzeit und SD-Zugriffe). Folge: **keine automatischen Betriebssystem-Updates**; von Hand `sudo apt update && sudo apt upgrade` (auch für Raspotify). Rückgängig: `sudo systemctl enable --now <name>.timer`.
- **Erwartung (nicht gemessen):** Ton etwa 12–15 s nach dem Druck (Firmware + Kernel ca. 8 s, bis `peppa-stille` ca. 4 s, Python-Start ca. 1–2 s). „bereit“ kommt wie bisher später.
- **Am Pi:** `cd ~/peppa-box && git pull && sh software/dienst_einrichten.sh`, dann `sudo reboot`. Prüfen: Ton hörbar, Lautstärke angenehm (Startlautstärke), `journalctl -b -u peppa-startton -u peppa-stille -u peppa-player --no-pager -o short-monotonic | head -30` (Zeitpunkt des Startton), `systemd-analyze` erneut. Von Hand: `python3 ~/peppa-box/software/toene.py start`.
- **Nicht angefasst (Jan: kein Umbau mehr):** Hardware. Mögliche nächste Schritte, falls es noch zu langsam ist: Player nicht mehr auf `network-online` warten lassen (Tasten/Klick und Karten wären früher aktiv; mit Test am Pi), `NetworkManager-wait-online` kürzen.
- Geprüft ohne Hardware: `test_toene.py` (+9: Reihenfolge Lautstärke vor Ton, Regler anlegen, kein Ton ohne Regler, Ruhezeit, keine Sprachausgabe für „start“, Aufnahme vor Ton), `test_einrichtung.py` (+1). Alle 21 Testdateien grün; Reihenfolge-Fehler (Ton vor Lautstärke) wird erkannt.

## Nachtrag 10.11.2026 (2) – Sparzustand (Standby)
- **Wunsch Jan (21:34):** Die Box soll nach dem Drücken nicht erst hochfahren müssen. Entscheidungen Jan: Aufwecken **nur per Ein-Taste**; **6 Stunden** Sparzustand, dann ganz aus; Ein-Taste **2 s halten = Sparzustand**, zusätzlich **ca. 10 s halten = ganz aus**; WLAN darf im Sparzustand aus sein.
- **Warum nicht „echter“ Standby:** Der Pi 3A+ hat meines Wissens keinen Suspend (nur läuft / heruntergefahren). Prüfen am Pi: `cat /sys/power/state /sys/power/mem_sleep`. Darum ein Sparzustand mit minimaler Last:
  - **Eintritt** (Player, `sparzustand()`): „Tschüss“, Musik pausiert, Kartenleser/Touch schlafen, Marker `gestartet` und `ansage-bereit` in `/dev/shm` gelöscht (Aufwachen gilt wie Einschalten: Startlautstärke, „bereit“), dann `sudo systemctl start --no-block peppa-standby.service`.
  - **`peppa-standby`** (nicht aktiviert, nur vom Player gestartet): `ExecStartPre=+sparen ein` beendet `peppa-player`, `peppa-web`, `raspotify`, `peppa-wlan-suche` und schaltet das WLAN aus (`nmcli radio wifi off`); `peppa-stille` läuft weiter (Verstärker bleibt wach für den Ton). `ExecStart` = `software/sparzustand.py` (Wache). `ExecStopPost=+sparen wlan-an`.
  - **Wache** (`sparzustand.py`, nur Standardbibliothek): liest die Ein-Taste (SCL, 3 Proben, erst nach 0,5 s losgelassener Taste scharf), Druck = `sudo systemctl start --no-block peppa-aufwachen.service` und gleichzeitig **sofort Startton** (`toene.startton`); danach endet sie. Nach `sparzustand.aus_nach_h` (Standard 6, Eltern-Seite 2/6/12/24 Std) `systemctl poweroff`. Akku-Wache wie im Player (≤ 3,30 V dreimal → sauber aus). Klappt das Aufwecken nicht: 3 Versuche, dann Neustart der Box; ein unerwarteter Fehler weckt die Box ebenfalls (nie tot im Sparzustand hängen).
  - **`peppa-aufwachen`** (oneshot, root): `sparen aus` = WLAN an, Player + Eltern-Seite + WLAN-Suche sofort starten, **Raspotify erst nach `nm-online -t 25`** (sonst Fehlstart wie am 02.11.).
  - **`sparen.sh`** → root-eigene Kopie `/usr/local/lib/peppa-box/sparen` (`ein` / `aus` / `wlan-an`), jeder Schritt einzeln, Fehler halten die anderen nicht auf.
  - **Sicherung WLAN:** NetworkManager merkt sich „WLAN aus“ über einen Neustart. Darum `ExecStopPost wlan-an` (auch beim Ausschalten aus dem Sparzustand) **und** Dienst `peppa-wlan-an` (beim Hochfahren immer WLAN an, falls die Box im Sparzustand stromlos wurde).
- **Ein-Taste (`bedienung.py`):** 2 s halten: „Tschüss“ + Pause, beim Loslassen Sparzustand. Weiter halten bis 10 s: Ansage `ganz_aus` („Ich schalte mich jetzt ganz aus.“, ohne Aufnahme drei absteigende Töne), beim Loslassen ganz aus. Über 15 s gedrückt (klemmt): nichts. Eltern-Seite „Was die Tasten können“ zeigt beide.
- **Auto-Aus** (Einstellung, Standard aus) geht jetzt ebenfalls in den Sparzustand statt ganz aus; Akku leer und „Ausschalten“ auf der Eltern-Seite schalten weiter ganz aus.
- **Eltern-Seite → Zeiten:** „Automatisch in den Sparzustand“ (nach … Min ohne Musik) und neu „Im Sparzustand ganz aus nach“ (Einstellung `sparzustand.aus_nach_h`, 1–48). Im Sparzustand ist die Seite nicht erreichbar (WLAN aus).
- **Erwartung (nicht gemessen):** Ton sofort (ca. 1–2 s: Python-Start + `aplay`), WLAN + Spotify ca. 5–8 s (WLAN-Anmeldung 0,4 s + DHCP 3 s laut Messung 02.11., dazu Raspotify). Verbrauch im Sparzustand grob 0,5–1 W (geschätzt) – am Pi messen (Akku-Seite zeigt den Strom), dann ggf. weiter sparen (CPU-Takt, LED aus).
- **Am Pi:** `cd ~/peppa-box && git pull && sh software/dienst_einrichten.sh`, dann `sudo reboot`. Prüfen: (1) Ein-Taste 2 s halten → „Tschüss“, nach kurzer Zeit still, `systemctl status peppa-standby`, WLAN weg (`nmcli radio`), `journalctl -b -u peppa-standby --no-pager`; (2) Ein-Taste drücken → Startton sofort, Box im WLAN, „bereit“ kommt; mit Stoppuhr festhalten; (3) Ein-Taste 10 s halten → „ganz aus“-Töne, Box aus, Wiedereinschalten ok **und WLAN da**; (4) Sparzustand mit kurzer Zeit (Einstellung 1 Std ist das Minimum, zum Testen `sparzustand.py` mit Standard ändern oder abwarten) → aus, nächster Start mit WLAN; (5) Karte während Sparzustand auflegen: tut nichts (gewollt).
- **Offen/Annahmen:** `ExecStartPre=+` und `ExecStopPost=+` in einem Dienst mit `User=` sowie `nmcli radio wifi` als root sind nicht am Pi geprüft; Lesen der Ein-Taste ohne laufenden Player (I2C ruhig) wie im Player, aber nicht am Pi gesehen. Im Sparzustand läuft `peppa-stille` weiter (Verstärker wach, etwas Strom).
- Geprüft ohne Hardware: neu `test_sparzustand.py` (23: Wache mit simulierter Taste/Uhr, Eintrittstaste weckt nicht, Störimpulse, Aufwecken-Fehler, Neustart-Rückfall, 6 Std, Akku leer, Hauptprogramm, `sparen.sh` mit nachgebauten systemctl/nmcli/nm-online), dazu Tests in `test_bedienung` (+5), `test_player` (+4), `test_automatik`, `test_web`, `test_einrichtung`, `test_toene`. Alle 22 Testdateien grün; vier eingebaute Fehler (Taste ohne Entlassen scharf, kein Neustart-Rückfall, 10 s ohne Wirkung, Marker nicht zurückgesetzt) werden erkannt.

## Nachtrag 10.11.2026 (3) – Ansage beim Einstecken des Netzteils
- **Wunsch Jan (22:05):** Beim Einstecken des Netzteils (Box lädt) soll ein Ton spielen. Aufnahme von Jan (ElevenLabs, Stimme „Helmut“): „Deine Box wird geladen …“ (Text von Jan genannt, Claude hat die Datei nicht gehört).
- **Ton:** `software/ansagen/netzteil.wav`, im Haus-Format wie `start.wav` (Pausen im Satz unverändert, Ende knapp hinter dem letzten Laut, 80 ms Ausblenden, Spitze −3 dBFS, 150 ms Stille vorn, 44,1 kHz mono, 1,81 s). Ansage `netzteil` in `toene.py` und `TEXTE.md`; ohne Aufnahme zwei kurze aufsteigende Töne, nie die Sprachausgabe.
- **Auslöser (`akku.py`, `Akkuwache`):** Der Akku-Chip (INA219) wird jetzt alle **2 s** gelesen (vorher 15 s), damit der Ton kurz nach dem Einstecken kommt. Die Ansage kommt beim **Wechsel von Akkubetrieb auf „lädt“/„voll“**, nach **2 Messungen in Folge** (gegen Zittern um die Schwelle). Nicht beim Start am Netzteil (dort läuft der Startton), nicht beim Ausstecken (nur Protokoll „Netzteil abgezogen“), nicht bei Lesefehlern. Die Auswertung für „Akku schwach“ und „Akku leer“ (3 Messungen in Folge) läuft unverändert **alle 15 s**, damit diese Schwellen nicht früher auslösen. Die Ansage wird wie alle anderen in die Musik gemischt (Musik senkt sich ab).
- **Am Pi:** `cd ~/peppa-box && git pull` (oder Update über die Eltern-Seite), dann `sudo systemctl restart peppa-player`. Prüfen: Netzteil ausstecken, 5 s warten, einstecken → Ansage nach ca. 2–4 s; im Protokoll `journalctl -u peppa-player | grep Netzteil`. Von Hand hören: `python3 ~/peppa-box/software/toene.py netzteil`.
- **Annahme, nicht am Pi gesehen:** Das Vorzeichen des Stroms (mit Netzteil „lädt“) stammt aus den Messungen vom 02. und 05.11. (`akku.py`). Zusätzliche I2C-Last durch das 2-s-Lesen ist nicht gemessen; gelesen wird im selben Faden wie die Ein-Taste (keine Überschneidung).
- Geprüft ohne Hardware: `test_akku.py` (+6: Einstecken nach 2 Messungen, auch bei vollem Akku, Start am Netzteil still, Zittern, Ausstecken/Wiedereinstecken, Lesefehler; Taktungstest angepasst), `test_toene.py`. Alle 22 Testdateien grün.
- **Korrektur 22:15:** `netzteil.wav` war zuerst nicht im Repository (die `.gitignore` schließt eigene Aufnahmen in `software/ansagen/` aus, nur `bereit` und `start` waren freigegeben). Darum spielte der Pi beim ersten Test nur den Ersatzton. Jetzt wie `start.wav` freigegeben und eingecheckt. Merke: **jede neue Aufnahme in `software/ansagen/` braucht eine Ausnahme in `.gitignore`**, sonst kommt sie nie auf den Pi.

## Nachtrag 10.11.2026 (4) – Ansage „ganz aus“
- **Aufnahme von Jan (22:28):** ElevenLabs, Stimme „Helmut“, Text „Ich schalte mich jetzt ganz aus.“ (Claude hat die Datei nicht gehört, nur die Pegel geprüft: im Satz liegt eine Pause von ca. 0,5 s, unverändert gelassen).
- **Ton:** `software/ansagen/ganz_aus.wav`, Haus-Format wie `start.wav` (Ende knapp hinter dem letzten Laut, 80 ms Ausblenden, Spitze −3 dBFS, 150 ms Stille vorn, 44,1 kHz mono, 3,39 s). Der Name `ganz_aus` war in `toene.py` und `TEXTE.md` schon vorgesehen, keine Programmänderung. `.gitignore`: Ausnahme für `ganz_aus.wav`, sonst wäre die Datei nicht im Repository (gleiche Falle wie bei `netzteil.wav`).
- **Wann:** Ein-Taste 10 s halten (und beim Loslassen ganz aus). Vorher spielten drei absteigende Töne.
- **Am Pi:** `cd ~/peppa-box && git pull`, dann `sudo systemctl restart peppa-player`. Von Hand hören: `python3 ~/peppa-box/software/toene.py --alle`.
- **Offen:** Die Ansage dauert 3,4 s; ob der Pi sie vor dem Ausschalten zu Ende spricht, ist nicht am Pi gesehen (Tests ohne Hardware grün, alle 22 Dateien).

## Nachtrag 10.11.2026 (5) – „Tschüss“ erst beim Loslassen
- **Problem (Jan, 22:32):** Wer 10 s halten will, hörte bei 2 s schon „Tschüss“, obwohl er weiter hielt.
- **Änderung (`bedienung.py`):** Bei 2 s wird nur die Musik pausiert (stille Rückmeldung), nichts gesagt. Bei 10 s kommt „Ich schalte mich jetzt ganz aus“ (ohne vorheriges „Tschüss“). Wer zwischen 2 und 10 s loslässt, hört „Tschüss“ beim Loslassen, dann Sparzustand (bzw. aus ohne Sparzustand). Der Player spricht es mit Abwarten (`herunterfahren(..., "tschuess")`).
- **Annahme:** Läuft keine Musik, gibt es bei 2 s keine Rückmeldung; erst das Loslassen zeigt es. Falls gewünscht: leiser Ton bei 2 s.
- Geprüft ohne Hardware: `test_bedienung.py` angepasst (kein „Tschüss“ beim Halten, „Tschüss“ beim Loslassen, 10 s nur „ganz aus“), alle 22 Testdateien grün. Am Pi nicht gesehen.

## Nachtrag 11.11.2026 – Auto-Aus nach Kaltstart

- Beobachtung: Box nach dem Einschalten (war länger aus) gebootet, Karte spielte kurz, dann stumm und nicht zurück; die Box war von selbst im Sparzustand (Log: „Auto-Aus: seit 60 Minuten nichts gespielt“).
- Vermutete Ursache: Der Pi hat keine Echtzeituhr. Nach dem Kaltstart springt die Wanduhr beim Zeitabgleich um die Ausschaltdauer vor; die Auto-Aus-Frist lief auf `time.time()` und war damit sofort „abgelaufen“. Noch nicht am Gerät bestätigt (Journal-Zeilen zu „clock/Synchronized“ vor dem Auto-Aus prüfen).
- Änderung: `Automatik` misst die Auto-Aus-Frist auf einer eigenen Dauer-Uhr (`dauer`, im Player `time.monotonic`). Neuer Test `test_uhrsprung_nach_dem_kaltstart_loest_kein_auto_aus_aus`.
- Offen: Schlummer-Timer und Ruhezeit nutzen weiter die Wanduhr (Timer-Ende steht als Wanduhrzeit in einer Datei) und sollten nach einem Zeitsprung geprüft werden. Zusätzlich: Auto-Aus greift auch, wenn eine Karte liegt und die Wiedergabe gestört ist; die Reparaturleiter in `steuerung.py` hat in der Zeit nichts gerettet (Ursache über das Journal vor 18:57 klären).

## Nachtrag 11.11.2026 (2) – Kartenbox für 30 Karten (neuer Ordner `kartenbox/`)
- **Auftrag (Jan):** Box für bis zu 30 Karten im Kinderzimmer, hochwertige organische Anmutung, klappbarer Deckel mit Schutz gegen Selbstöffnen, Bandösen seitlich, beiges Inlay, Außenhaut Fuzzy, STL und 3D-CAD, PETG auf dem Centauri Carbon 2.
- **Stand:** Modell, Prüfskript (`check.py`), STL (Druckausrichtung), STEP, GLB, 3D-Ansicht, Probedruck-Teile K1 (Scharnier) und K2 (Rastung). Alles in `kartenbox/`, Beschreibung in `kartenbox/README.md`, Ergebnisse in `kartenbox/out/PRUEFBERICHT.md`.
- **Maße:** Karte 70 × 112 × 4 mm mit Eckenradius 5 mm (aus `v4/out/10_karte_orange.stl` gemessen). 3 Fächer à 10 Karten, Basis 158 × 84 × 103 mm, Deckel kopfüber druckbar, Bauraum 256³ geprüft.
- **Geprüft (ohne Druck):** wasserdichte Netze; keine Kollision zwischen Basis, Deckel, Inlay und 30 Karten (Randfach: Karten dürfen 7 mm von der Außenwand weg stehen, sonst stoßen die Kartenecken an die Gehäuserundung); Deckelschwenk 0–125° um die Scharnierachse frei, auch bei maximal 3,7° geneigten Karten (Rest 0,8 mm³); Wandstärken; Federdehnung der Rastzunge 0,5 %.
- **Entscheidungen:** Kartenüberstand 14 mm (Obergrenze der Schwenkrechnung); Deckel ohne harten Stopp, Reibung der Bohrung; Verschluss als Schnapphaken in der Deckelvorderwand; Sitzleiste 1,2 mm vor der Innenwand (Abstand zu den Karten).
- **Offen / nicht gesehen:** Nichts davon ist gedruckt. Probedrucke K1/K2 vor dem Hauptdruck. Stahlstift Ø 3 × 90: Produkt nicht geprüft (kein Link). Bandbreite offen. Fuzzy-Modifier nur ein Entwurf. Dichte und Elastizitätsmodul von PETG sind Annahmen.

## Nachtrag 12.11.2026 – Kein Ton nach Neustart (Spotify 502 an der gemerkten Stelle)

- **Befund Jan (06:15, Screenshots):** Nach einem Neustart am Morgen keine Musik. Protokoll: „Spiele ab gemerkter Stelle (1:20 in spotify:track:0C95…): spotify:playlist:6ax5… (Spotify 502)“, danach „Musik startet nicht (Spotify 502), neuer Versuch in 60 s“ – die Leiter war schon bei Versuch 5, jeder Versuch mit **derselben** gemerkten Stelle. Keine Störung von Spotify für den Tag gefunden.
- **Schwachstelle:** Eine nicht anspielbare Stelle wurde nur bei 400/403/404 verworfen. Antwortet Spotify beim Start mit Stelle 5xx, blieb die Stelle bei jedem Versuch drin – auch nach Raspotify-Neustarts. Ob die Stelle hier die Ursache war oder das Gerät nach dem Start nicht erreichbar war, ist **nicht belegt**.
- **Änderung `steuerung.py`:** Ab dem **zweiten** 5xx mit Stelle startet der nächste Versuch **von vorn** (Meldung „Start an der gemerkten Stelle scheitert wiederholt … – nächster Versuch von vorn“). Scheitert auch das, geht die Leiter normal weiter (Raspotify-Neustart). Läuft die Karte wieder, gilt die neu gemerkte Stelle beim nächsten Mal wieder (`ohne_stelle` wird bei Erfolg geleert; vorher blieb die Karte bis zum Player-Neustart ohne Stelle). Zeit bis Musik in der Simulation ca. 7 s statt nie.
- **Tests:** 2 neue (`test_stelle_502_dann_von_vorn`, `test_502_auch_ohne_stelle_fuehrt_zum_neustart`), alle 500 grün.
- **Am Pi:** Eltern-Seite → System → „Jetzt aktualisieren“. Sofortlösung ohne Update: Play-Feld 2 s halten (Karte von vorn).
- **Offen:** Startet es von vorn sofort, war die Stelle schuld (Titel evtl. aus der Playlist entfernt). Kommt auch von vorn 502, Raspotify-Protokoll beim Start ansehen (Diagnose).
- **Nachtrag 06:40 (Befund mit Screenshots):** Auch „von vorn“ (Play-Feld 2 s) kam 502 → die gemerkte Stelle war **nicht** die Ursache. Abhilfe war, die Box einmal in der Spotify-App auszuwählen: librespot meldete „Wasn't able to reply to dealer request: channel closed“, trennte, verband neu, danach 204. Vermutung: tote Dauerverbindung (dealer) nach dem Start, librespot merkt es nicht. librespot-PID blieb 06:24–06:26 gleich → in diesem Lauf kein Raspotify-Neustart (Sperre der wachsenden Abstände). Danach war die Box „weg“ (WLAN nicht erreichbar); Verdacht Auto-Aus → Sparzustand (Auto-Aus fragt die Web-API, die bei 502/stummer API „spielt nicht“ meldet). Jan hat „Automatisch in den Sparzustand“ ausgeschaltet. **Offen:** Auto-Aus-Zeile im Protokoll bestätigen; dann Auto-Aus auf lokalen Tonfluss stützen und nicht auslösen, solange eine Karte liegt und die Steuerung repariert; Erkennung „502 trotz Gerät in der Liste“ mit Hinweis „in der Spotify-App einmal Peppa Box wählen“.
- **Eltern-Seite:** „Letzte Meldungen“ und „Diagnose“ zeigen jetzt auch den Dienst `peppa-standby` (Sparzustand, Ganz-aus nach x Std).
- **Eltern-Seite → Entwickler → System:** Knöpfe **„Meldungen kopieren“** und **„Diagnose kopieren“** (Wunsch Jan: Protokoll ohne SSH und ohne Screenshots in den Chat). Im Heimnetz (http) gibt es kein `navigator.clipboard`, darum Rückfall über ein unsichtbares Textfeld (`execCommand('copy')`). Browser-Test für beide Wege.
- **Nachtrag 06:50 (Diagnose kopiert, ganzes Protokoll 06:09–06:45):**
  - **Box „weg“ war nicht Auto-Aus:** Jedes Mal „Ein-Taste 2 s gehalten → Sparzustand“ (06:16:04, 06:21:56, 06:32:56), einmal „10 s gehalten → ganz aus“ (06:18:13). Ob das jemand war oder die Taste falsch auslöst (SCL), ist **offen** (Jan fragen; 06:09:46 „Ein-Taste ist beim Start gedrückt“). Annahme Auto-Aus damit widerlegt.
  - **Raspotify-Neustarts helfen bei 502 nicht:** 6 Ton-Neustarts (06:09:55 … 06:23:15), danach jedes Mal wieder 502 („Try another access point…“). Erst das Auswählen in der Spotify-App (= Wiedergabe auf die Box übertragen) half; danach gingen auch librespot-Abbrüche (06:31, 06:40, 06:42 „Spirc shut down unexpectedly“) ohne 502 vorbei.
  - **Änderung `spotify.abspielen`:** bei **5xx** wie bisher bei 404 erst `PUT /me/player` (übertragen, ohne Spielen), 1 s warten, dann noch einmal abspielen. Vermutung: Ohne aktives Gerät im Konto erreicht Spotify die Box nicht. Neuer Test `test_spotify_start.py`. Meldung bei 5xx mit Tipp „in der Spotify-App einmal das Gerät ‚Peppa Box‘ auswählen“.
  - Offen: Bestätigung am nächsten Morgen (Box über Nacht aus/Sparzustand, Karte auflegen).
- **Nachtrag 06:55 – Sparzustand ohne Tastendruck:** Jan: einmal ganz aus (10 s, 06:18), zwei- bis dreimal selbst Sparzustand; einmal **beim Spielen von allein**. Das passt zu **06:32:56** (Musik lief, „Ein-Taste 2 s gehalten“, Pause, Sparzustand). Die Box hat also SCL ≥ 2 s tief gesehen, ohne Druck. Möglich: Taste/Kabel im Deckel (Kontakt, Druck auf den Deckel, Kabel an Masse) oder ein I2C-Baustein hält den Takt. Während SCL tief ist, ruht I2C im Player, ein hängender Bus fiele also nicht auf.
- **Neu in `bedienung.py`:** Nach dem Loslassen, wenn SCL ≥ 2 s tief war: Protokollzeile „Ein-Taste: SCL war x s tief (SDA dabei hoch/tief)“. Echter Tastendruck: SDA hoch. Test in `test_bedienung.py`.
- **Offen:** Beim nächsten Mal diese Zeile ansehen. Prüfen am Gerät: Sitzt die Taste im Tasterhalter unter Vorspannung (Deckel drückt mit)? Kabel zur Taste eingeklemmt? Bis zur Klärung als Notlösung denkbar: Sparzustand per Ein-Taste nur mit Ansage + erneutem kurzen Druck, oder 3 s statt 2 s.
- **Nachtrag 07:00 – Muster „nach der Nacht“ (Beobachtung Jan, 11.11. und 12.11.):** Fehler jeweils beim ersten Start nach einer Nacht ganz aus. Zwei Erklärungen, beide nur am Morgen wirksam: (1) keine Echtzeituhr, die Uhr springt nach dem Zeitabgleich um die Nacht vor (11.11.: Auto-Aus, behoben; Schlummer-Timer/Ruhezeit noch offen). (2) Spotify führt „Peppa Box“ über Nacht als zuletzt aktives Gerät mit einer toten Verbindung; librespot kommt mit derselben Geräte-ID wieder, Befehle laufen ins Leere (502), auch nach Raspotify-Neustarts; erst Übertragen (App) bindet neu. Darauf zielt die Änderung in `spotify.abspielen` (5xx → übertragen → neu abspielen). **Prüfung:** Box über Nacht ganz aus, morgens Karte auflegen, danach Diagnose kopieren (Erwartung: höchstens kurz 502, dann 204, ohne App).

## Nachtrag 12.11.2026 (2) – Software-Audit, Paket A „Musik zuverlässig“ (Branch `audit/paket-a-musik-zuverlaessig`)

- **Anlass:** Audit der gesamten Software mit Freigabepflicht (Jan, 12.11.). Bericht mit 24 Befunden: https://claude.ai/artifact/BXn5gLzJSSxjz36yicz8ey. Freigegeben wurde Paket A (Befunde 1, 3, 4, 5, 6, 8, 9, 10, 11). Entscheidungen Jan: Musik höchstens zweimal zurückholen, auch nach Pause über die Spotify-App; Ruhezeit wird derzeit nicht benutzt (wenn, dann „keine Musik“); Repository bleibt öffentlich, keine PIN.
- **Stand:** Umgesetzt auf einem eigenen Branch, `main` ist unverändert. **Noch nicht auf der Box und nicht am Gerät geprüft.** Erst nach Jans Freigabe nach `main` übernehmen, dann Update über die Eltern-Seite (kein `dienst_einrichten.sh` nötig, die installierten Kopien sind unverändert).
- **Befund 1, Wächter für die laufende Wiedergabe (`steuerung.py`):** Liegt die Karte, soll gespielt werden und meldet die Tonausgabe 12 s keinen Ton, wird die Karte an der gemerkten Stelle neu gestartet (höchstens 2 mal; zählt neu nach 5 min Musik oder nach jeder Bedienung). Danach Hinweis auf der Eltern-Seite, ein Tipp auf Play startet wieder. Kein Eingriff bei gewollter Pause, Schlummer-Timer, Ruhezeit und zu Ende gehörter Karte. Ohne Meldung der Tonausgabe (alte Einrichtung, Empfang gestört) unternimmt er nichts. Nach einem Raspotify-Neustart im Leerlauf wird eine liegende Karte wieder angespielt.
- **Befund 3, Schlummer-Timer (`automatik.py`):** Am Ende wird immer pausiert, wenn Musik laufen könnte, und am Tonfluss geprüft; fehlt die Gerätekennung, sucht die Box sie und versucht es weiter (60 s). Wirkt die Pause nicht, beendet ein Ton-Neustart die Musik.
- **Befund 4, Auto-Aus:** Als Aktivität zählt auch der Tonfluss; eine Karte, die auf Musik wartet, hält die Box bis zu 10 min wach.
- **Befund 5, Karte „leer“ (`peppa_player.py`):** Ist der Link nicht lesbar, wird 3 s lang weiter versucht, erst dann die Ansage.
- **Befund 6, Lesefehler:** bis zu 3 Leseversuche je Abfrage, „Karte weg“ erst nach 3 s (vorher 1,5 s). **Nebenwirkung: Die Musik stoppt nach dem Herausnehmen ca. 1,5 s später.**
- **Befund 8, Karte weg und Musik läuft weiter:** Ein gesendeter Start wird immer verbucht (die Pause folgt sicher). Kommt die Pause bei Spotify nicht an, schaltet die Box den Ton selbst stumm (`ausgang.zwangsstumm`: Verstärker bzw. Kopfhörer-Lautstärke), bis die Pause bestätigt ist oder wieder gespielt werden soll; ein Player-Neustart hebt es immer auf.
- **Befund 9:** Ohne Netz höchstens 15 s bis zum nächsten Versuch (vorher bis 5 min).
- **Befund 10:** Nach „Weiter“ wird geprüft, ob die Playlist der Karte läuft; sonst frischer Start an der gemerkten Stelle.
- **Befund 11 (`spotify.py`):** Fehlerantworten auf die Geräteliste gelten nicht mehr als „Gerät fehlt“ (kein Ton-Neustart, Wartezeit bei 429 wird eingehalten); bei 401 wird der Zugang einmal erneuert und die Anfrage wiederholt.
- **Tests:** neu `software/test_audit_a.py` (33 Tests, je Befund mindestens einer, der den Fehler nachstellt). Fünf vorhandene Tests in `test_player.py` an die neuen Zeiten angepasst (3 s bis „Karte weg“, 3 s Geduld beim Link). Gesamt 540 grün, 1 übersprungen (`aplay` fehlt in der Arbeitsumgebung).
- **Am Gerät zu prüfen (nach dem Update):** Karte auflegen und spielen; WLAN am Router 1 min aus und wieder an (Musik kommt von selbst wieder); in der Spotify-App auf der Box pausieren (Box holt die Musik nach ca. 15 s zurück, höchstens zweimal); Karte herausnehmen (Pause nach ca. 3–4 s); Schlummer-Timer auf 15 min bis zum Ende; Rauschen an den Kopfhörern anhören. Danach „Diagnose kopieren“.
- **Offen aus dem Audit (nicht freigegeben):** Paket B (Befunde 2, 7, 12, 13, 24) und Paket C (14 bis 23), siehe Bericht.

## Nachtrag 13.11.2026 – Kartenbox v2 (ersetzt den Entwurf vom 11.11.)
- **Warum neu:** Der erste Entwurf (11.11., jetzt `kartenbox/v1_entwurf/`) war kantig, und die Karten standen seitlich (Cover von vorn nicht sichtbar).
- **Form:** 3 Fächer à 10 Karten nebeneinander, Cover nach vorn, Karten lehnen 15° an einer schrägen Stütze im beigen Inlay. Box 240 × 103 × 122 mm (mit Ösen 264 breit, mit Scharnier 113 tief), Teilung auf 78 mm. Weiche Rundungen (unten R 12, oben R 16, Grundriss R 15), Seiten leicht nach außen gewölbt, V-Fuge, außen Fuzzy über Modifier. Inlay-Rand ragt 5 mm in den Deckel (Führung).
- **Mechanik:** bündige Federzunge vorn mit Haken (ca. 4 N zum Öffnen, hält ca. 19 N), 2 Scharniere mit gedruckten Stiften Ø 4 (klemmen im inneren Knöchel), Anschlag ca. 96° (Deckel bleibt offen). Bandösen links/rechts, Loch Ø 5,2 für Kordel bis 4 mm.
- **Geprüft (ohne Druck):** `kartenbox/check.py` – keine Kollision Basis/Deckel/Inlay/30 Karten (auch seitlich verschoben), Deckelschwenk 0–96° frei, Inlay und Stifte lassen sich einbauen, Wände ≥ 2,35 mm, Überhänge nur Haltefläche Haken/Nut und Inlay-Brücken; `kartenbox/gegenpruefung.py` schneidet die fertigen STL schichtweise (0,2 mm) und bestätigt das. Alle Teile passen auf den Centauri Carbon 2 (256³; Basis diagonal).
- **Dateien:** `kartenbox/out/druck/` (STL in Druckausrichtung + Fuzzy-Modifier), `probedruck/K1–K3`, `kartenbox_zusammenbau.3mf`, `kartenbox.glb`, 3D-Ansicht: https://claude.ai/artifact/WTa61kKxXdJGcr8ntStH1H . Druckeinstellungen in `kartenbox/README.md`.
- **Offen:** Probedrucke K3 (Passung, Fuzzy), K1 (Stift Ø 3,9/4,0/4,1, Anschlag), K2 (Rastung) vor dem Hauptdruck. Kräfte gerechnet mit PETG E = 1800 MPa, Reibung 0,3 (Annahmen). Leere Box mit offenem Deckel kippt schon bei ca. 13° nach hinten (mit Karten 28°). Material ca. 0,55 kg PETG (0,37 orange, 0,19 beige); Sparhinweise im README.

## Nachtrag 13.11.2026 (2) – Eltern-Seite: WLAN anlegen (Branch `eltern-seite-wlan`)

- **Wunsch Jan:** In der Eltern-App WLAN mit Name und Passwort anlegen (Baustein 1 aus dem Konzept vom 02.11.; bisher ging das nur per SSH mit `wlan_hinzufuegen.sh`).
- **Neue Seite „WLAN“** im Bereich Alltag (5. Eintrag in der Leiste): Liste der gespeicherten WLANs (Heim-WLAN, zusätzliche; Punkt grün = verbunden), Formular Name + Passwort (Passwort anzeigen per Schalter, Mobiltastatur ohne Autokorrektur/Großschreibung), je zusätzlichem WLAN „Entfernen“ mit Rückfrage. Das Heim-WLAN lässt sich weder ändern noch entfernen, das gerade verbundene WLAN nicht entfernen (die Seite säße sonst auf dem Ast, den sie absägt). Hilfe: neue Frage „Wie verbinde ich die Box unterwegs mit dem Handy?“.
- **Technik:** `peppa_web.py`: `GET /api/wlan`, `POST /api/wlan/hinzufuegen`, `POST /api/wlan/entfernen`. Schreibt nichts selbst, ruft per sudo die root-eigene Kopie `/usr/local/lib/peppa-box/wlan` von `wlan_hinzufuegen.sh` (Priorität 5, wie bisher). **Name und Passwort gehen nur über die Standardeingabe**, nie als Argument (sonst in der Prozessliste). Passwörter werden nie angezeigt, nie ausgeliefert, nie protokolliert. Gleicher Name = aktualisiert (Kennung bleibt). Prüfung in Seite und Skript: Name 1–32 Bytes, ohne Steuerzeichen und ohne Leerzeichen am Rand, Passwort 8–63 Zeichen (kein offenes WLAN).
- Skript: neu `--roh` (Liste mit Tab), als root kein sudo nötig. `dienst_einrichten.sh` installiert die Kopie und nimmt sie in `/etc/sudoers.d/peppa-box` auf (genau dieser Befehl). `wlan_hinzufuegen.sh` steht jetzt in `EINRICHTUNG` (Seite weist nach einem Update auf `dienst_einrichten.sh` hin). Ohne die Einrichtung zeigt die Seite einen Hinweis, nichts bricht.
- **Die Box wechselt das WLAN nicht von selbst**, nur weil eines hinzukommt: Heim-WLAN (10) gewinnt vor Hotspots (5), eine bestehende Verbindung bleibt. Der Eintrag selbst kappt also nie die laufende Verbindung zur Seite.
- **Sicherheit (ehrlich):** Die Seite ist ohne Passwort und nur `http`. Das WLAN-Passwort geht im Heimnetz unverschlüsselt zur Box. Hinweis steht auf der Seite. Mit Tailscale/HTTPS (offen, siehe 26.10.) wäre das erledigt.
- **Tests:** 553 grün (neu: 8 in `test_web.py`, 2 in `test_wlan.py`, 3 im Browser-Test, Navigation jetzt 5 Einträge). Drei absichtlich eingebaute Fehler (Passwort als Argument, aktives WLAN nicht geschützt, Passwort im Protokoll) werden erkannt; ebenso der Fehler „Formular überschreibt neue Eingabe“. Optik auf Handy- und Desktopbreite angesehen.
- **Am Pi:** Branch holen (`cd ~/peppa-box && git fetch && git checkout eltern-seite-wlan`, oder nach Übernahme in `main` per Update-Knopf), dann **einmal** `sh software/dienst_einrichten.sh`. Danach Seite → WLAN → Hotspot eintragen → `journalctl -u peppa-web -n 20`. **Noch nicht am Gerät geprüft:** sudo-Freigabe, `nmcli`-Name des aktiven WLANs (`aktive_ssid()`), Dauer der Antwort (die Sichtprüfung „sieht die Box das WLAN?“ macht eine Suche, einige Sekunden).
- **Hinweis zum Stand:** `main` enthält seit `e8504ba` (Kartenbox) bereits den Audit-Stand „Paket A“ (`c5672ab`); der Nachtrag vom 12.11. („`main` unverändert“) stimmt damit nicht mehr. Dieser Branch ändert daran nichts.
