janshort4all/peppa-box/v4/out/PARAMETER.md

# Parameter Musikbox v4 (Stand 09.11.2026)

Jeder Wert steht in `model.py` ganz oben. Ändert sich ein Wert, rechnet das Modell alles neu: Löcher, Halter, Kollisionsprüfung.

## Vorläufig – am echten Teil messen (15)

| Name | Wert (mm) | Bedeutung |
| --- | --- | --- |
| `FAB_T` | 0,6 | Stoffdicke, Stoff noch nicht gekauft |
| `SPK_FRAME_R` | 21 | Eckradius Korb, aus 93 mm Diagonale abgeleitet |
| `SPK_PITCH` | 58,5 | Lochabstand (Zeichnungswert ohne Beschriftung) |
| `NFC_T` | 0,4 | NFC-Aufkleber Dicke |
| `RC_T` | 1,6 | RC522 Platinendicke |
| `RC_BEND` | 8 | Platz für den Kabelbogen hinter den Buchsen |
| `RC_HDR_OFF` | 0 | Mitte der Stiftleiste gegenüber Platinenmitte, + = vom Deckel weg (nicht gemessen, mittig angenommen) |
| `JK_HOLE` | 6,2 | Loch für Klinkengewinde (Gewinde unbekannt) |
| `PAT_END` | 3,5 | Lochmitte bis Pi-Ende des Stapels (Pi-Norm); ±3 mm deckt der Freiraum ab |
| `UPS_LEVEL` | 35 | Acrylplatte bis Oberkante Akku-Board (Zellen + Board) |
| `CLAMP_Z` | 52 | Unterkante der Klemmblöcke über der Acrylplatte |
| `AUDIO_PLUG` | 20 | Platz hinter der Klinke des Pi: Klinkenstecker 90° gewinkelt (Goobay 67782) |
| `MAXB` | 19 / 18 / 8 | Verstärker-Klon L, B, Höhe mit Klemme |
| `NH_KABEL` | 2 | Luft über den Steckern für das direkt über dem Stecker zur Seite geknickte Kabel; das Dach drückt über den Knick auf den Stecker. Nachmessen: Platine bis Oberkante geknicktes Kabel, minus ca. 0,3 Vorspannung |
| `NH_PCB_Z` | 54 | Acrylplatte bis Oberseite blaue Platine des Aufsatzes, nur für die Prüfung. Aus Stiftspitzen (60) und Steckerhöhe (12) eingegrenzt auf ca. 49–54; oberer Wert = ungünstigster Fall nach oben |

## Mit Probedruck einstellen (17)

| Name | Wert (mm) | Bedeutung |
| --- | --- | --- |
| `LIP_CLR` | 0,2 | Spiel Zentrierkragen zur Innenwand je Seite (Coupon C8) |
| `GAP_LID` | 0,4 | Spalt Deckel–Wand je Seite |
| `CLR` | 0,3 | Spiel für Passungen |
| `PILOT` | 2,5 | Kernloch für 3-mm-Kunststoffschraube in PETG |
| `PILOT25` | 2,1 | Kernloch M2,5 (Akku-Board) |
| `PIN_HOLE` | 4,1 | Loch für Rahmenstift (Coupon C4: 4,0 / 4,1 / 4,2) |
| `PAD_POCKET` | 2 | Tasche unter dem Feld → 4 mm Kunststoff über dem Kupfer, unter den Symbolen 3,2 mm |
| `RAST_ALPHA` | 30 | Rille: Auszugsflanke in Grad (C15: 20 / 30 / 40); steiler = fester |
| `INS_GAP` | 0,6 | Tasche: Spalt an der Außenwand (Einleger laminiert ca. 0,25–0,35 mm) |
| `BTN_GAP` | 0,25 | Luft je Seite zwischen Kappe und Deckelbohrung (Druck 02.11.: passt) |
| `ENC_HOLE` | 7,4 | Loch für M7-Gewinde |
| `KNOB_BORE` | 6,1 | Bohrung für die Schlitzachse Ø 6 (gedruckt meist 0,1–0,2 kleiner → Klemmsitz), nur im geschlitzten Teil der Achse (federt dort) |
| `KNOB_GUIDE` | 6,3 | Bohrung im ungeschlitzten Teil der Achse (federt nicht): nur Führung, damit der lange Knopf nicht auf ganzer Länge klemmt |
| `GR_PEG` | 2 / 1 / 0,2 | Stifte hinten an den Buchstaben: Ø (bei schmalen Teilen kleiner), Länge, Spiel je Seite im Sackloch des Gitters (Loch 0,3 tiefer). Mit C14 prüfen |
| `GR_FORM_SPIEL` | 0,1 | Spiel je Seite für die geformten Stifte der drei Strahlen über dem a (Stift = Strahl 0,7 kleiner, unverändert). Mit 0,2 wie bei den runden Stiften saßen die Strahlen spürbar locker (Druck Jan 07.11.), runde Stifte passten gut |
| `GR_PIN_D` | 3,9 | Stift Ø (Loch im Korpus PIN_HOLE 4,1; mit C14 am Korpus prüfen) |
| `ECK_WULST` | 0,5 | Rastwulst (Sägezahn) unter der Fuge Boden/Korpus: untere Flanke 45° parallel zur Fase der Boden-Oberkante (0,14 Luft), Oberseite waagerecht 0,1 unter der Korpus-Unterkante (z 3,9), so tief. Passt in beide Fugenformen am gedruckten Korpus: V-Fuge an Seiten, Rückseite und den hinteren Teilen der Rundungen; vorne (x 9–131) hat der Korpus keine Fase, dort ist es eine Stufe (Fase nur am Boden, Korpus-Unterkante waagerecht). Coupon C16: 0,4 / 0,5 / 0,6 |

## Von dir gemessen (23)

| Name | Wert (mm) | Bedeutung |
| --- | --- | --- |
| `RC_L` | 60 | RC522 Platine Länge |
| `RC_B` | 40 | RC522 Platine Breite |
| `RC_ANT` | 20 | Antennenmitte ab Platinenende (Antennenseite; 40 mm bis Lötlochende) |
| `RC_COMP` | 5 | Bauteilhöhe auf der Rückseite (Quarz, höchstes Bauteil) |
| `RC_PIN_OUT` | 6 | Überstand der 90°-Stifte über die Platinenkante |
| `RC_PLUG_OUT` | 14 | Platinenkante bis Ende Steckkabel-Hülse (gesteckt, Buchse sitzt bis an die Leiste) |
| `SW_LEGS` | 13 | Breite über die Beinchen (Außenkante zu Außenkante), Jan ca. 13 mm; Taster 12 mm, Beinchen stehen seitlich über |
| `ENC_OUT` | 21,8 | Achse ragt so weit über die Wand-Außenfläche. Achse wird NICHT gekürzt (Jan 05.11.). Gemessen am finalen Korpus: Achsende bis Mutterauflage (glatte Fläche, 0,4 unter der Wand) 22,2 → 21,8 über der Wand (Modell vorher 22,0) |
| `ENC_LUG` | 2,5 / 2 / 1,5 | Nase am Drehgeber (Jan 03.11.): Gewinde-Außenkante bis Nase 2,5, Nase 2,0 breit, steht 1,5 vor. Einbau: Nase nach oben (zum Deckel) |
| `ENC_SLOT_D` | 11,3 | Schlitztiefe ab Achsende (Jan 05.11.: 11,3; Achse wird nicht gekürzt) |
| `ENC_SLOT` | 1,6 | Schlitzbreite Achse (Jan 03.11.: ca. 1,6, Schlitz 11 tief, Achse Ø 6) |
| `JK_WALL` | 2 | Wand unter der Klinkenmutter (wie Prototyp, passt laut Jan; Gewinde ist knapp) |
| `STRAP_HOLE` | 7,9 | Buchschraube: Schaft Ø 7,5 (Jan 03.11.) + 0,4 Spiel; Kopf liegt auf dem Riemen (Riemen ca. 3 mm dick) |
| `CSK` | 6,2 / 3,4 | Senkung für Senkkopf 3,0 × 12 (Kopf Ø 6 gemessen + 0,2; Ø Loch) |
| `ACRYL` | 85 / 55 | Acrylplatte unter dem Stapel (von dir gemessen) |
| `STACK_H` | 70 | Acrylplatte bis Oberkante graue Klemmen, ohne Kabel |
| `PINS_H` | 60 | Acrylplatte bis Spitzen der gelben Stifte |
| `STACK_PAT` | 58 / 49 | Lochbild der Bolzen unter der Acrylplatte |
| `SCREW_L` | 12 | Einzige vorhandene Schrauben: 3,0 × 12, Senk- und Flachkopf (Jan 03.11.). Alle Dome und Kernlöcher darauf ausgelegt |
| `JK_NUT` | 8 | Mutter der Klinkenbuchse Ø (Jan 03.11.) |
| `MPRB` | 34 / 20 / 5 | MPR121-Modul L, B, Höhe: Adafruit 1982 STEMMA-QT-Ausführung, L × B gemessen 03.11.; Höhe 5 mm festgelegt (inkl. Buchsen und Lötstellen) |
| `NH_LOCH` | 58 | Abstand der beiden freien Löcher an der gelben Stiftleiste (Jan 07.11.; = HAT-Norm, gleiche Lage wie STACK_PAT) |
| `NH_STECKER` | 12 | Oberseite blaue Platine bis Oberkante Steckkabel-Gehäuse, ohne Kabel (Jan 05.11.) |

## Aus Datenblatt belegt (15)

| Name | Wert (mm) | Bedeutung |
| --- | --- | --- |
| `SPK_CUT` | 73 | Einbauausschnitt Visaton FRS 8 |
| `SPK_FRAME` | 78 | Außenmaß Korb (Kante) |
| `SPK_FLANGE` | 4,5 | Frontflansch |
| `SPK_DEPTH` | 40 | Gesamttiefe |
| `SPK_MAG` | 60 | Magnet-Ø |
| `NFC_D` | 25 | NFC-Aufkleber Ø |
| `SW` | 12 | Kurzhubtaster 12 × 12 |
| `SW_H` | 7,3 | Tasterhöhe gesamt, Gehäuseunterseite bis Stößeloberkante (Etikett BerryBase KHT1212PV73: H 7,30; nachmessen) |
| `ENC_THREAD` | 7 | Gewindelänge ab Gehäusefläche (Datenblatt STEC11B, M7 × 0,75) |
| `ENC_PUSH` | 0,5 | Hub des Drucktasters in der Achse (Datenblatt) |
| `UPS` | 85 / 56 | Akku-Board Grundriss |
| `OVERHANG` | 20 | Akku-Board steht so weit über den Pi hinaus (85 − 65), BOOT-Taste dort |
| `USBC_LEGS` | 4,31 / 2,5 / 6,7 / 1,5 | Lötfahnen der Buchse unter der Platine (KiCad): seitlich ±4,31, 2,5 und 6,7 von der Platinenkante; Aussparung 1,5 tief im Dom |
| `WAGO5` | 30 / 18,6 / 8,4 | WAGO 221-425 B, T, H |
| `WAGO3` | 18,6 / 18,6 / 8,4 | WAGO 221-423 B, T, H |

## Gestaltung festgelegt (131)

| Name | Wert (mm) | Bedeutung |
| --- | --- | --- |
| `W` | 140 | Außenmaß Breite = Tiefe |
| `HB` | 140 | Höhe Korpus. Echter Würfel; 124 mm reichen für Akku-Stapel + Kartenfach nicht |
| `R` | 16 | Eckradius außen |
| `WALL` | 3 | Wandstärke (7 Linien à 0,42) |
| `BASE_T` | 4 | Bodenplatte, abnehmbar, trägt die Elektronik; Korpus steht darauf |
| `CH_FLOOR` | 2,4 | eigener Boden der Lautsprecherkammer im Korpus (Kammer bleibt dicht) |
| `SHADOW` | 0 | Bodenplatte außen exakt so groß wie der Korpus (bündig) |
| `EDGE_V` | 0,8 | Fase 45° an Korpus-Unterkante und Boden-Oberkante: bilden zusammen eine V-Fuge, kaschiert kleinen Versatz |
| `BASE_CHAMF` | 0,8 | Fase an der Boden-Unterkante (Standkante, gegen Elefantenfuß) |
| `CHAMF` | 0,5 | Fase Unterkante gegen Elefantenfuß (D2) |
| `LID_T` | 6 | Deckelstärke (Schrauben von unten brauchen Fleisch) |
| `LID_SINK` | 1,2 | Deckel liegt so tief unter der Kante |
| `LEDGE` | 2,5 | Auflage-Schräge 45° innen |
| `SKIN` | 0,8 | beige Deckschicht über orangem Kern (D1); 0,8 = 4 Schichten à 0,2 bzw. 5 à 0,16 (vorher 0,7, lag zwischen zwei Schichten) |
| `SYM_INLAY` | 0 | Symbole und Ringe bündig in Orange eingelegt (CANVAS druckt in den 4 Haut-Schichten beide Farben), statt 0,8 mm vertieft. Grund (Druck 05.11.): Kopfüber werden die Vertiefungen in Schicht 5 überbrückt; der Slicer dehnt die Brücke auf den ganzen Kreis aus (1760 mm² Brücke für 597 mm² Vertiefung) – die runden orangen Brückenfäden scheinen durch die 0,8 mm beige Haut, Böden sehen wie Fäden aus, um jedes Loch 3 Wände, Fäden und Nahtpunkte an den Lochkanten. Eingelegt liegt die ganze Oberseite auf der Platte, ohne Loch und ohne Brücke. Nicht mehr ertastbar → von Jan am 05.11. abgelehnt (Tasten müssen ertastbar bleiben). 0 = Vertiefung (gilt) |
| `HOLE3` | 3,4 | Durchgangsloch 3-mm-Schraube |
| `BOSS_D` | 9 | Dom-Ø, groß genug für spätere M3-Einsätze |
| `SEAT` | 12 / 128 / 12 / 128 | Stoffrahmen-Vertiefung x0,x1,z0,z1 |
| `SEAT_D` | 3,8 | Tiefe Stoffrahmen-Sitz |
| `FR_T` | 3 | Stoffrahmen-Dicke |
| `FR_BORDER` | 6 | Rahmenrand |
| `PIN_D` | 4 | Stift am Stoffrahmen |
| `SPK_X` | 70 | Lautsprecher Mitte x |
| `SPK_Z` | 70 | Lautsprecher Mitte z |
| `BAY_D` | 9,6 | Tiefe Lautsprecher-Mulde ab Front |
| `DIV_Y` | 48 | Vorderkante Trennwand Lautsprecherkammer |
| `CH_Z` | 122 | Bezugshöhe vorne oben (Zungenschlitze, Zungen am Deckelrahmen); die Kammerdecke selbst ist seit 04.11. ein Satteldach (ROOF) |
| `ROOF` | 25 / 126,5 / 1,6 / 0,04 | Kammerdecke als 45°-Satteldach (First y, First-Unterkante z am rechten Ende, Dicke senkrecht zur Fläche, Neigung des Firsts entlang x). Ersetzt die flache Decke bei z 122–125: die war eine 40-mm-Brücke, Schichten bis 5½ min statt ca. 1 min (G-Code 04.11.), dort lag die stärkste Querlinie. 45° druckt ohne Brücke. Der First steigt nach rechts um 0,04 mm/mm (5,4 mm über die Breite): First und Traufen beginnen und enden nicht in einer Schicht, sondern über ca. 27 Schichten – sonst gäbe es dort wieder einen Sprung der Schichtdauer. Abstände in check.py |
| `PADS` | zurück 30 / 30 / 22; play 70 / 30 / 30; vor 110 / 30 / 22; schlaf 70 / 64 / 18 | Touch-Felder x, y, Ø |
| `PAD_RING` | 1,1 | Breite der Ringnut um jedes Touchfeld |
| `SYM_GAP` | 1,8 | Mindestabstand Symbol ↔ Ringnut (Probedruck 27.10.: Dreiecke lagen auf der Nut) |
| `SYM_MIN` | 0,9 | kleinste Breite in Symbolen (2 Linien bei Düse 0,4); dünnere Spitzen werden abgerundet |
| `CARD_W` | 70 | Karte Breite |
| `CARD_H` | 112 | Karte Höhe (70 sichtbar + 42 im Fach) |
| `CARD_T` | 4 | Karte Dicke |
| `CARD_IN` | 42 | Einstecktiefe |
| `SLOT_Y` | 116 | Schlitzmitte auf dem Deckel |
| `TILT` | 8 | Neigung der Karte nach hinten |
| `ZUNGE_STEG` | 1,4 | Druckhilfe: Steg unter der Zungenspitze (Länge in Steckrichtung), nach dem Druck durchschneiden |
| `RAST_UEB` | 0,7 | Nase steht so weit über die Kartenvorderseite (Federweg beim Ein-/Ausziehen); vorher 0 = keine Rastung |
| `RAST_TOP` | 0,8 | Nase: flache Spitze (in Steckrichtung) |
| `RAST_EIN` | 30 | Nase: Flanke zur Öffnung (Einstecken), Grad zur Kartenfläche |
| `RAST_TIEF` | 45 | Nase: Flanke zum Fachboden, steiler als die Rille → die Rille bestimmt die Auszugskraft |
| `RILLE_T` | 0,9 | Rille: Tiefe (> RAST_UEB, Zunge liegt eingerastet entspannt → kein Kriechen) |
| `RILLE_SPIEL` | 0,3 | Rille: Spiel zwischen Nase und Auszugsflanke, wenn die Karte auf dem Fachboden steht |
| `RILLE_L` | 20 | Rille: Länge quer (Nase 16 mm, ±2 mm seitliches Spiel) |
| `KARTE_FASE` | 0,8 | Einführfase vorne an der Kartenunterkante, 30° (schiebt die Nase beim Einstecken weg) |
| `INS_LIP` | 1,5 | Lippe überdeckt den Einleger je Seite und unten; Unterseite 45°, druckbar ohne Stütze |
| `INS_WALL` | 1,2 | Außenwand neben der Tasche |
| `INS_FRONT` | 0,6 | Lippe an der Fensterkante mindestens so dick |
| `INS_Y0` | 43,5 | Taschenunterkante ab Kartenunterkante (1,5 mm über dem Deckel) |
| `INS_CLR` | 0,3 | Spiel Einleger zur Tasche je Seite |
| `CARD_TOP_R` | 1,5 | Eckradius oben (Tasche ist oben offen und muss gerade bis zur Kante laufen) |
| `GRIP_R` | 7 | Griffmulde oben Mitte in der Rückwand: Einleger von vorn und hinten greifbar |
| `RC_DROP` | 5 | RC522 so viel tiefer (weg vom Deckel) als mittig hinter dem NFC-Aufkleber; Probedruck 27.10.: Steckkabel stießen an den Schraubblock des Deckelrahmens |
| `RC_XTAL_FREE` | 18 | deckelseitige Schiene: Lippe auf so viel Länge vor dem Stiftleisten-Ende entfernt (Quarz; laut Foto ca. 12 mm lang) |
| `BTN_X` | 124,5 | Ein-Taste x (hinten rechts) |
| `BTN_Y` | 108 | Ein-Taste y |
| `BTN_D` | 12 | Tastenkopf-Ø |
| `BTN_FLUSH` | 0 | Kappe endet bündig mit der Deckeloberfläche, keine Mulde (Jan 02.11.: Mulde wirkt billig) |
| `BTN_TOP_CH` | 0,3 | Fase an der Oberkante der Kappe (nimmt die Kante, kaum sichtbar) |
| `LID_EDGE_CH` | 0,5 | Fase 45° an der Deckel-Oberkante (kopfüber: verdeckt den Elefantenfuß) |
| `SLOT_CH` | 0,6 | Einführfase am Kartenschlitz oben |
| `SW_LEG_CLR` | 0,5 | Luft je Seite im Beinchen-Kanal des Tasterhalters |
| `ENC_Y` | 84 | Drehgeber y |
| `ENC_Z` | 60 | Drehgeber z |
| `ENC_WALL` | 2,6 | Wand unter der Drehgeber-Mutter = volle Wand 3,0 minus glatte Fläche 0,4 (vorher 2,0 mit Senkung innen). Gewinde 7 mm (Datenblatt STEC11B, M7×0,75); am Prototyp bei 2 mm Wand 2 mm Gewinde über der Mutter (Jan 03.11.) → bei 3 mm Wand noch ca. 1 mm, Mutter voll im Gewinde |
| `KNOB_D` | 34 | Knopf-Ø |
| `KNOB_ROOF` | 2 | Knopf: Material vor dem Achsende |
| `NUT_REC_D` | 15 | Aussparung im Knopf für Mutter (Eckmaß ca. 11,5) und Scheibe |
| `KNOB_GAP` | 1 | Luft Knopf ↔ Wand (Fuzzy Skin ±0,25, Drucktaster 0,5 mm Hub) |
| `KNOB_TIP` | 0 | Luft Achsende ↔ Knopfboden: 0 = Knopf bis Anschlag aufschieben, Lage eindeutig (vorher 0,4, als die Achslänge noch nicht gemessen war). Ist die Achse länger (z. B. 22,2 ab Scheibe), sitzt der Knopf nur weiter außen |
| `KNOB_RIB` | 8 | Länge des Stegs im Achsschlitz (Mitnahme), Schlitz 11,3 tief |
| `JK_Y` | 84 | Klinke y |
| `JK_Z` | 24 | Klinke z |
| `STRAP_Y` | 104 | Riemenpunkt y |
| `STRAP_Z` | 118 | Riemenpunkt z |
| `BASE_BOSSES` | 8,6 / 8,6 / 131,4 / 8,6 / 7,7 / 47 / 132,3 / 47 / 8,6 / 131,4 / 131,4 / 131,4 | Bodenschrauben: 4 Ecken + 2 an der Kammerwand (vordere Dome stehen dicht in der Kammer) |
| `BOSS_H` | 14 | Höhe der Bodendome im Korpus; Kernloch 12 tief |
| `LIP` | 1,6 / 3 | Zentrierkragen der Bodenplatte im hinteren Teil (Breite, Höhe) |
| `STACK_X0` | 9 | Stapel links; Überhang mit BOOT-Taste zeigt nach links |
| `STACK_Y0` | 55,5 | Stapel vorne = Kante mit den gelben Stiften; Anschlusskante (USB-C, Schalter) zeigt nach hinten |
| `PAD_H` | 3,5 | Auflagen unter der Acrylplatte |
| `PAD_REC` | 7 / 2,4 | Mulde in jeder Auflage (Ø, Tiefe): vorhandene Schraubenköpfe oder Muttern passen hinein |
| `HOLE25` | 2,9 | Durchgang M2,5 |
| `CB25` | 6,4 / 2,2 | Senkbohrung von unten für Kopf/Mutter M2,5 (Ø, Tiefe) |
| `WIRE_CLR` | 15 | Platz für die Kabel an jeder Klemmreihe |
| `STACK_CLR` | 3 | Luft rings um den Stapel |
| `USB_PLUG` | 20 | Platz hinter der Anschlusskante: Stecker am Akku-Board gewinkelt oder höchstens 20 mm lang |
| `USBC_CH` | 0,6 | Fase außen an der USB-C-Öffnung |
| `SPK_DOME_L` | 10 | Lautsprecher-Dome hinter der Frontplatte (vorher 7): Schraube 3,0 × 12 durch den Korbflansch |
| `FUZZ_REC` | 0,4 | Glatte Flächen (ohne Fuzzy Skin) liegen so tief unter der Außenfläche: saubere Kante, wirkt gewollt; Muttern liegen eben |
| `FUZZ_RIM` | 0,3 | Modifier „ohne Fuzzy“ reicht so weit über die glatte Fläche hinaus (Stufe selbst bleibt glatt) |
| `FUZZ_SHELL` | 1 | Modifier „Fuzzy Außenhaut“ (04.11.): Fuzzy nur in dieser Tiefe unter der Außenfläche. Enthält die Mitte der Außenwand-Linie (0,21 mm), erreicht nie die Innenseite (Wand 2,0–3,0). Grund: Löcher durch die Wand schneiden den Wandring auf, dann zählt der Slicer die Innenseite zur Kontur (Druck 04.11.: Fuzzy innen in Bändern) |
| `FUZZ_Z` | 4,8 / 139 | Fuzzy-Außenhaut von/bis z: Fase unten (V-Fuge) und Fase oben bleiben glatt und rahmen die Fläche |
| `BACK_PANEL` | 17 / 46,5 / 123 / 69,5 / 5 | Anschlussfeld hinten x0, z0, x1, z1, Eckradius: ein glattes Feld mit USB-C und Lüftung, mittig (x 70) |
| `VENTS` | 6 / 2 / 6,4 / 50 / 66 | Lüftungsschlitze: Anzahl, Breite, Teilung, z unten, z oben; links im Anschlussfeld mit gleichem Rand wie USB-C rechts |
| `LS_SPOT` | 10 | glatte Fläche um die Deckelschrauben hinten (Ø) |
| `JK_SPOT` | 10 | glatte Fläche um die Klinke (Ø) = Mutter + 1 mm Rand |
| `ENC_SPOT` | 18 | glatte Fläche um den Drehgeber (Ø), liegt unter dem Knopf (Ø 34) |
| `SEAT_CH` | 0,6 | Fase 45° an der Kante des Gitter-Sitzes vorne (glatt, rahmt das Gitter) |
| `BRIDGE_Y` | 74 / 98 | Verteiler-Brücke am Deckelrahmen: MPR121 + Klemmen für 3,3 V, SCL, GND B |
| `LS_X` | 24 / 116 | Deckelschrauben hinten x |
| `LS_Z` | 124 | Deckelschrauben hinten z |
| `LS_BLOCK_Z0` | 119 | Unterkante der Schraubblöcke hinten am Deckelrahmen (vorher 117; 2 mm mehr Platz für die RC522-Stecker, 3,2 mm Wand unter dem Kernloch) |
| `GR_T` | 3,6 | Gitterdicke (18 Schichten); liegt hinten auf der Sitzfläche (y = SEAT_D), Vorderfläche 0,2 hinter der Korpusfront |
| `GR_HOLE` | 3,3 / 4,7 | Löcher Ø und Teilung im Wabenraster, mittig zu (70, 70). Steg 1,4 (seit 07.11., vorher Teilung 4,2 / Steg 0,9): „Vermeiden von Wandüberquerungen“ vergrößert jedes Loch um 1,5 × Linienabstand (ca. 0,6 je Seite); bei Steg 0,9 verschmolzen die Löcher, der Slicer fuhr ca. 62.000-mal quer durch Löcher (Fäden). Ab ca. 1,3 wird jedes Loch umfahren |
| `GR_RIM` | 4,5 | geschlossener Rand außen (an der Vorderfläche) |
| `GR_RIM_BACK` | 1,2 | Mindeststeg Loch ↔ schräge Oberkante hinten (Sitz fällt oben nach hinten ab) |
| `GR_LOGO` | 100 / 70 / 76 | Logo Breite, Mitte x, Mitte z (Vorlage Jan 05.11., gitter/peppa_box_logo.png) |
| `GR_LETTER_T` | 1,2 | Logo-Buchstaben als eigene orange Teile, 1,2 dick, aufgeklebt auf die glatte Gitterfläche (stehen 1,0 vor der Korpusfront; 3D-Effekt, Entscheidung Jan 06.11.) |
| `GR_KEEP` | 1,2 | geschlossener beiger Rand um das Logo bis zum ersten Loch |
| `GR_HALO` | 16 | Beiges Feld um das Logo: Logo-Kontur mit R 16 geglättet (füllt Kerben zwischen den Buchstaben, Lücke a|X, B|O, Innenformen wie das Dreieck im O), dann GR_KEEP Rand; Löcher am Feldrand mit höchstens 2 Nachbarn entfallen. Keine losen Einzellöcher im Feld (Wunsch Jan 06.11.) |
| `GR_PLENUM` | 1,2 | Luftraum: Gitter hinten über der Lautsprecher-Mulde 1,2 dünner (2,4 statt 3,6), damit der Schall hinter dem Logo zu den Löchern kommt. Lautsprecherrahmen ca. 1,3 hinter der Sitzfläche, Schraubenköpfe liegen dahinter (Jan 05.11.) → 2,5 mm Luft |
| `GR_EDGE_CH` | 0,4 | Fase 45° an der Vorderkante außen |
| `GR_PIN_L` | 2,4 | Stiftlänge hinter der Sitzfläche (Loch 2,8 tief), Spitze 0,4 gefast |
| `NH_T` | 4 | Dachstärke (Jan 07.11.: stärker, damit es sich nicht durchbiegt); Durchbiegung bei 20 N über 58 mm rechnerisch ca. 0,2 mm |
| `NH_Y` | -1,5 / 18,5 | Dach quer, ab Platinenvorderkante (Seite der gelben Leiste): 20 mm breit (Jan 07.11.), 1,5 mm über die Kante, damit vor der Schraubensenkung 2 mm Wand bleiben |
| `NH_POST` | 6 | Säule unter jedem Loch, steht auf der Platine (Jan 07.11.) |
| `NH_SENK` | 5,6 / 12,9 | Senkung von oben für den Schraubenkopf (Ø, Höhe des Senkungsbodens über der Platinenoberseite). Boden tief gelegt, damit Jans vorhandene Pi-Schraube passt (07.11.: Flachkopf, ca. 19,2 inkl. Kopf → ca. 17,2–17,7 unter dem Kopf): reicht 2,7–3,2 unter die Platine (Mutter 2,0 oder Abstandsbolzen). Unabhängig von NH_KABEL. Kopf Ø höchstens 5,2 |
| `NH_KRAGEN` | 7,2 | Säule ab Senkungsboden aufwärts dicker (Wand 0,8 um die Senkung); darunter Ø 6. Kragen beginnt 0,9 über der Steckeroberkante, Abstand zum Kabel des ersten Steckers ca. 0,1–0,5 |
| `NH_FREI` | 17 / 15 | Aussparung an den beiden hinteren Dachecken über den Klemmblöcken der Schmalseiten: Länge ab Platinenende, Dach dort nur bis so weit ab Vorderkante. Klemmblöcke laut Foto 07.11. ca. 13–15 mm lang, beginnen ca. 18 mm hinter der Vorderkante (aus Foto geschätzt) |
| `ECK_WAND` | 2,4 | Wandstärke der Eckschuhe (TPU, ca. 5 Linien à 0,45) |
| `ECK_H` | 20 / 8 | Oberkante der Eckschuhe über der Bodenunterseite: in der Mitte der Rundung, an den Schenkelenden; dazwischen weicher Übergang (cos²). Variante C (Jan 09.11.). Grenze vorne: Fase des Gittersitzes (z 11,4 ab x 21, an der Sitzrundung R 9 höher); Abstand mindestens 1 mm (check.py) |
| `ECK_SCHENKEL` | 10 | Schenkel auf den geraden Flächen hinter dem Ende der Eckrundung R 16 (je Seite) |
| `ECK_END_R` | 5 | Rundung der Schenkelenden oben (in der Ansicht); auf diesen letzten Millimetern bleibt die Höhe gleich |
| `ECK_KANTE` | 1,2 | Obere Außenkante gerundet mit diesem Radius; untere Außenkante am Fuß Fase 45° gleicher Größe (druckbar, nimmt den Elefantenfuß) |
| `ECK_FUSS` | 3 | Fuß unter dem Boden: so viel steht die Box höher; nur die vier Ecken tragen |
| `ECK_FUSS_IN` | 20 | Fuß reicht so weit unter den Boden (ab Außenkante); trägt die Hülse an der Eckschraube (8,6 / 8,6) |
| `ECK_HUELSE` | d_bund 9,8; bund_bis -1,5; d_hals 8,2; hals_ab -0,7; luft_unten 0,5; spiel 0,25 | PETG-Hülse an der Eckschraube (z wie im Einbau, Oberseite z 0 liegt am Boden an): Bund Ø 9,8 bis z −1,5, Kegel 45° bis Ø 8,2 bei z −0,7, Hals Ø 8,2 bis z 0. Unterseite 0,5 über der Standfläche (Kopf und Hülse berühren den Tisch nicht). Senkung für den Kopf wie im Boden (CSK). Ø-Grenze: Eckschraube liegt 5,53 hinter der Außenrundung, unten bleiben 1,6 mm TPU. Aussparung im TPU radial 0,25 größer |
| `ECK_SCHRAUBE` | 16 | Senkschraube 3,0 × 16 (Länge inkl. Kopf) statt 3,0 × 12: Hülse 2,5 + Boden 4 + 9,5 im Dom (bisher 8; Kernloch 12 tief) |
