janshort4all/peppa-box/kartenbox/out/v_hinten.png

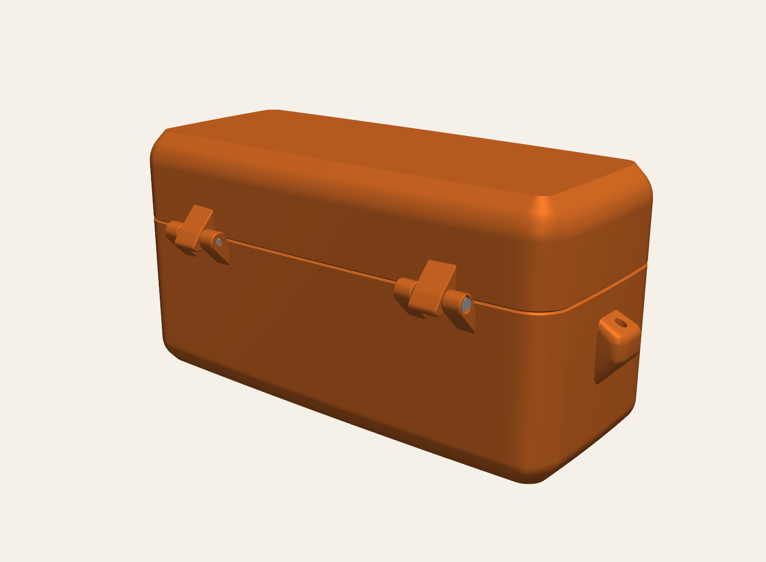
kartenbox/out/v_hinten.png
