janshort4all/peppa-box/kartenbox/out/v_iso_offen.png

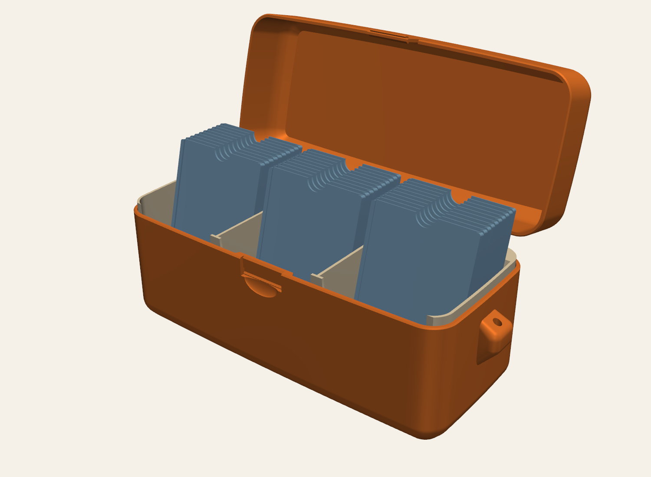
kartenbox/out/v_iso_offen.png
