janshort4all/peppa-box/kartenbox/out/v_oben_offen.png

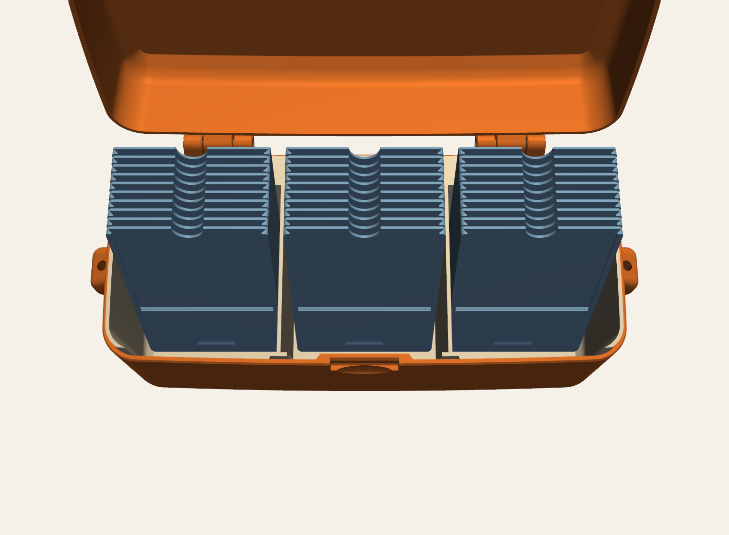
kartenbox/out/v_oben_offen.png
