janshort4all/peppa-box/kartenbox/out/v_schnitt_offen.png

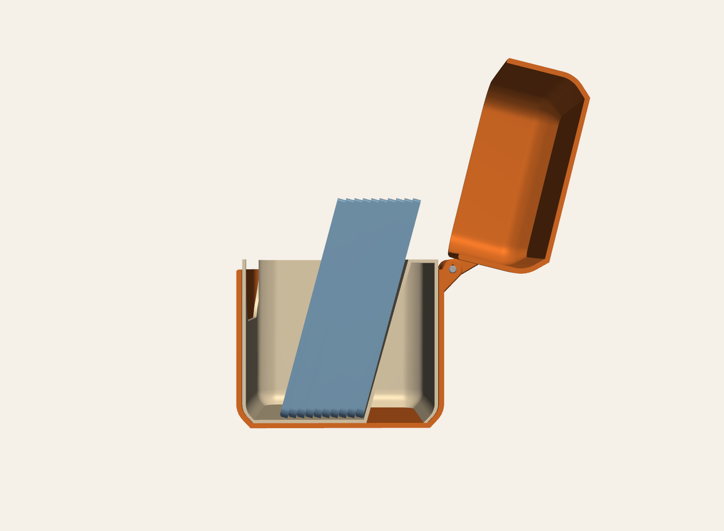
kartenbox/out/v_schnitt_offen.png
