janshort4all/peppa-box/kartenbox/out/v_schnitt_seite.png

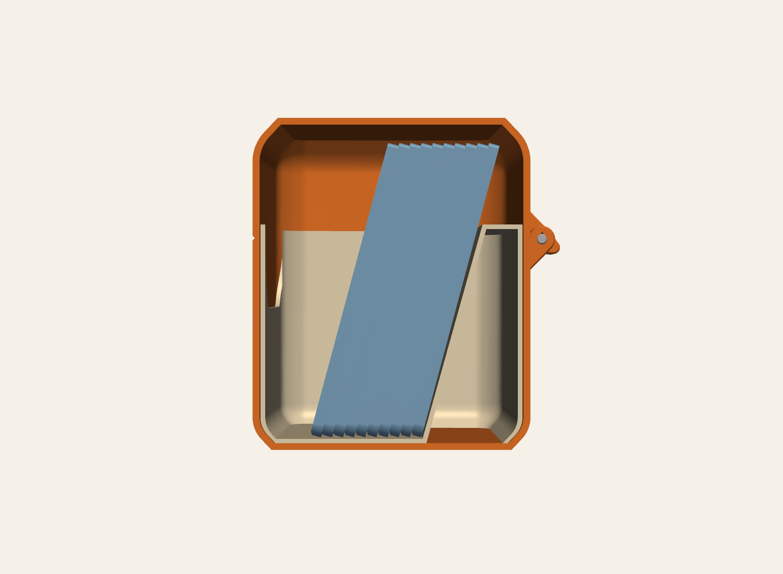
kartenbox/out/v_schnitt_seite.png
