janshort4all/peppa-box/kartenbox/out/v_vorne.png

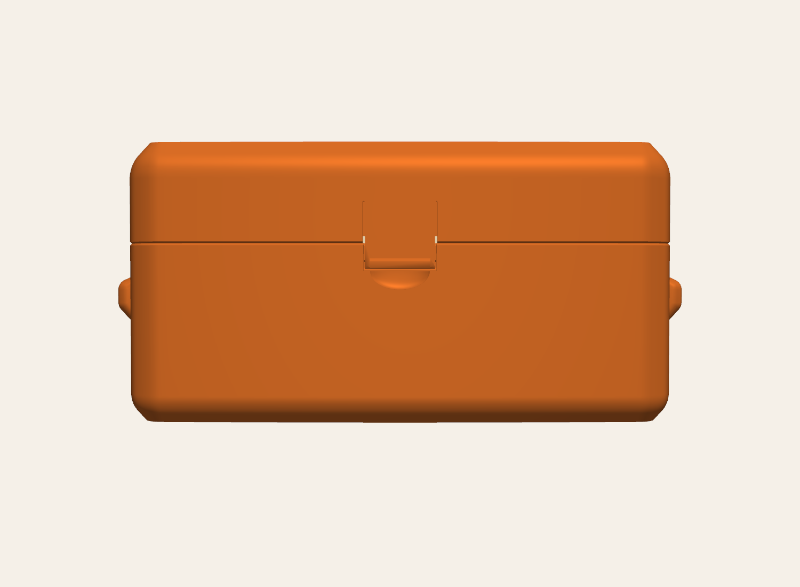
kartenbox/out/v_vorne.png
