janshort4all/peppa-box/kartenbox/v1_entwurf/out/s_x0.png

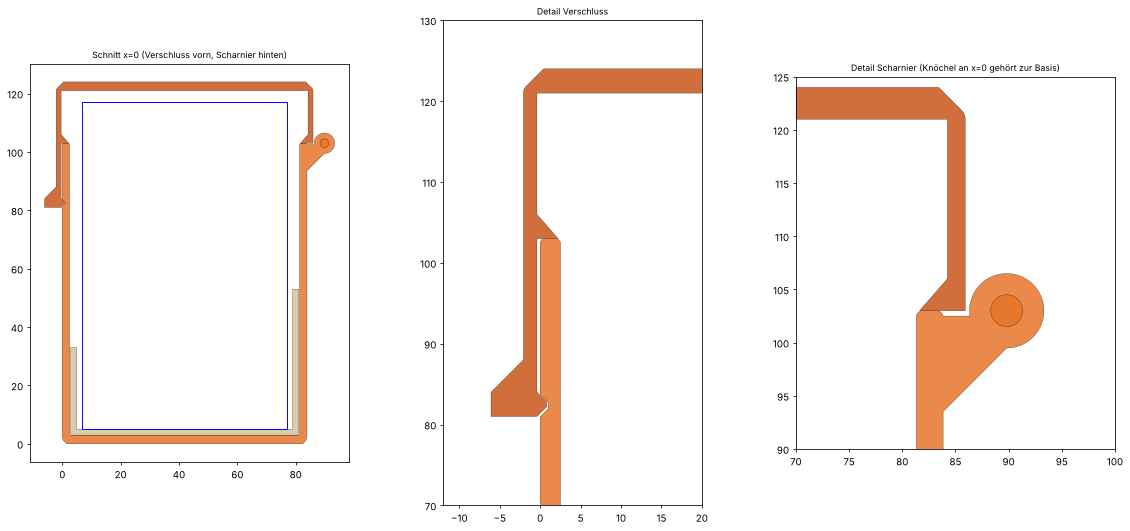
kartenbox/v1_entwurf/out/s_x0.png
