janshort4all/peppa-box/kartenbox/v1_entwurf/out/v_hinten_zu.png

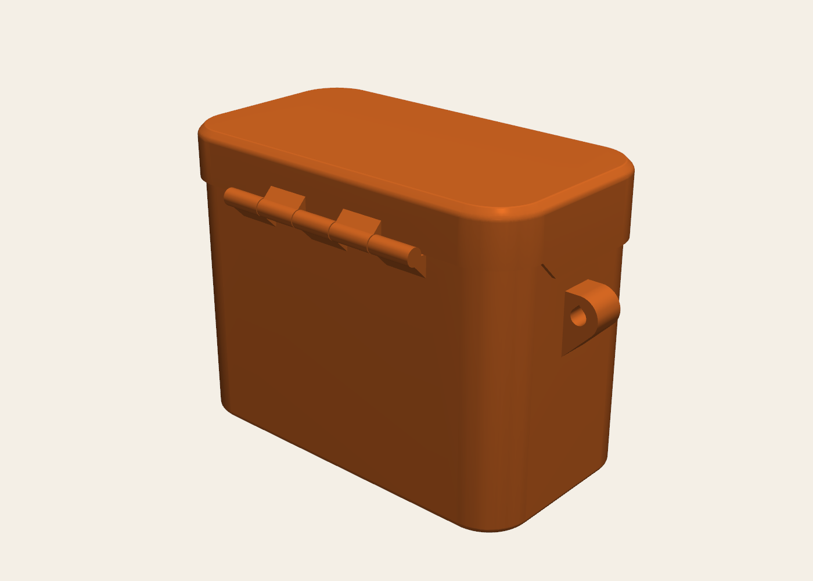
kartenbox/v1_entwurf/out/v_hinten_zu.png
