janshort4all/peppa-box/kartenbox/v1_entwurf/out/v_iso_offen.png

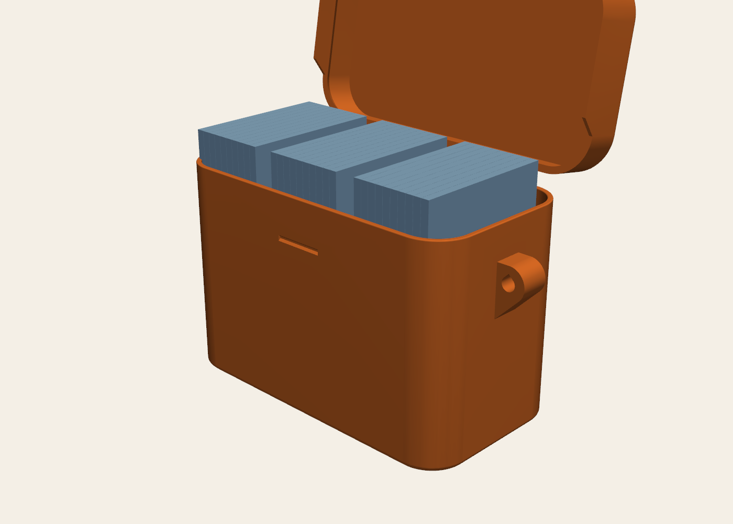
kartenbox/v1_entwurf/out/v_iso_offen.png
