janshort4all/peppa-box/kartenbox/v1_entwurf/out/v_iso_zu.png

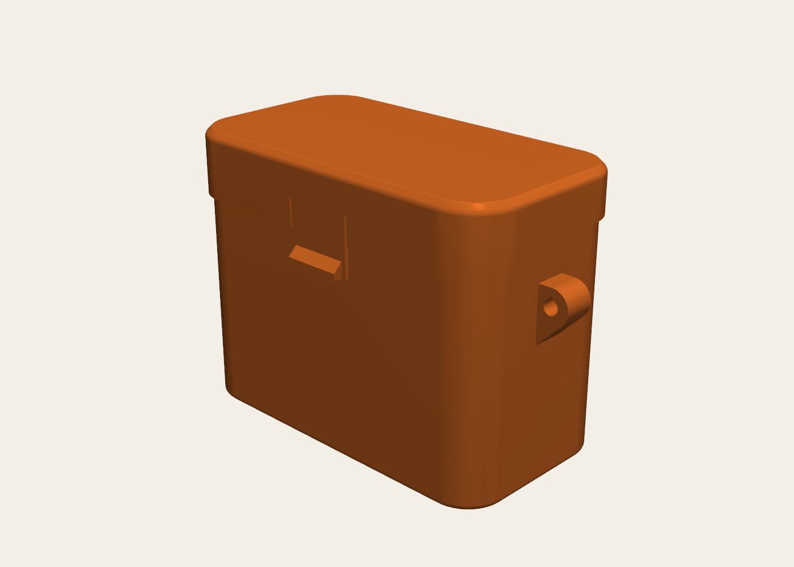
kartenbox/v1_entwurf/out/v_iso_zu.png
