janshort4all/peppa-box/kartenbox/v1_entwurf/out/v_oben_offen.png

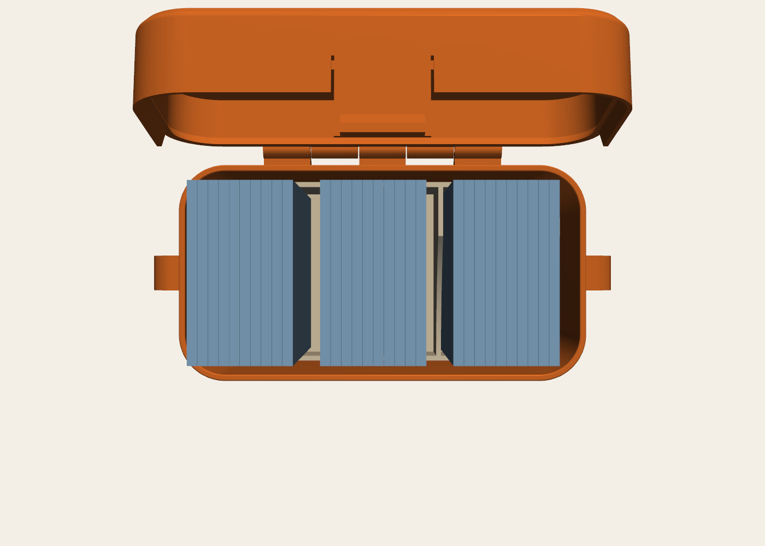
kartenbox/v1_entwurf/out/v_oben_offen.png
