janshort4all/peppa-box/v4/out/boden_3d.png

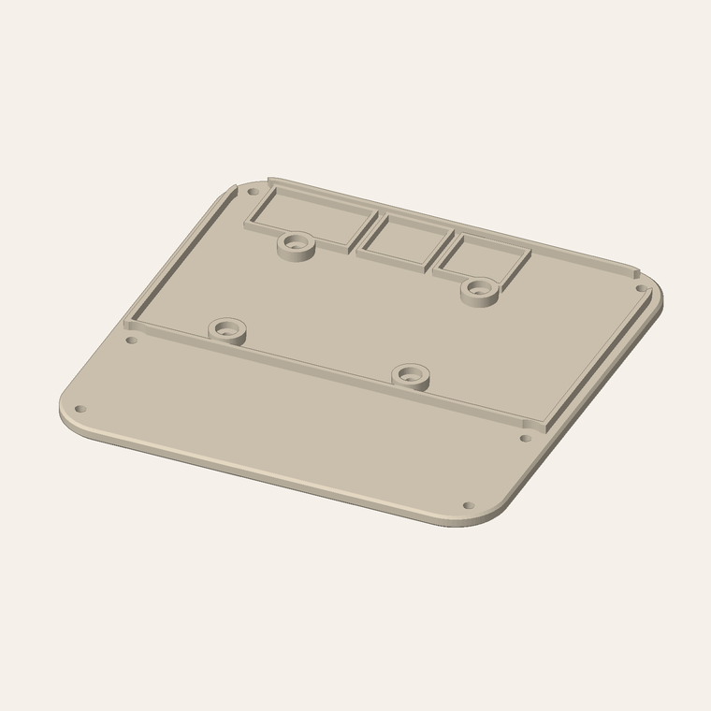
v4/out/boden_3d.png
