janshort4all/peppa-box/v4/out/boden_plan.png

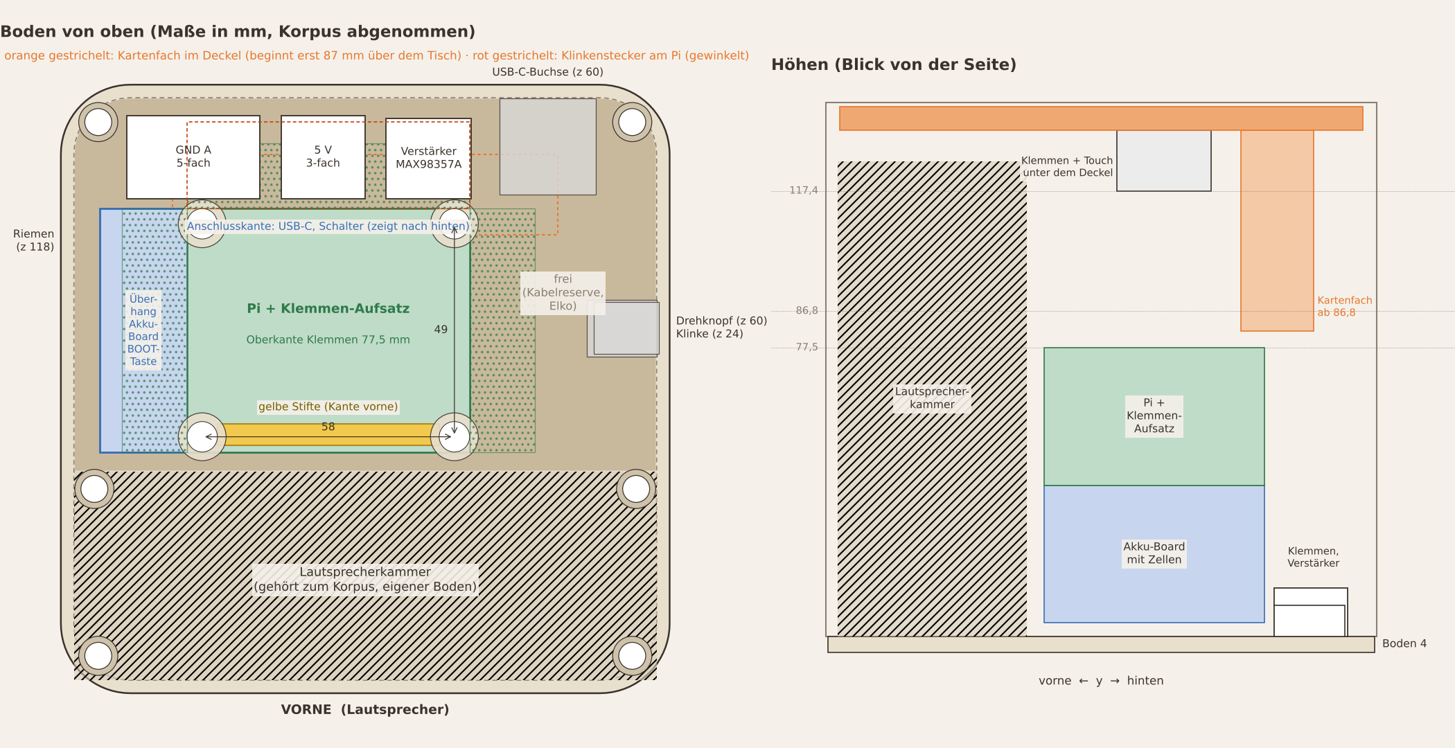
v4/out/boden_plan.png
