janshort4all/peppa-box/v4/out/deckel_draufsicht.png

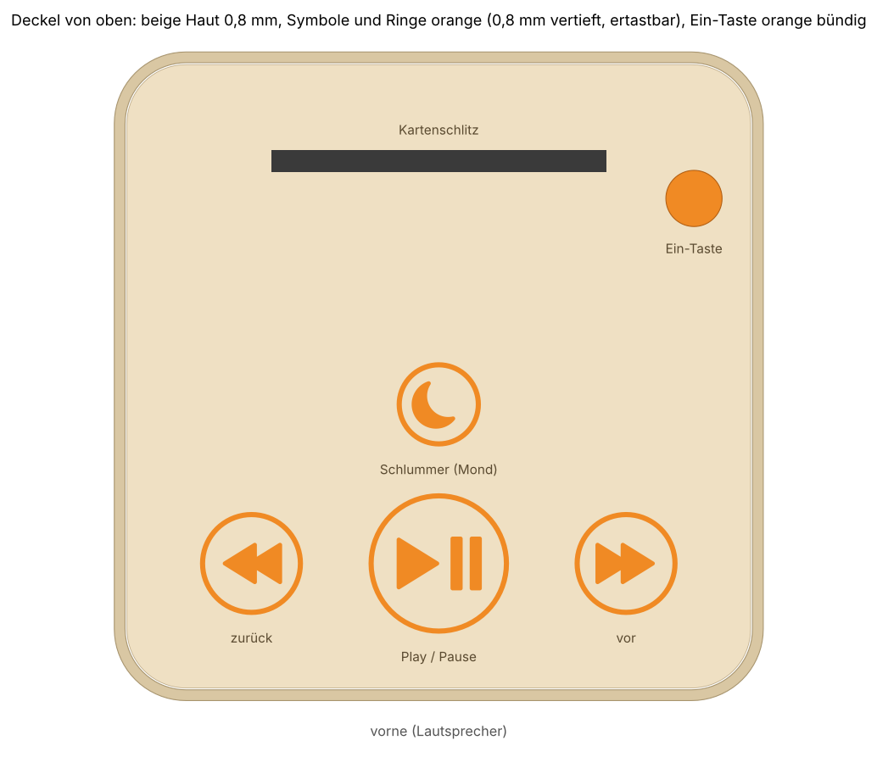
v4/out/deckel_draufsicht.png
