janshort4all/peppa-box/v4/out/deckel_ursache.png

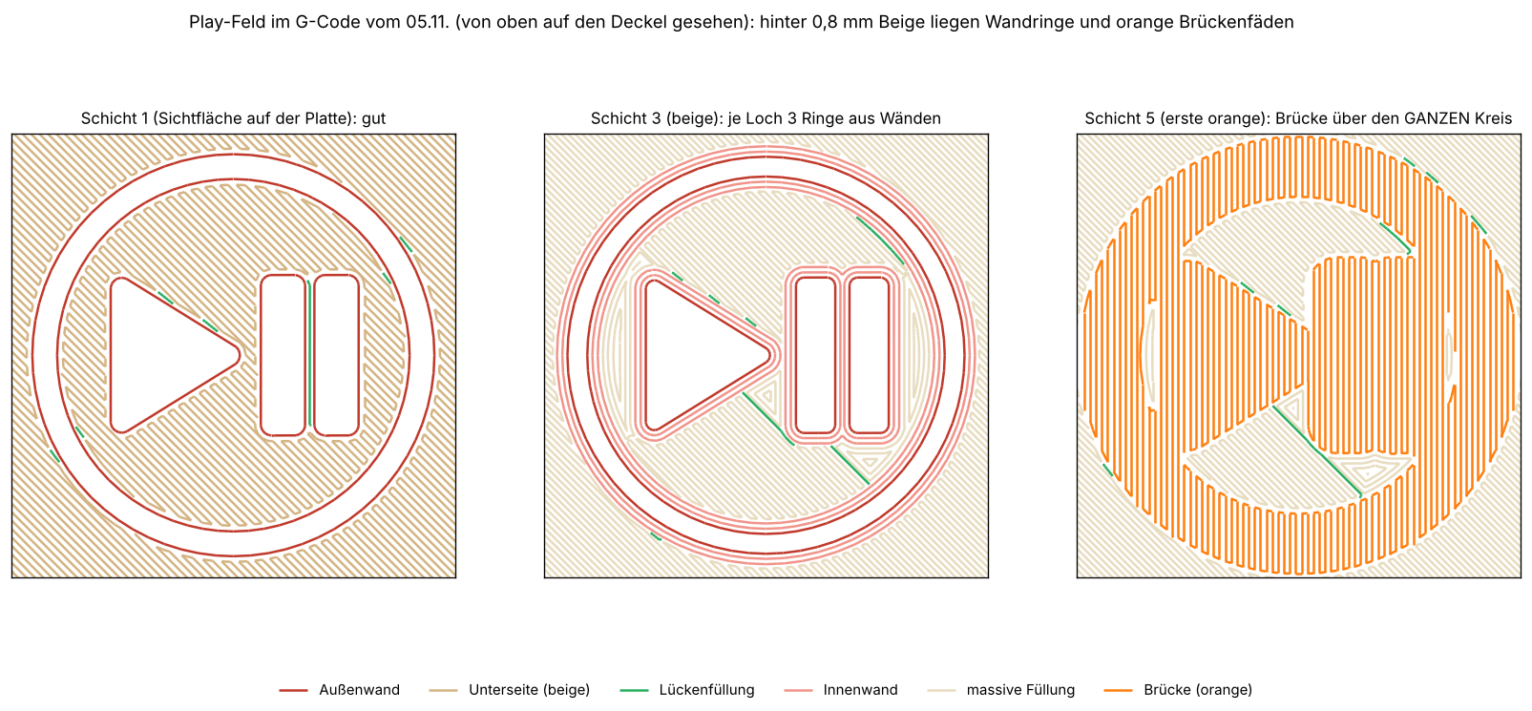
v4/out/deckel_ursache.png
