janshort4all/peppa-box/v4/out/deckel_vorher_nachher.png

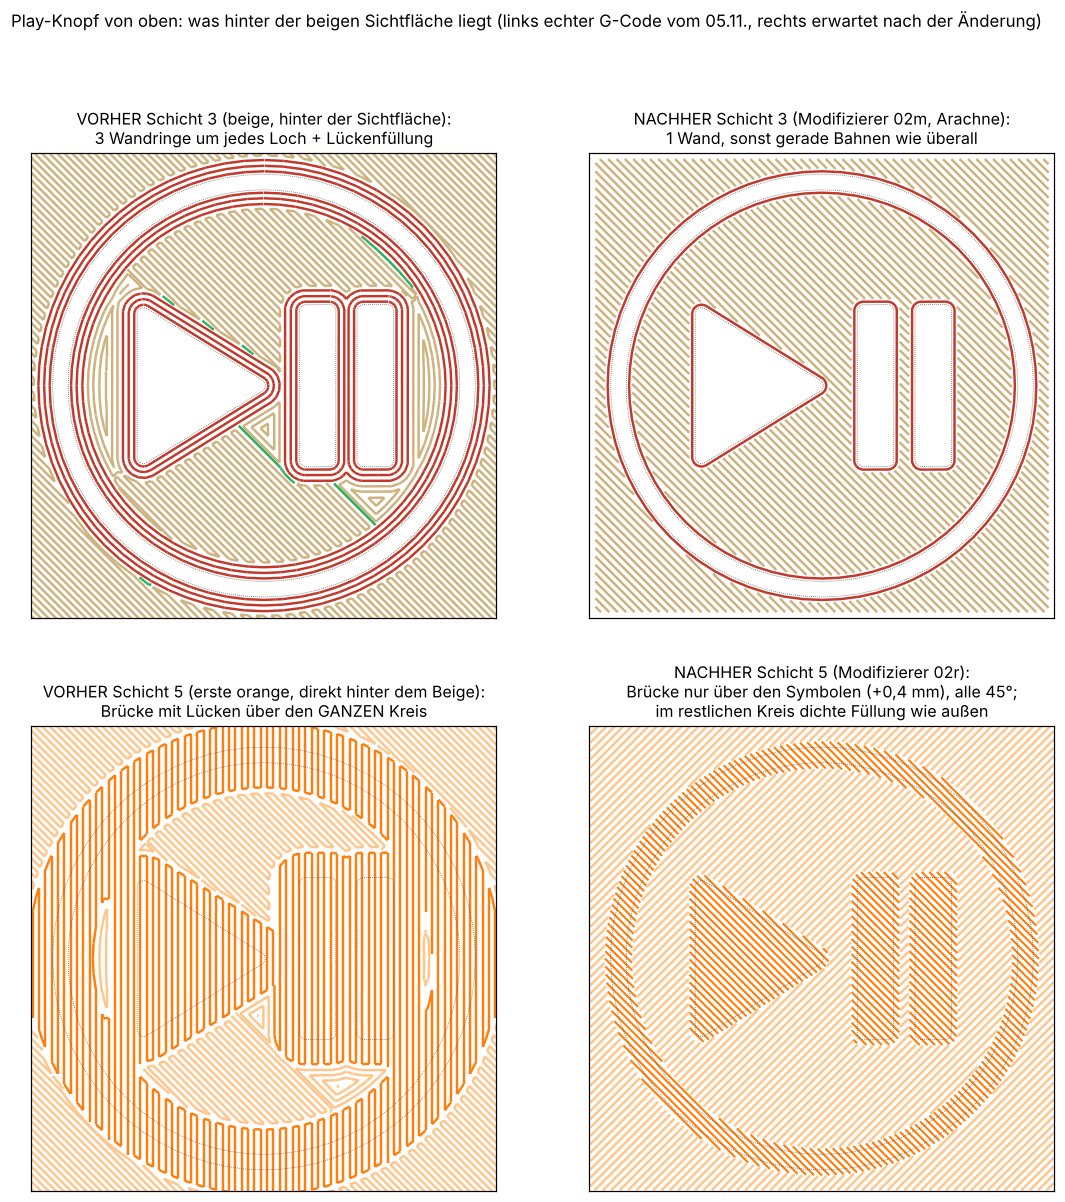
v4/out/deckel_vorher_nachher.png
