janshort4all/peppa-box/v4/out/drehknopf_schnitt.png

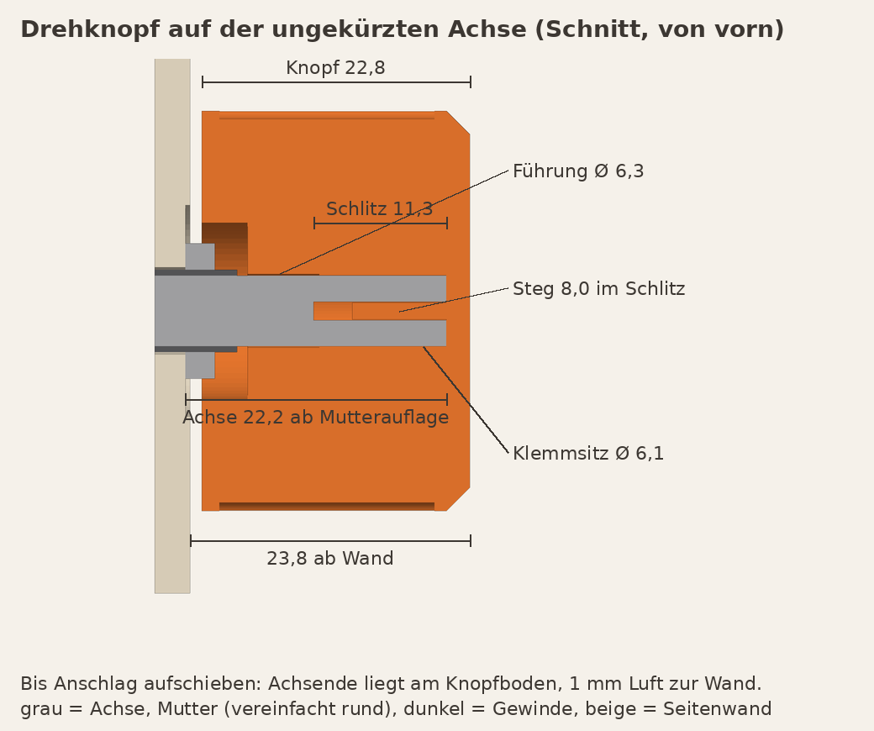
v4/out/drehknopf_schnitt.png
