janshort4all/peppa-box/v4/out/ein_taste_schnitt.png

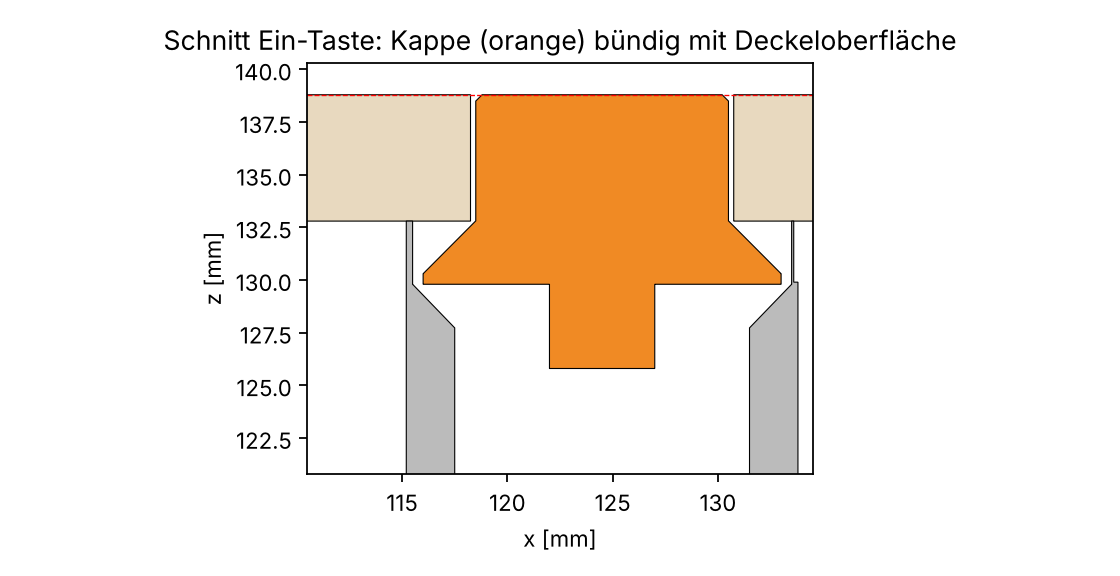
v4/out/ein_taste_schnitt.png
