janshort4all/peppa-box/v4/out/fuge_schnitt.png

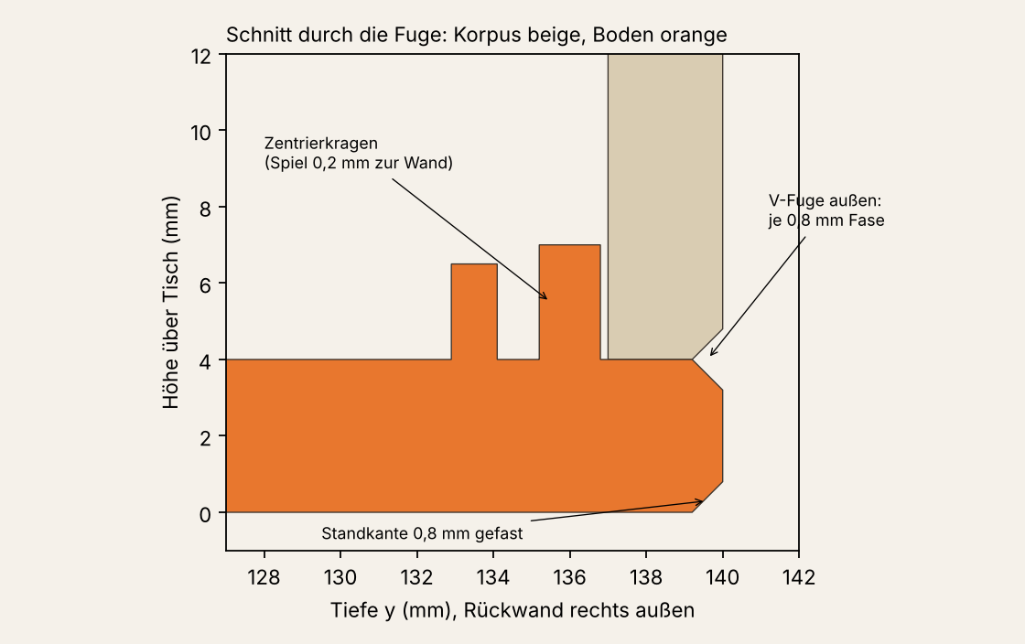
v4/out/fuge_schnitt.png
