janshort4all/peppa-box/v4/out/fuzzy_analyse.png

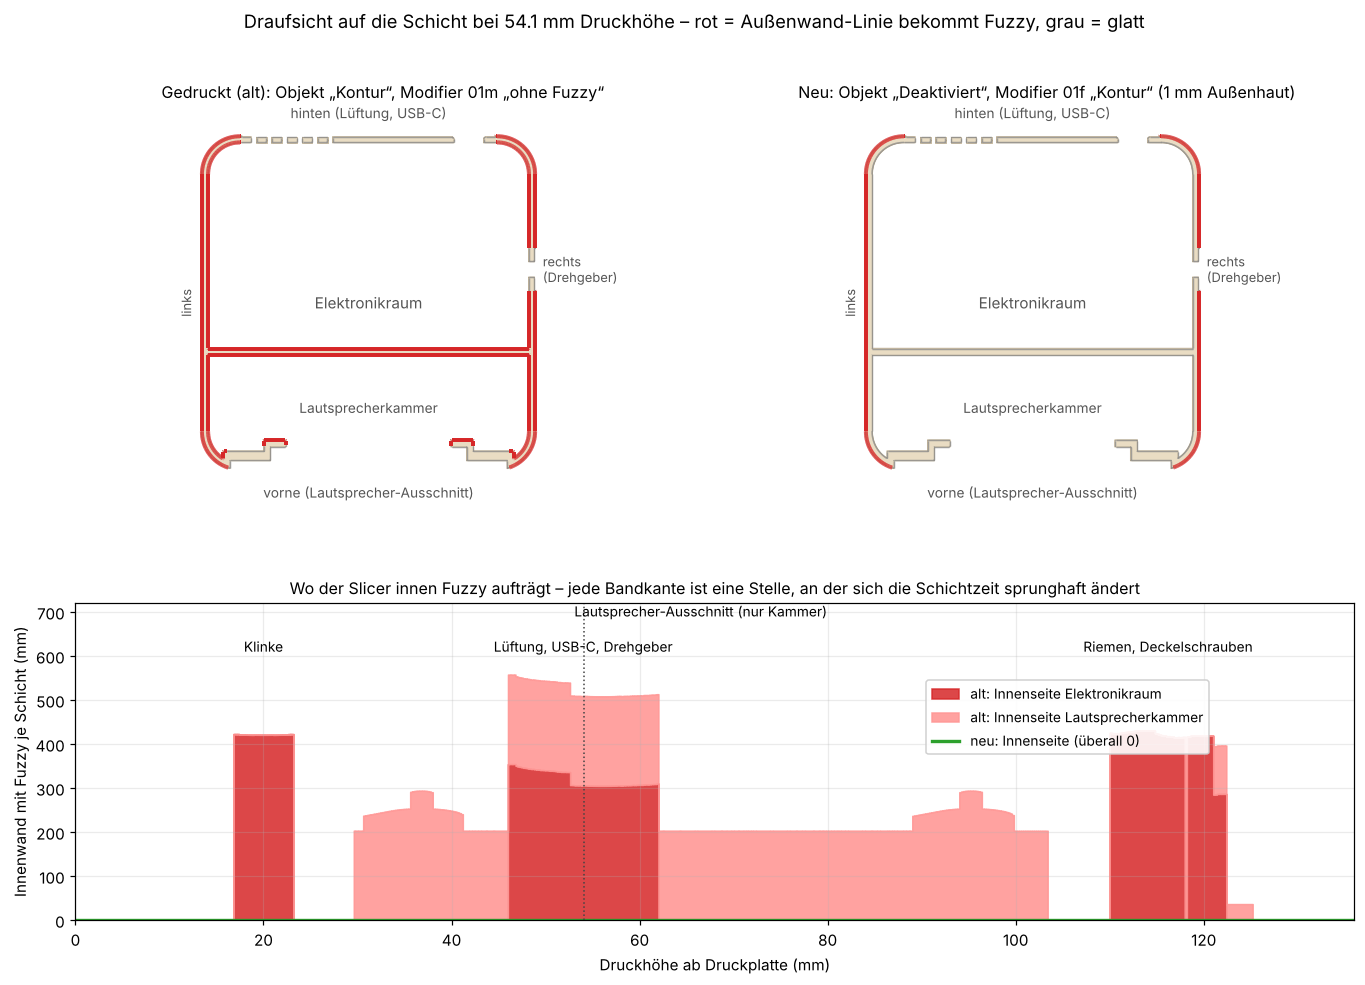
v4/out/fuzzy_analyse.png
