janshort4all/peppa-box/v4/out/gcode_schichtzeit.png

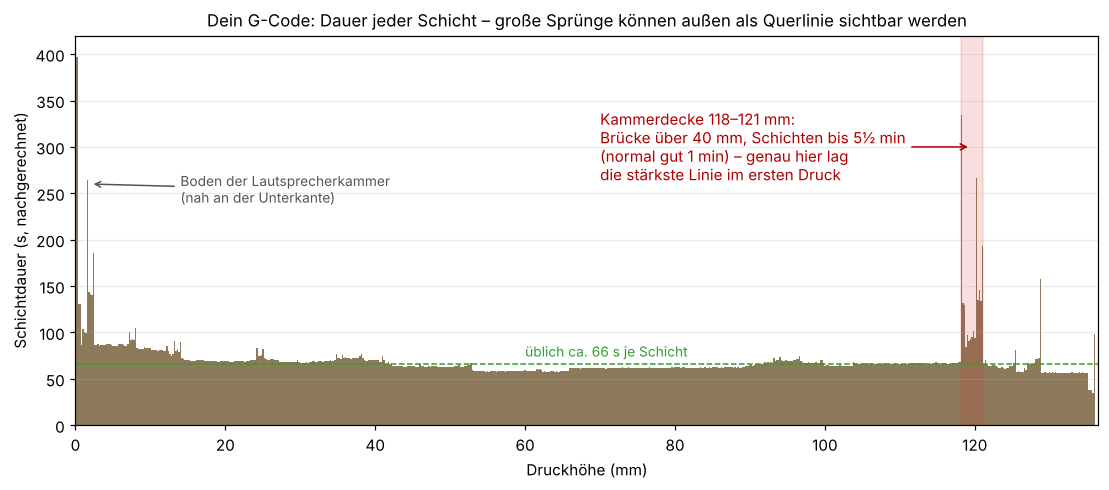
v4/out/gcode_schichtzeit.png
