janshort4all/peppa-box/v4/out/gitter_ansicht.png

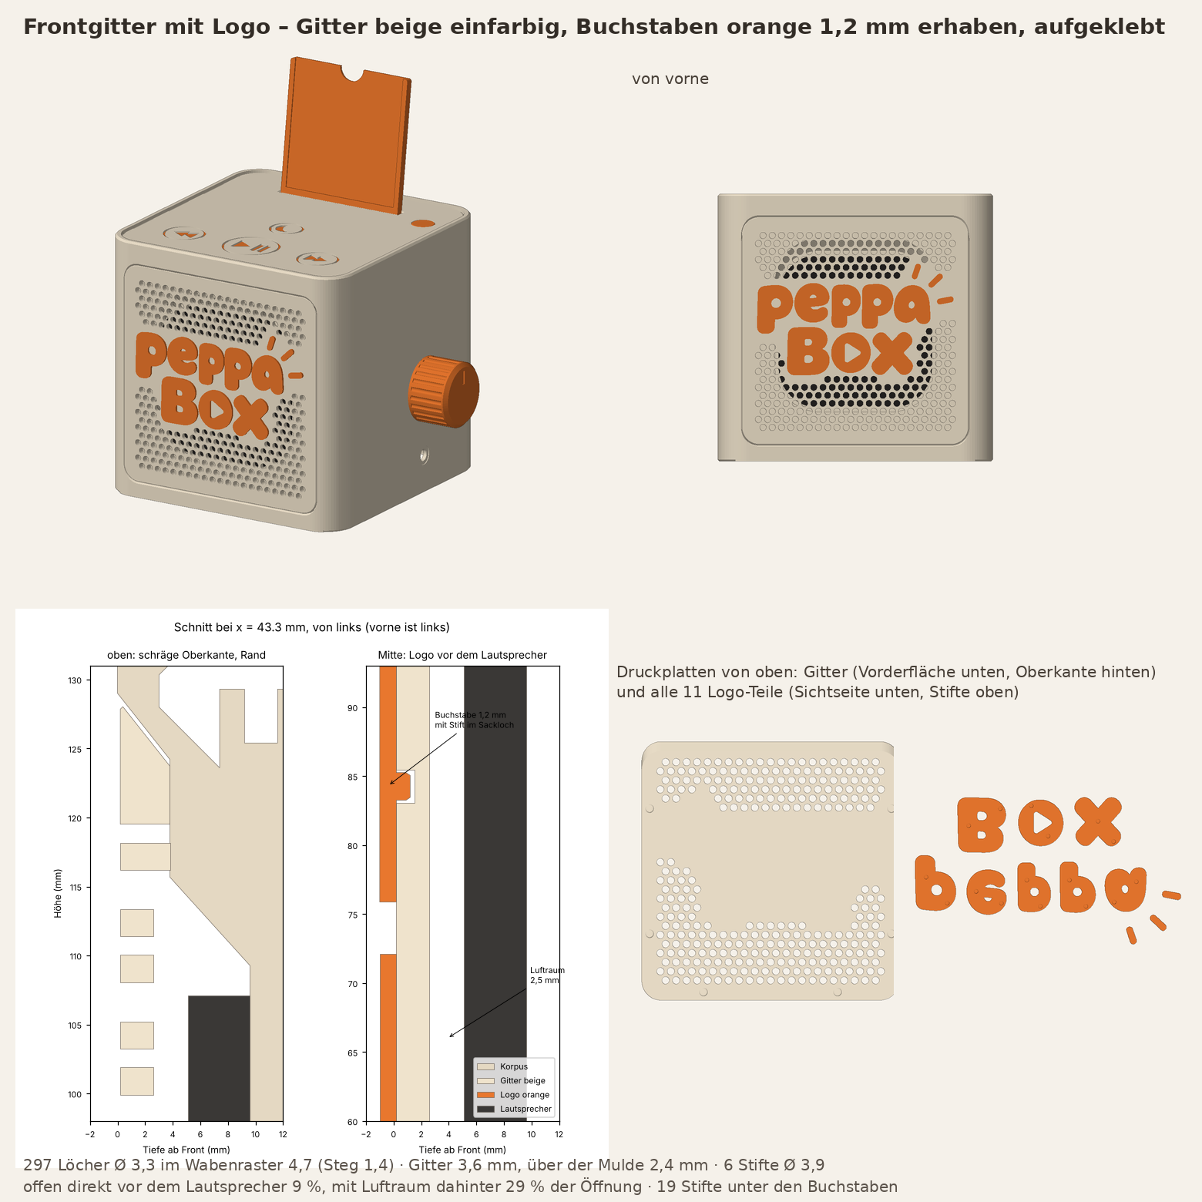
v4/out/gitter_ansicht.png
