janshort4all/peppa-box/v4/out/gitter_vorne_nah.png

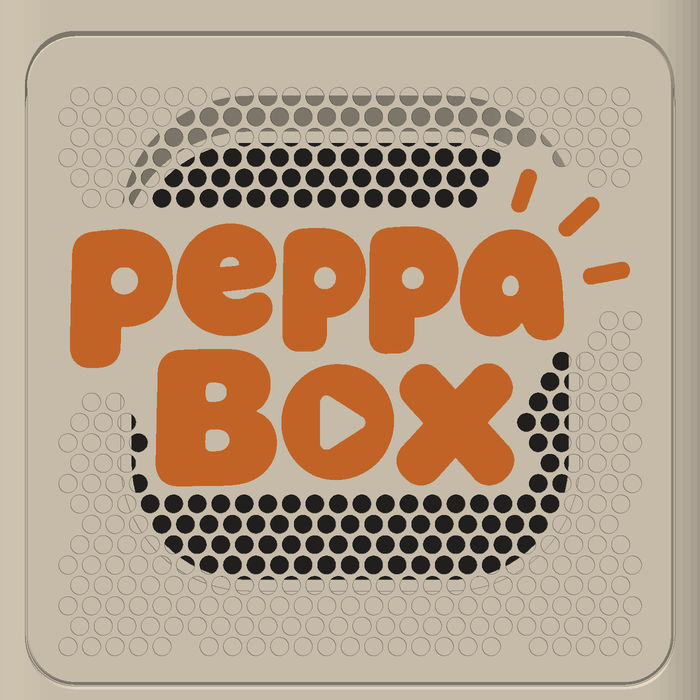
v4/out/gitter_vorne_nah.png
