janshort4all/peppa-box/v4/out/gummiecken_ansicht.png

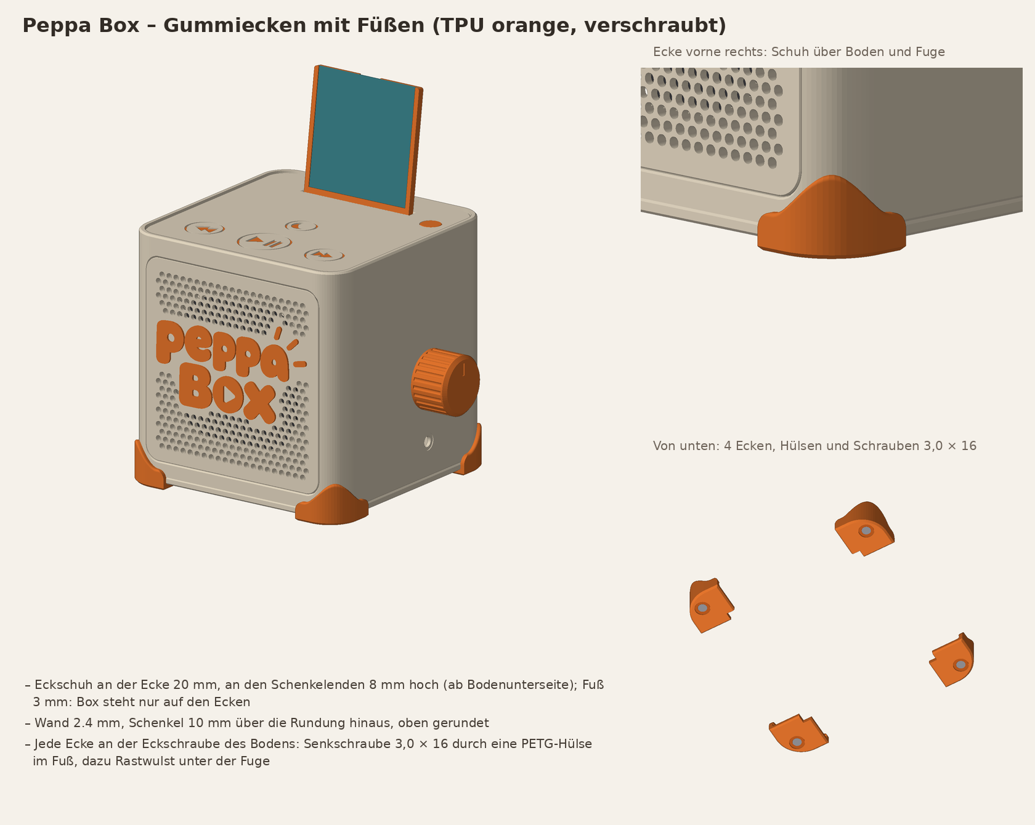
v4/out/gummiecken_ansicht.png
