janshort4all/peppa-box/v4/out/gummiecken_schnitt.png

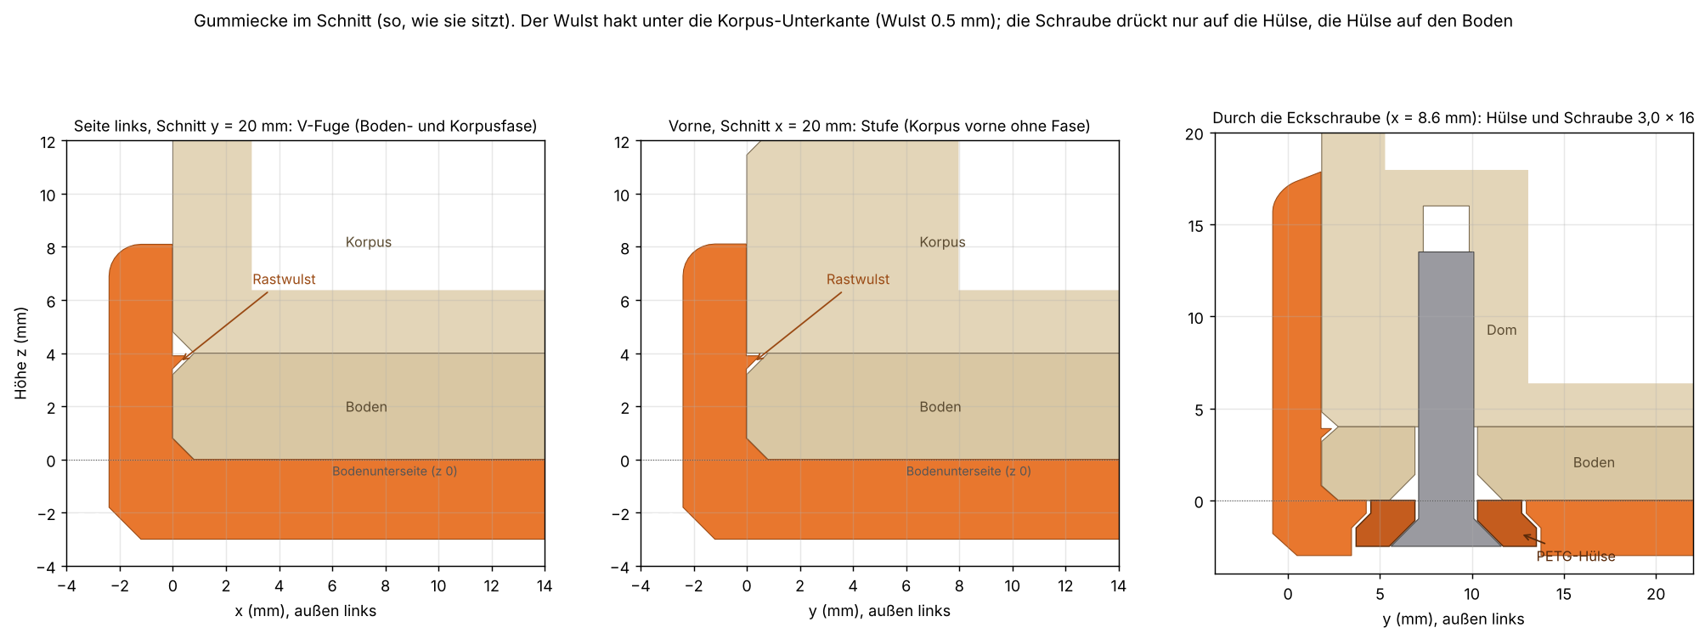
v4/out/gummiecken_schnitt.png
