janshort4all/peppa-box/v4/out/gummiecken_varianten.png

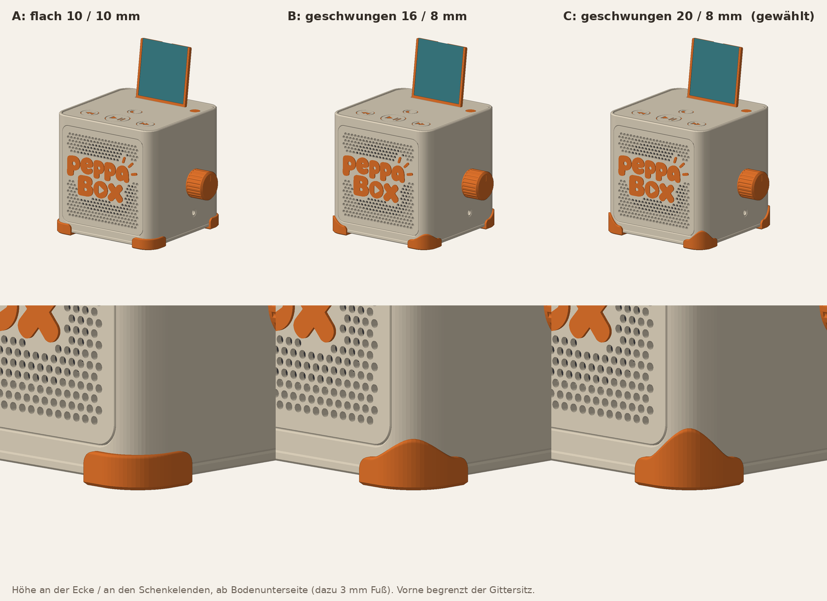
v4/out/gummiecken_varianten.png
