janshort4all/peppa-box/v4/out/kammerdecke_satteldach.png

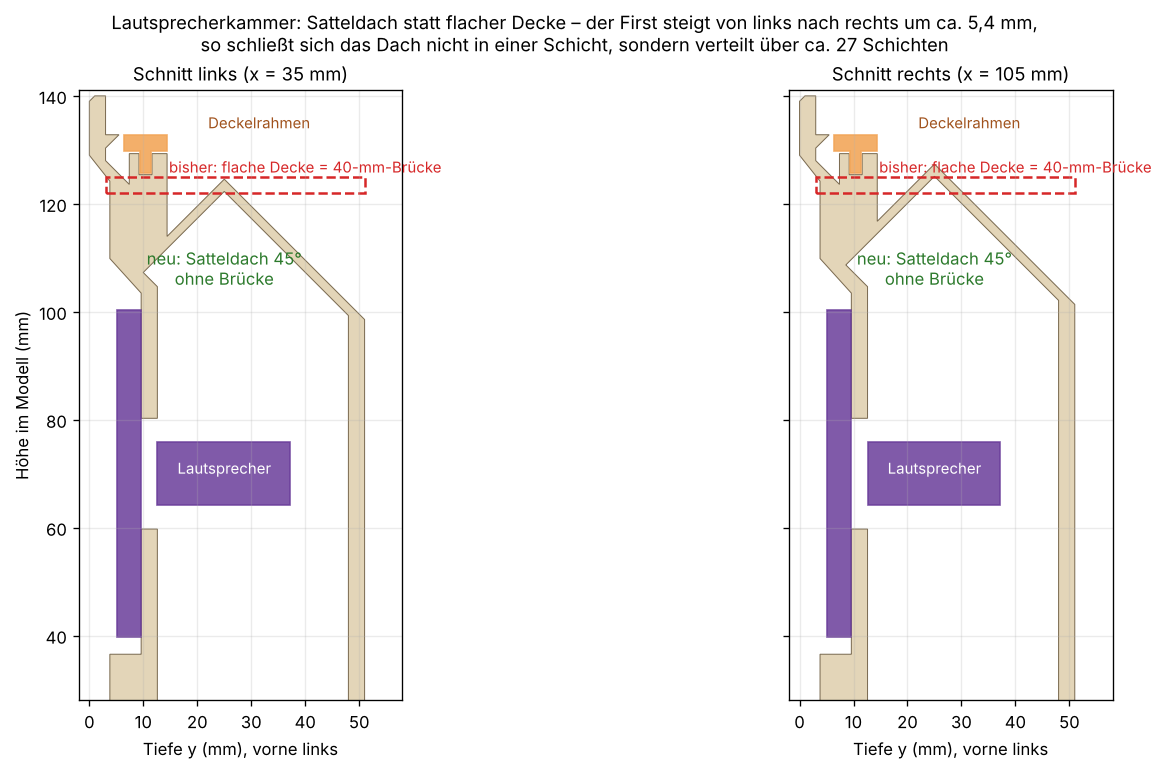
v4/out/kammerdecke_satteldach.png
