janshort4all/peppa-box/v4/out/kammerdecke_schichtzeit.png

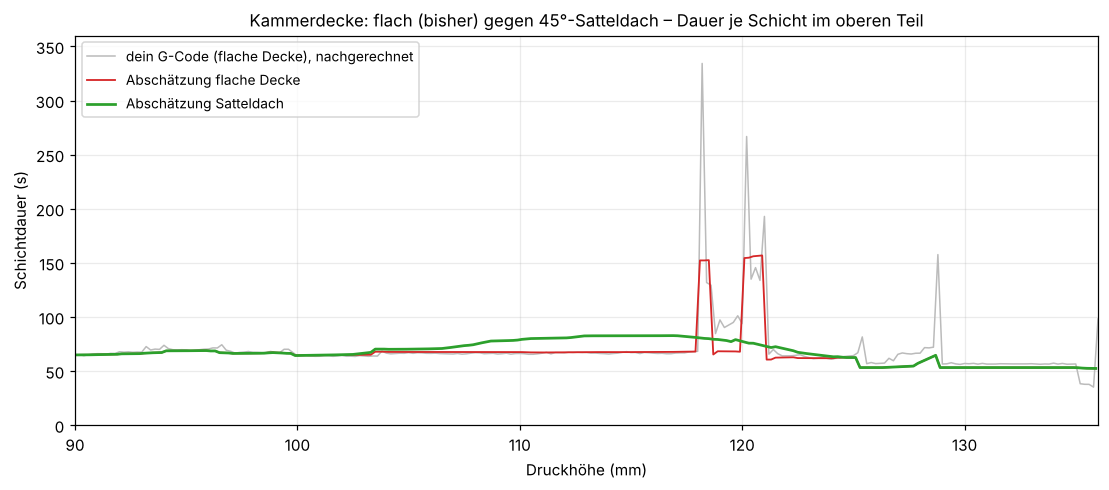
v4/out/kammerdecke_schichtzeit.png
