janshort4all/peppa-box/v4/out/musikbox_v4_ansichten.png

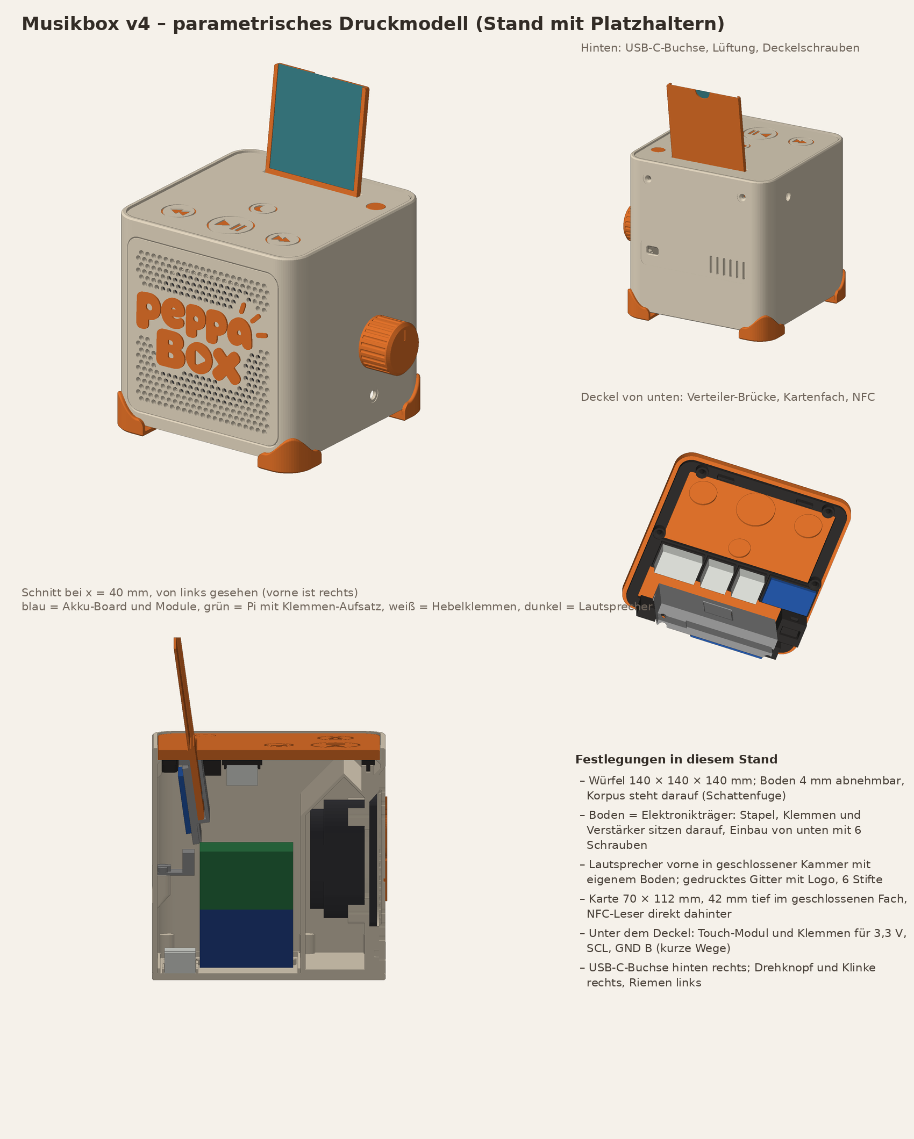
v4/out/musikbox_v4_ansichten.png
