janshort4all/peppa-box/v4/out/naht_aufmalen.png

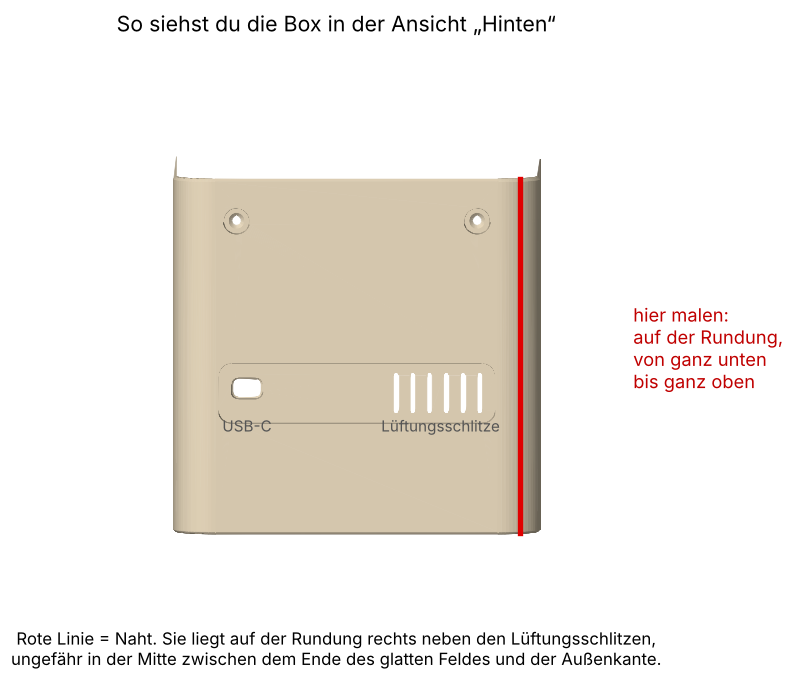
v4/out/naht_aufmalen.png
