janshort4all/peppa-box/v4/out/niederhalter.png

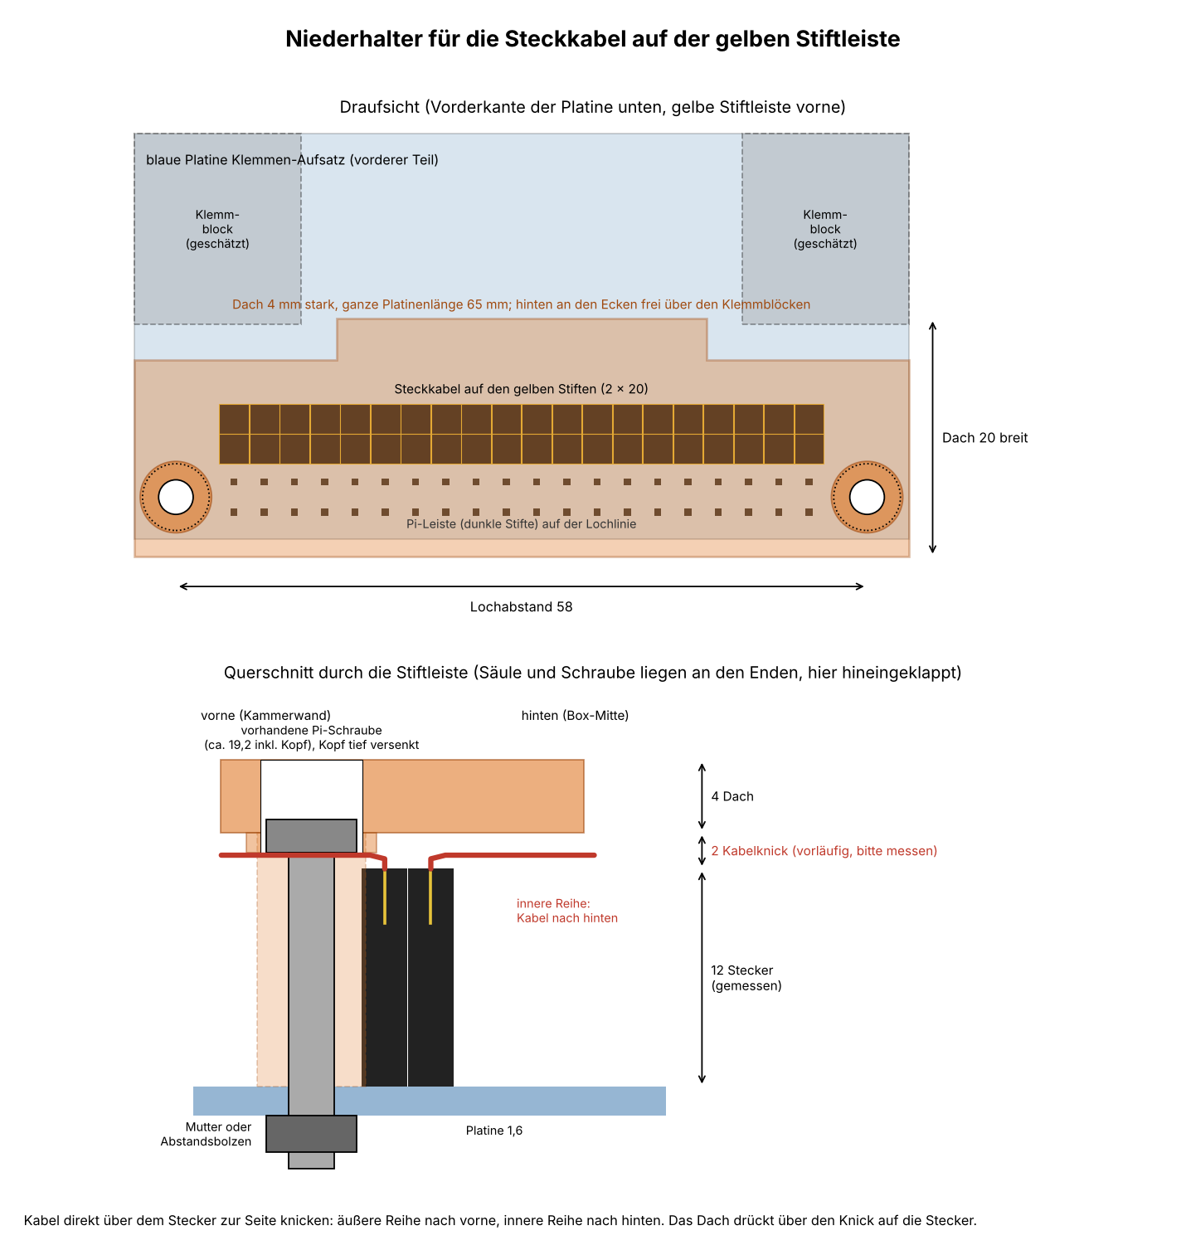
v4/out/niederhalter.png
