janshort4all/peppa-box/v4/out/rastung_schnitt.png

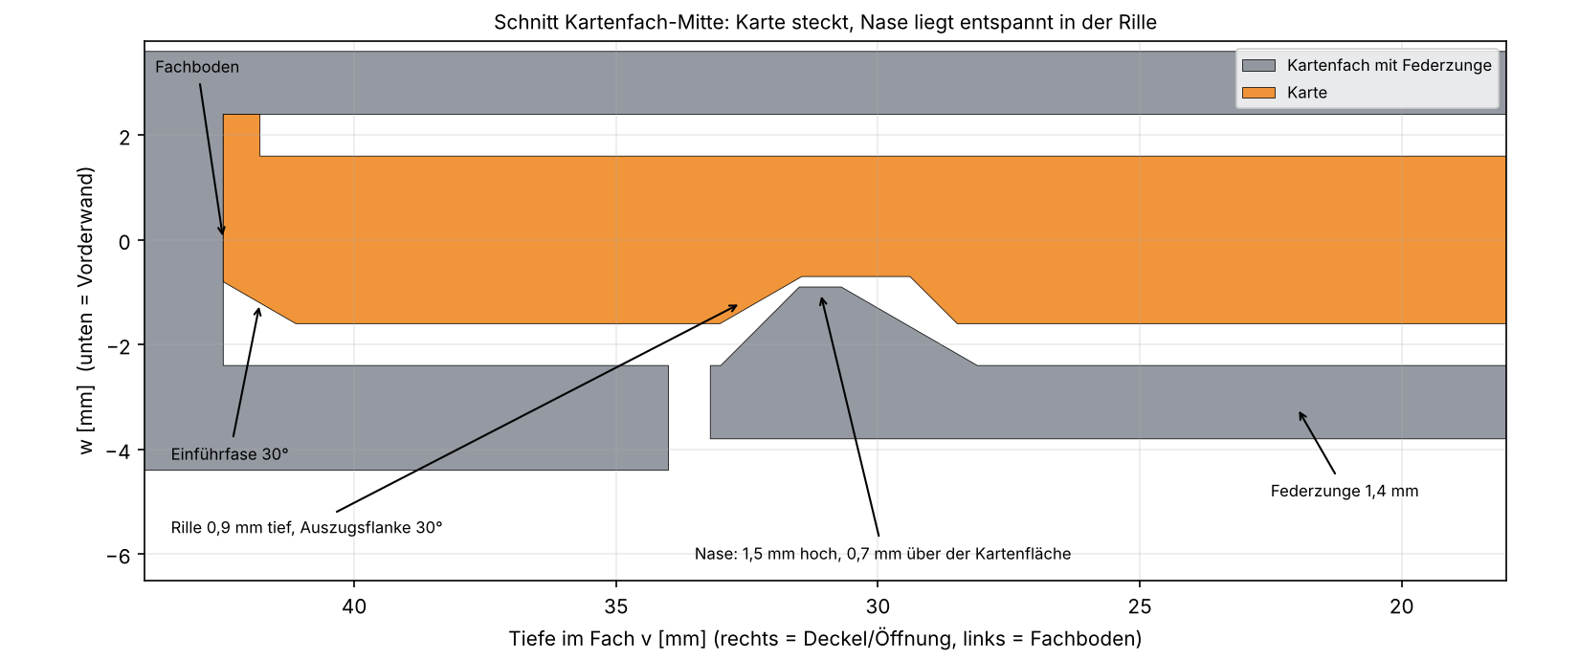
v4/out/rastung_schnitt.png
