janshort4all/peppa-box/v4/out/usbc_ansicht.png

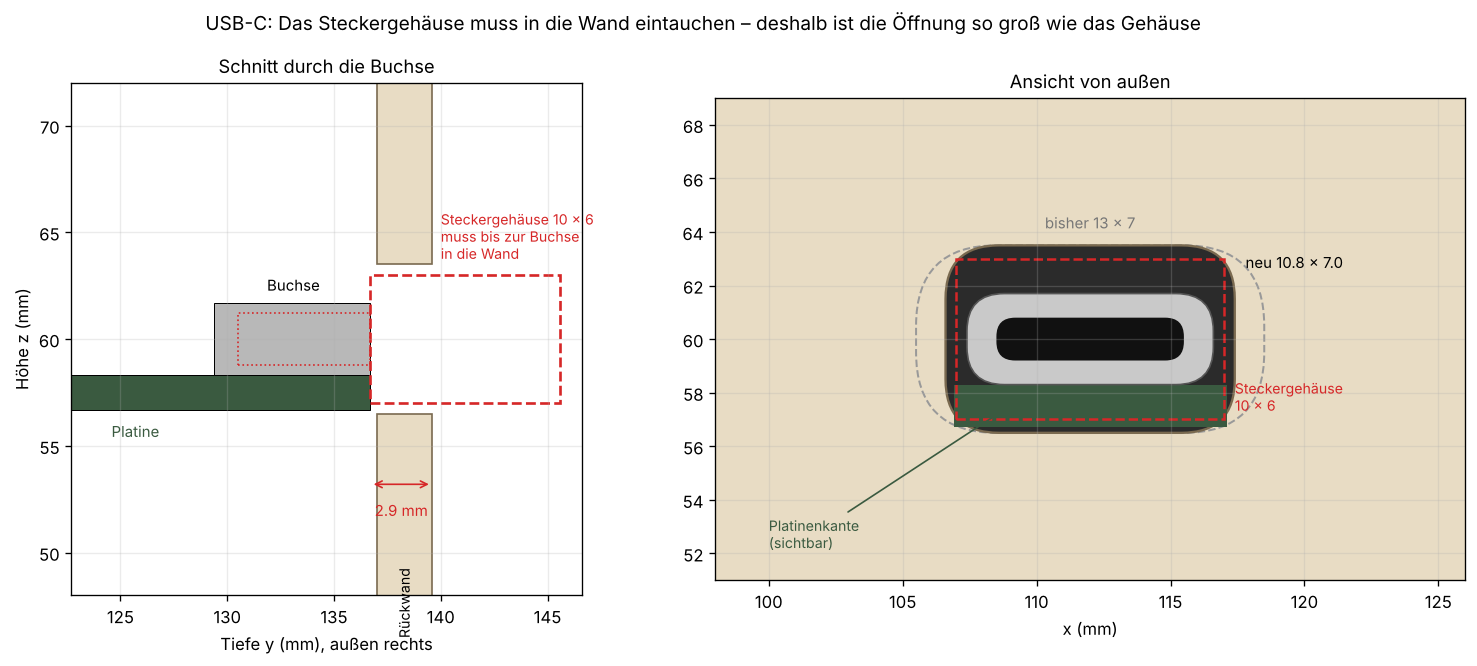
v4/out/usbc_ansicht.png
