janshort4all/peppa-box/v4/out/usbc_schnitt.png

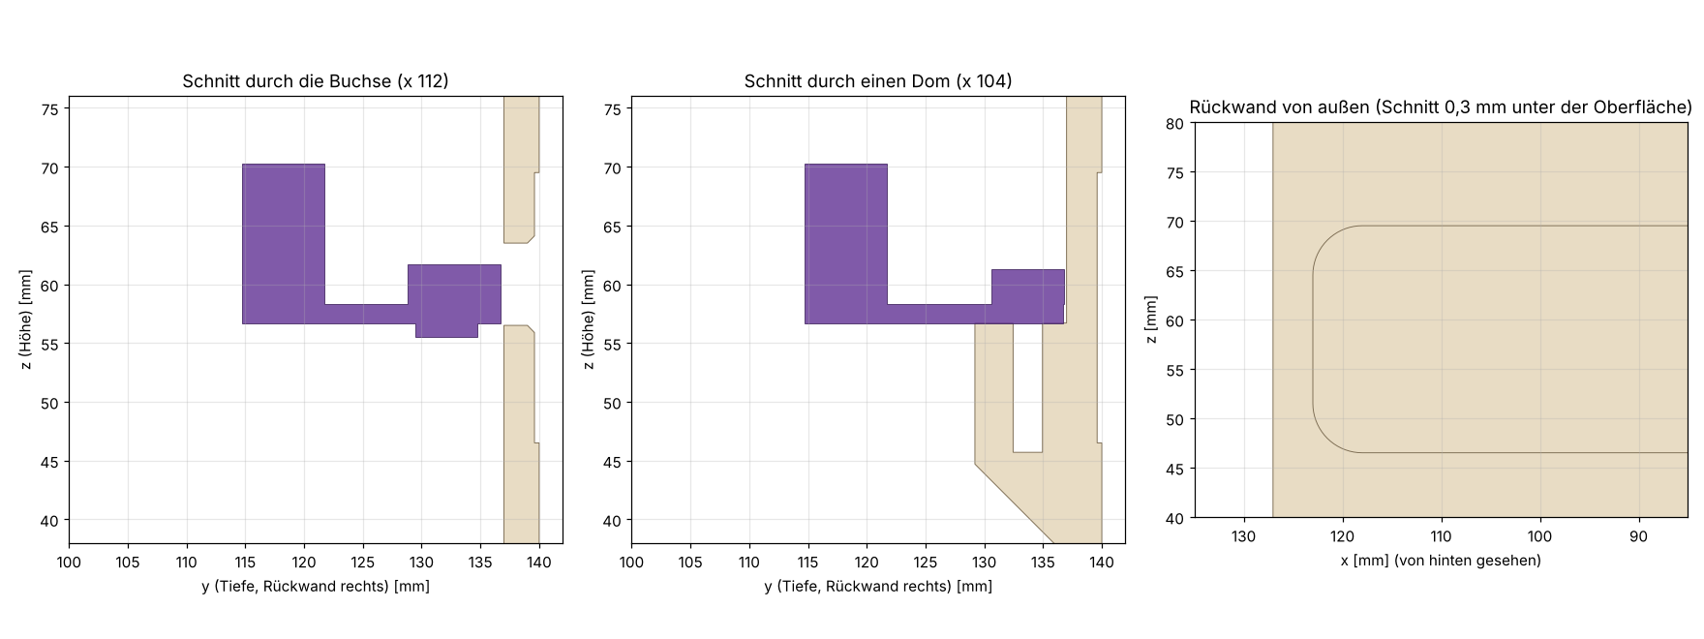
v4/out/usbc_schnitt.png
