janshort4all/peppa-box/kartenbox/out/druck/01f_modifier_basis_FUZZY.stl

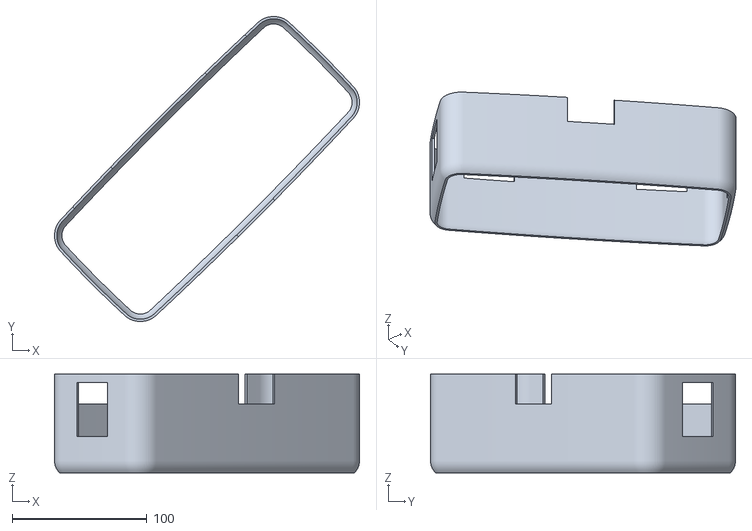
[picture p36: CAD file, 2026-11-13]
kartenbox/out/druck/01f_modifier_basis_FUZZY.stl
226.3 x 226.3 x 73.4
