janshort4all/peppa-box/kartenbox/out/druck/probedruck/K3c_passung_deckel_kopfueber.stl

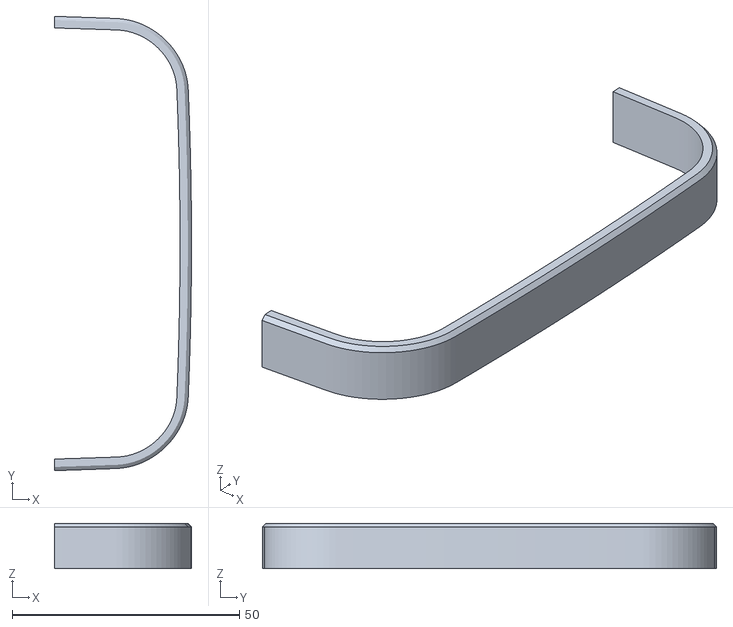
[picture p37: CAD file, 2026-11-13]
kartenbox/out/druck/probedruck/K3c_passung_deckel_kopfueber.stl
30.2 x 100.0 x 10.0
