janshort4all/peppa-box/kartenbox/out/kartenbox_zusammenbau.3mf

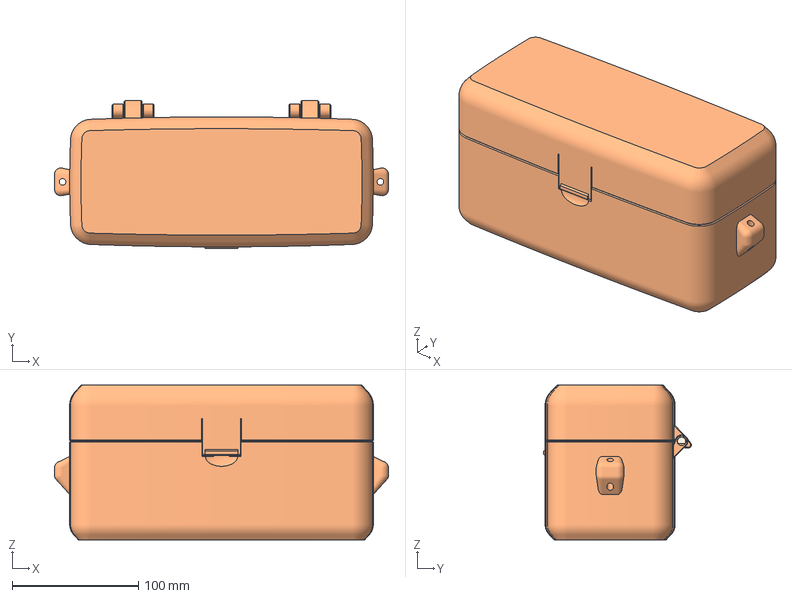
[picture p38: CAD file, 2026-11-13]
kartenbox/out/kartenbox_zusammenbau.3mf
264.3 x 117.0 x 122.3 mm
basis
deckel
inlay
stift
karten
