janshort4all/peppa-box/kartenbox/v1_entwurf/out/druck/03_inlay_beige.stl

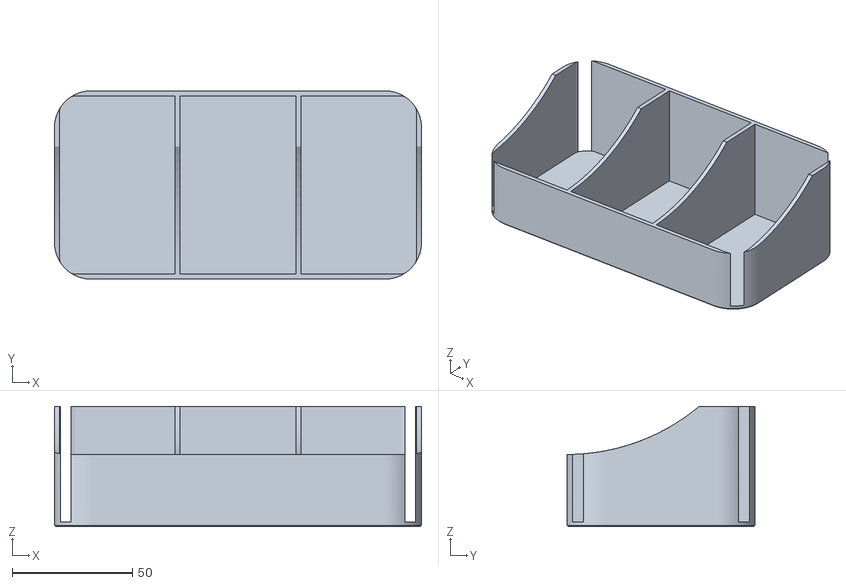
[picture p39: CAD file, 2026-11-11]
kartenbox/v1_entwurf/out/druck/03_inlay_beige.stl
152.4 x 78.2 x 50.0
