janshort4all/peppa-box/kartenbox/v1_entwurf/out/druck/probedruck/K1A_scharnier_deckel_bohrung3.2.stl

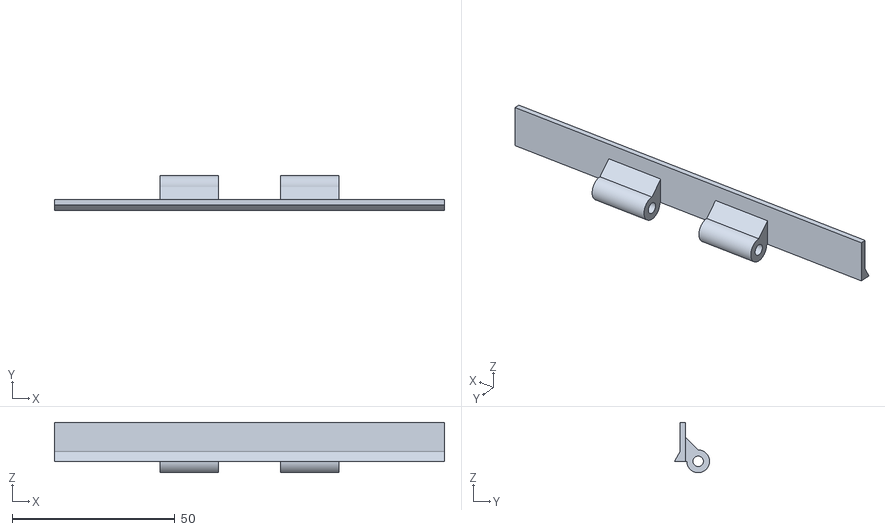
[picture p40: CAD file, 2026-11-11]
kartenbox/v1_entwurf/out/druck/probedruck/K1A_scharnier_deckel_bohrung3.2.stl
120.0 x 10.8 x 15.5
