janshort4all/peppa-box/v4/out/coupon_C16_gummiecke_wulst_0-6.stl

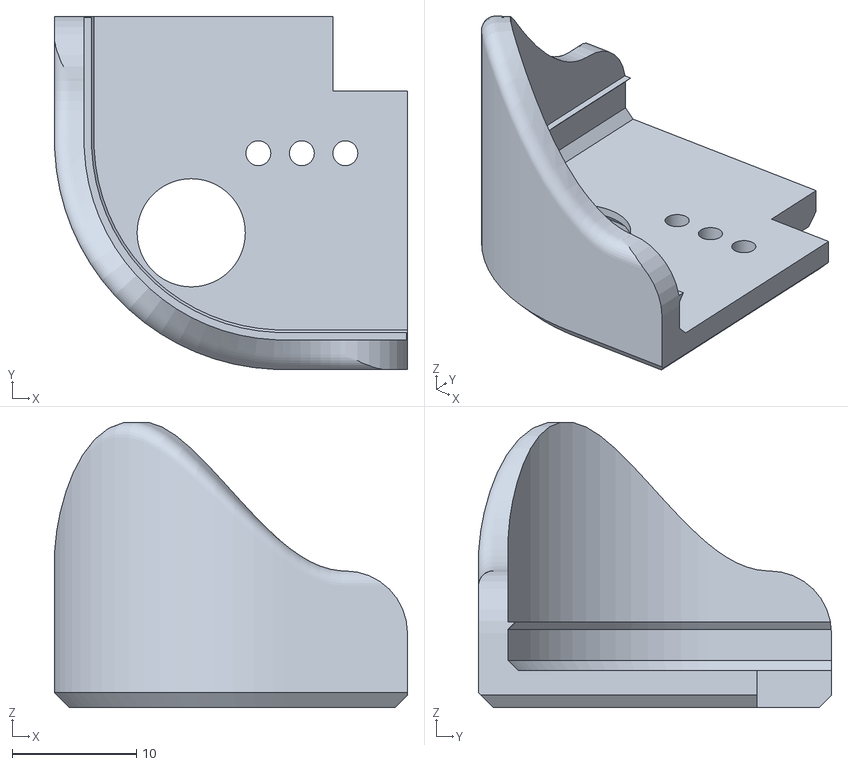
[picture p41: CAD file, 2026-11-09]
v4/out/coupon_C16_gummiecke_wulst_0-6.stl
28.4 x 28.4 x 23.0
