janshort4all/peppa-box/kartenbox/out/druck/02_deckel_orange_kopfueber.stl

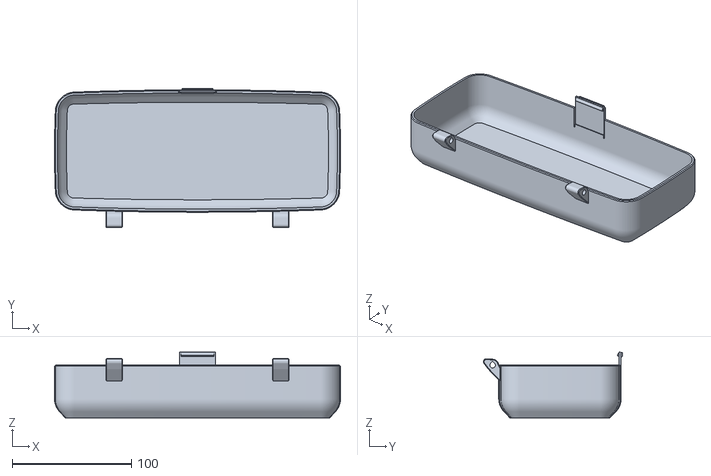
[picture p42: CAD file, 2026-11-13]
kartenbox/out/druck/02_deckel_orange_kopfueber.stl
240.3 x 117.0 x 55.3
