janshort4all/peppa-box/kartenbox/out/druck/probedruck/K2a_verschluss_basis.stl

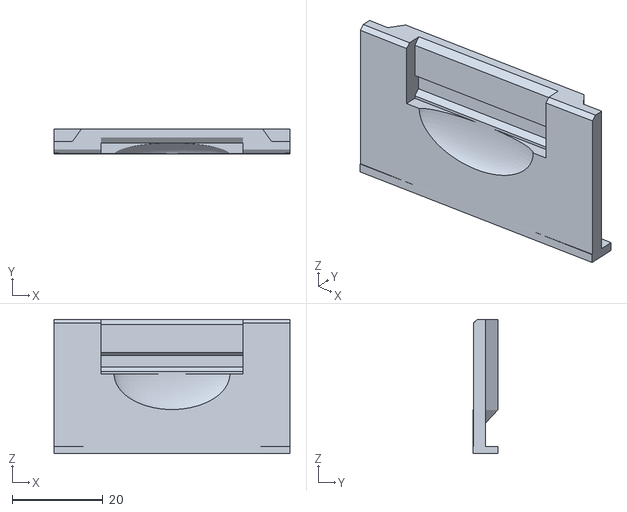
[picture p43: CAD file, 2026-11-13]
kartenbox/out/druck/probedruck/K2a_verschluss_basis.stl
52.0 x 5.40 x 29.6
