janshort4all/peppa-box/kartenbox/v1_entwurf/out/druck/02f_modifier_deckel_FUZZY.stl

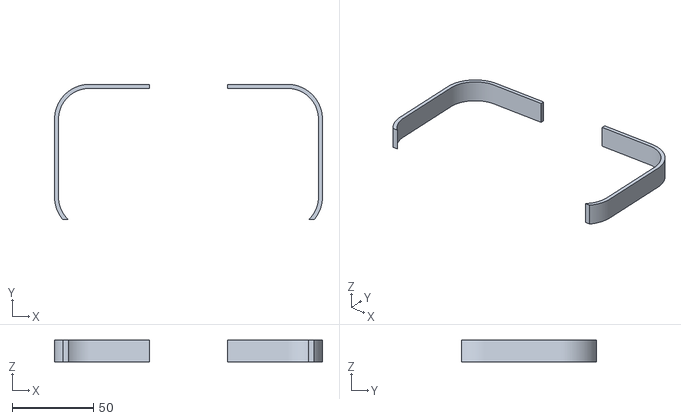
[picture p44: CAD file, 2026-11-11]
kartenbox/v1_entwurf/out/druck/02f_modifier_deckel_FUZZY.stl
165.2 x 83.4 x 13.5
