janshort4all/peppa-box/kartenbox/v1_entwurf/out/druck/probedruck/K2_rastung_basis_vorspannung0.3.stl

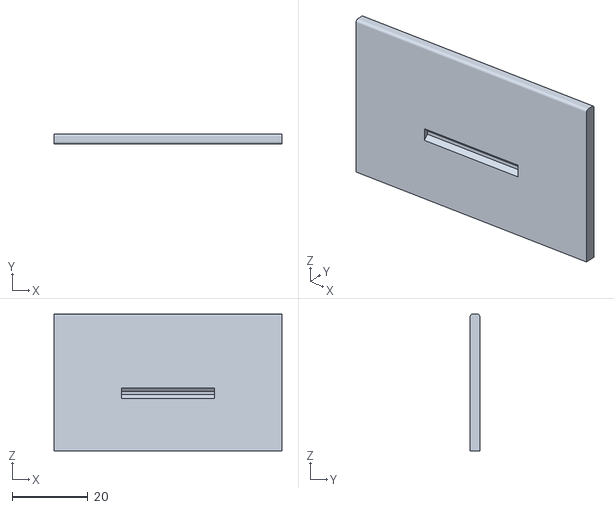
[picture p45: CAD file, 2026-11-11]
kartenbox/v1_entwurf/out/druck/probedruck/K2_rastung_basis_vorspannung0.3.stl
60.0 x 2.52 x 36.0
