janshort4all/peppa-box/kartenbox/v1_entwurf/out/kartenbox_deckel.step

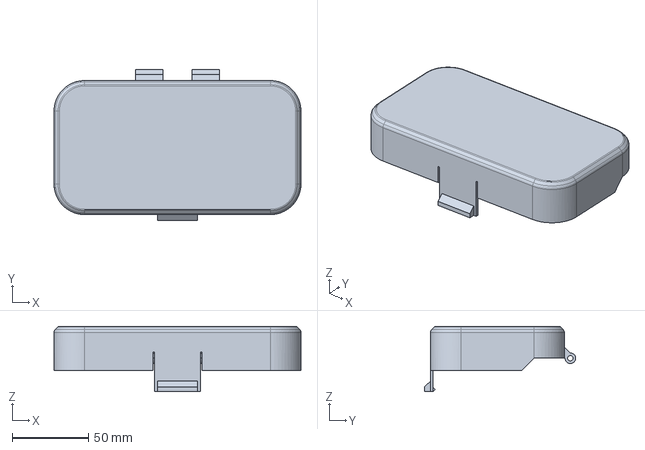
[picture p46: CAD file, 2026-11-11]
kartenbox/v1_entwurf/out/kartenbox_deckel.step
162.2 x 99.4 x 43.0 mm
