janshort4all/peppa-box/v4/out/12_gummiecke_TPU_orange.stl

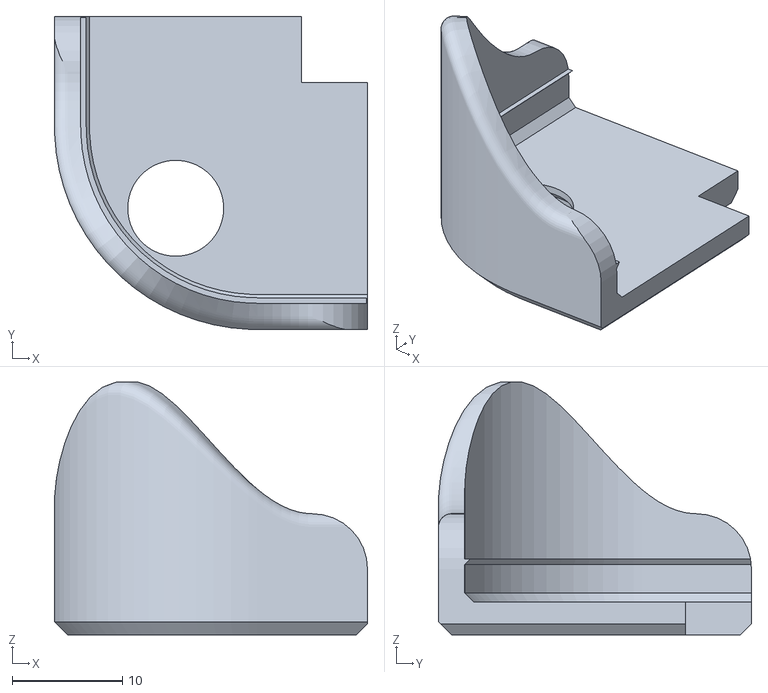
[picture p47: CAD file, 2026-11-09]
v4/out/12_gummiecke_TPU_orange.stl
28.4 x 28.4 x 23.0
