janshort4all/peppa-box/kartenbox/out/druck/03_inlay_beige.stl

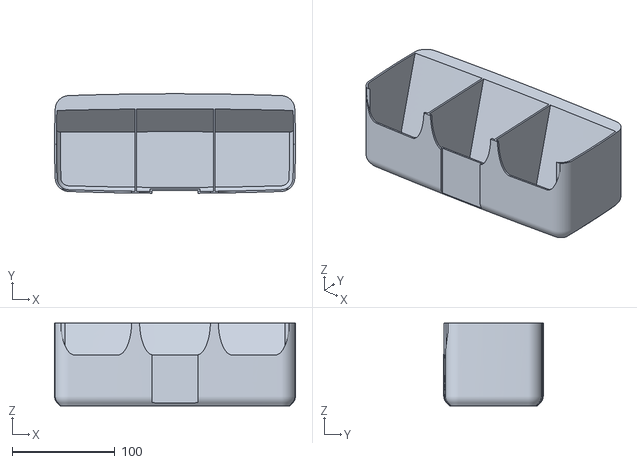
[picture p48: CAD file, 2026-11-13]
kartenbox/out/druck/03_inlay_beige.stl
234.6 x 96.9 x 80.5
