janshort4all/peppa-box/kartenbox/out/druck/probedruck/K2b_verschluss_deckel_kopfueber.stl

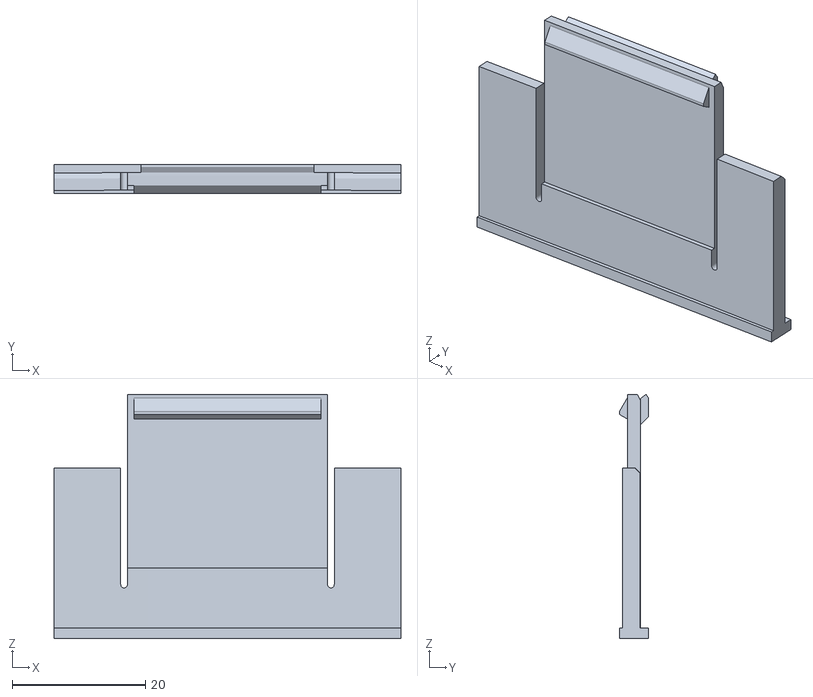
[picture p49: CAD file, 2026-11-13]
kartenbox/out/druck/probedruck/K2b_verschluss_deckel_kopfueber.stl
52.0 x 4.40 x 36.6
