janshort4all/peppa-box/kartenbox/v1_entwurf/out/kartenbox_zusammenbau.step

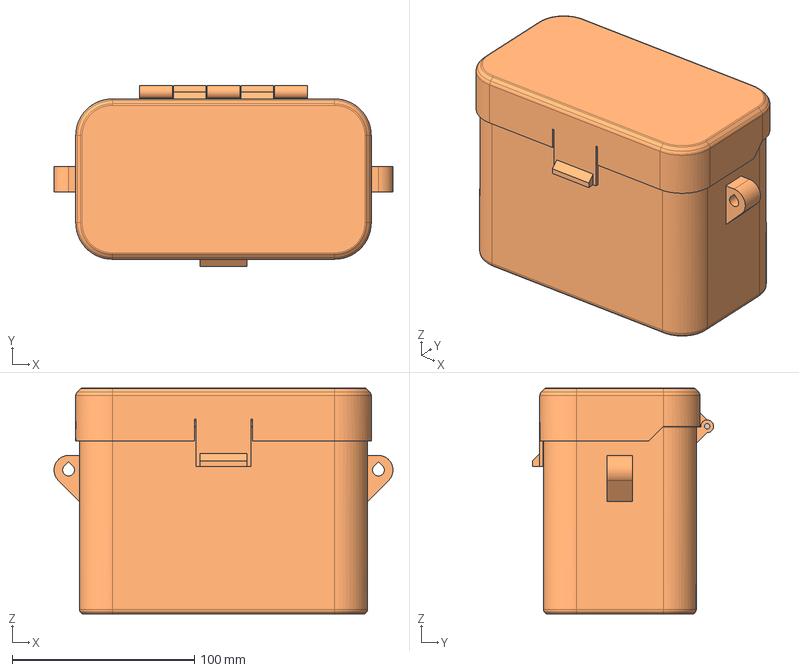
[picture p50: CAD file, 2026-11-11]
kartenbox/v1_entwurf/out/kartenbox_zusammenbau.step
186.0 x 99.4 x 124.0 mm
basis
deckel
inlay
stahlstift
