janshort4all/peppa-box/kartenbox/out/druck/02f_modifier_deckel_FUZZY.stl

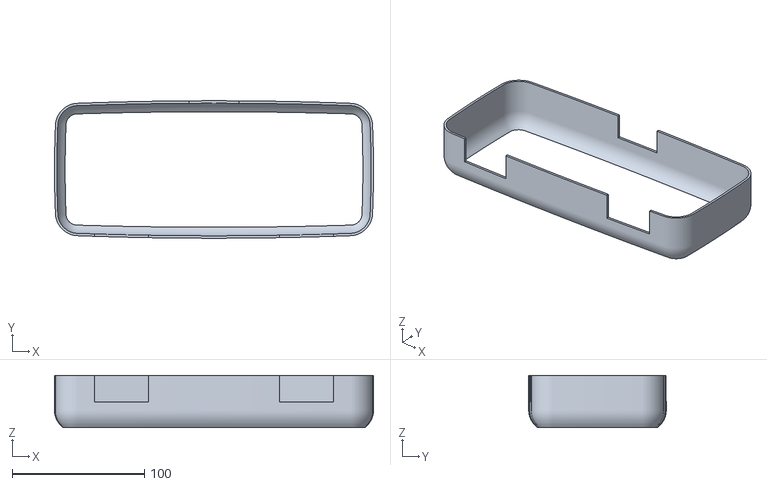
[picture p51: CAD file, 2026-11-13]
kartenbox/out/druck/02f_modifier_deckel_FUZZY.stl
241.5 x 104.1 x 39.7
