janshort4all/peppa-box/kartenbox/v1_entwurf/out/druck/01_basis_orange.stl

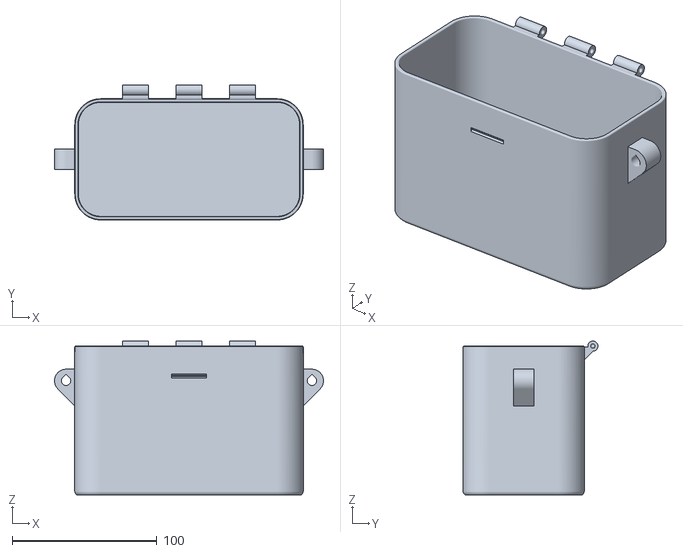
[picture p53: CAD file, 2026-11-11]
kartenbox/v1_entwurf/out/druck/01_basis_orange.stl
186.0 x 93.3 x 106.5
