janshort4all/peppa-box/v4/out/ansicht_zusammenbau_NICHT_DRUCKEN.stl

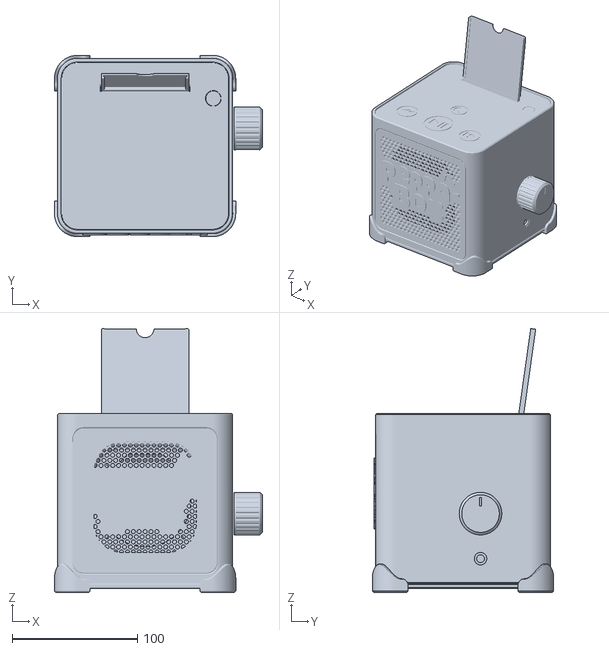
[picture p54: CAD file, 2026-11-09]
v4/out/ansicht_zusammenbau_NICHT_DRUCKEN.stl
166.2 x 144.8 x 210.8
