janshort4all/peppa-box/kartenbox/out/druck/04_stift_3x_beige.stl

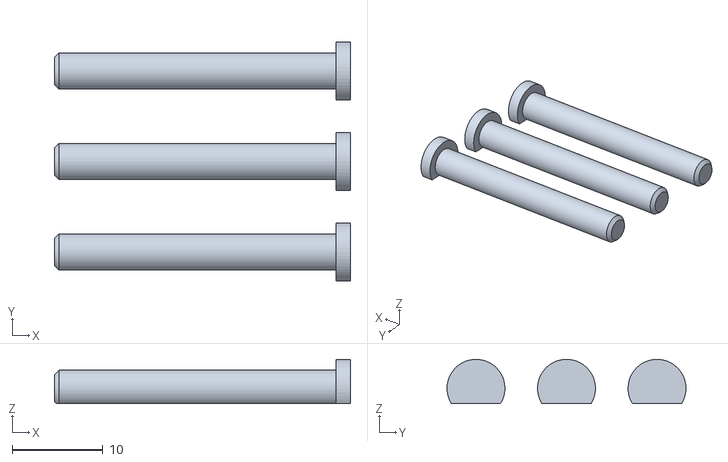
[picture p55: CAD file, 2026-11-13]
kartenbox/out/druck/04_stift_3x_beige.stl
32.7 x 26.4 x 4.90
