janshort4all/peppa-box/kartenbox/out/druck/probedruck/K3c_passung_deckel_MODIFIER_FUZZY.stl

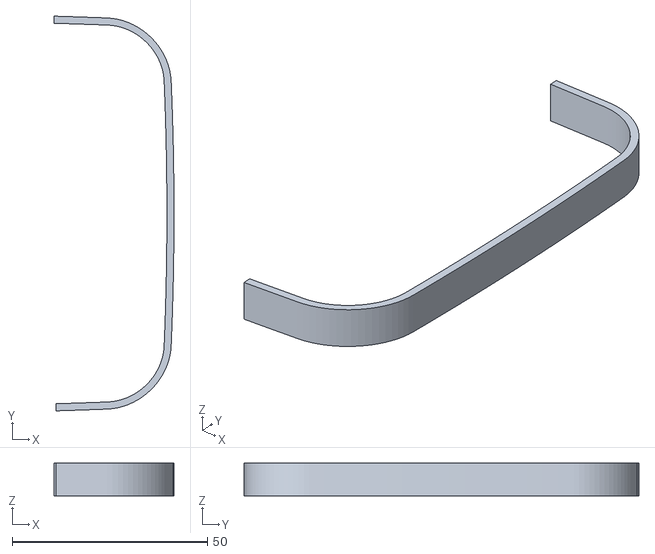
[picture p56: CAD file, 2026-11-13]
kartenbox/out/druck/probedruck/K3c_passung_deckel_MODIFIER_FUZZY.stl
30.8 x 101.2 x 8.40
