janshort4all/peppa-box/kartenbox/v1_entwurf/out/druck/01f_modifier_basis_FUZZY.stl

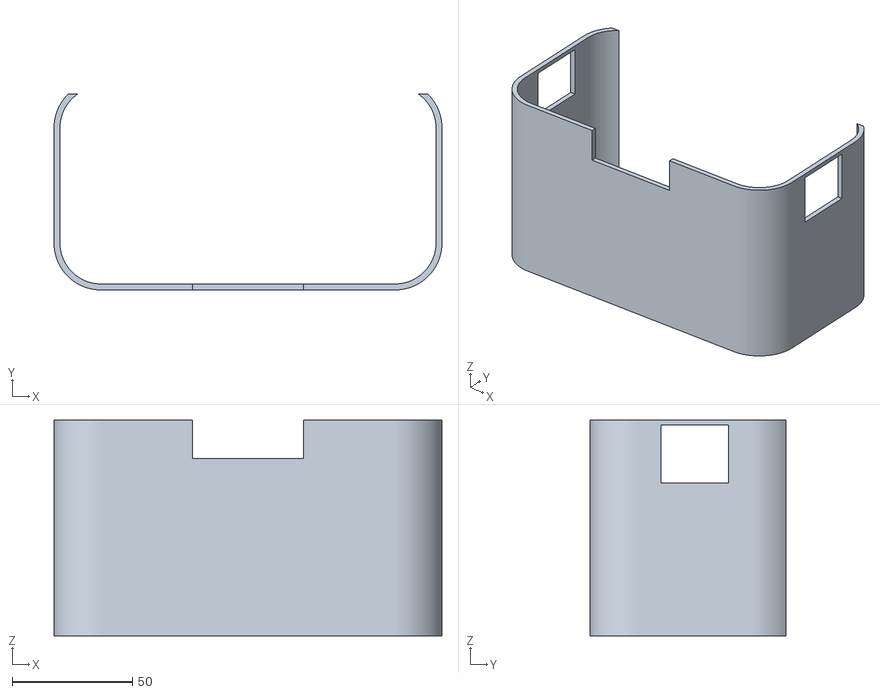
[picture p57: CAD file, 2026-11-11]
kartenbox/v1_entwurf/out/druck/01f_modifier_basis_FUZZY.stl
161.0 x 81.3 x 89.5
