janshort4all/peppa-box/kartenbox/v1_entwurf/out/druck/probedruck/K2_rastung_deckel_kopfueber.stl

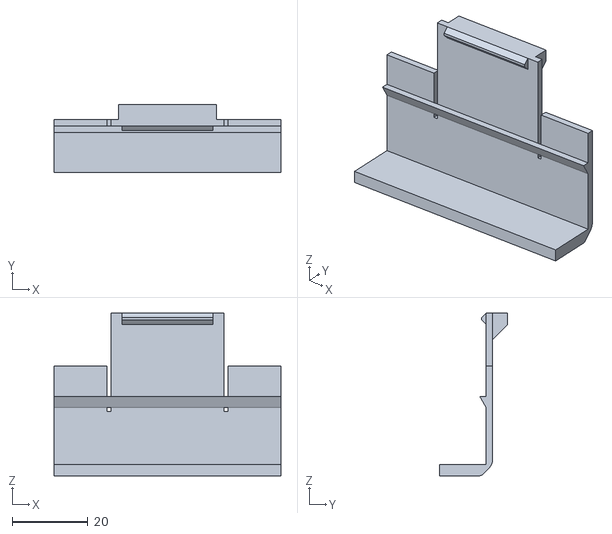
[picture p58: CAD file, 2026-11-11]
kartenbox/v1_entwurf/out/druck/probedruck/K2_rastung_deckel_kopfueber.stl
60.0 x 18.1 x 43.0
