janshort4all/peppa-box/v4/out/13_eckhuelse_PETG.stl

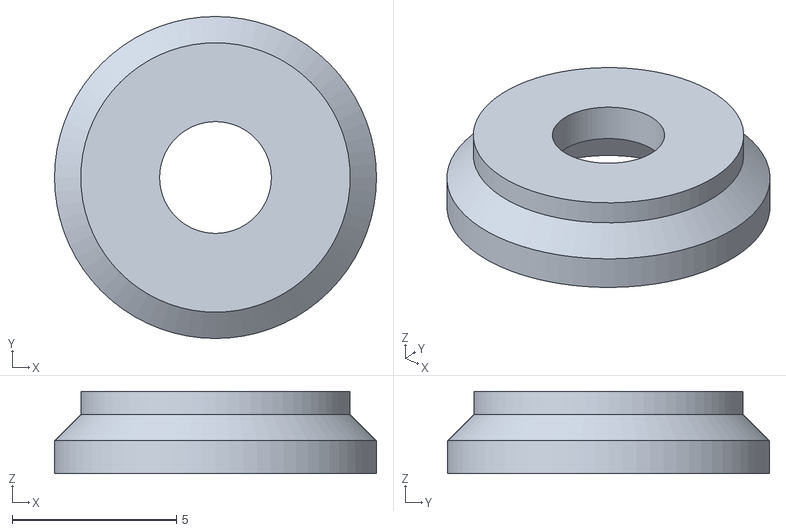
[picture p59: CAD file, 2026-11-09]
v4/out/13_eckhuelse_PETG.stl
9.80 x 9.80 x 2.50
