janshort4all/peppa-box/kartenbox/out/druck/01_basis_orange.stl

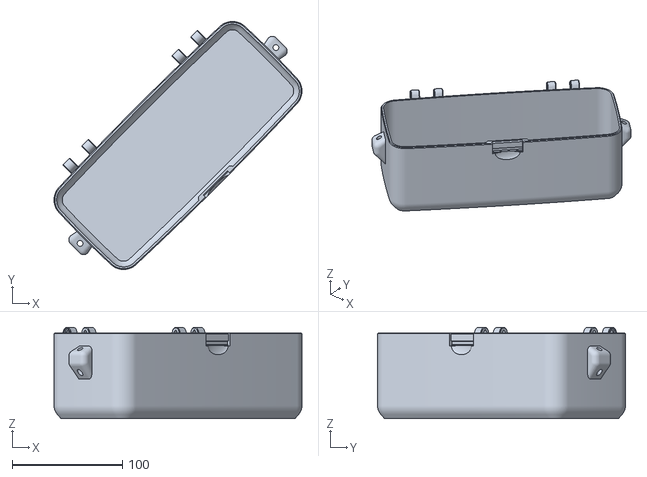
[picture p60: CAD file, 2026-11-13]
kartenbox/out/druck/01_basis_orange.stl
225.2 x 225.2 x 83.0
