janshort4all/peppa-box/kartenbox/out/druck/probedruck/K3b_passung_inlay.stl

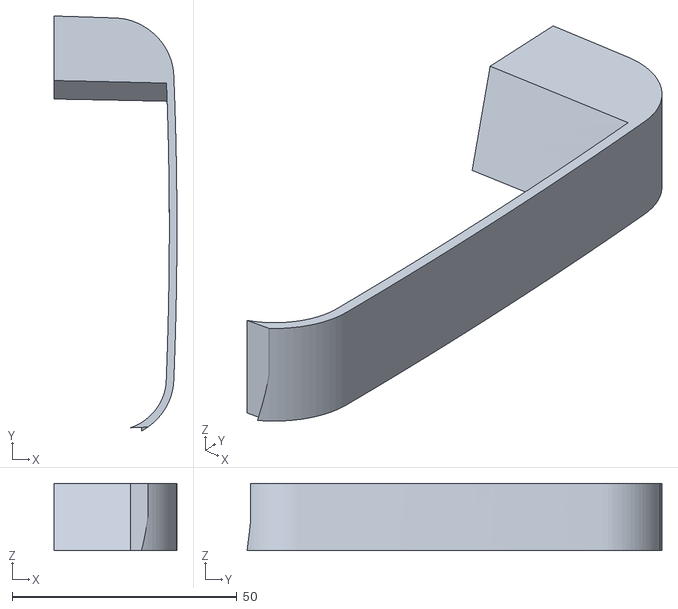
[picture p61: CAD file, 2026-11-13]
kartenbox/out/druck/probedruck/K3b_passung_inlay.stl
27.3 x 92.3 x 15.0
