janshort4all/peppa-box/kartenbox/v1_entwurf/out/04_stahlstift_3x90_ATTRAPPE_NICHT_DRUCKEN.stl

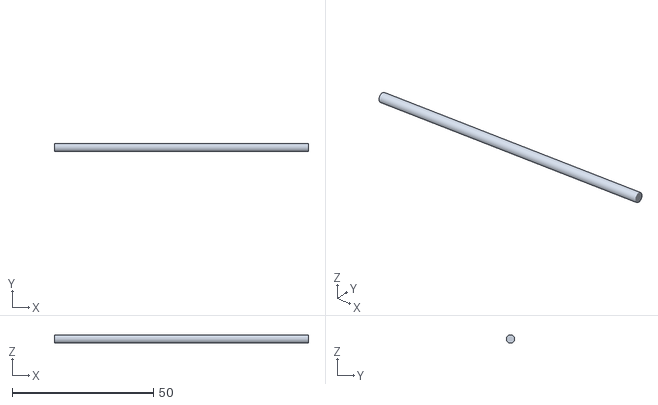
[picture p62: CAD file, 2026-11-11]
kartenbox/v1_entwurf/out/04_stahlstift_3x90_ATTRAPPE_NICHT_DRUCKEN.stl
90.0 x 3.00 x 3.00
