janshort4all/peppa-box/v4/out/06a_gitter_beige.stl

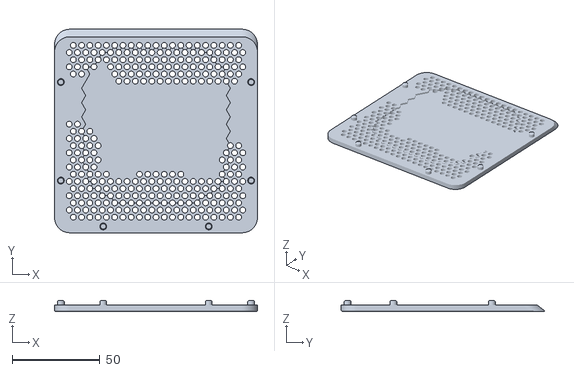
[picture p63: CAD file, 2026-11-07]
v4/out/06a_gitter_beige.stl
115.4 x 115.7 x 6.00
