janshort4all/peppa-box/kartenbox/v1_entwurf/out/druck/probedruck/K1C_scharnier_basis_bohrung3.1.stl

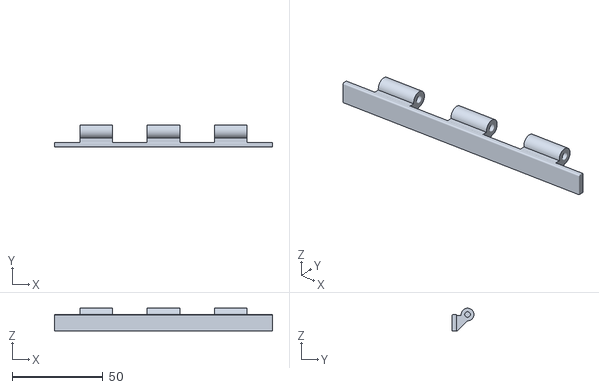
[picture p64: CAD file, 2026-11-11]
kartenbox/v1_entwurf/out/druck/probedruck/K1C_scharnier_basis_bohrung3.1.stl
120.0 x 12.0 x 12.5
