janshort4all/peppa-box/v4/out/coupon_C14_gitter_ecke_beige.stl

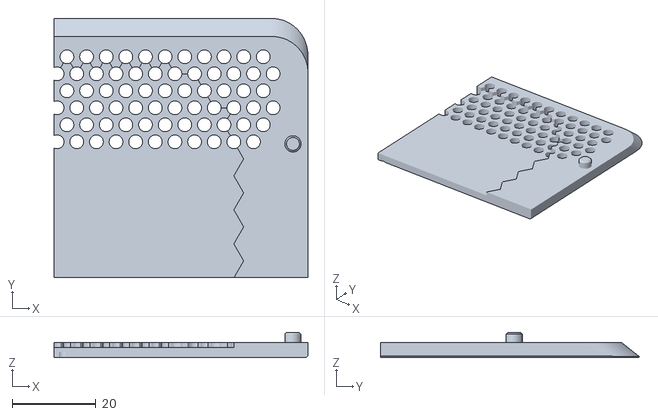
[picture p65: CAD file, 2026-11-07]
v4/out/coupon_C14_gitter_ecke_beige.stl
60.8 x 62.0 x 6.00
