janshort4all/peppa-box/kartenbox/out/druck/probedruck/K1a_scharnier_basis.stl

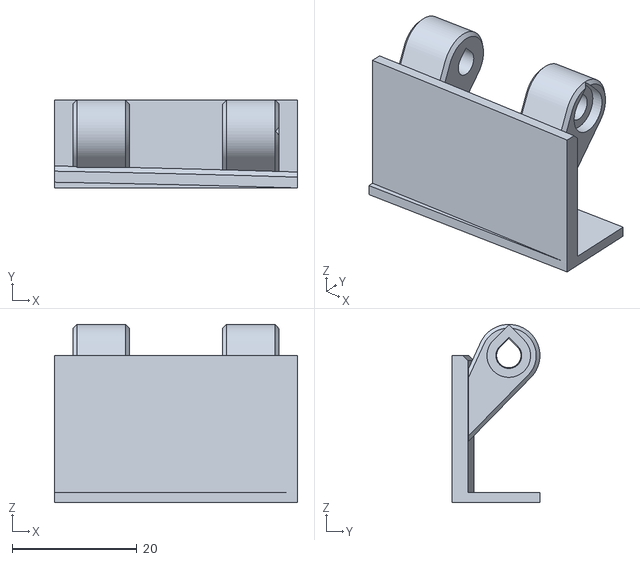
[picture p66: CAD file, 2026-11-13]
kartenbox/out/druck/probedruck/K1a_scharnier_basis.stl
39.0 x 14.1 x 28.6
