janshort4all/peppa-box/v4/out/11_niederhalter_stiftleiste.stl

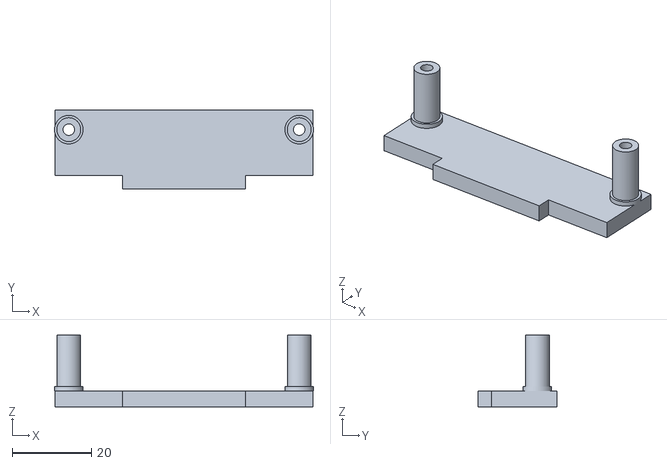
[picture p67: CAD file, 2026-11-07]
v4/out/11_niederhalter_stiftleiste.stl
65.2 x 20.0 x 18.0
