janshort4all/peppa-box/kartenbox/out/druck/probedruck/K1b_scharnier_deckel_kopfueber.stl

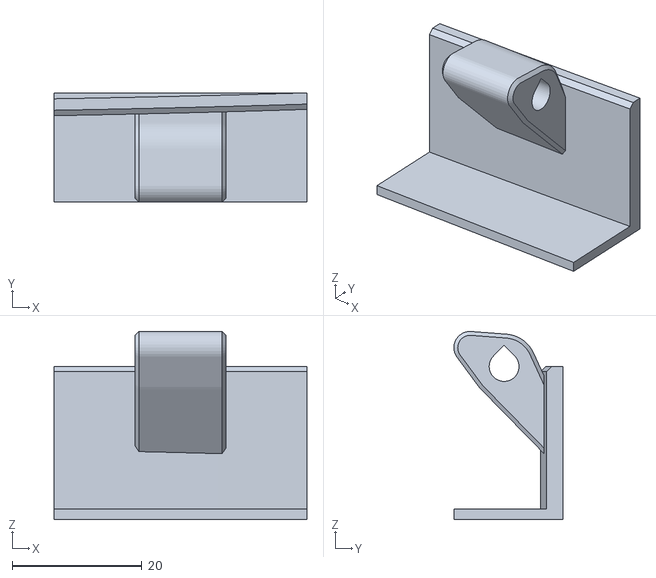
[picture p68: CAD file, 2026-11-13]
kartenbox/out/druck/probedruck/K1b_scharnier_deckel_kopfueber.stl
39.0 x 16.9 x 29.0
