janshort4all/peppa-box/kartenbox/v1_entwurf/out/druck/probedruck/K1A_scharnier_basis_bohrung2.9.stl

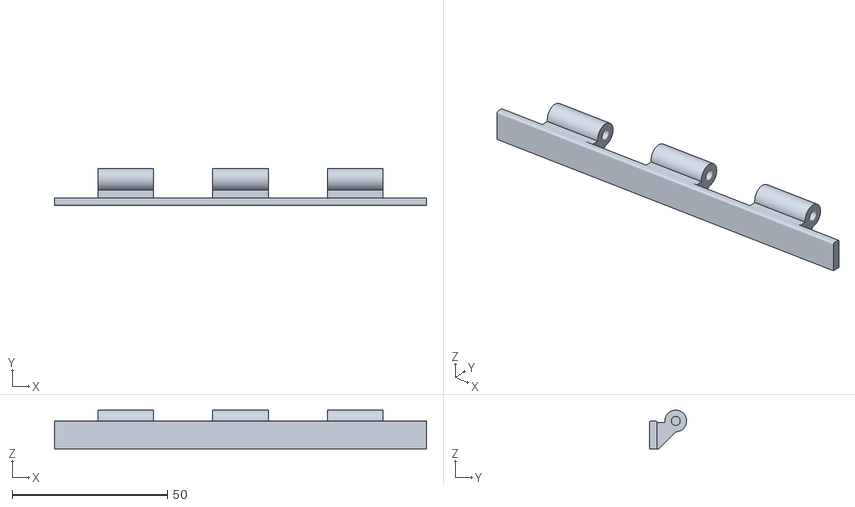
[picture p69: CAD file, 2026-11-11]
kartenbox/v1_entwurf/out/druck/probedruck/K1A_scharnier_basis_bohrung2.9.stl
120.0 x 12.0 x 12.5
