janshort4all/peppa-box/v4/out/04_kartenfach.stl

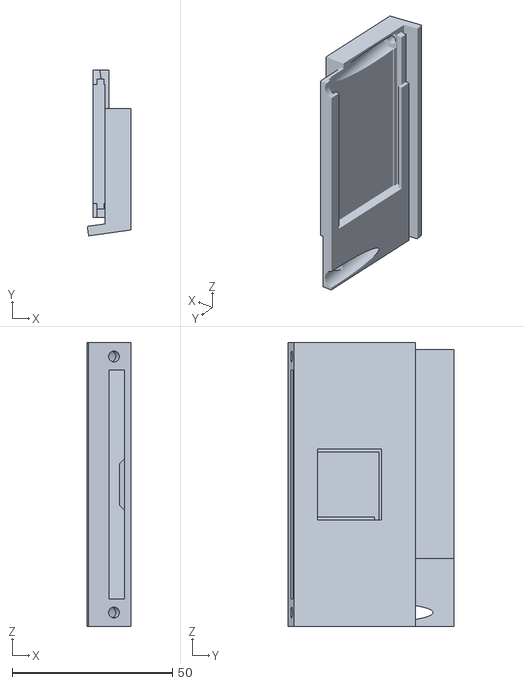
[picture p70: CAD file, 2026-11-07]
v4/out/04_kartenfach.stl
13.6 x 51.7 x 88.5
