janshort4all/peppa-box/v4/out/ansicht_bauteile_platzhalter_NICHT_DRUCKEN.stl

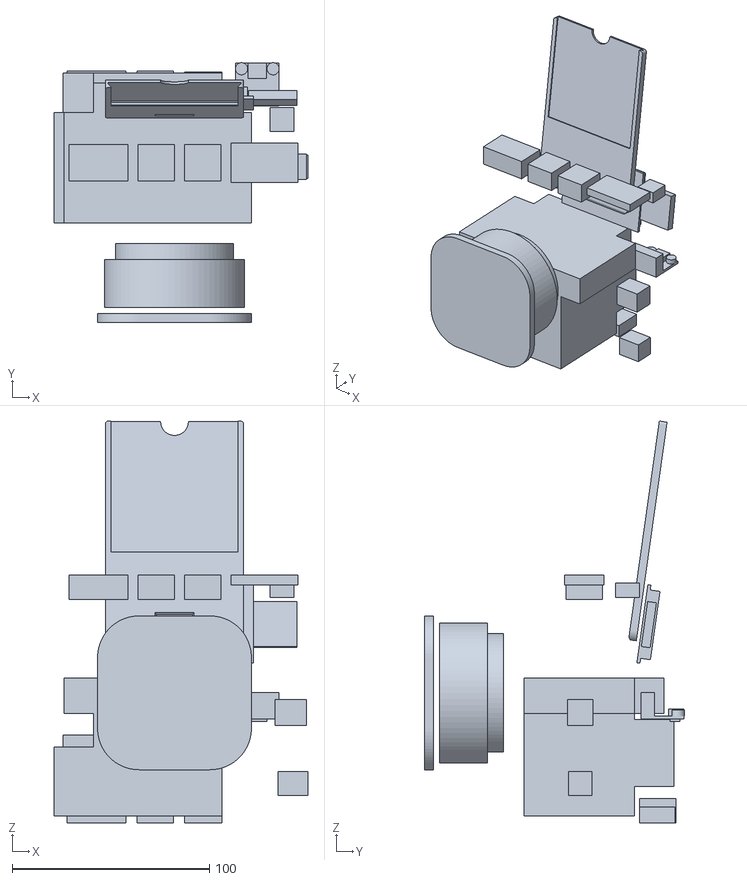
[picture p71: CAD file, 2026-11-07]
v4/out/ansicht_bauteile_platzhalter_NICHT_DRUCKEN.stl
128.6 x 131.7 x 203.8
