janshort4all/peppa-box/v4/out/coupon_C15_karte_rastung_20grad.stl

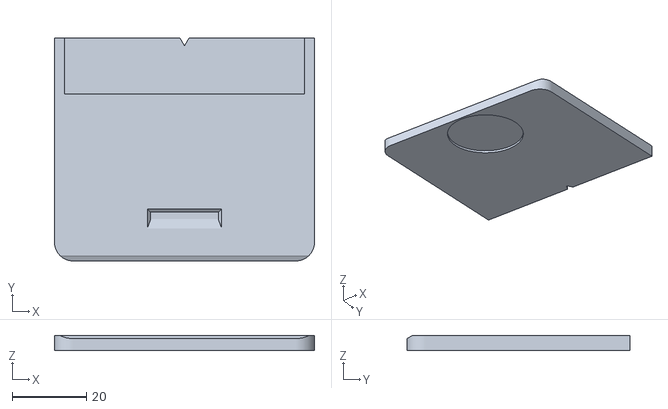
[picture p72: CAD file, 2026-11-07]
v4/out/coupon_C15_karte_rastung_20grad.stl
70.0 x 60.0 x 4.00
