janshort4all/peppa-box/v4/out/10_karte_orange.stl

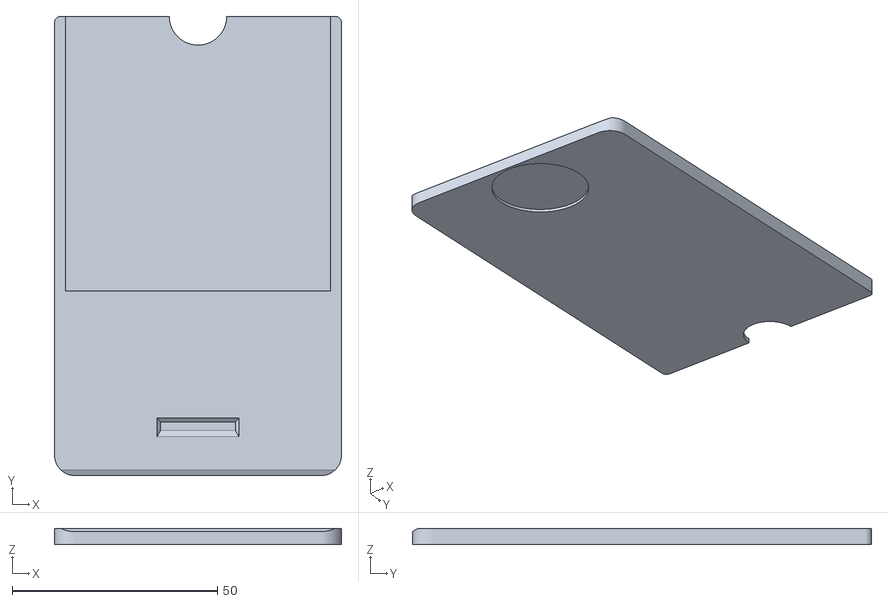
[picture p73: CAD file, 2026-11-07]
v4/out/10_karte_orange.stl
70.0 x 112.0 x 4.00
