janshort4all/peppa-box/v4/out/coupon_C14_buchstaben_P_e_p_orange.stl

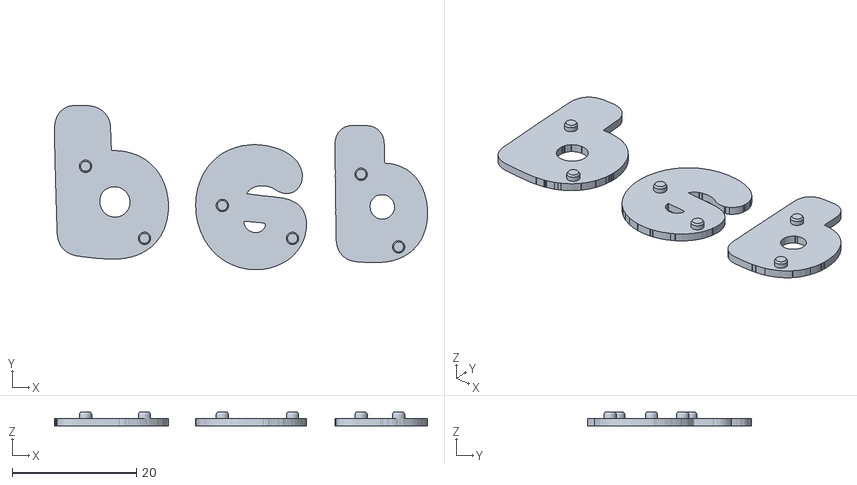
[picture p74: CAD file, 2026-11-06]
v4/out/coupon_C14_buchstaben_P_e_p_orange.stl
60.1 x 26.5 x 2.20
