janshort4all/peppa-box/v4/out/06b_logo_buchstaben_orange.stl

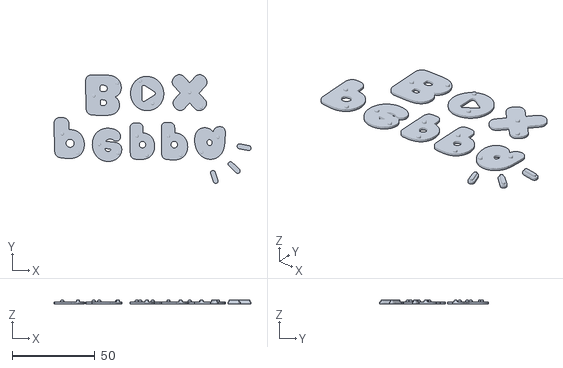
[picture p75: CAD file, 2026-11-06]
v4/out/06b_logo_buchstaben_orange.stl
119.1 x 65.7 x 2.20
