janshort4all/peppa-box/v4/out/05f_modifier_boden_FUZZY_rand.stl

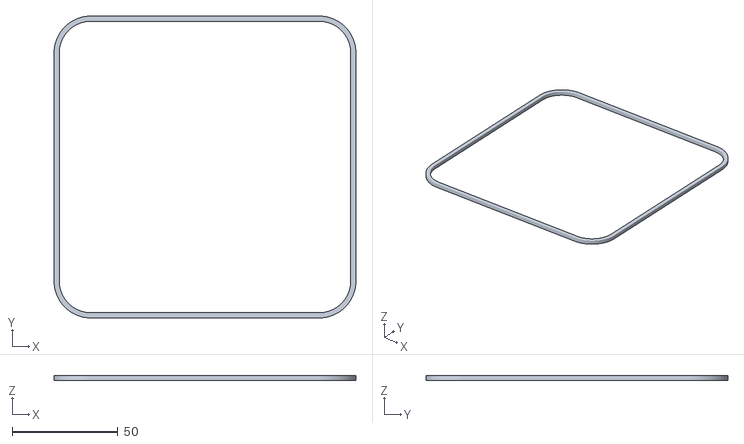
[picture p76: CAD file, 2026-11-06]
v4/out/05f_modifier_boden_FUZZY_rand.stl
143.0 x 143.0 x 2.40
