janshort4all/peppa-box/v4/out/07_drehknopf_orange.stl

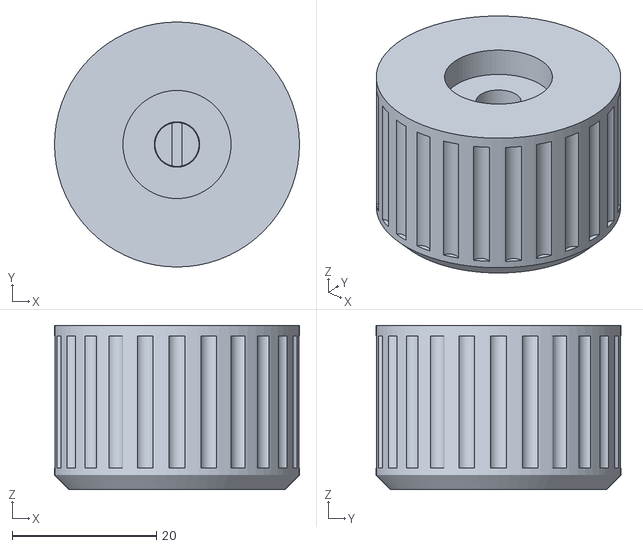
[picture p77: CAD file, 2026-11-05]
v4/out/07_drehknopf_orange.stl
34.0 x 34.0 x 22.8
