janshort4all/peppa-box/v4/out/coupon_C12_deckel_oberseite_opfer_PLA.stl

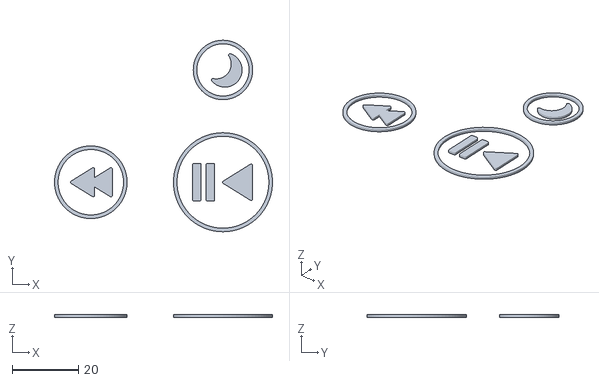
[picture p78: CAD file, 2026-11-05]
v4/out/coupon_C12_deckel_oberseite_opfer_PLA.stl
66.0 x 58.0 x 0.8
