janshort4all/peppa-box/v4/out/02r_modifier_deckel_bruecke_richtung.stl

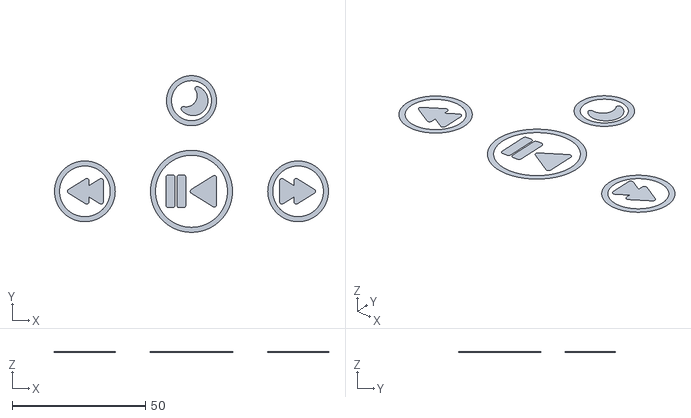
[picture p79: CAD file, 2026-11-05]
v4/out/02r_modifier_deckel_bruecke_richtung.stl
102.8 x 58.8 x 0.16
