janshort4all/peppa-box/v4/out/coupon_C12_deckel_oberseite_MODIFIER_bruecke_richtung.stl

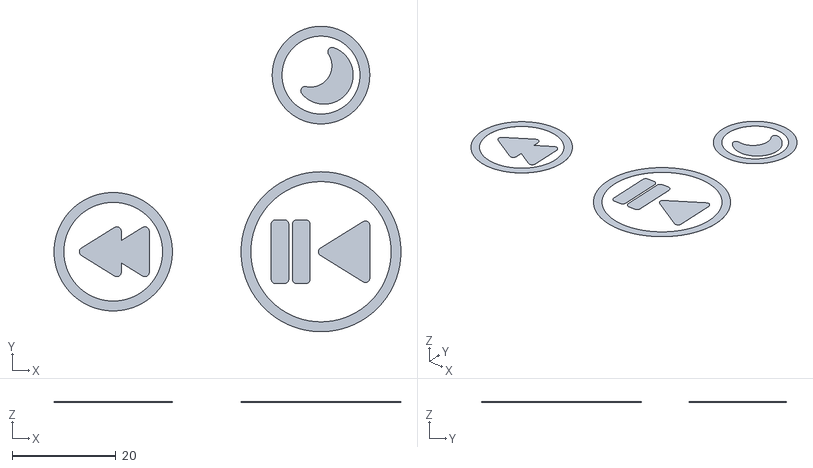
[picture p80: CAD file, 2026-11-05]
v4/out/coupon_C12_deckel_oberseite_MODIFIER_bruecke_richtung.stl
66.8 x 58.8 x 0.16
