janshort4all/peppa-box/v4/out/02p_opfer_einleger_PLA.stl

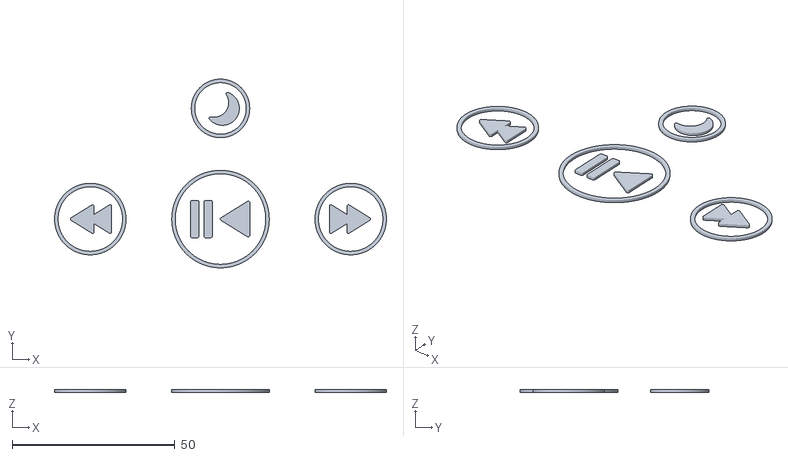
[picture p81: CAD file, 2026-11-05]
v4/out/02p_opfer_einleger_PLA.stl
102.0 x 58.0 x 0.8
