janshort4all/peppa-box/v4/out/coupon_C12_deckel_oberseite_MODIFIER_haut_1wand.stl

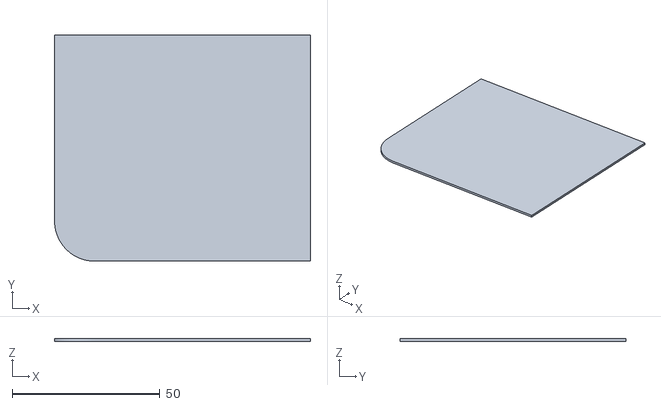
[picture p82: CAD file, 2026-11-05]
v4/out/coupon_C12_deckel_oberseite_MODIFIER_haut_1wand.stl
86.6 x 76.6 x 0.85
