janshort4all/peppa-box/v4/out/02m_modifier_deckel_haut_1wand.stl

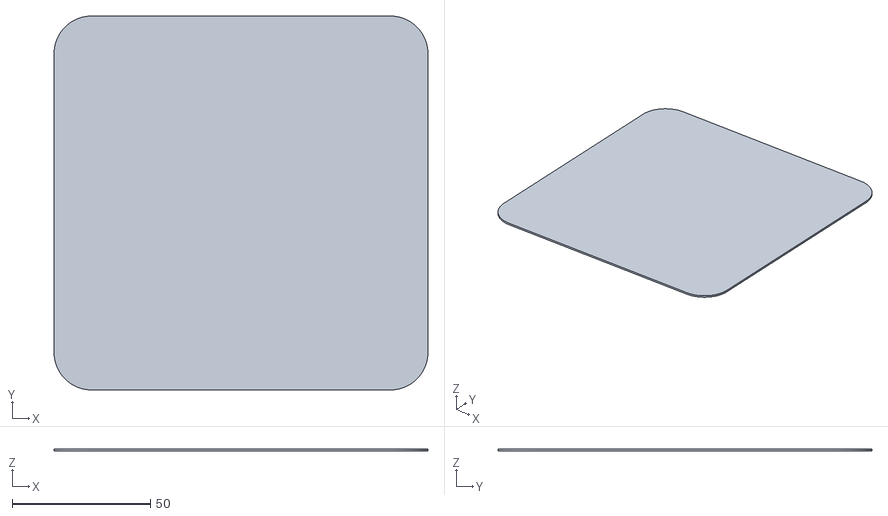
[picture p83: CAD file, 2026-11-05]
v4/out/02m_modifier_deckel_haut_1wand.stl
135.2 x 135.2 x 0.85
