janshort4all/peppa-box/v4/out/coupon_C9_deckel_kopfueber_felder.stl

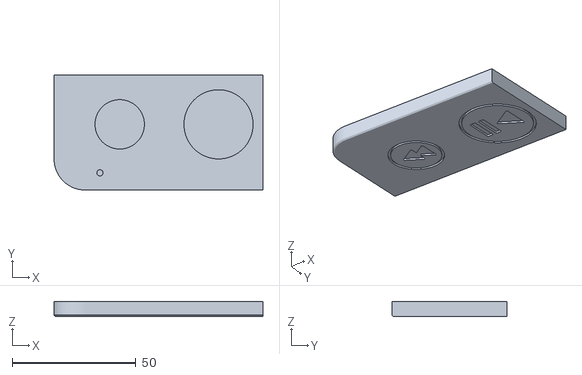
[picture p84: CAD file, 2026-11-05]
v4/out/coupon_C9_deckel_kopfueber_felder.stl
84.6 x 46.6 x 6.00
