janshort4all/peppa-box/v4/out/coupon_C12_deckel_oberseite_kern_orange.stl

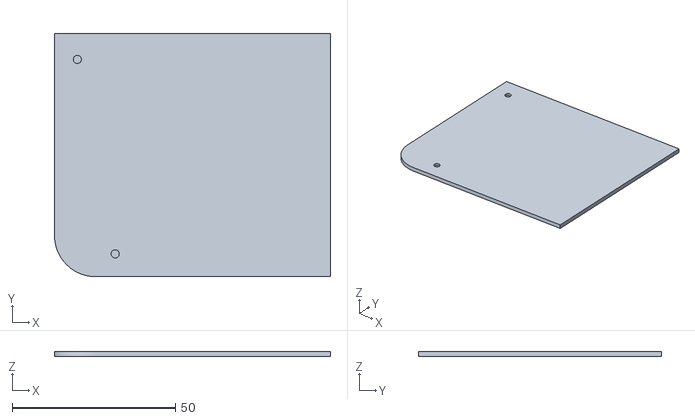
[picture p85: CAD file, 2026-11-05]
v4/out/coupon_C12_deckel_oberseite_kern_orange.stl
84.6 x 74.6 x 1.60
