janshort4all/peppa-box/v4/out/coupon_C12_deckel_oberseite_haut_beige.stl

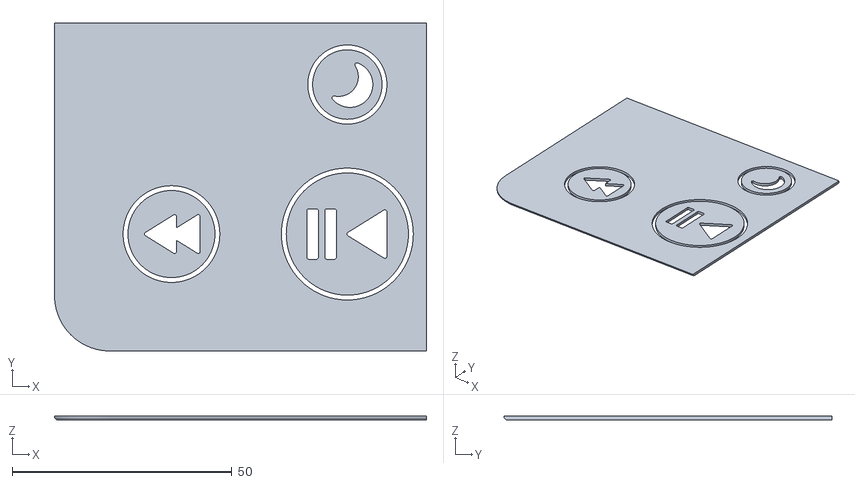
[picture p86: CAD file, 2026-11-05]
v4/out/coupon_C12_deckel_oberseite_haut_beige.stl
84.6 x 74.6 x 0.8
