janshort4all/peppa-box/v4/out/coupon_C9_deckel_kopfueber_taste_schlitz.stl

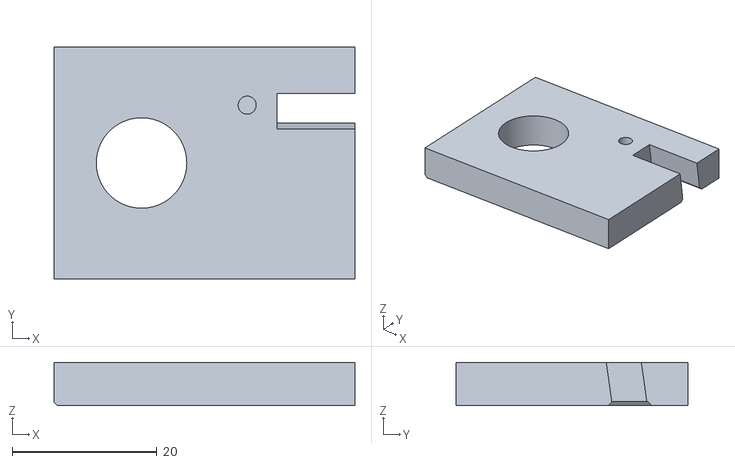
[picture p87: CAD file, 2026-11-05]
v4/out/coupon_C9_deckel_kopfueber_taste_schlitz.stl
41.6 x 32.0 x 6.00
