janshort4all/peppa-box/v4/out/02a_deckel_kern_orange.stl

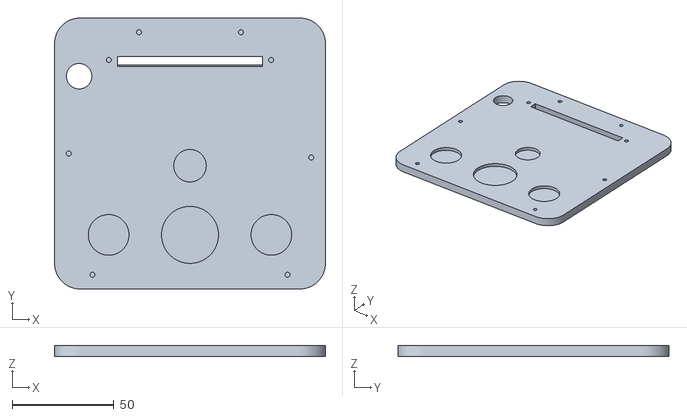
[picture p88: CAD file, 2026-11-05]
v4/out/02a_deckel_kern_orange.stl
133.2 x 133.2 x 5.20
