janshort4all/peppa-box/v4/out/02b_deckel_haut_beige.stl

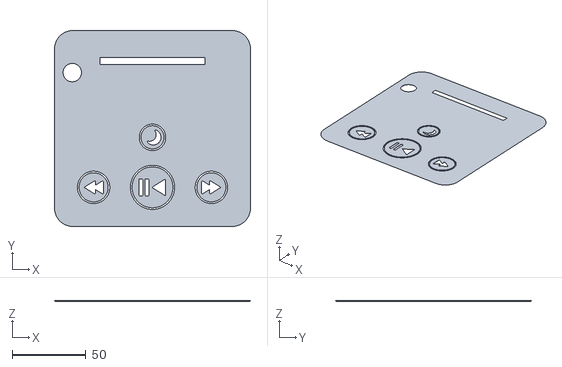
[picture p89: CAD file, 2026-11-05]
v4/out/02b_deckel_haut_beige.stl
133.2 x 133.2 x 0.8
