janshort4all/peppa-box/v4/out/coupon_C11_korpus_oben.stl

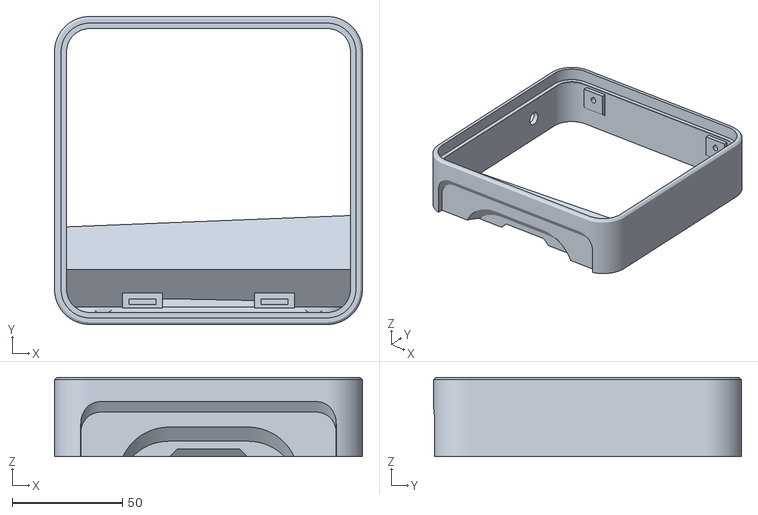
[picture p90: CAD file, 2026-11-04]
v4/out/coupon_C11_korpus_oben.stl
140.0 x 140.0 x 36.0
