janshort4all/peppa-box/v4/out/coupon_C1_wand_rechts_drehgeber_klinke.stl

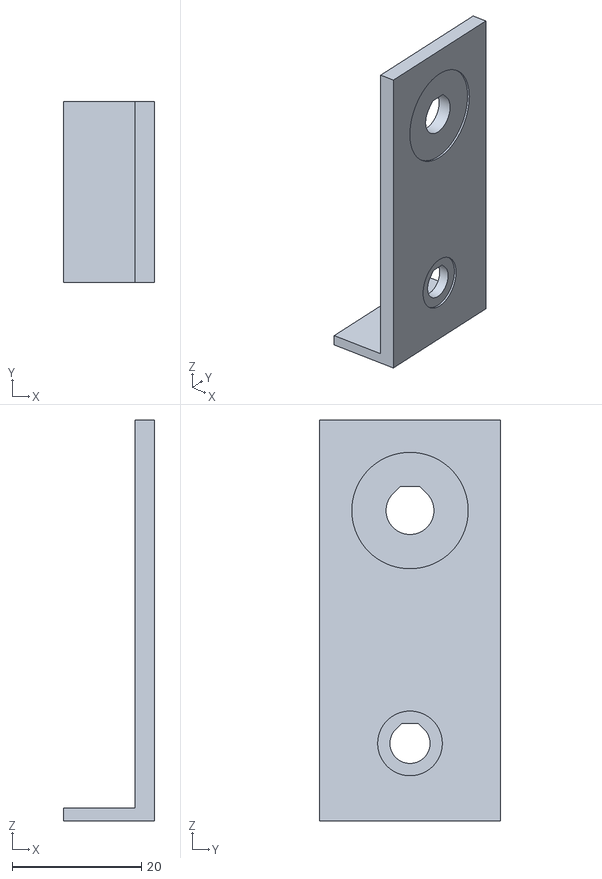
[picture p91: CAD file, 2026-11-04]
v4/out/coupon_C1_wand_rechts_drehgeber_klinke.stl
14.0 x 28.0 x 62.0
