janshort4all/peppa-box/v4/out/coupon_C2_deckelecke_korpus.stl

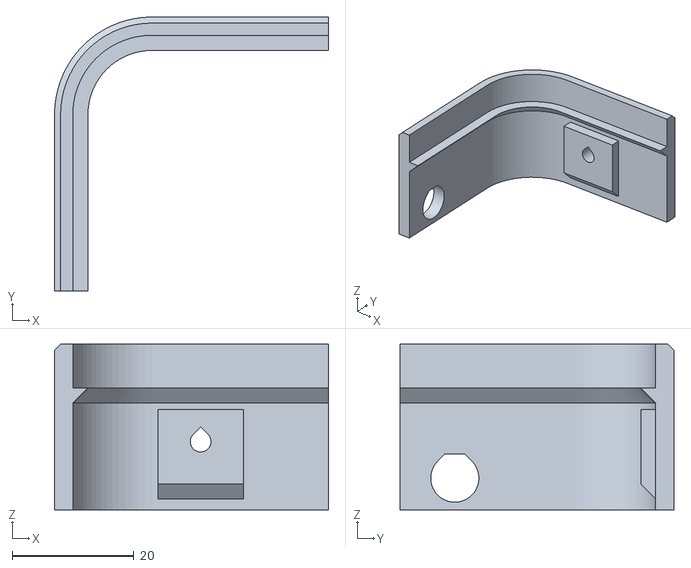
[picture p92: CAD file, 2026-11-04]
v4/out/coupon_C2_deckelecke_korpus.stl
45.0 x 45.0 x 27.2
