janshort4all/peppa-box/v4/out/01_korpus_beige.stl

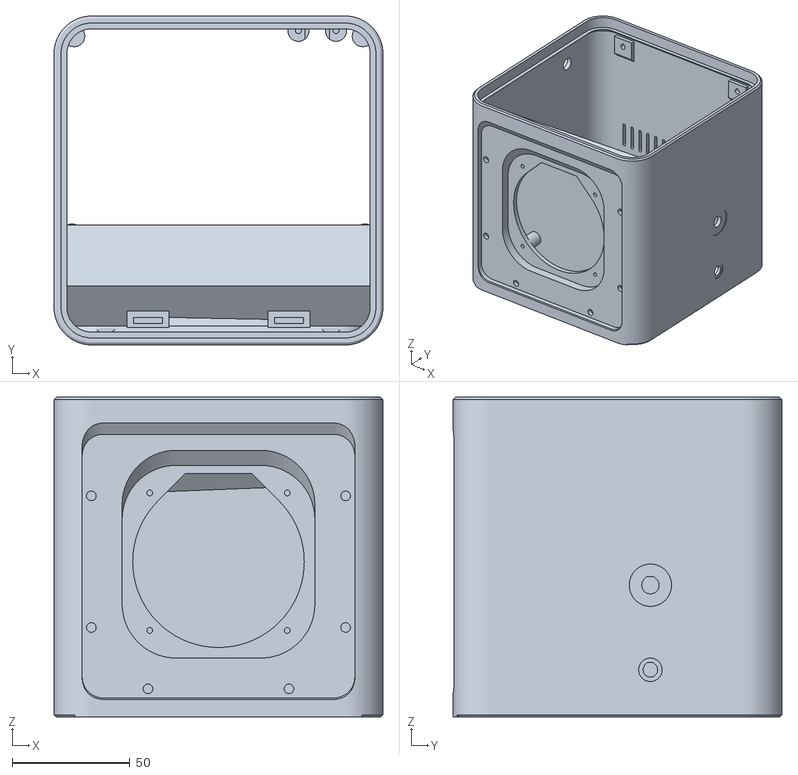
[picture p93: CAD file, 2026-11-04]
v4/out/01_korpus_beige.stl
140.0 x 140.0 x 136.0
