janshort4all/peppa-box/v4/out/coupon_C10_fuzzy_ecke.stl

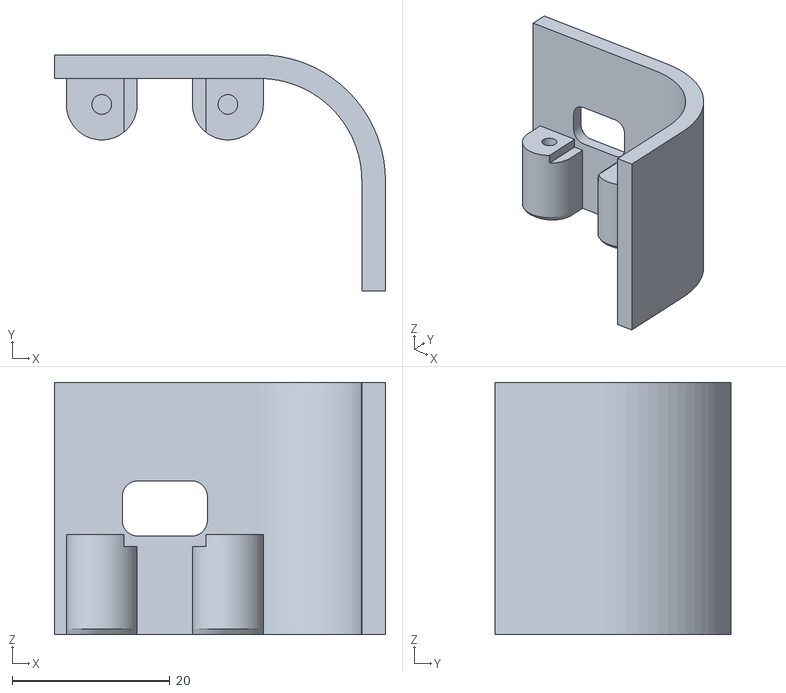
[picture p94: CAD file, 2026-11-04]
v4/out/coupon_C10_fuzzy_ecke.stl
42.0 x 30.0 x 32.0
