janshort4all/peppa-box/v4/out/coupon_C1_wand_hinten_usbc.stl

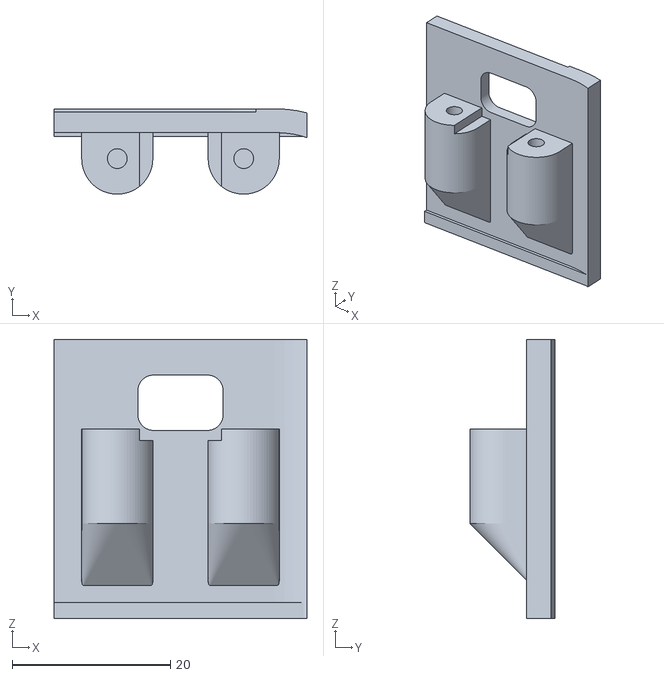
[picture p95: CAD file, 2026-11-04]
v4/out/coupon_C1_wand_hinten_usbc.stl
32.0 x 10.8 x 35.3
