janshort4all/peppa-box/v4/out/coupon_C10_fuzzy_ecke_MODIFIER_fuzzy_aussenhaut.stl

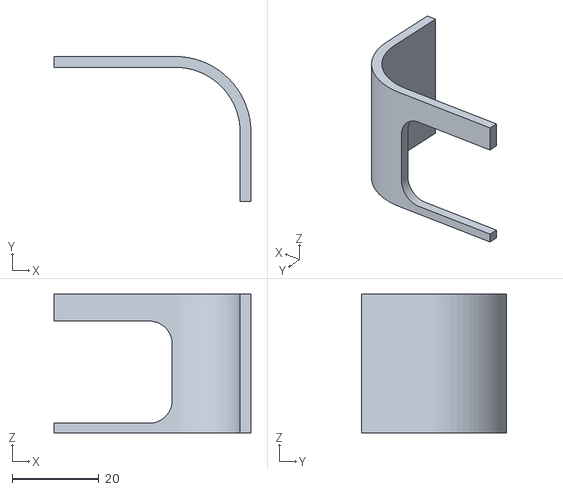
[picture p96: CAD file, 2026-11-04]
v4/out/coupon_C10_fuzzy_ecke_MODIFIER_fuzzy_aussenhaut.stl
45.5 x 33.5 x 32.0
