janshort4all/peppa-box/v4/out/coupon_C11_korpus_oben_MODIFIER_fuzzy_aussenhaut.stl

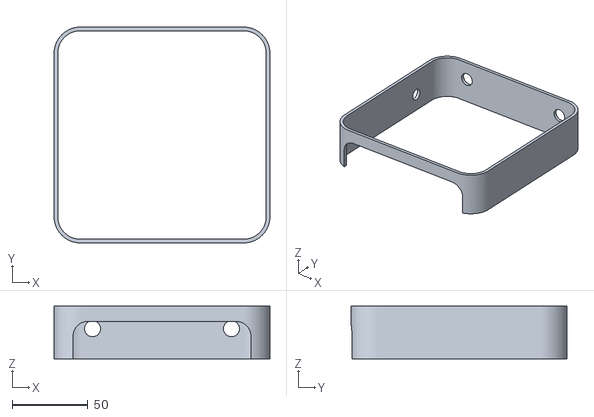
[picture p97: CAD file, 2026-11-04]
v4/out/coupon_C11_korpus_oben_MODIFIER_fuzzy_aussenhaut.stl
143.0 x 143.0 x 35.0
