janshort4all/peppa-box/v4/out/01f_modifier_korpus_FUZZY_aussenhaut.stl

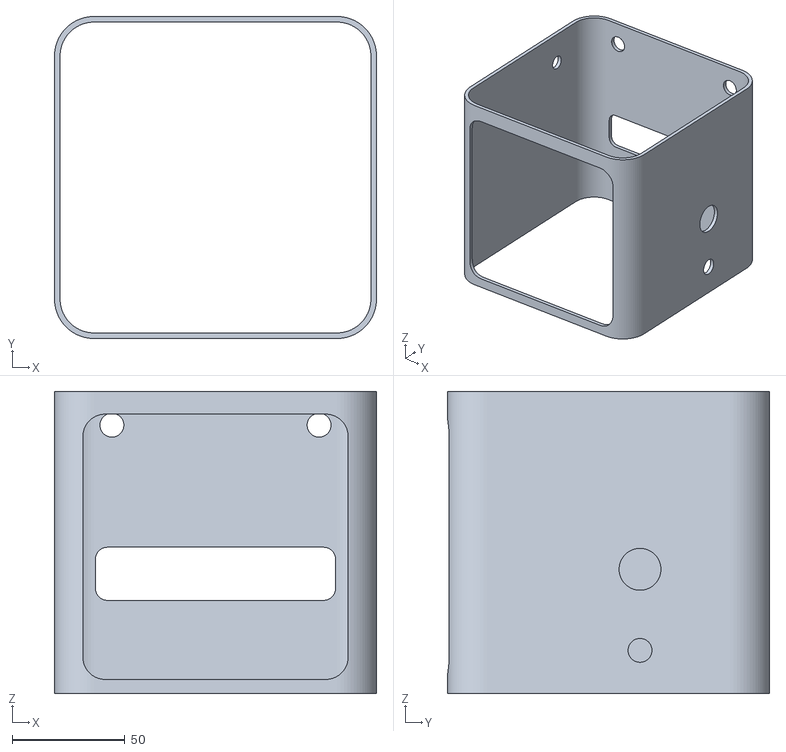
[picture p98: CAD file, 2026-11-04]
v4/out/01f_modifier_korpus_FUZZY_aussenhaut.stl
143.0 x 143.0 x 134.2
