janshort4all/peppa-box/v4/out/09_riemen_gegenplatte.stl

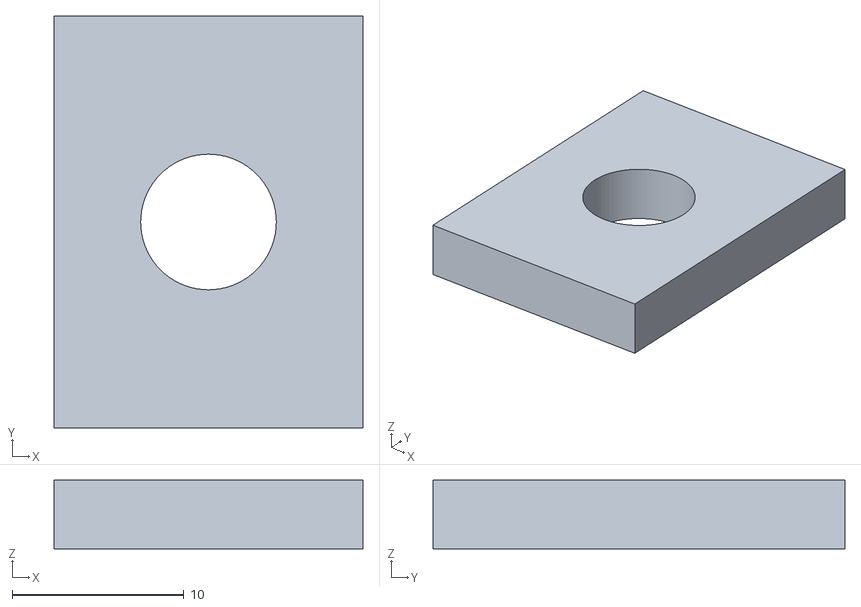
[picture p99: CAD file, 2026-11-03]
v4/out/09_riemen_gegenplatte.stl
18.0 x 24.0 x 4.00
