janshort4all/peppa-box/v4/out/coupon_C3_taste_halter.stl

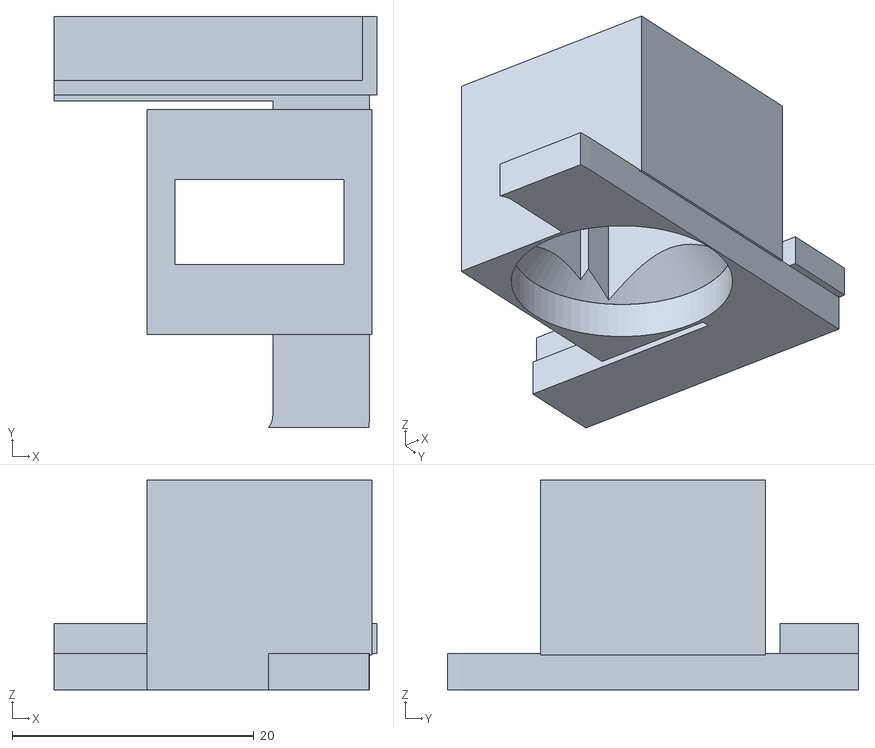
[picture p100: CAD file, 2026-11-03]
v4/out/coupon_C3_taste_halter.stl
26.7 x 34.0 x 17.4
