janshort4all/peppa-box/v4/out/03_deckelrahmen.stl

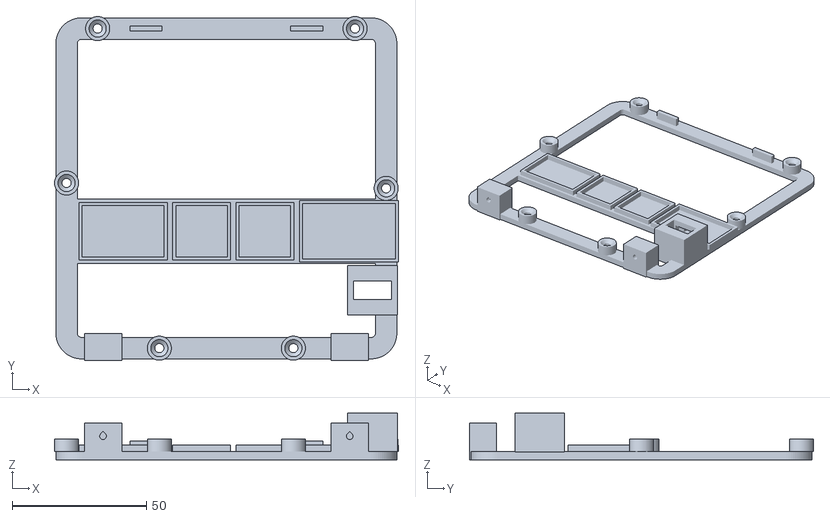
[picture p101: CAD file, 2026-11-03]
v4/out/03_deckelrahmen.stl
128.3 x 128.3 x 17.4
