janshort4all/peppa-box/v4/out/coupon_C2_deckelecke_rahmen.stl

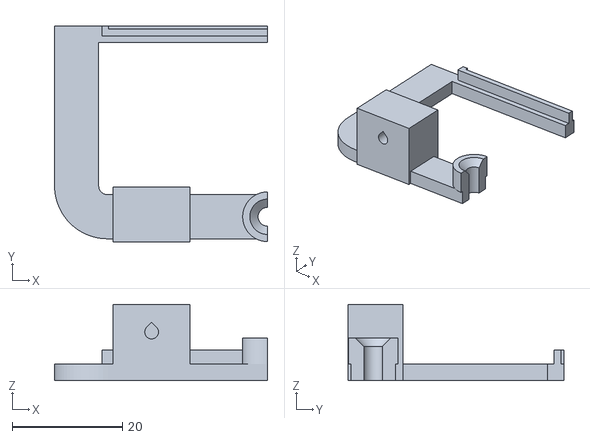
[picture p102: CAD file, 2026-11-03]
v4/out/coupon_C2_deckelecke_rahmen.stl
38.6 x 39.2 x 13.8
