janshort4all/peppa-box/v4/out/coupon_C8_bodenecke_korpus.stl

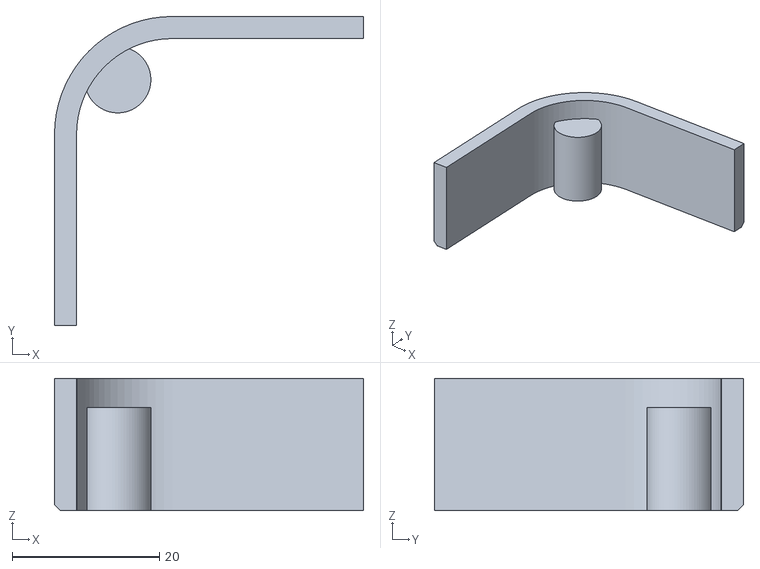
[picture p103: CAD file, 2026-11-03]
v4/out/coupon_C8_bodenecke_korpus.stl
42.0 x 42.0 x 18.0
