janshort4all/peppa-box/v4/out/02_deckel_einfarbig.stl

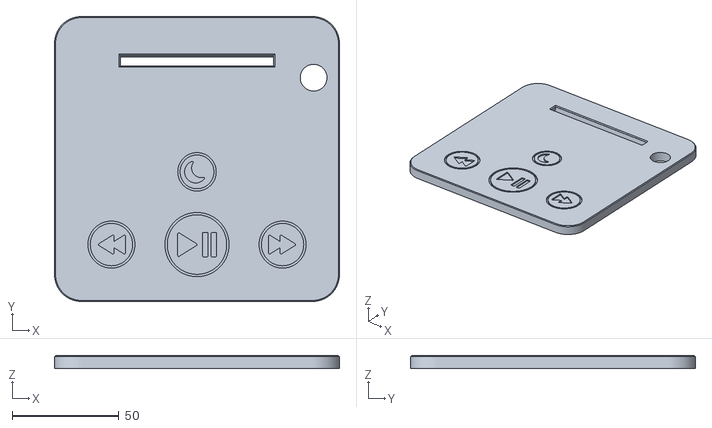
[picture p104: CAD file, 2026-11-02]
v4/out/02_deckel_einfarbig.stl
133.2 x 133.2 x 6.00
