janshort4all/peppa-box/v4/out/08_ein_taste_orange.stl

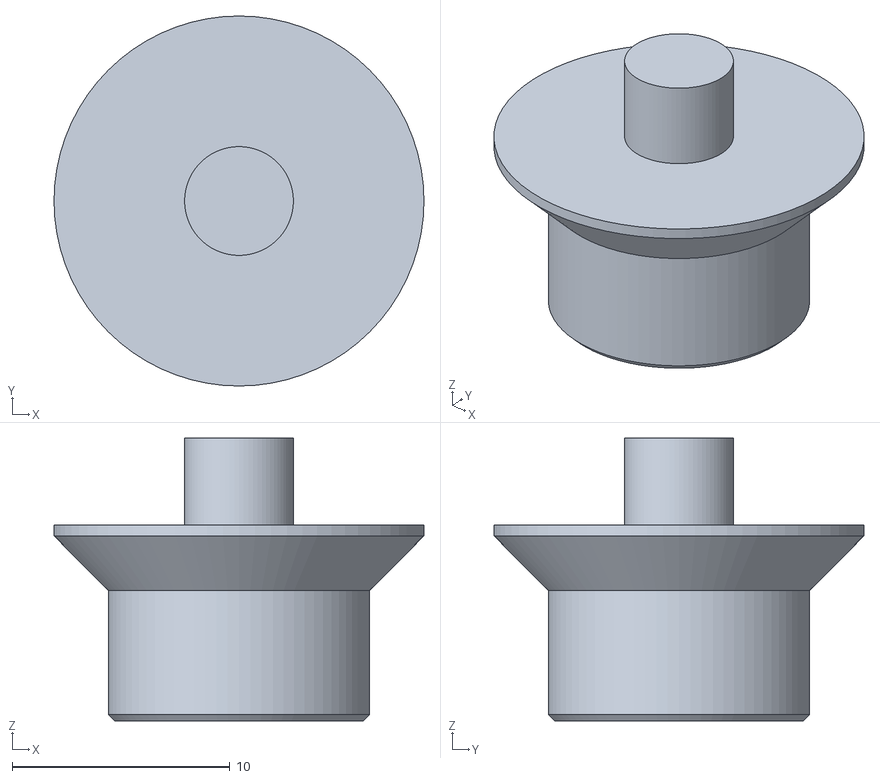
[picture p105: CAD file, 2026-11-02]
v4/out/08_ein_taste_orange.stl
17.0 x 17.0 x 13.0
