janshort4all/peppa-box/v4/out/coupon_C2_deckelecke_deckel.stl

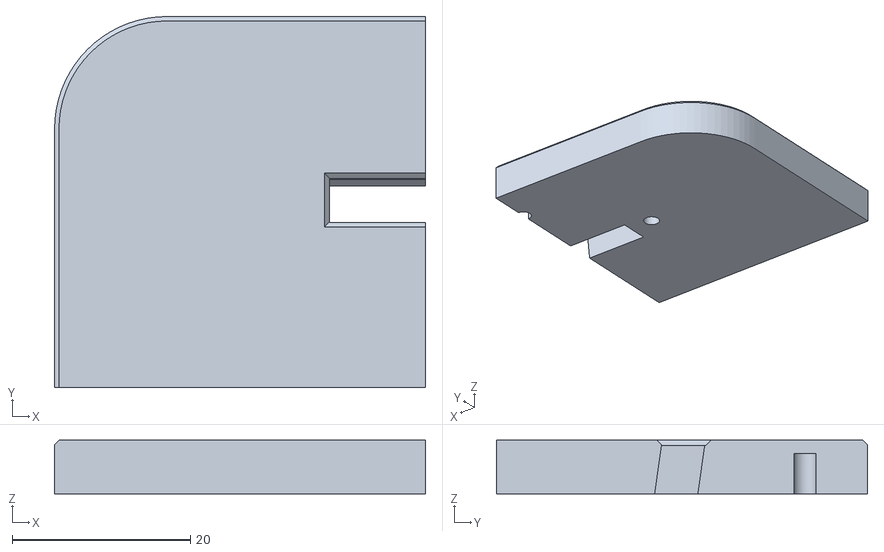
[picture p106: CAD file, 2026-11-02]
v4/out/coupon_C2_deckelecke_deckel.stl
41.6 x 41.6 x 6.00
