janshort4all/peppa-box/v4/out/coupon_C3_taste_deckelstueck.stl

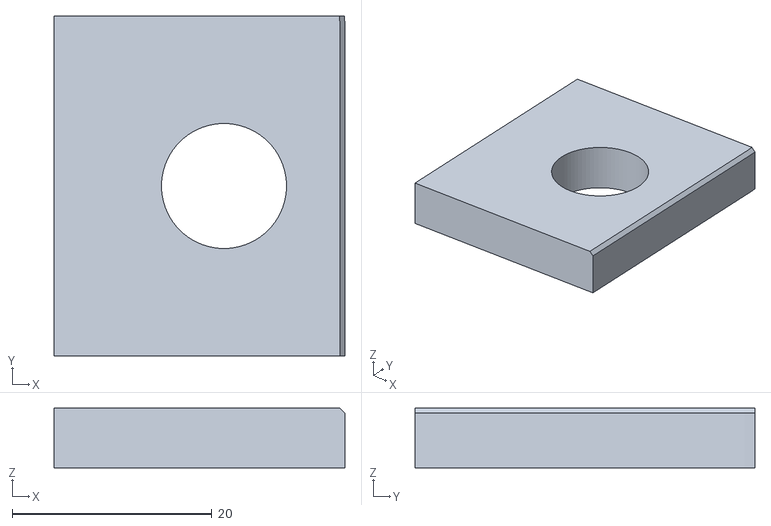
[picture p107: CAD file, 2026-11-02]
v4/out/coupon_C3_taste_deckelstueck.stl
29.1 x 34.0 x 6.00
