janshort4all/peppa-box/v4/out/coupon_C5_touch_platte.stl

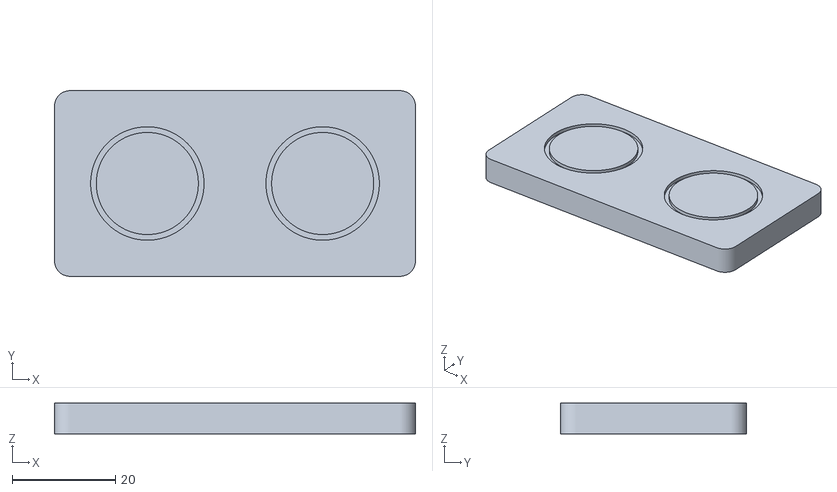
[picture p108: CAD file, 2026-10-27]
v4/out/coupon_C5_touch_platte.stl
70.0 x 36.0 x 6.00
