janshort4all/peppa-box/v4/out/coupon_C8_bodenecke_boden.stl

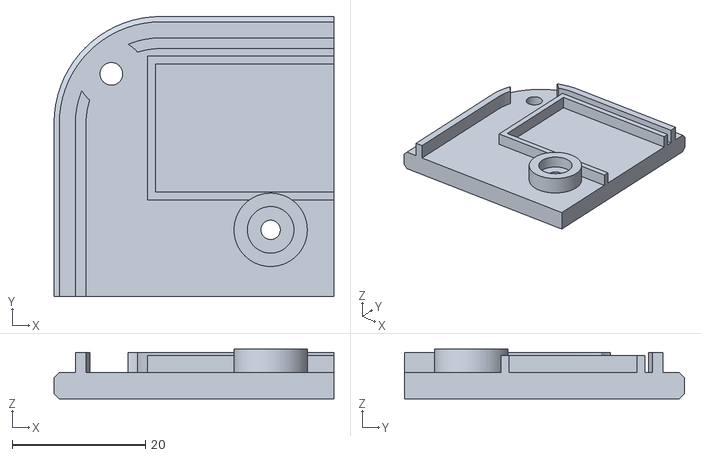
[picture p109: CAD file, 2026-10-25]
v4/out/coupon_C8_bodenecke_boden.stl
42.0 x 42.0 x 7.50
