janshort4all/peppa-box/v4/out/05_boden_traeger.stl

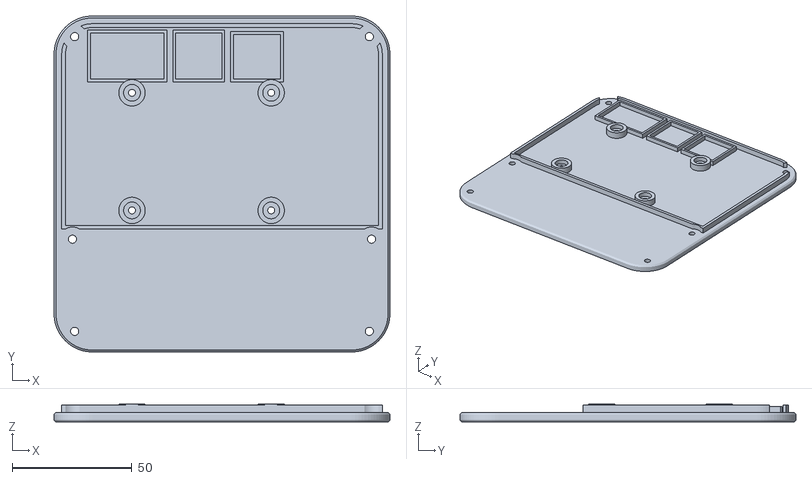
[picture p110: CAD file, 2026-10-25]
v4/out/05_boden_traeger.stl
140.0 x 140.0 x 7.50
