janshort4all/peppa-box/v4/out/coupon_C4_rahmenstifte_block.stl

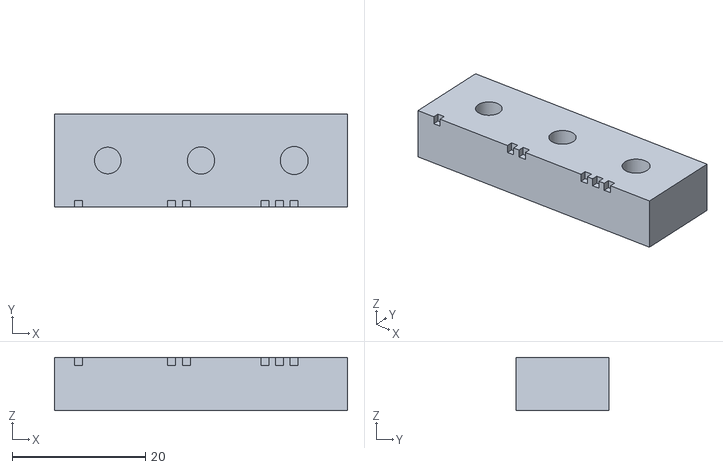
[picture p111: CAD file, 2026-10-25]
v4/out/coupon_C4_rahmenstifte_block.stl
44.0 x 14.0 x 8.00
