janshort4all/peppa-box/v4/out/coupon_C7_lochbild_stapel.stl

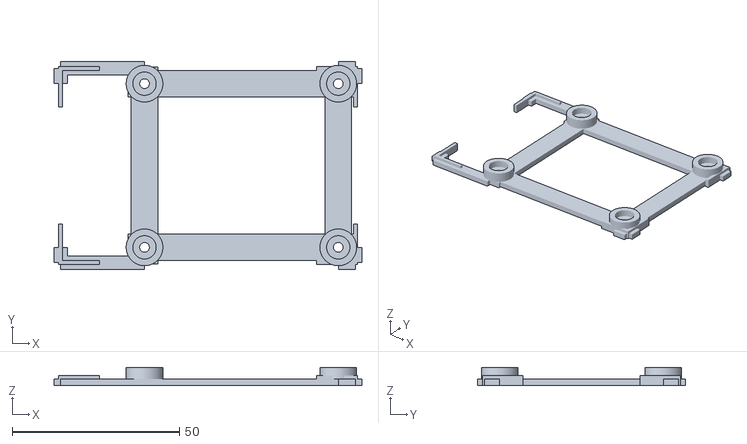
[picture p112: CAD file, 2026-10-25]
v4/out/coupon_C7_lochbild_stapel.stl
92.2 x 62.2 x 5.50
