janshort4all/peppa-box/v4/out/coupon_C6_schraubdome_2-3_2-5_2-7.stl

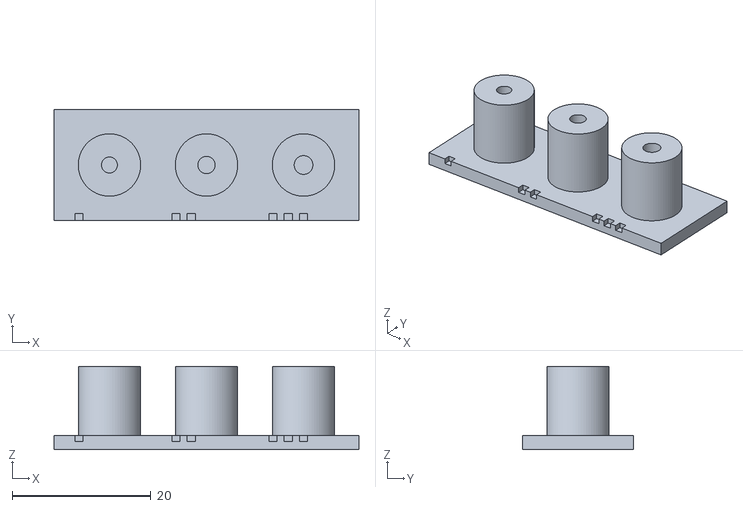
[picture p113: CAD file, 2026-10-25]
v4/out/coupon_C6_schraubdome_2-3_2-5_2-7.stl
44.0 x 16.0 x 12.0
