janshort4all/peppa-box/v4/out/coupon_C4_rahmenstifte_leiste.stl

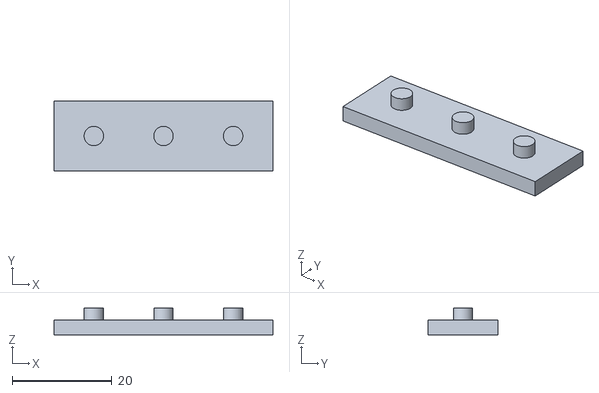
[picture p114: CAD file, 2026-10-25]
v4/out/coupon_C4_rahmenstifte_leiste.stl
44.0 x 14.0 x 5.40
