janshort4all/peppa-box/(list of files, cad)

Other CAD files:
kartenbox/v1_entwurf/out/kartenbox_inlay.step
kartenbox/v1_entwurf/out/druck/02_deckel_orange_kopfueber.stl
kartenbox/v1_entwurf/out/druck/probedruck/K2_rastung_basis_vorspannung0.15.stl
v4/out/coupon_C16_gummiecke_wulst_0-5.stl
kartenbox/v1_entwurf/out/druck/probedruck/K1C_scharnier_deckel_bohrung3.5.stl
kartenbox/v1_entwurf/out/kartenbox_basis.step
kartenbox/v1_entwurf/out/00_zusammenbau_NICHT_DRUCKEN.stl
kartenbox/v1_entwurf/out/druck/probedruck/K2_rastung_basis_vorspannung0.05.stl
v4/out/coupon_C16_gummiecke_wulst_0-4.stl
kartenbox/out/druck/probedruck/K3a_passung_basis.stl
kartenbox/v1_entwurf/out/druck/probedruck/K1B_scharnier_deckel_bohrung3.35.stl
kartenbox/out/druck/probedruck/K1c_stifte_3.9_4.0_4.1.stl
kartenbox/v1_entwurf/out/druck/probedruck/K1B_scharnier_basis_bohrung3.0.stl
v4/out/coupon_C15_karte_rastung_30grad.stl
v4/out/coupon_C15_karte_rastung_40grad.stl
