janshort4all/peppa-box/software/toene.py

#!/usr/bin/env python3
"""Ansagen der Peppa Box. Nur Standardbibliothek.

Jede Ansage hat einen Namen und einen Text (ANSAGEN). Abgespielt wird, was vorhanden ist:
  1. eigene Aufnahme   software/ansagen/<name>.wav (z. B. ElevenLabs, Stimme „Helmut“, wie „bereit“)
  2. Sprachausgabe     pico2wave (Paket libttspico-utils), sonst espeak-ng; einmal erzeugt und in
                       ~/.cache/peppa-box/ansagen/ gespeichert (auf -3 dBFS angehoben wie „bereit“)
  3. Töne              kurze Tonfolge, wenn es gar keine Sprachausgabe gibt
So spricht die Box sofort, und jede Aufnahme, die später dazukommt, ersetzt die Sprachausgabe
ohne Programmänderung. Die Texte für die Aufnahmen stehen in software/ansagen/TEXTE.md.

Ausgabe über den gerade aktiven Ausgang (Lautsprecher oder Kopfhörer) in der dort eingestellten
Lautstärke. Fehler beim Abspielen werden gemeldet, halten aber nichts auf.

Ansager: eigener Faden für den Player. Eine neue Ansage beendet die laufende (zählt nur die
neueste, z. B. beim Weiterschalten des Schlummer-Timers). Der Aufrufer wartet nie.

Klicker: leiser Klick beim Antippen von zurück, Play und vor (klaenge/klick.wav, Lautstärke in
den Einstellungen, bedienung.klick in Prozent der Aufnahme, 0 = aus).

Startton: Dienst peppa-startton (dienst_einrichten.sh) spielt „start“ sofort nach dem Hochfahren des
Tons, ohne auf WLAN oder Spotify zu warten. Aufnahme software/ansagen/start.wav, sonst zwei kurze Töne.

Von Hand:  python3 ~/peppa-box/software/toene.py bereit        (eine Ansage)
           python3 ~/peppa-box/software/toene.py start         (der Startton wie beim Einschalten)
           python3 ~/peppa-box/software/toene.py klick         (der Klick der Touchfelder)
           python3 ~/peppa-box/software/toene.py --alle        (alle nacheinander, mit Quelle)
"""
import array
import hashlib
import json
import math
import os
import shutil
import subprocess
import sys
import threading
import time
import wave

import einstellungen
import lautstaerke

ORDNER = os.path.join(os.path.dirname(os.path.abspath(__file__)), "ansagen")
CACHE = os.environ.get("PEPPA_CACHE_DIR", os.path.expanduser("~/.cache/peppa-box/ansagen"))
ASOUND = os.environ.get("PEPPA_ASOUND", "/etc/asound.conf")
SPITZE = 0.708                        # -3 dBFS, wie die Aufnahme „bereit“
STILLE_VORNE_S = 0.15

ANSAGEN = {
    "start": "Hallo! Ich werde gerade wach.",
    "ganz_aus": "Ich schalte mich jetzt ganz aus.",
    "bereit": "Peppa Box bereit – viel Spaß!",
    "tschuess": "Tschüss, bis bald!",
    "karte_leer": "Auf dieser Karte ist noch keine Musik.",
    "karte_auflegen": "Leg eine Karte auf!",
    "ruhezeit": "Jetzt ist Ruhezeit. Gute Nacht!",
    "moment": "Einen Moment, die Musik kommt gleich.",
    "kein_internet": "Ich finde gerade kein Internet. Ich versuche es weiter.",
    "anmeldung": "Ich bin nicht bei Spotify angemeldet. Bitte frag Mama oder Papa.",
    "timer_15": "Schlummer-Timer: Die Musik geht in fünfzehn Minuten aus.",
    "timer_30": "Schlummer-Timer: Die Musik geht in dreißig Minuten aus.",
    "timer_45": "Schlummer-Timer: Die Musik geht in fünfundvierzig Minuten aus.",
    "timer_60": "Schlummer-Timer: Die Musik geht in einer Stunde aus.",
    "timer_aus": "Schlummer-Timer aus.",
    "netzteil": "Deine Box wird geladen.",
    "akku_laedt": "Der Akku wird gerade geladen.",
    "akku_voll": "Der Akku ist voll.",
    "akku_schwach": "Mein Akku ist fast leer. Bitte bald aufladen!",
    "akku_leer": "Mein Akku ist leer. Ich schalte mich jetzt aus. Tschüss!",
    "akku_unbekannt": "Ich kann den Akku gerade nicht messen.",
}
ZAHLWORT = {10: "zehn", 20: "zwanzig", 30: "dreißig", 40: "vierzig", 50: "fünfzig", 60: "sechzig",
            70: "siebzig", 80: "achtzig", 90: "neunzig", 100: "hundert"}
for _p, _w in ZAHLWORT.items():
    ANSAGEN[f"akku_{_p}"] = f"Akku: {_w} Prozent."
DATEINAMEN = {"bereit": "peppa_box_bereit.wav"}          # ältere Aufnahme mit eigenem Namen
# Ohne Aufnahme nie die Sprachausgabe (klingt schlecht, und das erste Erzeugen kostet beim Start ca. 1 s):
# dann lieber der kurze Ton
NUR_AUFNAHME_ODER_TON = {"start", "ganz_aus", "netzteil"}

# Töne, falls es keine Sprachausgabe gibt: (Frequenz Hz, Dauer s); 0 Hz = Pause
TOENE = {
    "ganz_aus": [(784, .15), (587, .15), (392, .35)],   # absteigend
    "start": [(659, .12), (880, .25)],              # zwei weiche, aufsteigende Töne (E5–A5), bis es eine Aufnahme gibt
    "netzteil": [(523, .12), (784, .25)],          # zwei kurze, aufsteigende Töne, bis es eine Aufnahme gibt
    "bereit": [(523, .12), (659, .12), (784, .2)],
    "tschuess": [(784, .15), (659, .15), (523, .3)],
    "akku_leer": [(392, .2), (330, .2), (262, .4)],
    "karte_leer": [(330, .15), (0, .08), (330, .15)],
    "timer_aus": [(523, .12), (392, .25)],
}


def datei(name):
    return os.path.join(ORDNER, DATEINAMEN.get(name, f"{name}.wav"))


def kopfhoerer_geraet():
    """ALSA-Gerät der Kopfhörer: der Mischer 'kopfhoerer' (lautsprecher_einrichten.sh), sonst direkt."""
    try:
        with open(ASOUND, encoding="utf-8", errors="replace") as f:
            if "pcm.kopfhoerer " in f.read():
                return "kopfhoerer"
    except OSError:
        pass
    return "plughw:CARD=Headphones,DEV=0"


def geraet():
    return "lautsprecher" if lautstaerke.aktive_ausgabe() == "lautsprecher" else kopfhoerer_geraet()


# ---------------------------------------------------------------- Quelle einer Ansage

def _cache_pfad(name, art):
    kennung = hashlib.sha1(f"{art}|{ANSAGEN.get(name, name)}".encode()).hexdigest()[:10]
    return os.path.join(CACHE, f"{name}-{art}-{kennung}.wav")


def _anheben(quelle, ziel):
    """WAV (mono/stereo, 16 Bit) auf SPITZE normalisieren, Stille vorne, nach `ziel` schreiben."""
    with wave.open(quelle) as w:
        kanaele, breite, rate = w.getnchannels(), w.getsampwidth(), w.getframerate()
        roh = w.readframes(w.getnframes())
    if breite != 2:
        raise ValueError("nur 16-Bit-WAV")
    werte = array.array("h", roh)
    if sys.byteorder == "big":
        werte.byteswap()
    spitze = max((abs(v) for v in werte), default=0)
    if spitze:
        faktor = SPITZE * 32767 / spitze
        werte = array.array("h", (max(-32768, min(32767, int(v * faktor))) for v in werte))
    stille = array.array("h", [0] * int(rate * STILLE_VORNE_S) * kanaele)
    werte = stille + werte
    if sys.byteorder == "big":
        werte.byteswap()
    tmp = ziel + ".tmp"
    with wave.open(tmp, "wb") as w:
        w.setnchannels(kanaele)
        w.setsampwidth(2)
        w.setframerate(rate)
        w.writeframes(werte.tobytes())
    os.replace(tmp, ziel)


def _sprache(name, log):
    """Sprachausgabe erzeugen (pico2wave, sonst espeak-ng). Gibt den Pfad zurück oder None."""
    text = ANSAGEN.get(name)
    if not text:
        return None
    for art, exe, args in (("pico", "pico2wave", ["-l", "de-DE", "-w"]),
                           ("espeak", "espeak-ng", ["-v", "de", "-s", "150", "-w"])):
        pfad = shutil.which(exe)
        if not pfad:
            continue
        ziel = _cache_pfad(name, art)
        if os.path.isfile(ziel):
            return ziel
        try:
            os.makedirs(CACHE, exist_ok=True)
            roh = ziel[:-4] + "-roh.wav"                # pico2wave verlangt die Endung .wav
            nice = [shutil.which("nice"), "-n", "10"] if shutil.which("nice") else []
            r = subprocess.run(nice + [pfad, *args, roh, text], capture_output=True, text=True, timeout=30)
            if r.returncode != 0 or not os.path.isfile(roh):
                log(f"Sprachausgabe ({exe}) für '{name}' fehlgeschlagen: {r.stderr.strip()[:200]}")
                continue
            _anheben(roh, ziel)
            os.remove(roh)
            return ziel
        except (OSError, ValueError, wave.Error, subprocess.TimeoutExpired) as e:
            log(f"Sprachausgabe ({exe}) für '{name}' fehlgeschlagen: {e!r}")
    return None


def _ton(name):
    """Kurze Tonfolge als WAV (44,1 kHz mono) im Cache; Rückfall, wenn es keine Sprachausgabe gibt."""
    folge = TOENE.get(name)
    if folge is None:
        if name.startswith("akku_") and name[5:].isdigit():                  # 1 … 5 Töne = 20 … 100 %
            folge = [(659, .1), (0, .12)] * max(1, round(int(name[5:]) / 20))
        elif name.startswith("timer_") and name[6:].isdigit():                # 1 … 4 Töne = 15 … 60 Min
            folge = [(523, .1), (0, .12)] * (int(name[6:]) // 15)
        else:
            folge = [(440, .15), (0, .08), (440, .15)]
    ziel = _cache_pfad(name, "ton")
    if os.path.isfile(ziel):
        return ziel
    rate = 44100
    werte = array.array("h", [0] * int(rate * STILLE_VORNE_S))
    for freq, dauer in folge:
        n = int(rate * dauer)
        for i in range(n):
            huelle = min(1.0, i / 400, (n - i) / 400)                          # weich ein/aus, kein Knacken
            werte.append(int(0.35 * 32767 * huelle * math.sin(2 * math.pi * freq * i / rate)) if freq else 0)
    if sys.byteorder == "big":
        werte.byteswap()
    os.makedirs(CACHE, exist_ok=True)
    tmp = ziel + ".tmp"
    with wave.open(tmp, "wb") as w:
        w.setnchannels(1)
        w.setsampwidth(2)
        w.setframerate(rate)
        w.writeframes(werte.tobytes())
    os.replace(tmp, ziel)
    return ziel


def quelle(name, log=print):
    """(Pfad, Art) einer Ansage; Art = 'aufnahme' | 'sprache' | 'ton'. (None, None), wenn nichts geht."""
    p = datei(name)
    if os.path.isfile(p):
        return p, "aufnahme"
    p = None if name in NUR_AUFNAHME_ODER_TON else _sprache(name, log)
    if p:
        return p, "sprache"
    try:
        return _ton(name), "ton"
    except OSError as e:
        log(f"Ansage '{name}': auch kein Ton möglich ({e!r})")
        return None, None


def quelle_ohne_erzeugen(name):
    """Wie quelle(), erzeugt aber nichts (für die Eltern-Seite: was würde gerade gespielt?)."""
    if os.path.isfile(datei(name)):
        return "aufnahme"
    if name in NUR_AUFNAHME_ODER_TON:
        return "ton"
    for art, exe in (("pico", "pico2wave"), ("espeak", "espeak-ng")):
        if shutil.which(exe):
            return "sprache"
    return "ton"


# ---------------------------------------------------------------- In die Musik mischen

MISCH_AUFTRAG = os.environ.get("PEPPA_ANSAGE_AUFTRAG") or "/dev/shm/peppa-box-ansage.json"
MISCH_PCM = os.environ.get("PEPPA_ANSAGE_PCM") or "/dev/shm/peppa-box-ansage.raw"
MISCH_STATUS = os.environ.get("PEPPA_AUSGABE_STATUS") or "/dev/shm/peppa-box-ausgabe.json"
MISCH_FRISCH_S = 2.5          # so alt darf das Lebenszeichen der Tonausgabe höchstens sein
MISCH_QUITTUNG_S = 0.6        # so lange auf die Quittung warten, sonst selbst spielen
MISCH_VORLAUF_S = 0.30        # wie VORLAUF_S in ausgabe.py (Musik senkt sich vorher ab)
_misch_zaehler = 0


def _status():
    try:
        with open(MISCH_STATUS, encoding="utf-8") as f:
            return json.load(f)
    except (OSError, ValueError):
        return None


def musik_fliesst():
    """Läuft gerade die Tonausgabe der Musik (ausgabe.py) und meldet sich?"""
    st = _status()
    if not isinstance(st, dict) or time.time() - float(st.get("t") or 0) > MISCH_FRISCH_S:
        return False
    try:
        os.kill(int(st.get("pid") or 0), 0)
    except PermissionError:
        return True                  # läuft unter Raspotify (anderer Benutzer)
    except (OSError, ValueError):
        return False
    return True


def _pcm_stereo(pfad):
    """WAV (16 Bit, mono/stereo, beliebige Rate) -> Roh-Ton S16_LE 44,1 kHz Stereo."""
    with wave.open(pfad) as w:
        kanaele, breite, rate = w.getnchannels(), w.getsampwidth(), w.getframerate()
        roh = w.readframes(w.getnframes())
    if breite != 2 or kanaele not in (1, 2):
        raise ValueError("nur 16-Bit-WAV mono/stereo")
    werte = array.array("h")
    werte.frombytes(roh)
    if sys.byteorder == "big":
        werte.byteswap()
    mono = werte if kanaele == 1 else array.array("h", ((werte[i] + werte[i + 1]) // 2
                                                         for i in range(0, len(werte) - 1, 2)))
    if rate != 44100 and len(mono) > 1:
        n = int(len(mono) * 44100 / rate)
        schritt = (len(mono) - 1) / max(1, n - 1)
        neu = array.array("h", bytes(2 * n))
        for i in range(n):
            x = i * schritt
            k = int(x)
            f = x - k
            b = mono[k + 1] if k + 1 < len(mono) else mono[k]
            neu[i] = int(mono[k] + (b - mono[k]) * f)
        mono = neu
    stereo = array.array("h", bytes(4 * len(mono)))
    stereo[0::2] = mono
    stereo[1::2] = mono
    if sys.byteorder == "big":
        stereo.byteswap()
    return stereo.tobytes()


def _auftrag(pcm):
    global _misch_zaehler
    _misch_zaehler += 1
    kennung = f"{os.getpid()}-{time.monotonic_ns()}-{_misch_zaehler}"
    auftrag = {"id": kennung, "pcm": pcm, "bis": time.time() + MISCH_QUITTUNG_S + 0.1}
    tmp = MISCH_AUFTRAG + f".{os.getpid()}.tmp"
    with open(tmp, "w", encoding="utf-8") as f:
        json.dump(auftrag, f)
    os.chmod(tmp, 0o644)
    os.replace(tmp, MISCH_AUFTRAG)
    return kennung


def _quittiert(kennung, zeit=MISCH_QUITTUNG_S):
    ende = time.monotonic() + zeit
    while time.monotonic() < ende:
        st = _status()
        if isinstance(st, dict) and st.get("quittung") == kennung:
            return True
        time.sleep(0.03)
    return False


class Gemischt:
    """Wie ein Popen-Objekt (poll/wait/communicate/terminate) für eine in die Musik gemischte Ansage."""

    def __init__(self, dauer):
        self._ende = time.monotonic() + dauer
        self._stopp = threading.Event()
        self.returncode = None

    def poll(self):
        if self.returncode is None and time.monotonic() >= self._ende:
            self.returncode = 0
        return self.returncode

    def wait(self, timeout=None):
        rest = self._ende - time.monotonic()
        if timeout is not None and rest > timeout:
            self._stopp.wait(timeout)
            if self.returncode is None:
                raise subprocess.TimeoutExpired("ansage", timeout)
            return self.returncode
        self._stopp.wait(max(0.0, rest))
        return self.poll()

    def communicate(self, timeout=None):
        self.wait(timeout)
        return b"", b""

    def terminate(self):
        if self.poll() is None:
            self.returncode = -15
            try:
                _auftrag(None)       # Stopp an die Tonausgabe
            except OSError:
                pass
            self._stopp.set()

    kill = terminate


def mischen(pfad, log=print):
    """Ansage in die laufende Musik mischen (Musik wird weich abgesenkt). Gibt ein Gemischt-Objekt
    zurück oder None, wenn keine Musik läuft oder die Tonausgabe nicht quittiert (dann selbst spielen)."""
    if not musik_fliesst():
        return None
    try:
        pcm = _pcm_stereo(pfad)
        tmp = MISCH_PCM + f".{os.getpid()}.tmp"
        with open(tmp, "wb") as f:
            f.write(pcm)
        os.chmod(tmp, 0o644)
        os.replace(tmp, MISCH_PCM)
        kennung = _auftrag(MISCH_PCM)
    except (OSError, ValueError, wave.Error) as e:
        log(f"Ansage nicht in die Musik gemischt: {e!r}")
        return None
    if not _quittiert(kennung):
        log("Tonausgabe hat die Ansage nicht angenommen – spiele sie selbst")
        return None
    return Gemischt(MISCH_VORLAUF_S + len(pcm) / (44100 * 4) + 0.1)


# ---------------------------------------------------------------- Klick der Touchfelder

KLICK_DATEI = os.path.join(os.path.dirname(os.path.abspath(__file__)), "klaenge", "klick.wav")
KLICK_AUFTRAG = os.environ.get("PEPPA_KLICK_AUFTRAG") or "/dev/shm/peppa-box-klick.json"
KLICK_PCM = os.environ.get("PEPPA_KLICK_PCM") or "/dev/shm/peppa-box-klick.raw"
KLICK_STANDARD = 30            # Prozent der Aufnahme (Jan 09.11.: 15 % zu leise, doppelt so laut)
_klick_sperre = threading.Lock()
_klick_proc = None


def klick_pegel():
    try:
        return int(einstellungen.laden()["bedienung"].get("klick", KLICK_STANDARD))
    except Exception:
        return KLICK_STANDARD


def _klick_wav(pegel, ordner=None):
    """Klick in der gewünschten Lautstärke als WAV im Arbeitsspeicher-Ordner (einmal je Pegel erzeugt)."""
    ordner = ordner or os.path.dirname(einstellungen.lauf_pfad("x"))
    ziel = os.path.join(ordner, f"peppa-box-klick-{pegel}.wav")
    if os.path.isfile(ziel):
        return ziel
    with wave.open(KLICK_DATEI) as w:
        params, roh = w.getparams(), w.readframes(w.getnframes())
    werte = array.array("h")
    werte.frombytes(roh)
    if sys.byteorder == "big":
        werte.byteswap()
    f = pegel / 100.0
    werte = array.array("h", (int(v * f) for v in werte))
    if sys.byteorder == "big":
        werte.byteswap()
    tmp = ziel + f".{os.getpid()}.tmp"
    with wave.open(tmp, "wb") as w:
        w.setparams(params)
        w.writeframes(werte.tobytes())
    os.chmod(tmp, 0o644)
    os.replace(tmp, ziel)
    return ziel


def _ausgabe_kann_klick():
    st = _status()
    return isinstance(st, dict) and bool(st.get("klick"))


def klick_freigeben():
    """Laufenden Klick auf der Pi-Klinke beenden (sie hat keinen Mischer), damit eine Ansage sie bekommt."""
    global _klick_proc
    with _klick_sperre:
        p, _klick_proc = _klick_proc, None
    if p is not None and p.poll() is None:
        try:
            p.terminate()
            p.wait(timeout=0.3)
        except (OSError, subprocess.TimeoutExpired):
            pass


class Klicker:
    """Leiser Klick beim Antippen von zurück, Play und vor (nicht Mond, nicht Ein-Taste).
    klick() kehrt sofort zurück; abgespielt wird in einem eigenen Faden.
      Lautsprecher: aplay in den Mischer (dmix) – klingt neben der Musik, ohne sie abzusenken.
      Kopfhörer, Musik läuft: die Tonausgabe (ausgabe.py) mischt ihn in den Musikstrom.
      Kopfhörer, keine Musik: aplay direkt auf die Pi-Klinke."""

    def __init__(self, log=print, popen=subprocess.Popen, pegel=klick_pegel, ausgang=None):
        self.log, self.popen, self.pegel = log, popen, pegel
        self.ausgang = ausgang or lautstaerke.aktive_ausgabe
        self._wunsch = threading.Event()
        self._faden = None
        self._fehler_gemeldet = False
        self.anzahl = 0

    def starten(self):
        self._faden = threading.Thread(target=self._lauf, name="klick", daemon=True)
        self._faden.start()
        return self._faden

    def lebt(self):
        return self._faden is not None and self._faden.is_alive()

    def klick(self):
        self._wunsch.set()

    def _lauf(self):
        while True:
            self._wunsch.wait()
            self._wunsch.clear()
            try:
                self.spielen()
            except Exception as e:                     # der Faden darf nie sterben
                if not self._fehler_gemeldet:
                    self.log(f"Klick: Fehler {e!r}")
                    self._fehler_gemeldet = True

    def spielen(self):
        global _klick_proc
        pegel = self.pegel()
        if pegel <= 0:
            return None
        pfad = _klick_wav(pegel)
        if self.ausgang() == "lautsprecher":
            p = self.popen([shutil.which("aplay") or "aplay", "-q", "-D", "lautsprecher", pfad],
                           stdout=subprocess.DEVNULL, stderr=subprocess.DEVNULL)
            self.anzahl += 1
            return "lautsprecher"
        if musik_fliesst() and _ausgabe_kann_klick():
            with wave.open(pfad) as w:
                roh = w.readframes(w.getnframes())
            tmp = KLICK_PCM + f".{os.getpid()}.tmp"
            with open(tmp, "wb") as f:
                f.write(roh)
            os.chmod(tmp, 0o644)
            os.replace(tmp, KLICK_PCM)
            tmp = KLICK_AUFTRAG + f".{os.getpid()}.tmp"
            with open(tmp, "w", encoding="utf-8") as f:
                json.dump({"id": f"{os.getpid()}-{time.monotonic_ns()}", "pcm": KLICK_PCM,
                           "bis": time.time() + 0.5}, f)
            os.chmod(tmp, 0o644)
            os.replace(tmp, KLICK_AUFTRAG)
            self.anzahl += 1
            return "gemischt"
        klick_freigeben()                              # schnell hintereinander: den vorigen Klick beenden
        p = self.popen([shutil.which("aplay") or "aplay", "-q", "-D", kopfhoerer_geraet(), pfad],
                       stdout=subprocess.DEVNULL, stderr=subprocess.DEVNULL)
        with _klick_sperre:
            _klick_proc = p
        self.anzahl += 1
        return "kopfhoerer"


# ---------------------------------------------------------------- Abspielen

def _befehl(pfad):
    return [shutil.which("aplay"), "-q", "-D", geraet(), pfad]


def spielen(name, warten=False, log=print):
    """Spielt eine Ansage. warten=False: läuft im Hintergrund, der Aufrufer macht sofort weiter
    (eine noch fehlende Sprachausgabe wird vorher erzeugt, das dauert beim ersten Mal ca. 1 s)."""
    aplay = shutil.which("aplay")
    if not aplay:
        log("Ansage: aplay fehlt")
        return False
    pfad, art = quelle(name, log=log)
    if not pfad or not os.path.isfile(pfad):
        log(f"Ansage '{name}' fehlt: {datei(name)}")
        return False
    g = mischen(pfad, log=log)
    if g is not None:
        if warten:
            g.wait()
        return True
    klick_freigeben()
    cmd = [aplay, "-q", "-D", geraet(), pfad]
    try:
        if warten:
            r = subprocess.run(cmd, capture_output=True, text=True, timeout=20)
            if r.returncode != 0:
                log(f"Ansage '{name}' nicht abgespielt: {r.stderr.strip()[:200]}")
                return False
        else:
            subprocess.Popen(cmd, stdout=subprocess.DEVNULL, stderr=subprocess.DEVNULL)
        return True
    except (OSError, subprocess.TimeoutExpired) as e:
        log(f"Ansage '{name}' nicht abgespielt: {e!r}")
        return False


def einmal_je_einschalten(name, log=print, spieler=None):
    """Spielt die Ansage nur beim ersten Aufruf nach dem Einschalten (Markierung im Arbeitsspeicher),
    damit ein Neustart des Players (z. B. nach einem Update) sie nicht wiederholt."""
    marke = einstellungen.lauf_pfad(f"ansage-{name}")
    if os.path.exists(marke):
        return False
    try:
        open(marke, "w").close()
    except OSError:
        pass
    if spieler is not None:
        spieler(name)
        return True
    return spielen(name, log=log)


class Ansager:
    """Spielt Ansagen in einem eigenen Faden. sagen() kehrt sofort zurück; eine neue Ansage
    beendet die laufende. sagen_und_warten() für „Tschüss“ vor dem Ausschalten."""

    def __init__(self, log=print, popen=subprocess.Popen):
        self.log, self.popen = log, popen
        self._bed = threading.Condition()
        self._wunsch = None
        self._proc = None
        self.zuletzt = None                  # (name, Art) der letzten Ansage, für die Eltern-Seite
        self._faden = None
        self._beschaeftigt = False

    def starten(self):
        self._faden = threading.Thread(target=self._lauf, name="ansagen", daemon=True)
        self._faden.start()
        return self._faden

    def lebt(self):
        return self._faden is not None and self._faden.is_alive()

    def _stoppen(self):
        p = self._proc
        if p is not None and p.poll() is None:
            try:
                p.terminate()
            except OSError:
                pass

    def sagen(self, name):
        if name not in ANSAGEN:
            self.log(f"Unbekannte Ansage '{name}'")
            return
        with self._bed:
            self._wunsch = name
            self._stoppen()
            self._bed.notify_all()

    def warten(self, zeit=5.0):
        """Wartet, bis keine Ansage mehr läuft oder ansteht (z. B. „Tschüss“ vor dem Ausschalten)."""
        ende = time.monotonic() + zeit
        while time.monotonic() < ende:
            with self._bed:
                offen = self._wunsch is not None or self._beschaeftigt
            if not offen:
                return True
            time.sleep(0.05)
        return False

    def sagen_und_warten(self, name, zeit=8.0):
        with self._bed:
            self._wunsch = None
            self._stoppen()
        p = self._abspielen(name)
        if p is None:
            return False
        try:
            p.wait(timeout=zeit)
        except subprocess.TimeoutExpired:
            p.terminate()
        return True

    def _abspielen(self, name):
        if not shutil.which("aplay"):
            self.log("Ansage: aplay fehlt")
            return None
        pfad, art = quelle(name, log=self.log)
        if not pfad:
            return None
        g = mischen(pfad, log=self.log)
        if g is not None:
            self._proc = g
            self.zuletzt = (name, art)
            return g
        klick_freigeben()
        try:
            p = self.popen(_befehl(pfad), stdout=subprocess.DEVNULL, stderr=subprocess.PIPE)
        except OSError as e:
            self.log(f"Ansage '{name}' nicht abgespielt: {e!r}")
            return None
        self._proc = p
        self.zuletzt = (name, art)
        return p

    def _lauf(self):
        while True:
            with self._bed:
                while self._wunsch is None:
                    self._bed.wait()
                name, self._wunsch = self._wunsch, None
                self._beschaeftigt = True
            try:
                p = self._abspielen(name)
                if p is not None:
                    try:
                        _, fehler = p.communicate(timeout=30)
                    except subprocess.TimeoutExpired:
                        p.kill()
                        fehler = b""
                    if p.returncode not in (0, -15) and fehler:   # -15: von einer neueren Ansage beendet
                        self.log(f"Ansage '{name}' nicht abgespielt: {fehler.decode(errors='replace').strip()[:200]}")
            except Exception as e:                                 # der Faden darf nie sterben
                self.log(f"Ansage '{name}': Fehler {e!r}")
            finally:
                with self._bed:
                    self._beschaeftigt = False

    def vorbereiten(self):
        """Fehlende Sprachausgaben im Hintergrund erzeugen, damit später nichts wartet."""
        def lauf():
            erzeugt = 0
            for name in ANSAGEN:
                if not os.path.isfile(datei(name)) and _sprache(name, self.log):
                    erzeugt += 1
                time.sleep(0.05)
            if erzeugt:
                self.log(f"Sprachausgabe für {erzeugt} Ansagen bereit.")
        threading.Thread(target=lauf, name="ansagen-vorbereiten", daemon=True).start()


def _regler_anlegen(log=print):
    """Der Software-Regler „Lautsprecher“ (softvol) entsteht erst, wenn jemand das Gerät öffnet.
    Nach dem Einschalten ist das beim frühen Startton noch nicht passiert: 1 s Stille öffnen."""
    aplay = shutil.which("aplay")
    if not aplay or not lautstaerke.karte_da("lautsprecher"):
        return False
    try:
        subprocess.run([aplay, "-q", "-D", "lautsprecher", "-d", "1", "-f", "S16_LE", "-r", "44100", "-c", "2",
                        "/dev/zero"], capture_output=True, timeout=10)
    except (OSError, subprocess.TimeoutExpired) as e:
        log(f"Startton: Regler ließ sich nicht anlegen: {e!r}")
    lautstaerke.neu_suchen()
    return lautstaerke.eingerichtet("lautsprecher")


def startton(log=print):
    """Für den Dienst peppa-startton: so früh wie möglich nach dem Einschalten ein Ton, damit das Kind
    merkt, dass der Knopf gewirkt hat (Spotify und WLAN brauchen noch Sekunden, erst dann kommt „bereit“).
    Vorher die Startlautstärke setzen (sonst klänge er in der Lautstärke vom letzten Mal). Ist der Regler
    nicht da und nicht anlegbar, bleibt es still: lieber kein Ton als einer in voller Lautstärke.
    In der Ruhezeit mit Modus 'keine Musik' bleibt es auch still."""
    import automatik
    if einstellungen.musik_gesperrt(einstellungen.laden(), time.time()):
        log("Ruhezeit (keine Musik): kein Startton")
        return True
    if not lautstaerke.eingerichtet("lautsprecher") and not _regler_anlegen(log):
        if lautstaerke.karte_da("lautsprecher"):
            log("Startton: Lautsprecher-Regler fehlt, kein Startton (Lautstärke unbekannt)")
            return False
    automatik.Automatik(None, lautstaerke, einstellungen, log=log).beim_start()
    return spielen("start", warten=True, log=log)


if __name__ == "__main__":
    if len(sys.argv) > 1 and sys.argv[1] == "--alle":
        for n in ANSAGEN:
            pfad, art = quelle(n)
            print(f"{n:16} {art:9} {ANSAGEN[n]}")
            spielen(n, warten=True)
            time.sleep(0.4)
        sys.exit(0)
    if len(sys.argv) > 1 and sys.argv[1] == "klick":
        k = Klicker()
        weg = k.spielen()
        print(f"Klick ({klick_pegel()} %): {weg or 'aus'}")
        time.sleep(0.5)
        sys.exit(0)
    name = sys.argv[1] if len(sys.argv) > 1 else "bereit"
    if name not in ANSAGEN:
        sys.exit(f"Unbekannte Ansage '{name}', möglich: {', '.join(ANSAGEN)}")
    # "start" wie im Dienst peppa-startton: erst die Startlautstärke, dann der Ton
    sys.exit(0 if (startton() if name == "start" else spielen(name, warten=True)) else 1)
