janshort4all/peppa-box/software/automatik.py

"""Automatik der Peppa Box: Schlummer-Timer, Ruhezeit, Auto-Aus und Lautstärke-Grenzen.

Läuft im Player: peppa_player.py ruft tick() jede Sekunde auf. Die Eltern-Seite ändert nur
Dateien (Einstellungen, Timer); ausgeführt wird hier. So überstehen Timer ein Update der Seite.

Abläufe
  Start            Startlautstärke einmal je Einschalten setzen (Markierung in /dev/shm)
  Schlummer-Timer  die letzten FADE_S Sekunden wird die Musik leiser, dann Pause, dann ist die
                   Lautstärke wieder wie vorher
  Ruhezeit         "leiser": Lautstärke höchstens leise_max. "aus": keine Musik (laufende Musik
                   wird pausiert, neue Karten starten nicht). Nach der Ruhezeit bleibt die
                   Lautstärke wie sie ist (nie von selbst lauter)
  Grenzen          Lautstärke über der Höchstlautstärke wird heruntergesetzt
  Auto-Aus         Box fährt herunter, wenn die eingestellte Zeit nichts gespielt wurde. Als
                   Aktivität zählt: Musik spielt, Eltern-Seite ist offen (Wartung, Update)

Spotify, Lautstärke, Einstellungen und Uhr kommen von außen, damit sich alles mit simulierter Zeit
testen lässt (test_automatik.py).
"""
import shutil
import subprocess
import threading
import time

FADE_S = 20             # so lange wird beim Schlummer-Timer ausgeblendet
ABFRAGE_S = 10          # Spotify fragen und Grenzen prüfen
SEITE_AKTIV_S = 120     # so lange zählt eine geöffnete Eltern-Seite als Aktivität
TIMER_GNADE_S = 60      # so lange nach Ablauf wird die Pause bei Fehlern wiederholt
TIMER_PAUSE_ABSTAND_S = 3   # ... in diesem Abstand
SEITE_REPARATUR_S = 600     # so lange zählt eine Karte, die auf Musik wartet (Reparatur), als Aktivität
SYSTEMCTL = shutil.which("systemctl") or "/usr/bin/systemctl"
TIMER_SPERRE = threading.RLock()  # Mond-Feld (Faden der Bedienung) und Ausblenden (Hauptfaden) nie gleichzeitig


def timer_abbrechen(laut, einst):
    """Schlummer-Timer löschen. War er schon beim Ausblenden, die Lautstärke wieder auf den alten Wert.
    Gibt True zurück, wenn ein Timer lief. (Eltern-Seite und Mond-Feld nutzen dieselbe Funktion.)"""
    with TIMER_SPERRE:
        t = einst.lauf_lesen("timer")
        if not t:
            return False
        einst.lauf_loeschen("timer")
        if t.get("vorher") is not None:
            laut.setzen(laut.aktive_ausgabe(), t["vorher"])
        return True


def timer_starten(minuten, laut, einst, jetzt=None):
    """Neuer Schlummer-Timer (ersetzt einen laufenden)."""
    with TIMER_SPERRE:
        timer_abbrechen(laut, einst)
        einst.lauf_schreiben("timer", {"ende": (time.time() if jetzt is None else jetzt) + minuten * 60,
                                       "minuten": minuten, "vorher": None})


def _poweroff():
    r = subprocess.run(["sudo", "-n", SYSTEMCTL, "poweroff"], capture_output=True, text=True, timeout=60)
    if r.returncode != 0:
        raise RuntimeError((r.stdout + r.stderr).strip() or f"Rückgabewert {r.returncode}")


class Automatik:
    def __init__(self, spotify, laut, einst, jetzt=time.time, schlaf=time.sleep,
                 ausschalten=_poweroff, log=print, dauer=None, ton=None, wartet=None):
        self.spotify, self.laut, self.einst = spotify, laut, einst
        self.jetzt, self.schlaf, self.ausschalten, self.log = jetzt, schlaf, ausschalten, log
        # Uhr für die Auto-Aus-Frist. Im Betrieb time.monotonic: Der Pi hat keine Echtzeituhr und springt nach
        # dem Kaltstart beim Zeitabgleich (NTP) um Stunden vor; mit der Wanduhr hätte das sofort Auto-Aus
        # ausgelöst (Fehler 11.11.2026). Ohne Angabe gilt dieselbe Uhr wie jetzt (Tests mit simulierter Zeit).
        self.dauer = dauer or jetzt
        # Audit 12.11.2026 (Befunde 3 und 4): Die Auskunft von Spotify, ob gespielt wird, war bei hörbarer
        # Musik schon falsch (08.11.). Darum zusätzlich der Tonfluss der Box selbst: ton() -> True/False,
        # None = unbekannt. wartet() -> Sekunden, die eine liegende Karte schon auf Musik wartet, oder None.
        self.ton = ton or (lambda: None)
        self.wartet = wartet or (lambda: None)
        self._timer_pause_ok = None              # (Ende des Timers, Zeitpunkt der angenommenen Pause)
        self._timer_naechste_pause = 0.0
        self.spielt = None                       # letzter bekannter Zustand: True, False, None
        self.letzte_aktivitaet = self.dauer()    # nach dem Einschalten bleibt die Box mindestens so lange an
        self._naechste_abfrage = 0.0
        self.status = {"ausgabe": laut.aktive_ausgabe(), "ruhezeit": False, "auto_aus_in": None}

    # ------------------------------------------------------------ Start

    def beim_start(self):
        """Startlautstärke setzen, aber nur einmal je Einschalten. Ein Neustart des Players
        (Update, 'Musik neu starten') ändert die laufende Lautstärke nicht."""
        if self.einst.lauf_lesen("gestartet"):
            return
        cfg = self.einst.laden()
        aus = self.laut.aktive_ausgabe()
        ziel = min(cfg["lautstaerke"][aus]["start"], self.einst.wirksames_max(cfg, aus, self.jetzt()))
        if self.laut.setzen(aus, ziel):
            self.log(f"Startlautstärke {ziel} % ({aus})")
        self.einst.lauf_schreiben("gestartet", {"zeit": self.jetzt()})

    # ------------------------------------------------------------ Abfragen vom Player

    def sperrt(self):
        """True, wenn der Player gerade keine Musik starten soll (Ruhezeit, Modus 'aus')."""
        return self.einst.musik_gesperrt(self.einst.laden(), self.jetzt())

    # ------------------------------------------------------------ jede Sekunde

    def tick(self, dev):
        jetzt = self.jetzt()
        cfg = self.einst.laden()
        aus = self.laut.aktive_ausgabe()

        abfrage = jetzt >= self._naechste_abfrage
        if abfrage:
            self._naechste_abfrage = jetzt + ABFRAGE_S
            try:
                self.spielt = self.spotify.spielt(dev)
            except Exception as e:                       # Netz weg: nichts Neues, alter Wert bleibt
                self.log(f"Spotify-Abfrage fehlgeschlagen: {e!r}")
                self.spielt = None
        if self.spielt is True or self._ton() is True:
            self.letzte_aktivitaet = self.dauer()
        else:
            try:
                w = self.wartet()
            except Exception:
                w = None
            if w is not None and w < SEITE_REPARATUR_S:  # Karte liegt, die Box kümmert sich gerade um die Musik
                self.letzte_aktivitaet = self.dauer()

        self._timer(dev, aus, jetzt)

        ruhe = self.einst.ruhezeit_aktiv(cfg, jetzt)
        if abfrage:
            if self.einst.musik_gesperrt(cfg, jetzt) and self.spielt is True:
                status, _ = self.spotify.pause(dev)
                self.log(f"Ruhezeit: Musik pausiert (Spotify {status})")
                self.spielt = False
            self._grenzen(cfg, aus, jetzt)

        self._auto_aus(cfg, jetzt)
        self.status.update(ausgabe=aus, ruhezeit=ruhe)

    def _ton(self):
        try:
            return self.ton()
        except Exception:
            return None

    # ------------------------------------------------------------ Schlummer-Timer

    def _timer(self, dev, aus, jetzt):
        with TIMER_SPERRE:
            self._timer_gesperrt(dev, aus, jetzt)

    def _timer_gesperrt(self, dev, aus, jetzt):
        t = self.einst.lauf_lesen("timer")
        if not t:
            return
        rest = t["ende"] - jetzt
        if rest > 0:
            if rest <= FADE_S and (self.spielt is True or self._ton() is True):
                self._ausblenden(t, aus, rest)
            return
        # Zeit ist um: pausieren und am Tonfluss prüfen, dass es wirklich still ist. Die Pause wird immer
        # gesendet, wenn Musik laufen könnte (Spotify sagt "spielt", weiß es nicht, oder es fließt Ton);
        # vorher entfiel sie, wenn Spotify fälschlich "spielt nicht" meldete oder die Gerätekennung gerade
        # fehlte, und die Musik lief die Nacht durch (Audit 12.11.2026, Befund 3).
        ueber = jetzt - t["ende"]
        ton = self._ton()
        if self._timer_pause_ok is not None and self._timer_pause_ok[0] != t["ende"]:
            self._timer_pause_ok = None              # anderer Timer als beim letzten Mal
        fertig = False
        if self.spielt is False and ton is not True and self._timer_pause_ok is None:
            fertig = True                            # es läuft nichts
        elif self._timer_pause_ok is not None and ton is not True:
            fertig = True                            # Pause angenommen und kein Ton mehr
        elif jetzt >= self._timer_naechste_pause:
            self._timer_naechste_pause = jetzt + TIMER_PAUSE_ABSTAND_S
            try:
                status, _ = self.spotify.pause(dev)
                self.log(f"Schlummer-Timer abgelaufen, Pause (Spotify {status})")
                if status and (status < 300 or status in (403, 404)):   # 404: kein aktives Gerät
                    if self._timer_pause_ok is None:
                        self._timer_pause_ok = (t["ende"], jetzt)
                    if ton is None:
                        fertig = True                # ohne Tonausgabe-Meldung: wie bisher der Antwort glauben
            except Exception as e:
                self.log(f"Schlummer-Timer: Pause fehlgeschlagen: {e!r}")
        if not fertig and ueber > TIMER_GNADE_S:
            fertig = True
            if ton is True:                          # Pause wirkt nicht: Ton über einen Neustart beenden
                stopp = getattr(self.spotify, "stopp_erzwingen", None)
                self.log("Schlummer-Timer: Musik läuft trotz Pause weiter"
                         + (" – Ton wird neu gestartet, damit sie endet." if stopp else "."))
                if stopp:
                    try:
                        stopp()
                    except Exception as e:
                        self.log(f"Schlummer-Timer: Stopp fehlgeschlagen: {e!r}")
        if fertig:
            self._timer_pause_ok = None
            self._timer_naechste_pause = 0.0
            self.spielt = False
            vorher = t.get("vorher")
            if vorher is not None:
                self.schlaf(1.5)                         # Spotify soll wirklich still sein, bevor es wieder laut wird
                self.laut.setzen(aus, vorher)
            self.einst.lauf_loeschen("timer")

    def _ausblenden(self, t, aus, rest):
        if t.get("vorher") is None:
            vorher = self.laut.lesen(aus)
            if vorher is None:
                return
            t["vorher"] = vorher                         # merken, falls der Player mittendrin neu startet
            if self.einst.lauf_lesen("timer") is None:   # inzwischen von der Seite abgebrochen
                return
            self.einst.lauf_schreiben("timer", t)
        self.laut.setzen(aus, t["vorher"] * rest / FADE_S)

    # ------------------------------------------------------------ Grenzen

    def _grenzen(self, cfg, aus, jetzt):
        t = self.einst.lauf_lesen("timer")
        if t and t.get("vorher") is not None:
            return                                       # Ausblenden läuft, nicht dazwischenfunken
        aktuell = self.laut.lesen(aus)
        grenze = self.einst.wirksames_max(cfg, aus, jetzt)
        if aktuell is not None and aktuell > grenze:
            self.laut.setzen(aus, grenze)
            self.log(f"Lautstärke {aktuell} % über der Grenze, auf {grenze} % gesetzt ({aus})")

    # ------------------------------------------------------------ Auto-Aus

    def _auto_aus(self, cfg, jetzt):
        seite = self.einst.lauf_alter("seite", jetzt)
        if seite is not None and seite < SEITE_AKTIV_S:
            self.letzte_aktivitaet = self.dauer()
        aa = cfg["auto_aus"]
        if not aa["an"]:
            self.status["auto_aus_in"] = None
            return
        rest = aa["minuten"] * 60 - (self.dauer() - self.letzte_aktivitaet)
        self.status["auto_aus_in"] = max(0, int(rest))
        if rest > 0:
            return
        self.log(f"Auto-Aus: seit {aa['minuten']} Minuten nichts gespielt, Box wird ausgeschaltet")
        self.letzte_aktivitaet = self.dauer()            # falls es nicht klappt: erst nach der nächsten Frist wieder versuchen
        try:
            self.ausschalten()
        except Exception as e:
            self.log(f"Auto-Aus fehlgeschlagen: {e}")
