janshort4all/peppa-box/software/test_bedienung.py

"""Tests der Bedienung (Touchfelder, Ein-Taste, Drehknopf) und der Hardware-Abfrage mit simulierter
Uhr und nachgebauter Hardware. Aufruf: cd software && python3 -m unittest -v test_bedienung
"""
import json
import os
import tempfile
import unittest
from unittest import mock

import bedienung
import einstellungen
import gpio
import mpr121
from bedienung import Bedienung, Hardware, Regler


class Uhr:
    def __init__(self, t=1000.0):
        self.t = t

    def __call__(self):
        return self.t


class FakeSteuerung:
    def __init__(self):
        self.aufrufe = []
        self.antwort_play = "pause"
        self.laeuft = True

    def taste_play(self):
        self.aufrufe.append(("play",))
        return self.antwort_play

    def taste_springen(self, r):
        self.aufrufe.append(("springen", r))
        return self.laeuft

    def taste_spulen(self, ms):
        self.aufrufe.append(("spulen", ms))
        return self.laeuft

    def pausieren(self):
        self.aufrufe.append(("pausieren",))
        return True

    def von_vorn(self):
        self.aufrufe.append(("von_vorn",))
        return True


class FakeAuto:
    def __init__(self):
        self.gesperrt = False

    def sperrt(self):
        return self.gesperrt


class FakeLaut:
    def __init__(self, v=40):
        self.v = {"lautsprecher": v, "kopfhoerer": 30}
        self.aus = "lautsprecher"

    def aktive_ausgabe(self):
        return self.aus

    def lesen(self, a):
        return self.v.get(a)

    def setzen(self, a, p):
        self.v[a] = int(round(p))
        return True

    def eingerichtet(self, a):
        return True


class FakeTimer:
    def __init__(self, einst):
        self.einst = einst

    def timer_starten(self, minuten, laut, einst, jetzt=None):
        self.einst.lauf_schreiben("timer", {"ende": jetzt + minuten * 60, "minuten": minuten, "vorher": None})

    def timer_abbrechen(self, laut, einst):
        had = self.einst.lauf_lesen("timer") is not None
        self.einst.lauf_loeschen("timer")
        return had


class Basis(unittest.TestCase):
    def setUp(self):
        self.tmp = tempfile.TemporaryDirectory()
        self.addCleanup(self.tmp.cleanup)
        for name, wert in (("LAUF", self.tmp.name),):
            p = mock.patch.object(einstellungen, name, wert)
            p.start()
            self.addCleanup(p.stop)
        p = mock.patch.dict(os.environ, {"HOME": self.tmp.name})
        p.start()
        self.addCleanup(p.stop)
        einstellungen._cache["mtime"] = None
        self.uhr = Uhr()
        self.wand = Uhr(1_800_000_000.0)
        self.st = FakeSteuerung()
        self.auto = FakeAuto()
        self.laut = FakeLaut()
        self.regler = mock.Mock()
        self.gesagt = []
        self.aus = []
        self.spar = []
        self.karte_liegt = (False, None)
        self.akku = {"spannung": 3.9, "prozent": 64, "richtung": "akku"}
        self.b = Bedienung(self.st, self.auto, self.regler, einstellungen, self.gesagt.append,
                           akku_info=lambda: self.akku, herunterfahren=lambda g, a: self.aus.append((g, a)),
                           karte=lambda: self.karte_liegt, jetzt=self.uhr, uhr=self.wand,
                           log=lambda t: None, timer=FakeTimer(einstellungen), laut=self.laut)

    def tippen(self, feld, dauer=0.2):
        self.b.felder({feld}, self.uhr.t)
        self.lauf(dauer, felder={feld})
        self.b.felder(set(), self.uhr.t)

    def lauf(self, s, felder=None, taste=None):
        ende = self.uhr.t + s
        while self.uhr.t < ende:
            self.uhr.t += 0.02
            if felder is not None:
                self.b.felder(felder, self.uhr.t)
            if taste is not None:
                self.b.ein_taste(taste, self.uhr.t)
            self.b.tick(self.uhr.t)


class Felder(Basis):
    def test_play_antippen(self):
        self.tippen("play")
        self.assertEqual(self.st.aufrufe, [("play",)])

    def test_play_ohne_karte_bleibt_still(self):
        self.st.antwort_play = "keine_karte"                    # Wunsch Jan 08.11.: keine Ansage
        self.tippen("play")
        self.uhr.t += 9
        self.tippen("play")
        self.assertEqual(self.gesagt, [])

    def test_play_bei_leerer_karte(self):
        self.st.antwort_play = "keine_karte"
        self.karte_liegt = (True, None)
        self.tippen("play")
        self.assertEqual(self.gesagt, ["karte_leer"])

    def test_play_in_ruhezeit(self):
        self.auto.gesperrt = True
        self.tippen("play")
        self.assertEqual(self.st.aufrufe, [])
        self.assertEqual(self.gesagt, ["ruhezeit"])

    def test_play_lange_gehalten_nichts(self):
        self.tippen("play", dauer=1.8)
        self.assertEqual(self.st.aufrufe, [])

    def test_play_2_s_halten_von_vorn(self):
        self.tippen("play", dauer=4.0)
        self.assertEqual(self.st.aufrufe, [("von_vorn",)])          # einmal, kein Pause/Weiter

    def test_phantom_beruehrung_loest_nichts_aus(self):
        # Befund 09.11.2026: Play-Feld meldete ohne Finger ständig kurze Berührungen
        log = []
        self.b.log = log.append
        for feld in ("play", "vor", "zurueck", "schlaf", "play"):
            self.tippen(feld, dauer=0.04)
            self.uhr.t += 1
        self.assertEqual(self.st.aufrufe, [])
        self.assertEqual(self.gesagt, [])
        self.assertEqual(self.b.kurz_gesamt, 5)
        self.assertEqual(len([z for z in log if "zu kurze" in z]), 1)     # nur einmal je Minute gemeldet
        self.lauf(61)
        self.assertEqual(len([z for z in log if "zu kurze" in z]), 2)     # Rest zusammengefasst
        self.assertIn("play 1×", log[-1])
        self.lauf(120)
        self.assertEqual(len([z for z in log if "zu kurze" in z]), 2)     # nichts Neues, keine Meldung

    def test_echtes_antippen_ab_70_ms(self):
        self.tippen("play", dauer=0.08)
        self.tippen("vor", dauer=0.08)
        self.assertEqual(self.st.aufrufe, [("play",), ("springen", 1)])

    def test_vor_zurueck_antippen(self):
        self.tippen("vor")
        self.tippen("zurueck")
        self.assertEqual(self.st.aufrufe, [("springen", 1), ("springen", -1)])

    def test_vor_halten_spult_wiederholt_ohne_sprung(self):
        self.tippen("vor", dauer=2.4)                       # 0,7 s, dann alle 0,8 s: 0,7 1,5 2,3
        self.assertEqual(self.st.aufrufe, [("spulen", 15000)] * 3)
        self.st.aufrufe.clear()
        self.tippen("zurueck", dauer=0.9)
        self.assertEqual(self.st.aufrufe, [("spulen", -15000)])

    def test_mehrere_felder_loesen_nichts_aus(self):
        self.b.felder({"play"}, self.uhr.t)
        self.lauf(0.05, felder={"play"})
        self.lauf(0.3, felder={"play", "vor"})
        self.lauf(0.1, felder={"vor"})
        self.b.felder(set(), self.uhr.t)
        self.lauf(1.0, felder={"vor", "zurueck"})          # auch kein Spulen
        self.b.felder(set(), self.uhr.t)
        self.assertEqual(self.st.aufrufe, [])
        self.tippen("play")                                 # danach wieder normal
        self.assertEqual(self.st.aufrufe, [("play",)])

    def test_abbrechen_loest_nichts_aus(self):
        self.b.felder({"play"}, self.uhr.t)
        self.lauf(0.2, felder={"play"})
        self.b.felder_abbrechen()
        self.b.felder(set(), self.uhr.t)
        self.assertEqual(self.st.aufrufe, [])

    def test_mond_stufen_und_aus(self):
        for erwartet in ("timer_15", "timer_30", "timer_45", "timer_60", "timer_aus", "timer_15"):
            self.tippen("schlaf")
            self.assertEqual(self.gesagt[-1], erwartet)
        t = einstellungen.lauf_lesen("timer")
        self.assertEqual(t["minuten"], 15)
        self.assertAlmostEqual(t["ende"], self.wand.t + 900)

    def test_mond_nach_seiten_timer_naechste_stufe(self):
        einstellungen.lauf_schreiben("timer", {"ende": self.wand.t + 1200, "minuten": 20, "vorher": None})
        self.tippen("schlaf")
        self.assertEqual(self.gesagt, ["timer_30"])

    def test_mond_5s_akku_und_kein_timer(self):
        self.tippen("schlaf", dauer=5.3)
        self.assertEqual(self.gesagt, ["akku_60"])
        self.assertIsNone(einstellungen.lauf_lesen("timer"))
        self.tippen("schlaf", dauer=3.0)                    # zwischen 1,5 und 5 s: nichts
        self.assertEqual(self.gesagt, ["akku_60"])

    def test_akku_ansage_varianten(self):
        for info, name in (({"richtung": "laedt", "prozent": None}, "akku_laedt"),
                           ({"richtung": "voll", "prozent": 99}, "akku_voll"),
                           ({"richtung": "akku", "prozent": 3}, "akku_10"),
                           ({"richtung": "akku", "prozent": 96}, "akku_100"),
                           ({"fehler": "x"}, "akku_unbekannt"), (None, "akku_unbekannt")):
            self.akku = info
            self.gesagt.clear()
            self.b._angesagt.clear()
            self.b.akku_ansagen()
            self.assertEqual(self.gesagt, [name], info)


class EinTaste(Basis):
    def drueck(self, dauer):
        self.b.ein_taste(False, self.uhr.t)                 # Startwert: los
        self.lauf(dauer, taste=True)
        self.lauf(0.1, taste=False)

    def test_kurz_akku(self):
        self.drueck(0.3)
        self.assertEqual(self.gesagt, ["akku_60"])
        self.assertEqual(self.aus, [])

    def test_zwei_sekunden_tschuess_und_aus_beim_loslassen(self):
        self.b.ein_taste(False, self.uhr.t)
        self.lauf(2.1, taste=True)
        self.assertEqual(self.gesagt, [])                   # noch gedrückt: kein „Tschüss“
        self.assertIn(("pausieren",), self.st.aufrufe)
        self.assertEqual(self.aus, [])                      # noch gedrückt: nicht ausschalten
        self.lauf(1.0, taste=True)
        self.assertEqual(self.aus, [])
        self.lauf(0.1, taste=False)
        self.assertEqual(self.aus, [("Ein-Taste", "tschuess")])

    def test_klemmt_schaltet_nie_aus(self):
        self.b.ein_taste(False, self.uhr.t)
        self.lauf(16, taste=True)
        self.lauf(0.1, taste=False)
        self.assertEqual(self.aus, [])
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
