janshort4all/peppa-box/(commit log)

2026-10-25 Peppa Box: Stand 25.10.2026 (Boden-Träger, ohne DAC)
    Parametrisches Gehäusemodell v4, Prüfungen, STL-Dateien, Verdrahtungsplan, Einkaufsliste und Projekt-Steckbrief.
    Claude-Session: https://claude.ai/code/session_01CX22xqrResKFwbGYgeQGoK
    [01_korpus_beige.stl, 01m_modifier_korpus_OHNE_fuzzy.stl, 02a_deckel_kern_orange.stl, 02b_deckel_haut_beige.stl, 03_deckelrahmen.stl, 04_kartenfach.stl, 05_boden_traeger.stl, 06_stoffrahmen.stl]
2026-10-25 Boden bündig mit V-Fuge, Kragen 0,2 mm, relative Pfade
    Boden außen exakt so groß wie der Korpus, je 0,8 mm Fase an Korpus-Unterkante und Boden-Oberkante, Standkante gefast. Zentrierkragen mit 0,2 mm Spiel, Eckdome 0,4 mm nach innen. Skripte ohne feste Pfade. Steckbrief um Auswertung des Prototyps ergänzt.
    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
    [01_korpus_beige.stl, 05_boden_traeger.stl, ansicht_zusammenbau_NICHT_DRUCKEN.stl, coupon_C2_deckelecke_korpus.stl, coupon_C8_bodenecke_boden.stl, coupon_C8_bodenecke_korpus.stl]
2026-10-25 RC522 gemessen, 90°-Stiftleiste und Stecker-Zone im Modell, Prüfbericht aktualisiert
    Claude-Session: https://claude.ai/code/session_01ERGekp6BcNin3gn68nSpAg
2026-10-25 RC522: Steckerlänge gemessen (14 mm ab Platinenkante), Zone angepasst
    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
2026-10-25 Steckbrief: RC522 RST an 3,3 V, Belegung am Klemmen-Aufsatz
    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
2026-10-25 RC522-Testprogramm (spidev, Soft-Reset, 4/7/10-Byte-UID)
    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
    [rc522_test.py]
2026-10-25 Steckbrief: RC522-Test abgeschlossen (3 cm durch Plexiglas)
    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
2026-10-25 Link direkt auf der Karte (NDEF, NTAG und MIFARE Classic), Liste entfernt
    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
2026-10-25 Einfarbiger Deckel (02a+02b vereinigt) für den Prototyp
    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
    [02_deckel_einfarbig.stl]
2026-10-26 Deckelrahmen-STL war gespiegelt: Druckausrichtung als Drehung statt Spiegelung, Prüfung auf Spiegelung, Steckbrief
    [03_deckelrahmen.stl, 08_ein_taste_orange.stl, ansicht_bauteile_platzhalter_NICHT_DRUCKEN.stl, coupon_C2_deckelecke_rahmen.stl, coupon_C3_taste_halter.stl, coupon_C3_taste_kappe.stl]
2026-10-27 Eltern-Seite Stufe 2: Lautstärke mit Grenzen, Schlummer-Timer, Ruhezeit, Auto-Aus
    Automatik läuft im Player (automatik.py), die Seite ändert nur Einstellungen und Dateien.
    Neu: einstellungen.py, lautstaerke.py, automatik.py, spotify.spielt(), 31 Tests mit simulierter Uhr.
    Lautsprecher-Regler erst nach Einrichtung der Software-Lautstärke (MAX98357A).
    Claude-Session: https://claude.ai/code/session_01C8BwHVHgTZXKGaEiyRpEHp
2026-10-27 Seite: Formular nicht mehr durch nachladende Werte überschreiben (Höchstlautstärke 100 % ging verloren)
    Beim Öffnen der Einstellungen überschrieb eine langsame Antwort der Box die Eingaben, gespeichert wurden
    die alten Werte. Formular wird nur noch gefüllt, wenn nichts verändert wurde; veraltete Antworten werden
    verworfen; Regler und Schalter zeigen keine veralteten Werte nach einer Bedienung.
    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
2026-10-27 Deckel-Probedruck: Symbole mit Abstand zur Ringnut, RC522 tiefer, Schiene am Quarz offen
    - pad_symbols: Mindestabstand 1,8 mm zur Nut, vor/zurück als überlappende Dreiecke,
    Mindestbreite 0,9 mm; Prüfung in check.py
    - SKIN 0,8 mm (Schichtraster), einfarbiger Deckel aus build_all.py als ein Körper
    - RC522 5 mm tiefer, Schraubblöcke hinten am Deckelrahmen 2 mm kürzer,
    deckelseitige Schienenlippe am Stiftleisten-Ende 18 mm offen (Quarz)
    - Steckbrief-Nachtrag 27.10.
    Claude-Session: https://claude.ai/code/session_01VRacZoDppXFf3HKknobjyD
    [02_deckel_einfarbig.stl, 02a_deckel_kern_orange.stl, 02b_deckel_haut_beige.stl, 03_deckelrahmen.stl, 04_kartenfach.stl, ansicht_bauteile_platzhalter_NICHT_DRUCKEN.stl, ansicht_zusammenbau_NICHT_DRUCKEN.stl, coupon_C2_deckelecke_deckel.stl]
2026-10-27 Deckel kopfüber druckbar (Fasen, Mulde 45°, Opferschicht, Coupon C9); Karte mit Einschubtasche für Papier-Cover
    - Deckel: Fase Oberkante 0,5 mm, Einführfase Kartenschlitz, Ein-Taste-Mulde mit 45°-Wand,
    Opferschicht 0,2 mm über dem Tastenloch; deckel_kopfueber()
    - Coupon C9: Deckelstücke kopfüber (Felder, Taste/Schlitz)
    - Karte: Einschubtasche oben offen, Lippen mit 45°-Unterseite, Einleger 67 × 68 mm,
    Griffmulde, Druck Rückseite unten; Prüfung mit echter Kartengeometrie
    - Steckbrief-Nachtrag
    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
    [02_deckel_einfarbig.stl, 02a_deckel_kern_orange.stl, 02b_deckel_haut_beige.stl, 10_karte_orange.stl, ansicht_bauteile_platzhalter_NICHT_DRUCKEN.stl, ansicht_zusammenbau_NICHT_DRUCKEN.stl, coupon_C2_deckelecke_deckel.stl, coupon_C3_taste_deckelstueck.stl]
2026-11-02 Verdrahtungsplan: GAIN an GND A (12 dB); Steckbrief-Nachtrag
    Claude-Session: https://claude.ai/code/session_01VRacZkqpgYqyyXAguRELtL
2026-11-02 Signaltöne: Startton (Dienst peppa-startton) und Bereit-Ton im Player
    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
2026-11-02 Ansage „Peppa Box bereit“ statt Pieptönen; Startton-Dienst entfernt
    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
2026-11-02 Tasterhalter: Beinchen-Kanal 14 mm für KHT1212PV73 (Beinchen ca. 13 mm)
    Claude-Session: https://claude.ai/code/session_01VRacZnTGBPUPHFQHoMJCfG
    [03_deckelrahmen.stl, ansicht_zusammenbau_NICHT_DRUCKEN.stl, coupon_C3_taste_halter.stl]
2026-11-02 Gegen Knacken: Mischer + Dienst peppa-stille, SD beim Start stumm und verzögert frei
    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
2026-11-02 WLAN ohne Netplan (Skript mit Rückweg und Rückfall-Sicherung)
    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
2026-11-02 Steckbrief: USB-C-Breakout ohne Stiftleiste, CC-Widerstände fehlen auf der Platine
    Claude-Session: https://claude.ai/code/session_01VRacZnQAu4YFMiqRHwNpU9
2026-11-02 Eltern-Seite lauscht auf IPv6 und IPv4
    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
2026-11-02 Ein-Taste bündig mit dem Deckel, Mulde und Opferschicht entfallen
    Claude-Session: https://claude.ai/code/session_01VRacZjAzJLfLJZHzL5LLKY
    [02_deckel_einfarbig.stl, 02a_deckel_kern_orange.stl, 02b_deckel_haut_beige.stl, 08_ein_taste_orange.stl, ansicht_zusammenbau_NICHT_DRUCKEN.stl, coupon_C2_deckelecke_deckel.stl, coupon_C3_taste_deckelstueck.stl, coupon_C3_taste_kappe.stl]
2026-11-03 Eltern-Seite: Raspotify-Protokoll in den Meldungen, Ansicht springt ans Ende
    Claude-Session: https://claude.ai/code/session_01VRacZnD7dLAc3m6rof35gD
2026-11-03 Player: Selbstreparatur der Spotify-Wiedergabe (Steuerung mit Prüfung nach jedem Start)
    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
2026-11-03 Touch-Modul: gemessene Größe 34 × 20 mm (STEMMA-QT-Ausführung), Mulde unter der Verteiler-Brücke angepasst
    Claude-Session: https://claude.ai/code/session_01VRacZo5hBPrPkgTfgKuT2K
    [03_deckelrahmen.stl, ansicht_bauteile_platzhalter_NICHT_DRUCKEN.stl, ansicht_zusammenbau_NICHT_DRUCKEN.stl, coupon_C2_deckelecke_rahmen.stl, coupon_C3_taste_halter.stl]
2026-11-03 Touch-Modul: Höhe 5 mm vorgesehen
    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
    [ansicht_bauteile_platzhalter_NICHT_DRUCKEN.stl]
2026-11-03 Korpus: Löcher rechts mit flacher Oberseite, USB-C-Halter (Soldered 333011) mit 2 Domen und Steckeröffnung 13 × 7 statt Rundloch
    Claude-Session: https://claude.ai/code/session_01VRacZmfaKLfVcijD7wXcQG
    [01_korpus_beige.stl, 01m_modifier_korpus_OHNE_fuzzy.stl, ansicht_bauteile_platzhalter_NICHT_DRUCKEN.stl, ansicht_zusammenbau_NICHT_DRUCKEN.stl, coupon_C1_wand_hinten_usbc.stl, coupon_C1_wand_rechts_drehgeber_klinke.stl, coupon_C2_deckelecke_korpus.stl, coupon_C8_bodenecke_korpus.stl]
2026-11-03 Korpus final vorbereitet: Buchsenhöhe USB-C 3,4 gemessen, volle Wand am Drehgeber, Messwerte Drehgeber; Knopf noch offen
    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
    [01_korpus_beige.stl, 07_drehknopf_orange.stl, ansicht_bauteile_platzhalter_NICHT_DRUCKEN.stl, ansicht_zusammenbau_NICHT_DRUCKEN.stl, coupon_C1_wand_hinten_usbc.stl, coupon_C1_wand_rechts_drehgeber_klinke.stl]
2026-11-03 Korpus: glatte Flächen für Fuzzy Skin (Anschlussfeld B), Schrauben 3,0 × 12 (Dome, Senkungen, Ring-Dome am Deckelrahmen), Knopf für gekürzte Achse
    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
    [01_korpus_beige.stl, 01m_modifier_korpus_OHNE_fuzzy.stl, 03_deckelrahmen.stl, 07_drehknopf_orange.stl, ansicht_bauteile_platzhalter_NICHT_DRUCKEN.stl, ansicht_zusammenbau_NICHT_DRUCKEN.stl, coupon_C1_wand_hinten_usbc.stl, coupon_C1_wand_rechts_drehgeber_klinke.stl]
2026-11-03 Korpus final: Tasche für Drehgeber-Nase, Klinken-Tasche, Riemenloch 7,9, Senkungen Kopf Ø 6, Modifier deckungsgleich
    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
    [01_korpus_beige.stl, 01m_modifier_korpus_OHNE_fuzzy.stl, 09_riemen_gegenplatte.stl, ansicht_bauteile_platzhalter_NICHT_DRUCKEN.stl, ansicht_zusammenbau_NICHT_DRUCKEN.stl, coupon_C1_wand_rechts_drehgeber_klinke.stl, coupon_C2_deckelecke_korpus.stl]
2026-11-03 Coupon C10: Fuzzy-Skin-Probe (Ecke hinten rechts mit Modifier), Empfehlung Fuzzy 0,15/0,3
    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
    [coupon_C10_fuzzy_ecke.stl, coupon_C10_fuzzy_ecke_MODIFIER_ohne_fuzzy.stl]
2026-11-04 Korpus-Druck 04.11. ausgewertet: Fuzzy nur über neue Außenhaut, Nachbildung der Slicer-Logik
    - Ursache Fuzzy innen: Löcher durch die Wand schneiden den Wandring auf, der Slicer zählt die Innenseite dann zur Kontur
    - neuer Modifier 01f_modifier_korpus_FUZZY_aussenhaut (1 mm Außenhaut, glatte Flächen und Fasen ausgespart), 01m entfernt
    - fuzzy_check.py: je 0,2-mm-Schicht wie ElegooSlicer, Bild out/fuzzy_analyse.png; check.py prüft Fuzzy innen = 0
    - Coupon C10 auf neuen Modifier, neuer Probeabschnitt C11 (obere 36 mm)
    - README: neuer Ablauf im Slicer, Naht aufmalen, Lüfter konstant, Innenrand
    - Steckbrief: Nachtrag 04.11.
    Claude-S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
    [01f_modifier_korpus_FUZZY_aussenhaut.stl, 01m_modifier_korpus_OHNE_fuzzy.stl, coupon_C10_fuzzy_ecke_MODIFIER_fuzzy_aussenhaut.stl, coupon_C10_fuzzy_ecke_MODIFIER_ohne_fuzzy.stl, coupon_C11_korpus_oben.stl, coupon_C11_korpus_oben_MODIFIER_fuzzy_aussenhaut.stl]
2026-11-04 USB-C-Öffnung auf Steckergehäuse 10 × 6 verkleinert, Kippeln hinten links, Erklärbild USB-C
    - USBC_PLUG 13 × 7 R3 → 10,8 × 7,0 R2 (Steckergehäuse Jan 10 × 6), Korpus und Coupon C1 neu gebaut
    - usbc_ansicht.py / out/usbc_ansicht.png: warum die Öffnung gehäusegroß ist und die Platinenkante sichtbar bleibt
    - Innenrand 8 mm gegen das Abheben der hinteren linken Ecke
    - Steckbrief: Nachtrag 04.11. (2)
    Claude-Session: https://claude.ai/code/session_01VRacZnwGfN3QPJafKfRVGh
    [01_korpus_beige.stl, ansicht_zusammenbau_NICHT_DRUCKEN.stl, coupon_C10_fuzzy_ecke.stl, coupon_C11_korpus_oben.stl, coupon_C1_wand_hinten_usbc.stl]
2026-11-04 Korpus: vollständige Slicer-Einstellungen (README), Prozess Fuzzy „Nur lackiert“, Steckbrief Nachtrag (3)
    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
2026-11-04 Bild und Anleitung: Naht aufmalen (Rückansicht, Rundung hinten links)
    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
2026-11-04 Korpus: Kammerdecke als 45°-Satteldach statt 40-mm-Brücke, Mindest-Schichtdauer, konzentrische Oberfläche
    - ROOF/roof()/roof_unter(): Satteldach mit schräg ansteigendem First (0,04 mm/mm),
    schließt über ca. 27 Schichten statt einer 334-s-Brückenschicht
    - Kammer dicht, Lautsprecher und Deckelrahmen frei, Fuzzy innen 0
    - README/Steckbrief: Muster der Oberfläche Konzentrisch, Schichtdauer 70/100 s,
    Äußere Wände nicht verlangsamen
    - gcode_pruefung.py meldet Schichtdauer-Sprünge > 25 %
    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
    [01_korpus_beige.stl, ansicht_zusammenbau_NICHT_DRUCKEN.stl, coupon_C11_korpus_oben.stl, coupon_C1_wand_rechts_drehgeber_klinke.stl, coupon_C2_deckelecke_korpus.stl]
2026-11-05 Deckel: kopfüber-Export 02a/02b (Drehung um y), Coupon C12 Oberseite, Deckel-Einstellungen, Draufsicht
    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
    [02a_deckel_kern_orange.stl, 02b_deckel_haut_beige.stl, coupon_C12_deckel_oberseite_haut_beige.stl, coupon_C12_deckel_oberseite_kern_orange.stl, coupon_C9_deckel_kopfueber_felder.stl, coupon_C9_deckel_kopfueber_taste_schlitz.stl]
2026-11-05 Steckbrief: Lötfahnen der Klinkenbuchse 1503 09 gemessen und zugeordnet
    Claude-Session: https://claude.ai/code/session_01VRacZkFUTXrponn8dRXmQT
2026-11-05 Deckel: Symbole und Ringe bündig orange eingelegt (keine Brücken), Haut-Modifier 1 Wand, C12 neu, G-Code-Prüfung Deckel erweitert
    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
    [02a_deckel_kern_orange.stl, 02m_modifier_deckel_haut_1wand.stl, ansicht_zusammenbau_NICHT_DRUCKEN.stl, coupon_C12_deckel_oberseite_MODIFIER_haut_1wand.stl, coupon_C12_deckel_oberseite_kern_orange.stl]
2026-11-05 Deckel: Symbole wieder vertieft (ertastbar); PLA-Opfer-Einleger 02p, Brücken-Modifier 02r, C12 erweitert, README Varianten A/B
    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
    [02a_deckel_kern_orange.stl, 02p_opfer_einleger_PLA.stl, 02r_modifier_deckel_bruecke_richtung.stl, ansicht_zusammenbau_NICHT_DRUCKEN.stl, coupon_C12_deckel_oberseite_MODIFIER_bruecke_richtung.stl, coupon_C12_deckel_oberseite_kern_orange.stl, coupon_C12_deckel_oberseite_opfer_PLA.stl]
2026-11-05 Erklärbild Deckel vorher/nachher (Schicht 3 und 5 am Play-Knopf); Steckbrief: Variante B
    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
2026-11-05 Deckel-Prüfung: Warnung bei Modifizierer mit eigenem Filament, C12-Lage; README/Steckbrief
    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
2026-11-05 Drehknopf über die volle Drehgeberachse (nicht kürzen), Führung + Klemmsitz, Steg 8 mm; README Knopf ohne Fuzzy
    - ENC_OUT 21,8 (gemessen: 22,2 ab Mutterauflage), ENC_SLOT_D 11,3
    - Knopf 22,8 mm lang, Führung Ø 6,3 im ungeschlitzten Teil, Klemmsitz Ø 6,1 im geschlitzten Teil,
    Steg 8 mm, Achsende am Knopfboden (bis Anschlag aufschieben)
    - Schnittbild drehknopf_schnitt.png, Steckbrief-Nachtrag
    Claude-Session: https://claude.ai/code/session_01VRacZjAn9Zp72qN8TRLDMu
    [07_drehknopf_orange.stl, ansicht_zusammenbau_NICHT_DRUCKEN.stl]
2026-11-05 C12 freigegeben: Brücke 30 mm/s, Brückenlüfter 100 % für den Deckel; Steckbrief
    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
2026-11-05 Deckel-Prüfung: Warnungen wenn 02m/02r nicht wirken; Steckbrief
    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
2026-11-05 Frontgitter mit neuem Logo im Modell: beige, Logo orange bündig, Luftraum, C13
    - Neues Logo (peppa_box_logo.png) vektorisiert, 99,7 % deckungsgleich mit der Vorlage
    - gitter(): 400 Löcher Ø 3,3 im Wabenraster 4,2, Logo 0,8 mm bündig eingelegt (Schicht 1–4),
    Luftraum 2,5 mm hinter dem Logo, 6 Stifte; ersetzt den Stoffrahmen in build()
    - Druckdateien 06a/06b, einfarbige Hörprobe, Coupon C13; STL geschlossen
    - check.py: Schichtanalyse Gitter; README-Abschnitt „Gitter“, Prüfbericht, Bild gitter_ansicht.png
    - Steckbrief: Nachtrag 05.11.2026 (6)
    Claude-Session: https://claude.ai/code/session_01VRacZnUi16DWcMv4exduua
    [06_gitter_einfarbig_HOERPROBE.stl, 06_stoffrahmen.stl, 06a_gitter_beige.stl, 06b_gitter_logo_orange.stl, ansicht_zusammenbau_NICHT_DRUCKEN.stl, coupon_C13_gitter_ecke_beige.stl, coupon_C13_gitter_ecke_logo_orange.stl]
2026-11-06 Boden: Fuzzy-Modifier 05f für den sichtbaren Rand, Druckeinstellungen im README; Steckbrief
    Claude-Session: https://claude.ai/code/session_01VRacZkafNLPecwo8en1QRC
    [05f_modifier_boden_FUZZY_rand.stl]
2026-11-06 Gitter einfarbig, Logo als eigene erhabene Buchstaben zum Kleben; C14 statt C13
    - C13 (Logo eingelegt, zweifarbig) verworfen: Fäden, Fehler im Orange, verbrannter Fleck
    - gitter(): kein Einleger mehr; Sacklöcher für die Buchstaben-Stifte
    - Buchstaben 1,2 mm dick, 2 Stifte je Buchstabe (Strahlen: geformter Stift), alle 11 Teile auf einer Platte
    - check.py/docs: Schichtanalyse für Gitter und Buchstaben, README „Gitter“ mit Einkleben
    - Steckbrief: Nachtrag 06.11.2026
    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
    [06_gitter_einfarbig_HOERPROBE.stl, 06a_gitter_beige.stl, 06b_gitter_logo_orange.stl, 06b_logo_buchstaben_orange.stl, ansicht_zusammenbau_NICHT_DRUCKEN.stl, coupon_C13_gitter_ecke_beige.stl, coupon_C13_gitter_ecke_logo_orange.stl, coupon_C14_buchstaben_P_e_p_orange.stl]
2026-11-06 Gitter: geglättetes Logo-Feld ohne lose Einzellöcher (GR_HALO 16)
    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
    [06a_gitter_beige.stl, ansicht_zusammenbau_NICHT_DRUCKEN.stl, coupon_C14_gitter_ecke_beige.stl]
2026-11-06 Klangoptimiertes Gitter: rundes Lochfeld in Ringen vor dem Lautsprecher, Logo darüber und darunter
    - gitter_holes(): 222 Löcher in konzentrischen Ringen, nur vor dem Lautsprecher (45 % offen statt 11 %)
    - gitter_layout(): „peppa“ über, „BOX“ unter dem Feld, gleicher Maßstab (0,644), Strahlen eingepasst
    - Strahlen in flachen Taschen; Luftraum entfällt (Gitter überall 3,6 mm)
    - check.py: Dämpfungs-Abschätzung; Coupon C15 (obere Hälfte); README, Prüfbericht, Bilder; Steckbrief
    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
    [06a_gitter_beige.stl, 06b_logo_buchstaben_orange.stl, ansicht_zusammenbau_NICHT_DRUCKEN.stl, coupon_C14_buchstaben_P_e_p_orange.stl, coupon_C14_gitter_ecke_beige.stl, coupon_C15_buchstaben_peppa_orange.stl, coupon_C15_gitter_oben_beige.stl]
2026-11-06 Gitter zurück auf Variante A mit geglättetem Logo-Feld (Entscheidung Jan)
    Revert von efb8d0c (klangoptimiertes Gitter); Steckbrief behält Nachtrag (3)
    und bekommt Nachtrag (4) mit der Entscheidung und den vier verworfenen Entwürfen.
    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
    [06a_gitter_beige.stl, 06b_logo_buchstaben_orange.stl, ansicht_zusammenbau_NICHT_DRUCKEN.stl, coupon_C14_buchstaben_P_e_p_orange.stl, coupon_C14_gitter_ecke_beige.stl, coupon_C15_buchstaben_peppa_orange.stl, coupon_C15_gitter_oben_beige.stl]
2026-11-07 README: vollständige Einstellungen für die Logo-Buchstaben; Steckbrief: Gitterdruck mit Härchen
    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
2026-11-07 Kartenfach: Rastnase mit 0,7 mm Überdeckung, Karte mit Rille und Einführfase, Coupon C15
    Vorher hatte die Nase der Federzunge 0 mm Überdeckung, die Karte hielt nur durch
    Reibung. Neu: Nase 1,5 mm (0,7 über der Karte), Rille 0,9 mm in der Karte mit
    Auszugsflanke RAST_ALPHA (Probedruck C15: 20/30/40°), Einführfase 30°.
    Gesteckte Karte steht im Modell auf dem Fachboden. check.py ohne Kollision.
    Claude-Session: https://claude.ai/code/session_01VRacZj5LEL9s24bEA582NK
    [04_kartenfach.stl, 10_karte_orange.stl, ansicht_bauteile_platzhalter_NICHT_DRUCKEN.stl, ansicht_zusammenbau_NICHT_DRUCKEN.stl, coupon_C15_karte_rastung_20grad.stl, coupon_C15_karte_rastung_30grad.stl, coupon_C15_karte_rastung_40grad.stl]
2026-11-07 Gitter: engeres Spiel (0,1) für die geformten Stifte der Strahlen, Steckbrief-Nachtrag
    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
    [06a_gitter_beige.stl, ansicht_zusammenbau_NICHT_DRUCKEN.stl]
2026-11-07 Kartenfach: Schraubensenkung bis unten durch, Rastnase mit 45°-Enden; Druckeinstellungen Kartenfach + C15
    Die Senkung endete 8 mm über der Unterkante, das Seitenteil versperrte den
    Schraubendreher. Jetzt durchgehend, Säule Ø 6 frei. README: vollständige
    Einstellungen für Kartenfach und C15 auf einer Platte. check.py ohne Kollision.
    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
    [04_kartenfach.stl, ansicht_zusammenbau_NICHT_DRUCKEN.stl]
2026-11-07 Niederhalter für die Steckkabel auf der gelben Stiftleiste (Steg 65 × 20 × 4, Säulen Ø 6, M2,5)
    Claude-Session: https://claude.ai/code/session_01VRacZoApkDnaq3UMkUE9w3
    [11_niederhalter_stiftleiste.stl, ansicht_zusammenbau_NICHT_DRUCKEN.stl]
2026-11-07 Kartenfach: Steg unter der Zungenspitze als Druckhilfe (keine schwebende Zungen-Unterseite); README Kühlung/Druckzeit
    ElegooSlicer meldete schwebende Überhänge: Die Zunge hing im Druck 19 mm frei über
    dem unteren Schlitz. Mit Steg wird ihre Unterseite eine beidseitig gehaltene Brücke.
    Steg nach dem Druck durchtrennen. check.py ohne Kollision.
    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
    [04_kartenfach.stl, ansicht_zusammenbau_NICHT_DRUCKEN.stl]
2026-11-07 Niederhalter: Senkung tief (Boden 12,9 über Platine), Kragen Ø 7,2 – passt für Jans vorhandene Pi-Schraube
    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
    [11_niederhalter_stiftleiste.stl, ansicht_zusammenbau_NICHT_DRUCKEN.stl]
2026-11-07 Gitter: 235/230 °C und Z-Hub 0 gegen Fäden; Steckbrief-Nachtrag mit Schichtanalyse
    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
2026-11-07 Gitter: Teilung 4,7 statt 4,2 (Steg 1,4) – Slicer umfährt jetzt jedes Loch; erste Schicht 0,45, Elefantenfuß 0; Steckbrief-Nachtrag
    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
    [06a_gitter_beige.stl, ansicht_zusammenbau_NICHT_DRUCKEN.stl, coupon_C14_gitter_ecke_beige.stl]
2026-11-07 Gitter: erste Schicht ausgewertet; 'Nur eine Wand in der ersten Schicht' aus; Steckbrief-Nachtrag
    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
2026-11-08 Verdrahtungsplan neu nach Baugruppen mit Aufdrucken des Klemmen-Aufsatzes
    Claude-Session: https://claude.ai/code/session_01VRacZmymCPXAMGur6K1SHP
2026-11-08 Software für alle Bedienelemente: Touch, Drehknopf, Ein-Taste, Kopfhörer, Akku, Ansagen
    - MPR121 (I2C 0x5A, INT P05): vier Felder E0 zurück, E1 Play, E2 vor, E3 Mond; Gesten
    (antippen, halten = spulen, Mond 5 s = Akku), Mehrfachberührung ignoriert, Selbstheilung
    - Drehknopf STEC11B03 über Kernel-Overlay rotary-encoder (steps-per-period=2), Rückfall
    eigene Abtastung; Lautstärke mit Grenzen
    - Ein-Taste an SCL: Pegel aus GPIO-Register; kurz = Akku, 2 s = Tschüss + aus beim Loslassen
    - Kopfhörer an P26: Raspotify-Ausgang umschalten (Root-Helfer peppa-ausgang), Musik läuft weiter
    - Akku-Wache: Warnung, sicheres Ausschalten bei leerem Akku
    - Ansagen mit Rückfall Aufnahme -> pico2wav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
2026-11-08 Einrichtung frisches System: i2c-dev laden, zweiter Durchlauf nach Neustart für den Lautsprecher
    Claude-Session: https://claude.ai/code/session_01VRacZjpsCxhHVJopVxpQDV
2026-11-08 Ansage 'Leg eine Karte auf' abgeschaltet (Wunsch Jan); Test angepasst
    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
2026-11-08 Knistern behoben: Verstärker-SD fest hoch statt offen, ALSA mischt L+R (peppa_mono)
    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
    [ausgang.py, test_lautsprecher.py]
2026-11-08 Steckbrief: offene Punkte Sprachausgaben, Spotify-Anmeldung über die Seite
    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
2026-11-09 Gummiecken mit Füßen (TPU orange): Rahmen aus 4 Eckschuhen + Ring, Rastwulst unter der Fuge, Coupon C16, Bilder, README, Steckbrief
    Claude-Session: https://claude.ai/code/session_01VRacZjdsZfaHC9GhQwEqEr
    [12_gummiecken_TPU_orange.stl, ansicht_zusammenbau_NICHT_DRUCKEN.stl, coupon_C16_gummiecke_wulst_0-4.stl, coupon_C16_gummiecke_wulst_0-5.stl, coupon_C16_gummiecke_wulst_0-6.stl]
2026-11-09 Gummiecken verschraubt: vier einzelne Ecken (Form C 20/8) mit PETG-Hülse an den Eckschrauben (3,0 × 16), Ring entfällt; C16, Bilder, README, Steckbrief, Einkaufsliste
    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
    [12_gummiecke_TPU_orange.stl, 12_gummiecken_TPU_orange.stl, 13_eckhuelse_PETG.stl, ansicht_zusammenbau_NICHT_DRUCKEN.stl, coupon_C16_gummiecke_wulst_0-4.stl, coupon_C16_gummiecke_wulst_0-5.stl, coupon_C16_gummiecke_wulst_0-6.stl]
2026-11-09 Gummiecken: TPU gekauft (TINMORRY TPU 95A Orange, 1 kg); Einkaufsliste, README-Einstellungen (Herstellerwerte), Steckbrief-Nachtrag mit RAL-Abgleich Elegoo-Orange
    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
2026-11-09 Steckbrief: Regel kein Umbau an der Box; Nachtrag Etiketten-Konzept (offen)
    Claude-Session: https://claude.ai/code/session_01VRacZkWV6ZXR3mraedaENC
2026-11-09 Etiketten über dm (CEWE Freiform-Sticker): stickerbogen.py mit Testbogen 60 mm; Steckbrief
    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
2026-11-09 Stabilität: Kopfhörer ohne Raspotify-Neustart, Phantom-Berührungen, Diagnose
    - Neue Tonausgabe ausgabe.py (librespot --backend subprocess): wechselt Lautsprecher/Kopfhörer
    ohne Raspotify-Neustart, fällt bei Fehlern auf den Lautsprecher zurück, meldet den Tonfluss
    - Ereignis-Programm ereignis.py (LIBRESPOT_ONEVENT) und Empfang rueckmeldung.py im Player
    - ausgang.py: Umschalten über die Vorgabe, Prüfung ob die Ausgabe folgt, Sperre bei Fehlern,
    Kopfhörer-Regler einschalten, Verstärker nach SD-Pegel halten; ohne Einrichtung kein Umschalten
    - Touch: MPR121 stärker gemittelt und entprellt, Berührungen unter 70 ms lösen nichts aus
    - Steuerung: Ton-Neustart über den Helfer, wachse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
2026-11-09 Kopfhörer direkt auf die Pi-Klinke (dmix hängt dort), Neuversuch bei belegter Klinke
    Claude-Session: https://claude.ai/code/session_01VRacZnv7DFGvrbCevyww9x
2026-11-09 Klang: Equalizer (alsaequal, 10 Bänder) mit Vorlagen auf der Eltern-Seite
    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
2026-11-09 Einrichtung: Proben mit Stille-Datei statt /dev/zero (in Raspotifys Umgebung verboten)
    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
2026-11-09 Ansagen: Musik weich absenken und Ansage in den Musikstrom mischen (Lautsprecher und Kopfhörer); eigene Aufnahmen nicht ins Repository
    Claude-Session: https://claude.ai/code/session_01VRacZnNVSYoBgDWpu4AmEP
2026-11-09 Weiterspielen an der unterbrochenen Stelle (je Karte gemerkt), Play 2 s halten = von vorn
    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
2026-11-09 Keine Ansage 'Einen Moment' mehr, wenn die Musik schon zu hören ist
    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
2026-11-09 Leiser Klick beim Antippen von zurück, Play und vor (nicht Mond, nicht Ein-Taste)
    Jans Klickton (klaenge/klick.wav, Stille vorne entfernt, 44,1 kHz), Standard 15 %,
    einstellbar auf der Eltern-Seite. Lautsprecher über dmix ohne Absenken, Kopfhörer
    direkt bzw. von der Tonausgabe in die Musik gemischt. Tests: test_klick.py.
    Claude-Session: https://claude.ai/code/session_01VRacZmmEPtiEoFL6oytjKM
2026-11-09 Eltern-Seite: Was die Tasten können (Doppelbelegungen, Zeiten direkt aus der Bedienung)
    Claude-Session: https://claude.ai/code/session_01VRacZjfPbtbmVUBNqb1zmq
2026-11-10 Eltern-App neu: Karten bespielen, Cover automatisch, 40x40-Etiketten, Bereiche Alltag/Entwickler
    - Neue Oberflaeche (Handy und Browser, hell/dunkel, Logo), bisherige Funktionen in
    Alltag und Entwickler aufgeteilt
    - Karten bespielen per Link (Auftrag an den Player, Rueckfrage bei belegten Karten),
    Cover und Titel automatisch, Cover der aufliegenden Karte in der Kopfzeile
    - Etiketten 40x40 mm (300 dpi) als Einzeldownload, Bogen 2x3 und Testbogen
    - Neu: ndef, kartenschreiber, karten, cover, etikett, test_browser; 439 Tests gruen
    - Steckbrief: Nachtrag 10.11.2026 (17)
    Claude-Session: https://claude.ai/code/session_01VRacZjyxoQcBziFTa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
2026-11-10 Private Playlists: Titel von Hand, Bild aus Zwischenablage mit Ausschnitt-Dialog, Link mit Zugangsschluessel
    - cover: Link samt si/pt zusaetzlich bei oEmbed und Seite versuchen, verstaendliche Meldung bei privaten Playlists
    - Neu /api/cover/titel; Assistent: Titelfeld, Strg+V fuer Screenshots, Ausschnitt-Dialog (Quadrat verschieben)
    - Tests (444 gruen) und Steckbrief-Nachtrag 10.11.2026 (18)
    Claude-Session: https://claude.ai/code/session_01VRacZjyxoQcBziFTafQ7GU
2026-11-10 Ansage beim Einstecken des Netzteils: netzteil.wav (Deine Box wird geladen), Akku alle 2 s lesen, Wechsel Akku->Netzteil erkennen
    Claude-Session: https://claude.ai/code/session_01VRacZo4VzcJhqu1H8EpdET
2026-11-10 netzteil.wav ins Repository (gitignore-Ausnahme), sonst spielt der Pi nur den Ersatzton
    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
2026-11-11 Auto-Aus-Frist auf Dauer-Uhr: Zeitsprung nach Kaltstart löst kein Auto-Aus mehr aus
    Der Pi hat keine Echtzeituhr; beim Zeitabgleich nach dem Booten sprang die
    Wanduhr vor und die Auto-Aus-Frist war sofort abgelaufen. Frist läuft jetzt
    auf time.monotonic. Neuer Test, Steckbrief-Nachtrag.
    Claude-Session: https://claude.ai/code/session_01VRacZnngyVUyt5m5ntCfuX
2026-11-11 Kartenbox für 30 Karten: Modell, Prüfung, STL/STEP/GLB, Probedrucke, Steckbrief-Nachtrag
    Claude-Session: https://claude.ai/code/session_01VRacZn1a6a4H6GtiogQbU4
    [00_zusammenbau_NICHT_DRUCKEN.stl, 01_basis_orange.stl, 01f_modifier_basis_FUZZY.stl, 02_deckel_orange_kopfueber.stl, 02f_modifier_deckel_FUZZY.stl, 03_inlay_beige.stl, 04_stahlstift_3x90_ATTRAPPE_NICHT_DRUCKEN.stl, K1A_scharnier_basis_bohrung2.9.stl]
2026-11-12 Spotify 502 beim Start an der gemerkten Stelle: ab dem zweiten 5xx von vorn, Steckbrief-Nachtrag
    Claude-Session: https://claude.ai/code/session_01VRacZoHpBvZndt1n7tFwvw
2026-11-12 Spotify 5xx beim Start: erst Wiedergabe übertragen, dann abspielen; Tipp in der Meldung; Steckbrief-Befund
    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
2026-11-12 Ein-Taste: Dauer und SDA-Pegel protokollieren, wenn SCL lange tief war (Sparzustand ohne Druck); Steckbrief
    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
2026-11-12 Steckbrief: Muster Fehler nach der Nacht, Prüfplan
    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
2026-11-12 Audit Paket A: Musik zuverlässig (Befunde 1, 3, 4, 5, 6, 8, 9, 10, 11)
    Wächter für die laufende Wiedergabe, Schlummer-Timer und Auto-Aus am Tonfluss,
    Link der Karte erneut lesen, Lesefehler abfedern, Pause sicher zustellen
    (sonst Ton selbst stumm), kurze Wartezeit nach Netzausfall, Kontext nach
    Weiter prüfen, Fehlerantworten von Spotify unterscheiden.
    Neu: software/test_audit_a.py (33 Tests). 540 Tests grün.
    Nicht am Gerät geprüft; main bleibt unverändert.
    Claude-Session: https://claude.ai/code/session_01VRacZk2oTwcBqZmht6yiYM
2026-11-13 Kartenbox v2: organische Form, Karten mit Cover nach vorn (15° geneigt), bündiger Schnappverschluss, Scharniere mit gedruckten Stiften und Anschlag, Bandösen, Fuzzy-Modifier, Probedrucke K1-K3, Prüfu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
    Claude-Session: https://claude.ai/code/session_01VRacZmDxhurrv9wbDXcEhu
    [00_zusammenbau_NICHT_DRUCKEN.stl, 01_basis_orange.stl, 01f_modifier_basis_FUZZY.stl, 02_deckel_orange_kopfueber.stl, 02f_modifier_deckel_FUZZY.stl, 03_inlay_beige.stl, 04_stahlstift_3x90_ATTRAPPE_NICHT_DRUCKEN.stl, 04_stift_3x_beige.stl]
2026-11-13 Eltern-Seite: WLAN anlegen und entfernen (Name + Passwort), neue Seite WLAN
    Neue Seite im Bereich Alltag, API /api/wlan (+ /hinzufuegen, /entfernen) ueber die
    root-eigene Kopie von wlan_hinzufuegen.sh; Name und Passwort nur ueber die
    Standardeingabe, nie als Argument oder im Protokoll. Heim-WLAN und das aktive WLAN
    sind geschuetzt. Skript: --roh, als root ohne sudo. dienst_einrichten.sh installiert
    die Kopie und erweitert die sudo-Freigabe. Tests, Hilfe-FAQ, Steckbrief-Nachtrag.
    Claude-Session: https://claude.ai/code/session_01VRacZkEtjqHgYycbPc5Kk1
